zoumingjie124-ui/single-channel-acquisition/docs/STAGE8B_REPORT.md

# Stage 8B：诊断使能态 1 小时长跑记录（2026-11-04）

> 依据：`docs/STAGE8_PLAN.md` §4（HEAD `4d9179e`）
> 原始日志：`docs/SOAK_60MIN_20261104.txt`（本轮）、`docs/SOAK_60MIN_20261104_Y.txt`（Y 轮，见 §5.6），历史对照：`docs/SOAK_60MIN_20261103.txt`（2026-11-03 原件；**原文件名为 `SOAK_60MIN.txt`，2026-11-04 为腾出 `soak.py` 的固定输出名而改名**）
> 执行条件记录：`docs/STAGE8B_ENV.txt`

## 结论先行

**判据 H7 / H8 / H12 未通过，本轮按方案 §4.5 判定为 FAIL。**
设备侧计数器全为 0，丢失**只能从主机侧观测到**（设备无对应计数；归因见 §5，**未定论**）。
**不得记为"1 小时稳定通过"。**

## 1. 执行条件

| 项 | 值 |
|---|---|
| 端口 / 波特率 | COM5 / 115200 8N1（CH340） |
| 固件 | 正式版 `Code=22468`，`DIAG` 行含 `rep=`（7C-2 构建） |
| 诊断状态 | `SET_DIAG 1` → ACK OK → 3.03 s 后确认（`mask=0x01 value=10 mV`） |
| 输入 | PA1 电位器，静置 `raw ≈ 2 mV`，全程未触碰 |
| 电源 | 睡眠/休眠/USB 选择性暂停均已置 0（`STAGE8B_ENV.txt` §二） |
| 命令 | `python host/tools/soak.py 60 COM5`（参数为分钟） |
| 时长 | 11:24:12 → 12:24:12，实测 3600.0 s |
| 基线 | `uptime0=1071815 ms`、`conf0=1`、`state=2`、`mask=rep=1`、`span=8 mV` |

## 2. 原始结果（`SOAK_60MIN_20261104.txt` 合计段原文）

```
===== 合计（3600.0 秒）=====
收到字节      : 6278917  (1744.1 B/s)
SAMPLE 帧     : 360002  (100.00 Hz)
STAT 帧       : 3600  (1.00 Hz，设计 1.00 Hz)
EVENT 帧      : 0
drops         : 0
frame_err     : 0
adc_err       : 0
uart_err      : 0
rx_err        : 0
状态切换      : 0
设备运行时间  : 4679000 ms
seq8 缺口     : 45   (样本级)
整帧丢失      : 45   (帧级)
解析错误      : 30
BOOT 帧       : 0
链路中断次数  : 0
```

终点 `stat`（12:24:21.478，soak 退出后立即读取）：

```
STAT   t=4687953ms n=460642 drop=0 adc=0 uart=0 rxf=0 frm=0 chg=0 cmd=2/0 txd=0B
ERRSRC ore=0 fe=0 ne=0 pe=0 pto=0 rxrst=0/0
DIAG   en=1 state=2 conf=1 span=8 blk=30 unev=0 mask=1 rep=1
```

## 3. 判据判定（H1–H12）

| # | 判据 | 实测 | 门槛 | 判定 |
|---|---|---|---|---|
| H1 | SAMPLE 频率 | 100.0006 Hz | 100.00 ± 0.10 | PASS |
| H2 | STAT 频率 | 1.0000 Hz | 1.00 ± 0.05 | PASS |
| H3 | drops | 0 | = 0 | PASS |
| H4 | frame_err | 0 | = 0 | PASS |
| H5 | adc_err | 0 | = 0 | PASS |
| H6 | uart_err | 0 | = 0 | PASS |
| **H7** | **seq8 缺口** | **45** | **= 0** | **FAIL** |
| **H8** | **整帧丢失** | **45** | **= 0** | **FAIL** |
| H9 | BOOT 帧 | 0 | = 0 | PASS |
| H10 | 链路中断次数 | 0 | = 0 | PASS |
| H11 | 时基偏差（正式口径） | **0.0077 %** | < 0.1 % | PASS |
| **H12** | **解析错误** | **30** | **= 0** | **FAIL** |

**H11 计算（`STAGE8_PLAN` §4 / `SOAK_PLAN` 正式口径：uptime 对比墙钟）**

```
Δuptime = 4687953 − 1071815 = 3616138 ms
Δwall   = 12:24:21.478 − 11:24:05.619 = 3615859 ms
偏差    = |3616138 − 3615859| / 3615859 = 0.0077 %
```

交叉核对（用 soak 起点换算）：soak 在 11:24:12 启动，此时 uptime ≈ 1078210 ms；
最后一帧 STAT 记 `4679000 ms`，对应 3600 s 窗口 → 偏差 ≈ 790 ms = 0.022 %。
两种算法都远低于 0.1 %；读数分辨率为秒级，故 H11 的实际不确定度约 ±0.03 %，
**不影响结论**。**本轮 H11 采用 uptime 口径，不是帧率反推**（见静态审查 G1）。

## 4. 判据判定（B-1–B-5，终点诊断状态）

| # | 判据 | 基线 | 终点 | 判定 |
|---|---|---|---|---|
| B-1 | 终点 `en` | 1 | 1 | PASS |
| B-2 | `conf` 增量 | conf0=1 | 1 → 增量 **0** | PASS |
| B-3 | `mask` / `rep` | 1 / 1 | 1 / 1 | PASS |
| B-4 | `state` | 2 (ACTIVE) | 2 | PASS |
| B-5 | `span` | 8 mV | 8 mV（静置量级） | PASS |

> **B-3 的边界**：`mask=rep=1` 只证明"终点时设备状态与已提交状态一致"，
> **不能**推出"1 小时内每个诊断事件都被上位机收到"。本轮无 EVENT 帧、`conf` 未动，
> 说明期间**没有产生新的确认/恢复边沿**，这一点与 `span=8 mV` 一致。

## 5. 归因分析（H7/H8/H12）

### 5.1 设备侧证据：全部为零

| 计数器 | 值 | 含义 |
|---|---|---|
| `drops` | 0 | 采样环没溢出，一个采样点都没丢 |
| `adc_err` / `uart_err` / `rx_err` / `frame_err` | 0 / 0 / 0 / 0 | 设备端未记录任何错误 |
| `txd=` | **0 B** | **发送环从未满**，`app_tx_write` 一次都没丢字节 |
| `BOOT` | 0 | 中途没有复位 |
| 链路中断 | 0 | 串口没有断开重连 |

`txd=0` 只能证明**入队没丢**：`app_tx_write()` 没有因为环满而丢弃过任何一帧。
它**不能**证明"线上传输正确"——字节是否正确发出、是否完整到达主机，这一层固件没有任何计数可查。

### 5.2 观测事实：缺口与解析错误成对出现

- `seq8 缺口 = 45` 与 `整帧丢失 = 45` **必然相等**：两者是同一批丢失帧的两种算法
  （样本级 / 帧级），不是两条独立证据。它们的相等只能说明**丢失的全部是 SAMPLE 帧，
  没有 STAT 帧丢失**，不能反推"丢的是整帧而非帧内错位"。
- `解析错误 = 30`：解析器遇到过**无法完成的帧**并重新同步。日志只能说明
  "**字节流被破坏**"，**无法区分**是丢了字节、还是字节被改坏，
  **也无法定位**发生在设备引脚、USB 链路还是主机驱动。
- 时间分布：59 个打点中 **28 个**带缺口，且**全部落在 240–2460 s** 这一段内
  （窗口内 38 个打点里 28 个有缺口；窗口外 21 个打点全为 0）。窗口内每次增量只有
  **1 / 2 / 3 帧**，没有出现更大的成块丢失。28 个"缺口有增量"的打点与 28 个
  "解析错有增量"的打点在时刻上重合——**这与"该处发生了字节级破坏"一致**，
  但**破坏发生在哪一段、以何种方式发生仍未确定**（设备引脚 / USB 链路 / 主机驱动都不能排除）。详见 §5.3。

### 5.3 缺口的时间分布（复盘后新增，修正了初版归因）

统计每个 60 s 打点窗口内的增量（原始表见 `SOAK_60MIN_20261104.txt`）：

打点是**累计值**：`[ 240s]` 那一行报的是 `(180, 240]` 这一分钟内的增量，
`[2460s]` 那一行报的是 `(2400, 2460]`。因此"有增量的打点"只能把事件定位到**一分钟区间**，
不能定位到某一秒。

| 区间 | 打点 | 现象 |
|---|---|---|
| 0 – 180 s（11:24:12–11:27:12） | 60 / 120 / 180，共 3 个 | **完全干净**（0 缺口 / 0 解析错） |
| **起点在 11:27:12–11:28:12 之间，终点在 12:04:12–12:05:12 之间**<br>（对应打点 240 … 2460，覆盖 180–2460 s） | 共 38 个 | 其中 **28 个有缺口**；每次 1–3 帧；累计 45 帧 / 30 次解析错 |
| 2460 s 之后（12:05:12–12:24:12） | **2520 … 3540，共 18 个**；3540–3600 s **无打点**，只有合计段 | **重新完全干净**（0 缺口 / 0 解析错） |

也就是说：不是"全程均匀丢一点"，而是**一段有界窗口**——首个有增量的打点是 240 s
（事件落在 180–240 s 之间），末个是 2460 s（事件落在 2400–2460 s 之间），
故窗口长度在 **36–38 分钟**之间；打点粒度 60 s，**无法再精确**。两端都是干净的。

末段"无打点"这一点有独立佐证：**3540 s 那条打点的累计值（45 / 45 / 30）与合计段完全相同**，
说明 `(3540, 3600]` 这最后一分钟没有新增缺口或解析错误——不是"没记"，是"确实没发生"。

### 5.4 归因（初版结论已作废）

**初版写的"测试期间本机并发执行大量文件读取导致"不成立。**

依据（会话记录，非系统级）：本次静态审查的**第一次文件读取发生在 12:10:08**；
在此之前，本会话最近一次工具调用是 **11:24:26**（即开跑后 14 秒内的日志核验与记录写入）。
也就是说 **11:24:26 → 12:10:08 之间有 45 分 42 秒本会话零调用**，
而丢失窗口（11:27:12–12:05:12）完整落在这段静默期内。

**这条证据的边界**：它只能证明**本会话**在那段时间没有发起读写，
**不能**代表整台机器空闲——系统更新、杀毒扫描、其它程序、以及人工操作都不在记录范围内。
因此准确表述是：**"本会话在丢失窗口内没有活动"，而不是"主机在丢失窗口内空闲"**。

排查过的系统侧证据（均不支持"主机 CPU 被抢占"）：

| 检查 | 结果 |
|---|---|
| System 日志（11:20–12:30）的 USB / 串口 / PnP / 磁盘错误与警告 | **无任何记录** |
| Defender 扫描 | 上一次快速扫描是 11-03 19:25，**不在窗口内** |
| 任务计划日志 | 未启用，读不到 |

剩下的候选：

| 候选 | 支持 | 反对 |
|---|---|---|
| A. 主机 USB 接收缓冲偶发溢出（进程被短暂挂起 / 端口被 hub 节电） | 缺口与解析错误成对出现；设备侧 `txd=0`、`drops=0` | 未找到对应的系统事件；且"开始/结束"都太干脆 |
| B. 设备侧待发缓冲被覆盖 / 越界（非"供数不及"） | 若 `s_stage` 或环内内容被错误改写，主机侧会收到破坏的字节流 | **`uart_err=0` 只覆盖 RX，排除不了发送侧**；但固件没有 TX 侧完整性计数。<br>**注意：串口"发送慢"只会拉长字节间隔，不会改坏字节**，所以"供数不及导致移位错误"这个机制不成立，已从候选中删除。<br>另外，缓冲被覆盖通常与负载/时序相关，与"有界窗口"**不太像，但不能排除**——若冲突是否发生取决于时钟相位对齐，理论上也可能出现有界窗口（**推演，未验证**） |
| C. 物理层（USB 线 / hub / 接触） | 窗口有界，符合"某个外部扰动持续一段时间后消失"；本机 CH340 的端口路径为 `LOCATION=1-2.1.3`，**说明接在 hub 之后**（经一级以上的 hub 级联），hub 供电/线材/接触都可能引入这类有界扰动 | 无直接证据；System 日志没有对应的 USB 告警 |

**结论：只能确定丢在"设备发送环之后、上位机解析器之前"，具体归属未定论。**
本轮**不记为通过**，也不把任何候选写成既成事实。

### 5.5 11-03 通过 vs 11-04 未通过：差异清单

两次都是 3600 s，且**同一块开发板（据记录）**；但 **USB-TTL 是否同一根线、是否插在同一个物理口，
未记录**——11-03 那次连端口路径都没采集。下表只写**能从现有记录确认**的事实，
查不到的一律写"未记录"，**不做推断**。

| 项目 | 11-03（通过） | 11-04（未通过） |
|---|---|---|
| 固件构建 | `Code=21208`（`TEST_REPORT` §17）；**尚无 `app_diag` / `app_fault`**（`app_diag.c` 于 11-03 18:33 的 `6112267` 才引入） | `Code=22468`，含 Stage 7B/7C/7C-2 |
| 提交 / 工作区 | 起点 `c4029e7`（11-03 09:42）；运行中 12:41 提交 `2abe5d6`，只动 `docs/` 与 `host/tools/`，**固件未变** | 起点 `4d9179e`；全程无提交，工作区仅两份文档后续被修改 |
| DIAG 是否使能 | **不可能使能**（功能不存在）；全程无诊断 | `SET_DIAG 1` → `en=1`、`conf0=1`、`state=2`、`mask=rep=1` |
| 电源设置 | 睡眠 / 休眠 = 从不、USB 选择性暂停 = 禁用（按 §9.1 设置，`TEST_REPORT` §17.3） | 同左（按 §9.1 设置，原值与现值记在 `STAGE8B_ENV.txt`，收尾已按 §9.2 还原） |
| USB 路径（LOCATION）与端口 | 端口 **COM6**；`LOCATION` **未记录**（当时没有采集此信息） | 端口 **COM5**；`LOCATION=1-2.1.3`（**经 hub 级联**） |
| 主机并发活动 | **有**：运行到第 35 分钟（12:41）产生提交 `2abe5d6`，新增 3 个文件共 512 行（`CALIB_ABSOLUTE.md` / `soak_finish.py` / `SOAK_60MIN.txt`，末者为当时的文件名）。其中 `SOAK_60MIN.txt` 是**当时正在写的日志**，提交里只有到 **2100 s** 的 36 行快照；完整版由 13:07 的 `537ce93` 提交。未做系统级记录 | **未逐条记录**：期间有静态审查的连续文件读取（时刻未记录）；无编译、无烧录、无第二个串口程序 |
| 起止时间（墙钟） | 2026-11-03 12:06:12 – 13:06:12（日志头写 `12:06:13`，与报告差 1 s） | 2026-11-04 11:24:12 – 12:24:12 |

两点必须说清：

1. **11-03 也不是"主机完全空闲"**。它有写盘和一次 git 提交，却零缺口；
   所以"有主机活动就必然丢帧"这个简化说法不成立——两次的**活动形态与量级不同**，
   但没有量化记录，无法比较。
2. **两次的固件构建不同**（Code 差 1260 B：22468 − 21208，多了诊断与故障上报模块），因此
   不能把差异直接归给"链路/主机"，也**不能**排除固件侧新增代码的影响
   （虽然 `txd=0` 说明发送环没满，但发送侧完整性仍无计数）。

> **本节的结论已被 §5.6 修正方向**：补做 Y 轮（诊断关）后，同样出现丢帧。
> 因此"诊断是否开启"不再是可用的解释变量；但**新旧固件整体差异仍未分开**，
> 详见 §5.6 的限定条件。

### 5.6 Y 轮（诊断关）对照结果 —— 2026-11-04 16:14:12–17:14:12

原始日志 `docs/SOAK_60MIN_20261104_Y.txt`；执行条件与基线原文见 `docs/STAGE8B_ENV.txt` §九。

| 项 | 值 |
|---|---|
| 固件 | `Code=22468`（与 §1 同一次构建，未重烧） |
| 端口 / LOCATION | **COM4 / `LOCATION=1-2.2`** —— 与 11-04 那轮的 `1-2.1.3` **不是同一个口**；但**仍未换直连口**（本机可用路径都经过同一颗 `05E3:0610` hub，见 `STAGE8B_ENV.txt` §八） |
| 诊断 | `en=0`（全程关闭），终点 `state=0 / conf=0 / mask=0 / rep=0` |
| 电源 | 睡眠 / 休眠 / USB 选择性暂停全部 0（按 §9.1 设置，查询核验） |
| `uptime0` → `uptime_end` | 343686 ms → 3954833 ms |

| 判据 | 实测 | 判定 |
|---|---|---|
| H1 SAMPLE 频率 | 360033 帧 / 3600.0 s = **100.0092 Hz** | PASS |
| H2 STAT 频率 | 3600 = 1.0000 Hz | PASS |
| H3–H6 drops / frame_err / adc_err / uart_err | 0 / 0 / 0 / 0 | PASS |
| **H7 seq8 缺口** | **17** | **FAIL** |
| **H8 整帧丢失** | **18** | **FAIL** |
| H9 BOOT / H10 链路中断 | 0 / 0 | PASS |
| H11 时基 | Δuptime 3611147 ms vs Δwall 3610633 ms = **0.0142%** | PASS |
| **H12 解析错误** | **11** | **FAIL** |
| 诊断终点 | `en=0 / mask=0 / conf=0 / rep=0` | PASS |

丢失只出现在 **10 个打点**上，且全部落在两段一分钟区间之间：
起点在 **(480, 540] 秒**这一分钟内（480 s 那条累计仍为 0，540 s 才 +2），
终点在 **(1620, 1680] 秒**这一分钟内；此后到 3540 s 完全干净。
每次丢 **1–3 个样本**；解析错误的增量**多数为 1，`600 s` 那一条为 2**（10 个打点里 9 个为 1、1 个为 2）。
形态与 11-04 那轮一致（有界窗口 + 整帧粒度）。

**这轮能得出的结论：**

> 诊断开启**不是**丢帧的必要条件——`en=0` 时同样丢帧。

**不能得出的结论（限定条件）：**

1. `en=0` 只关闭了检测与上报，**诊断代码仍在固件里**（`app_diag` / `app_fault` 都还在 Flash 与主循环路径上），所以这不是"诊断代码无关"的证明；
2. 本轮固件是 `Code=22468`，11-03 那次通过的是 `Code=21208`，**两者是整体不同的构建**；
   "当前固件比旧固件多出的所有代码"与"链路/主机"这两个因素**没有被分开**；
3. 两轮的 LOCATION **不同**（11-04 那轮 `1-2.1.3`，Y 轮 `1-2.2`），但**都经过 hub**；
   第一轮的 hub 层数**没有单独核对**，所以"两轮链路完全相同"这句话不成立；
4. 因此**不能**把它写成"固件诊断/故障上报已被排除"。

**可安全表述的范围**：`SET_DIAG 1` 与 `SET_DIAG 0` 两种配置下都观察到同形态的有界丢帧，
所以"是否使能诊断"不能作为解释变量；丢帧与诊断功能之间**没有观察到必然联系**，
但也没有被证明无关。

### 5.7 后续复测（Y2 / X2）—— 独立测试，不覆盖 §1–§5 的失败记录

§1–§5 记录的是 **2026-11-04 11:24 那一轮（诊断开，FAIL）**，该记录**原样保留**：
丢帧原因至今**未定论**（主机缓冲 / 链路 / 物理层三者并列，见 §5.4）。

在其后补做了两轮**独立测试**，用于回答"换一条已知良好的连接后，同固件是否还能丢帧"：

| 轮次 | 时间 | 诊断 | 端口 / LOCATION | 结果 | 原始日志 |
|---|---|---|---|---|---|
| Y（§5.6） | 16:14–17:14 | 关 `en=0` | COM4 / `1-2.2` | **FAIL**：缺口 17 / 整帧 18 / 解析 11 | `SOAK_60MIN_20261104_Y.txt` |
| **Y2** | 18:14–19:14 | 关 `en=0` | COM5 / `1-2.1.3` | **PASS**：H1–H12 全部 PASS，所有错误与丢失类计数均为 0 | `SOAK_60MIN_20261104_Y2.txt` |
| **X2** | 19:23–20:23 | 开 `en=1` | COM5 / `1-2.1.3` | **PASS**：H1–H12 全部 PASS，所有错误与丢失类计数均为 0；`conf` 1→1 | `SOAK_60MIN_20261104_X2.txt` |

必须同时说明三点：

1. **它们不能推翻 §1–§5**：11:24 那轮确实丢了 45 帧，失败事实与"原因未定论"都保留。
2. **Y2/X2 的通过只覆盖 1 小时尺度**，不等于 8 小时，也不等于"链路问题已解决"；
   二者与 Y 的差别包含端口、线材与串口模块的更换史，**没有被单独隔离**，
   因此不能据此断言"是换线治好了"。
3. Y2/X2 的判据来源不同：H1–H10、H12 来自 SOAK 合计段与打点；
   **H11 来自两次独立 STAT 的 uptime 与墙钟**（Y2：0.0142%；X2：0.0142%，区间 3692 s）。
4. **端口不是区分因素**：11:24 失败轮与 Y2、X2、8 小时通过轮**同在 `COM5` / `LOCATION=1-2.1.3`**
   （`STAGE8B_ENV.txt` §一 / §十四 / §十五、`docs/SOAK_480MIN_RECORD.md` §0）。
   同一条端口路径既出现过 FAIL 也出现过 PASS，因此 **LOCATION 不能解释两组的差异**。
   （Y 轮失败发生在 `1-2.2`，是另一条路径，不能用来反证"换口就好"。）
   失败轮与通过轮之间真正的差别——**串口模块更换史、线材、接线纠正**——**逐项未记录**，
   本条仍按"**未隔离**"处理：既不能断言"换线治好了"，也不能断言"某个模块有问题"。

---

## 6. 未覆盖与不能声称的事项

1. 本轮**未通过**，不能用于证明"诊断使能态 1 小时稳定"。
2. 未做 8 小时（方案要求 1 小时通过后才做）——**此条只约束本节记录的 11:24 轮**；
   诊断关的 8 小时长跑见 **§8**（2026-11-04 23:28 – 11-05 07:28 完成）；诊断开的 8 小时长跑见 **§9**（2026-11-05 23:10 – 11-06 07:10 完成）。**8 h 的两种配置均已做过，本条不再成立。**
3. 不涉及真实传感器（R19）、TX 环满载（R15/8A）、真实 HAL 重挂失败（R1）、多故障快照（R17）。
4. 归因未定论；要分离 A/B 需要额外手段（第二观察者、设备侧 TX 帧计数、示波器看 TX 线），**本轮均未做**。
5. `STUCK_DELTA_MV=50 mV` 仍是待确定值。

## 7. 复现所需

```bat
:: 1) 关闭睡眠（SOAK_PLAN §9.1），确认 powercfg 读数为 0
:: 2) 使能诊断，等确认，记录 conf0 / uptime0
python host/tools/soak.py 60 <端口>
:: 3) 结束后立即 stat，记录 uptime_end / DIAG
```

**建议复跑时不要在主机上并发执行其它重任务**，以排除候选 A。

---

## 8. Stage 8B-2：诊断关闭（en=0）480 min 长跑（2026-11-04 23:28 – 11-05 07:28）

**结论：Stage 8B-2 诊断关闭（en=0）480 min 板级稳定性验证通过，H1–H12 全部 PASS。**

### 8.1 条件

| 项 | 值 |
|---|---|
| 固件 | `Code=22468`（2026-11-03 23:14 烧录 Verify OK，此后未重烧） |
| 诊断 | **en=0**，起点与终点一致 |
| 链路 | COM5 / CH340 / VID:PID=1A86:7523 / **LOCATION=1-2.1.3** |
| 时长 | 480 min（实测 28800.0 s） |
| 起点基线 | `reset` 清零后 `frm=0 fe=0 uart=0 cmd=0/0`，`uptime0=166805 ms @ 23:26:07.236`，`conf0=0` |

### 8.2 结果

```
收到字节 50229097 (1744.1 B/s)   SAMPLE 2880109 (100.00 Hz)   STAT 28801 (1.00 Hz)
EVENT 0   drops 0  frame_err 0  adc_err 0  uart_err 0  rx_err 0  状态切换 0
seq8 缺口 0   整帧丢失 0   解析错误 0   BOOT 0   链路中断 0   设备运行时间 29101000 ms
```

| 编号 | 实测 | 判定 |
|---|---|---|
| H1 | 100.0038 Hz（2880109 / 标称 28800.0 s） | PASS |
| H2 | 1.0000 Hz | PASS |
| H3–H10、H12 | 全 0 | PASS |
| H11 | 0.0039 %（< 0.1 %） | PASS |

- **打点 479 条**（60 s – 28740 s）。479 而非 480 是 `soak.py` 的循环逻辑所致（`elapsed >= total`
  时先退出、不写第 480 点），**符合脚本实际行为，不是数据缺失**。
- **无 BOOT、无链路中断、无可分辨序号缺口、无统计错误**。
- **H1 的口径与"真实物理时长"**：H1 仍按 `SAMPLE / 标称 28800.0 s = 100.0038 Hz` 判定（PASS）。
  但 `soak.py` 的 `dur` 取自墙钟（§8.3.2），被 **+2.95 s** 的时钟前跳拉长；
  按**真实物理时长 28,797.05 s**（= 28800.0 − 2.95）折算为 `2880109 / 28797.05 = ` **100.0140 Hz**，
  与 §8.3 的 **140 ppm** 斜率一致（`100 × 1.00014 = 100.0140`）。
  即 **100.0038 Hz 是被 +2.95 s 前跳压低的表观值**；跨轮次比较 H1 时同样要注意，
  1 小时轮（≈100.014）更接近该构建的真实采样速率。
- **H11 口径**：`Δuptime = 28963363 ms`、`Δwall = 28962243 ms`、差 `+1120 ms`、偏差 `0.0039 %`。
  终点 `uptime` 取自 1 Hz STAT，存在约 **±1 s 量化误差**（≈±0.0035%）。
  **对 `0.0039 %` 的分解（原"原因未查（主机校时、温度）"已撤回）**：对累计 SAMPLE 做分段偏移拟合，
  **7260 s 台阶前后斜率均约 140 ppm**，台阶约 **−295 个样本（≈2.95 s）**；
  `140.5 ppm（拟合值）× 28962 s ≈ 4.07 s`，减去台阶 ≈ **1.12 s**，与实测 `+1120 ms` 吻合。
  取整说明：按 **140 ppm** 取整算得 `4.05 s`（差 0.02 s），差别**仅来自 ppm 取整**，
  与"×28962 s"还是"×8.045 h"无关（两者相差 0.24 s，折算 <0.001 s）；本节统一取 **4.07 s**（与 1.12 s 直接对应）。
  即 **H11 的 0.0039 % 是"140 ppm 真实速率差"与"一次 −2.95 s 台阶"的叠加**；
  **1 小时 Y / Y2 / X2 三轮的 0.0142 % 才是 140 ppm 的直接体现**。
  因此 **H11 不得跨轮次比较**：本轮的 0.0039 % 比 1 小时轮"更好看"，但那是台阶抵消的结果，不是时基更准。
- **序号检测边界**：在当前 8 位序号检测能力范围内，未检出可分辨的序号缺口（`frame_gap` 与 `seq8_gap` 均受同一限制）。
  单次连续丢失恰为 **256 的整数倍**帧时不可见；"未检出"≠"绝对零丢失"。打点 ΔSAMPLE 的实测分布见 **§8.3**。
- **对账已闭合（按 reset 后基线折算）**：
  基线 `n_base = 388`（2026-11-04 23:26:07.236，reset 后首次 STAT）、
  终点 `n_end = 2896724`（2026-11-05 07:28:49.479），`n_end − n_base = 2896336`；
  soak 期间 `SAMPLE = 2880109`，两端空档 133.764 s + 28.479 s = 162.243 s ≈ **16224** 个样本，
  `2880109 + 16224 = 2896333`；**残差 +3 个样本（≈30 ms）**，落在起跑时刻的**秒级分辨率**
  （日志头只到秒，±1 s ≈ ±100 个样本）之内，判定为对账成立。
  说明：早前一版用"约 162 s × 100 Hz"粗算得残差 391（≈3.9 s），是因为**漏减了 reset 后的基线 `n_base`**；计入基线后残差降为 3 个样本。
  另：日志「设备运行时间 **29101000 ms**」− 墙钟 **28800000 ms** = **301000 ms（301 s）**，
  这是**开机到起跑的先行运行时间**（boot ≈ 23:23:20 → 起跑 23:28:21），**不是漂移**，也不参与上面的样本对账。

### 8.3 打点 ΔSAMPLE 分布与一次计数台阶

479 条打点 → **478 个区间**：

| 区间 ΔSAMPLE | 次数 | 说明 |
|---|---|---|
| 6000 | 89 | 标称 |
| 6001 | 373 | 打点与帧流边界错位 |
| 6002 | 15 | 同上 |
| **5705** | **1** | 仅 7200 s → 7260 s 这一段 |

- 最小值 **5705**、最大值 **6002**、均值 **6000.23**；**477/478 落在 6000–6002**。
- 唯一偏低区间 `[7260s]`：**ΔSAMPLE = 5705**（比 6000 少 **295**、比 6001 少 **296**）、**ΔSTAT = 57**（少 3）；
  该分钟的 `drops / frame_err / seq8 缺口 / 整帧丢失 / 解析错` **全部为 0**。
- **不能写成链路丢帧**：若真丢 296 帧，8 位序号缺口应为 `296 mod 256 = ` **40**，实测为 **0**；
  整帧丢失同样为 0。因此这是一次**计数台阶**，不是通信丢帧。
- 分段偏移拟合：前段 **100.014031 样本/s（140.3 ppm）**、后段 **100.014084 样本/s（140.8 ppm）**，
  两段斜率一致；把两条直线外推到 7260 s 处，相差 **−295.5 个样本 ≈ −2.95 s**。
- **结论：观察到一次计数台阶（≈ −2.95 s），判定为「主机侧时钟前跳（NTP 校时）」**，依据四项：
  ① **事件日志**：`2026-11-05 01:28:27` 系统时间被 `svchost.exe (PID 30672)` 前跳 **+2950 ms**（§8.3.1）；
  ② **时间对齐**：该事件对应 elapsed ≈ **7206 s**，正落在 `7200 → 7260 s` 区间内；
  ③ **H11 推演**：若为"设备停顿而 uptime 照走"，残差应约 4.07 s，实测仅 1.12 s（推演，未验证）；
  ④ **计时基准**：`soak.py` 全部用**墙钟** `time.time()`（L65 起点、L76 打点判定、L164 合计时长，见 §8.3.2）——
  墙钟前跳 2.95 s 会让该分钟打点**提前约 2.95 s 触发**（故 ΔSTAT=57、ΔSAMPLE=5705），
  同时把合计段的 `dur` 拉长 2.95 s。
  **这不等于"已证实"**：因日志未保存逐帧 STAT 的 `t_ms` 原文，无法直接从帧流核对该分钟的设备侧时长，
  故维持四项证据的合取推断。
  另：**「台阶前后 STAT 运行时间是否连续」无法检查**（原始帧未保存，见本节末），该项保持 **OPEN**。
- 区间内 `5705` 相对 `57 s × 100 Hz = 5700` 的 **+5**，属**打点边界量化**（一个 60 s 区间只含整帧边界，
  ±1 个帧位即可造成数个样本的偏差），**不用来解释漂移**。
- 总账：8 小时按 140 ppm 漂移应得 **+403** 个样本，减去台阶 **−295**，得 **+108**；
  实测累计 `2874109 − 2874000 = +109`，差 1 个样本，落在打点边界量化范围内。
- 可检验判据：若发生 **256 帧的整倍丢失**，某一分钟的 ΔSAMPLE 会比该分钟应有值低约 256 的整倍
  （标准 60 s 区间会呈现 ≈**5744**）。本轮唯一偏低区间是台阶而非丢帧（依据见上），
  **未见无法解释的 256 整数倍缺口**。
- **盲区仍然存在**：若恰好在某个完整 60 s 区间内丢失 256 帧，Δt 与 ΔSTAT 都不变、8 位序号也不留痕，
  **无法识别**。因此 §8.2 的"未检出"表述保持不放宽。

#### 8.3.1 事件日志核查（2026-11-05 01:20–01:40，Windows System 日志）

| 时间 | 来源 / ID | 内容（原文摘要） |
|---|---|---|
| 01:28:09 | Time-Service **37** | "时间提供程序 NtpClient 正在从 time.windows.com,0x9 接收有效时间" |
| 01:28:27 | Time-Service **35** | "时间服务正在使用时间源 time.windows.com" |
| 01:28:27 | Kernel-General **1** ×3 | 其中一条：系统时间由 `2026-11-04T17:28:24.386Z` 更改为 `17:28:27.337Z`，**增量 +2950 ms**，原因"An application or system component changed the time"，进程 `svchost.exe (PID 30672)`；另两条增量 **0 ms** |
| 01:28:27 | Kernel-General **24** ×3 | 已刷新时区信息，当前时区偏差 **−480** |

- **电源/休眠**：该时段**没有** `Kernel-Power 42/107`（睡眠/唤醒）事件；整夜 Kernel-Power 仅有若干条 566，
  时间点均不在 01:28 → **本轮未发生睡眠/唤醒**。
- **时间对齐**：soak 起跑 `23:28:21` ＋ 7206 s ≈ **01:28:27**，正好落在 `7200 → 7260 s` 那个打点区间内；
  事件记录的 **+2950 ms** 与拟合台阶 **≈2.95 s** 数值一致。
- **侧别判定**：结合本节事件日志、时间对齐、H11 推演与 §8.3.2 的墙钟计时基准，判为
  **主机侧时钟前跳（NTP 校时）**（见 §8.3 结论条目）。措辞上**不写"已证实"**：
  因日志未保存逐帧 STAT 的 `t_ms` 原文，无法直接从帧流核对该分钟的设备侧时长，
  故维持四项证据的合取推断。
- **推演（未验证）**：若为"设备停顿约 2.95 s、而设备 uptime 照走"，则台阶不进入 uptime，
  H11 应约为 `140.5 ppm × 8.045 h ≈ 4.07 s`（口径与取整说明见 §8.2）；实测仅 **1.12 s**，故该情形**基本被排除**。
  反之，主机时钟前跳 2.95 s 会把 `Δwall` 拉长 2.95 s，使残差从 4.07 s 降到约 1.12 s，与实测一致。
- **无法检查的部分**：原始二进制帧未保存，日志只有 60 s 打点与合计段，无法还原 STAT 的 `t=` 序列，
  因此"**台阶前后 STAT 运行时间是否连续**"**无法判定**（**OPEN**）——这一点不因侧别判定而改变。

#### 8.3.2 `soak.py` 的计时基准（代码核对）

`host/tools/soak.py` 共 195 行，SHA-256 `26771dd161ea34224a9133f3ca717bdbf2ff0ba8596fcb4c6e19aaa4af58c9ab`。
**全文计时只用墙钟 `time.time()`，没有 `time.monotonic()`，也没有 `time.perf_counter()`**：

| 行号 | 代码 | 作用 |
|---|---|---|
| **L65** | `t0 = time.time()` | 计时起点 |
| **L76** | `elapsed = time.time() - t0` | 判定 60 s 打点、判定是否到 480 min |
| L101 / L102 / L109 | `deadline = time.time() + 30.0` 等 | 重连等待与重连时刻记录 |
| **L164** | `dur = time.time() - t0` | 合计段 `duration`，也是 H1/H2 的分母 |

**机理**：墙钟被前跳 2.95 s 时，`elapsed` 立刻多出 2.95 s → 下一次 `elapsed >= next_mark`
**提前 2.95 s 成立**，于是该分钟在设备时间上只走了约 57 s（ΔSTAT=57、ΔSAMPLE=5705）；
终点 `dur` 同样多算 2.95 s，这正是 H11 残差被抵消 2.95 s 的来源。

### 8.4 证据等级与边界

- **板级实测、统计级证据**；不是字节级全量验证（原始二进制帧流未落盘，无法逐帧复算）。
- 覆盖：1 条链路、1 台主机、1 个构建、**诊断关闭**、8 小时尺度。
- **Stage 8B-3（诊断开启 en=1 的 8 h）已完成并通过，见 §9**；**R2 绝对精度仍未测**；
  **不得写成"项目全部 8 小时稳定性验证通过"**。
- **已知限制（计时基准）**：`soak.py` 用**墙钟**计时（§8.3.2），长跑中一旦遇到 NTP 校时，
  就会在打点里留下**计数台阶**。本轮实际观察到一次（**+2950 ms**，§8.3.1），已按"台阶"处理，
  **未改脚本**。建议：长跑前**关闭 Windows 自动校时**，或跑完后用
  `Get-WinEvent` 对照 `Time-Service` / `Kernel-General` 事件日志再解读打点。
- 归档：`docs/SOAK_480MIN_20261104_N.txt`，77,875 B，
  SHA-256 `6e64b28120f59d46957eb286d737d70d0114cea6c0012898a3c9687ddb3de989`；
  记录表 `docs/SOAK_480MIN_RECORD.md`；起点与 reset 前后计数见 `docs/STAGE8B2_START.txt`。

## 9. Stage 8B-3：诊断开启（en=1）480 min 长跑（2026-11-05 23:10:56 – 11-06 07:10:56）

> 目的：补上 R3 / R20 里"诊断开启态 8 小时"的缺口。**结果：H1–H12 全 PASS。**
> 详表：`docs/SOAK_480MIN_RECORD_8B3.md`；原始日志 `docs/SOAK_480MIN_20261105_X.txt`。

### 9.1 条件

| 项 | 值 |
|---|---|
| 固件 | `Code=22468`（与 8B-2 / Y2 / X2 同一构建，未重烧） |
| 诊断 | **`en=1`**；23:08:38 `diag on` 恢复，23:10:36 `reset` 未改变 `en` |
| 链路 | COM5 / `1-2.1.3`（与 8B-2 同一条物理路径；两轮之间还有不同夜晚、一次 USB 重插、本轮起跑前的 `reset`，**主要差异是诊断开关，但不是严格的单变量对照**） |
| 主机 | `Type=NoSync`、`w32time` Stopped/Disabled、睡眠/休眠 0/0、AC 供电 |
| 输入 | 电位器静置未动（`mask=1 rep=1`，卡死态，`span` 8–11 mV） |
| T0 | 2026-11-05 23:10:46.618，`t=200795 ms`，`n=1000`，错误计数全 0，`conf=0` |
| 起跑 / 结束 | 23:10:56 / 07:10:56，`soak.py` exit 0，479 条打点 |

**起跑前板子重启过（T0 之前，不计入本轮）**：USB 物理插拔上电（设备节点 `LastArrivalDate=23:07:34`，
两次 uptime 反推 boot 均 23:07:25.8），导致 `en` 复位为 0、上电瞬间 `uart=2/fe=2/cmd err=16`；
已 `diag on` 恢复；按 `STAGE8B3_START.txt` **§9.1（重启来源与排除项）**判定该重启与本轮无关后，`reset` 重跑。

> 注：本节引用的是 `STAGE8B3_START.txt` §9.1，**不是**本文件 §8.3（§8.3 讲的是 NTP 台阶，与此无关）。

### 9.2 结果

```
===== 合计（28800.0 秒）=====
收到字节 50234327 (1744.2 B/s) | SAMPLE 2880407 (100.01 Hz) | STAT 28804 (1.00 Hz)
drops 0 | frame_err 0 | adc_err 0 | uart_err 0 | rx_err 0 | 状态切换 0
seq8 缺口 0 | 整帧丢失 0 | 解析错误 0 | BOOT 0 | 链路中断 0
设备运行时间 29014000 ms
```

| 编号 | 实测 | 判定 |
|---|---|---|
| H1 | 2,880,407 / 28,800.0 = **100.0141 Hz** | PASS |
| H2 | 28,804 / 28,800 = **1.00014 Hz** | PASS |
| H3–H6 | drops / frame_err / adc_err / uart_err **差值全 0**（基线也全 0） | PASS |
| H7 / H8 | seq8 缺口 0 / 整帧丢失 0（8 位可分辨范围内） | PASS（限"未检出"） |
| H9 / H10 | BOOT 0 / 链路中断 0 | PASS |
| H11 | **0.0141 %**（Δuptime 28,833,632 ms，Δwall 28,829,555 ms，差 +4077 ms） | PASS |
| H12 | 解析错误 0 | PASS |

统一措辞：**在当前 8 位序号检测能力范围内，未检出可分辨的序号缺口（`frame_gap` 与 `seq8_gap` 均受同一限制）**；
单次恰为 256 整数倍的缺口不可见，"未检出"≠"绝对零丢失"。

### 9.3 H11 与 8B-2 的差异（本轮最重要的解释）

- 8B-2（`en=0`）报 **0.0039 %**，本轮（`en=1`）报 **0.0141 %**，相差约 100 ppm。
- 原因不是设备变差：8B-2 窗口内有一次主机 **NTP +2950 ms** 前跳，把 `Δwall` 拉长 2.95 s，
  `4.07 s − 2.95 s ≈ 1.12 s`；本轮 `NoSync` 且事件日志无阶跃，测到的 **141 ppm 才是真实量级**，
  与 8B-2 分段拟合的 140 ppm 完全吻合。
- 结论：**H11 只能逐轮对照"是否 < 0.1 %"，不得跨轮次比较绝对值**；8B-2 的 0.0039 % 是表观值。

### 9.4 打点与事件核查

- 478 个区间：ΔSAMPLE = 6000×88 / 6001×374 / 6002×16（**max 偏差 2，无台阶**）；
  ΔSTAT = 60×474 / 61×4。
- **更正（2026-11-06）**：上一句原把「累计 +407」错标成 ΔSTAT。正确拆法——
  **ΔSAMPLE 合计 2,868,406**，比 478×6000 多 **+406**（=374×1+16×2）；
  **ΔSTAT 合计 28,684**，比 478×60 多 **+4**（≈4 s，来自 4 个 61 的区间）。
  末值 2,874,407 相对标称 2,874,000 的 **+407** = 406 + 首个 60 s 区间多出的 1 帧，与 141 ppm 一致。
- `Time-Service`(35/37)、`Kernel-General`(1)：**窗口内零命中**；`Kernel-Power` 42/107 零命中
  （仅 566 会话切换 ×3）→ 无时钟阶跃、无睡眠唤醒，**"无台阶"不是被时钟掩盖的结果**。

### 9.5 `conf` 的口径（容易误读，必须写清）

`reset`（23:10:36）把 `conf` 清零，而当时模块**已经处于 ACTIVE**；此后 8 小时输入一直卡死，
没有发生 CLEAR→CONFIRM，所以 `conf` 全程为 **0**（增量 0）。

**要特别记一笔：起跑时（§9.1 / 当天晚间的记录）按"`conf` 会 0→1"预期写过，那句预期是错的。**

**源码依据（已逐行核对，不是推断）**：

| 事实 | 出处 |
|---|---|
| `conf` = `confirm_cnt`，语义"进入 ACTIVE 的次数" | `App/Inc/app_diag.h:53`（字段注释） |
| `confirm_cnt` **只**在 `CLEAR / CONFIRMING` 分支、且 `stuck_blocks` 达到阈值时 `++` | `App/Src/app_diag.c:114–122`，自增语句在 **L120** |
| 已处于 `ACTIVE` 时再来偏死块，**只做"取消恢复"、不重新确认**（故不累加） | `App/Src/app_diag.c:129–134`，注释原文"已确认过的状态：偏死块只是'取消恢复'，不需要再确认" |

所以本轮 `reset` 把 `conf` 清零时模块已是 ACTIVE，之后 8 h 输入一直卡死、从未回到 CLEAR，
**`conf` 必然全程 0**——这与"没有误报"是同一件事，不是漏计。X2 是 `conf 1→1`（增量 0）。
**两者结论相同（无异常增量），但绝对值不可混用**——引用 R20 时必须注明本轮 `conf=0` 的成因。

**`blk` 的含义（已查源码，非未解读）**：`blk` 取的是 `app_diag_block_samples()`，
即**当前尚未结算的 1 s 统计块里已计入的样本数**（100 Hz ⇒ 取值 0–100），块结算后清零。

| 事实 | 出处 |
|---|---|
| DIAG 文本行 `blk=%u` 实参为 `app_diag_block_samples(&s_ctx.diag)` | `App/Src/app_task.c:338`（格式串）、**L343**（实参） |
| `blk_samples` = "本块已计入的样本数（用于判断块是否可评估）" | `App/Inc/app_diag.h:44` |
| 块结算后 `blk_samples = 0`，等下一个样本开新块 | `App/Src/app_diag.c:88` |

因此 T0 `blk=73`、终点 `blk=88`、二次读取 `blk=49` **非单调是设计使然**（每 1 s 归零重计），
**与设备健康状况无关，不能当判据**；它只说明"取样时刻落在一个块的什么位置"。

### 9.6 边界

- 板级实测、**统计级**证据；不是字节级全量验证（原始帧流未落盘）。
- 只覆盖 `en=1` + 单一静置输入 + 单一链路/主机/构建；`en=0` 见 §8，两者互不替代。
- **R2 绝对精度**：8B-3 期间未涉及；该项已于 2026-11-07 实测、记 **部分关闭**（见 `CALIB_ABSOLUTE.md` §6）；R19（真实传感器失效）仍为 NOT TESTED。
- **环境还原项：自动校时已恢复，并已完成一次成功对时**。
  - **历史**（2026-11-06 08:58 回读）：`Parameters\Type = NoSync`、`w32time = Stopped / **Disabled**`。
  - **现状**（2026-11-07 21:26 回读，用户在"设置 → 时间和语言 → 日期和时间 → 自动设置时间"打开开关之后）：
    - `Parameters\Type = **NTP**`（已由 `NoSync` 变为 `NTP`）；`w32time = **Running / Manual**`；
    - **已成功对时一次**：`上次成功同步时间 2026/11/07 21:26:37`，`Leap 指示符 0(无警告)`、
      `层次 5 (次引用 - 与(S)NTP 同步)`、`源 time.windows.com,0x9`、
      `引用 ID 0x34E772B7（源 IP 52.231.114.183）`，`w32tm /query /peers` 由"挂起"转为
      **状态: 运行中 / 模式 3 (客户端)**。
    - 过程要点：开关打开后 `peers` 一度显示 **"状态: 挂起、剩余时间 ≈ 16177 s（约 4.5 h）"**
      ——即"配置已就位但还没轮到对时"；以**管理员**执行 `w32tm /resync`（非管理员报"拒绝访问 0x80070005"）
      后才当场完成。
    - 诚实边界：本次回读的 `根分散 7.77 s` 偏大（刚同步、根分散尚未随轮询收敛），
      **只用于证明"同步已发生且源为 time.windows.com"，不作时刻精度指标**；要谈精度需再回读一次。
  - 两点操作教训（保留，便于复现）：1) 非管理员改不动——写 `Type=NTP`、启动服务、`/resync` 均报"拒绝访问"；
    2) **仅打开"自动设置时间"（只改 Type）不一定够**：先前 `w32time` 的服务启动类型是 `Disabled`，
    必须同时把启动类型改为**按需启动**并拉起服务。管理员命令：
    `sc.exe config w32time start= demand` 然后 `net start w32time`。
    **注意 `sc` 与 `sc.exe` 的区别**：在 **cmd** 里 `sc` 就是服务控制程序；但在 **PowerShell** 里
    `sc` 是 `Set-Content` 的别名，直接敲 `sc config …` 会报错或误写文件——所以在 PowerShell 里
    **必须写 `sc.exe`**（或改用 `Set-Service w32time -StartupType Manual`）。
  - 该项**不影响本轮判定**（8B-3 的 H11 已单独按墙钟口径分析，见 §9.3）。
- 归档：`docs/SOAK_480MIN_20261105_X.txt`，77,875 B，
  SHA-256 `cea4c8f50f23f1847c54b91ffe12b484d1be75f3aeedcc4298422c714bf0a76f`（改名前后一致）。
