zoumingjie124-ui/single-channel-acquisition/docs/STAGE8A_REPORT.md

# Stage 8A 报告：TX 环真实满载与恢复边沿重试（R15 / R16）

> **结论：已执行；方法达不到目的——命令放大只压住大帧，压不住 9 B 的小帧。**
> **固件在该负载下行为符合预期**；但 **R15 的目标场景（提交失败后的重试）仍未验证**。
> `A-1`（"灌满期间收不到 FAULT"）是**测试前提**，实测被否定 ⇒ 属**方法问题，不是固件缺陷**：
> `STAGE8_PLAN` §3.6 的失败判定清单**一条也没有触发**（见 §4.1）。
> R15 / R16 记 **"已尝试、板级未验证"**，**不得关闭**；`retry_fail` 未观测（**A-8 OPEN**），SEQ 缺口未统计（**A-9 未测**）。
> 证据等级：**板级实测、单次运行（n=1）**，`Code=22468`（未重烧、未改固件、未改 `APP_TX_RING_SIZE`）。
> 原始日志：`docs/STAGE8A_TX_FULL_RAW.txt`；另有三份无判定/作废日志
> `..._ABORTED_0931.txt`（握手超时）、`..._ABORTED_0934.txt`（主动终止）、`..._ABORTED_0936.txt`（边沿在窗口外）。

---

## 1. 目的

`STAGE8_PLAN.md` §3 的 8A：在不改固件、不改环大小的前提下，用「命令放大」把 1024 B 的 TX 环灌满，
在**灌满窗口内**制造一次 `ACTIVE → CLEAR` 的恢复边沿，验证
① 环满时不乱烧 `SEQ`、② 恢复后**只提交 1 帧**、③ `rep` 拉平、④ `retry_fail` 不增长、⑤ 采集不受影响。

**命令放大的依据**：文本 `stat` 的回复远大于命令本身。本次实测单条回复 **≈291 B**
（文本 STAT 约 254 B + 二进制 STAT 帧 37 B），命令仅 6 B。10 ms/条 ⇒ 输入约 **29 KB/s**，
链路上限 11.5 KB/s ⇒ 净填约 17.5 KB/s ⇒ 1023 B 的环约 **60–75 ms** 填满。

> **单条回复含二进制 STAT 帧**这一点是本次补测确认的（不发命令 2 s → STAT=2；发 5 条 → 7；发 10 条 → 12），
> 属既有固件行为，不是本轮改动。

---

## 2. 四次启动（前三次无判定/作废，如实保留）

| # | 时间 | 结果 | 处置 |
|---|---|---|---|
| L1 | 09:31 | 握手超时（90 s 内未收到 `go.flag`），脚本自行退出 | **未产生判定**；`..._ABORTED_0931.txt`（1,173 B，`62ae37f9b1d070ae`） |
| L2 | 09:34 | 我主动终止（准备把倒计时从 3 s 延长、改写提示音），**尚未进入测量** | **未产生判定**；`..._ABORTED_0934.txt`（1,101 B，`09fd1bbd94993b2b`） |
| L3 | 09:36 | 完整跑完，但**恢复边沿落在停灌之后**（见下），`FAULT` 在停灌后 **+2,278 ms** 才提交 | **作废**（"灌窗口内没造出恢复边沿"）；`..._ABORTED_0936.txt`（2,810 B，`e3b27bccdc27f17c`） |
| L4 | 09:38 | 条件达到（环满 + 边沿在窗口内），判据判读见 §4 | **本轮有效**；`STAGE8A_TX_FULL_RAW.txt`（4,001 B，`9935f9225f1ae6bc`） |

**L3 为什么作废**：脚本当时用**两个完全相同的提示音**（1200 Hz/600 ms）分别表示"开始灌"和"停灌"，
操作者几乎必然在第二声（停灌）才拧。反推：`t_stop(设备) ≈ 2,361,755 ms`、恢复帧 `t_ms=2,364,033`，
即提交发生在停灌后 +2,278 ms；按"2 个干净块"反推，边沿最早也在停灌后 +278 ms → **落在窗口外**。
窗口内漏出的 6 条 `DIAG` 全是 `mask=1`，与之一致。

L4 已改为**四种互不相同的提示音**（低音逐秒倒计时 / 三声急速上行=开始拧 / 一声低音长鸣=停灌 / 两声低音=拧回卡死位），
并把倒计时延长到 20 s 以便就位。

---

## 3. L4（有效轮）的条件与锚点

| 项 | 值 |
|---|---|
| 固件 | `Code=22468`，未重烧、未改任何源文件 |
| 链路 | COM5 @ 115200，`LOCATION=1-2.1.3` |
| 基线（`reset` 后，09:38:18.268） | `STAT t=2,479,714 n=150 drop=0 adc=0 uart=0 rxf=0 frm=0 chg=0 cmd=0/0 txd=0B` |
| 使能诊断（09:38:19.782） | `OK diag on` → `DIAG en=1 state=2 conf=0 span=12 blk=40 unev=0 mask=1 rep=1` |
| 放行 | `go.flag` @ 09:38:58.763，倒计时 20 s（期间排空积压 `SAMPLE=5486 STAT=55`，不计入窗口） |
| 锚点 1 | `STAT t=2,537,948 ms` @ 09:39:18.007 |
| 灌包窗口 | 09:39:18.06 → **09:39:23.314**，发送 **427** 条 `stat`，窗口 **4.50 s** |

**环确实满了（客观证据）**：`txd`（发送环丢弃字节）从基线 **0B** 涨到 **53,501B**（09:39:24.430），
结束时 **54,490B**。这是"提交失败被丢弃"的计数，不是推演。

---

## 4. 逐条判据

| # | 判据（`STAGE8_PLAN` §3.5/§3.6） | 实测 | 判定 |
|---|---|---|---|
| **A-1** | 灌满期间 FAULT 帧数 = **0**（这是**测试前提**，不是固件判据） | **1** | **前提被否定**（方法达不到目的，**不记固件 FAIL**） |
| **A-2** | 恢复后只提交 **1 帧** `event=2 active=0` | 场景内提交 **1 帧**恢复（`event=2` 由 `rep=0` 反推；**该帧的 `event/active` 未落盘**，见 §5 第 2 条） | **通过（部分字段为推断）** |
| **A-3** | 提交延迟（停灌后）**≤200 ms** | 提交发生在**灌包窗口内**（早于停灌 09:39:23.314） | **不适用**（该判据针对"停灌之后才提交"的情形） |
| **A-4** | `rep` 追上 `mask`（停灌后 ≤1 s） | 09:39:24.430（停灌后 1.12 s 首次采到）`state=0 mask=0 rep=0` | **通过** |
| **A-5** | 采集未受影响 `drops/adc/uart=0` | 终点 09:40:36.534：`drop=0 adc=0 uart=0 rxf=0 frm=0`，`ERRSRC` 全 0 | **通过** |
| **A-6** | 重新卡死：1 帧 `event=1`，`mask=rep=1` | 09:39:28.451 `event=1 active=1 value=12`；另 09:39:35.520 又一次 `event=1` | **通过** |
| **A-7** | `s_busy`：**仅记录、不参与判定** | 该 bit 不可从协议读出（无披露） | **未记录**，不参与判定 |
| **A-8** | `retry_fail` 增量 = 0 | 无调试器、未读内核变量 | **OPEN / NOT OBSERVED** |
| **A-9** | 灌窗口**之外**新增 SEQ 跳号 = 0 | 脚本未统计帧头 SEQ 缺口 | **未测（OPEN）** |

### 4.1 A-1 为什么达不到目的 —— 这是方法问题，不是固件问题

计划的假设是"环满 ⇒ FAULT 提交必然失败 ⇒ 窗口内收不到 FAULT"。实测不成立：

- 环满时，每发出一帧（17 B）就释放 17 B 空间，链路 11.5 KB/s ⇒ **每秒约 680 次释放窗口**；
- 恢复帧只有 **9 B**，任何一次释放都装得下，所以**第一次或前几次尝试就提交成功**；
- 真正被丢的是 **291 B 的 `stat` 回复**（装不进 17 B 的空档）——`txd` 增长 53.5 KB 正是这批。

**按 `STAGE8_PLAN` §3.6 的失败判定清单逐条核对，无一条触发**：

| 原文失败条件 | 本轮实测 |
|---|---|
| 恢复后 **0 帧** | 1 帧 ✔ 未触发 |
| 同一状态 **≥2 帧** | 场景窗口内只有 1 帧恢复 ✔ 未触发（后续 `event=1/2` 在窗口外，由操作者拧回卡死位产生） |
| 灌满期间收到 FAULT **但 `rep` 未前进** | `rep` **已前进**（09:39:24.430 `rep=0`）✔ 未触发 |
| 停灌 **2 s 后 `rep` 未拉平** | 停灌后 1.12 s 已 `mask=0 rep=0` ✔ 未触发 |
| `drops>0` 或 `uart_err>0` | 全 0 ✔ 未触发 |
| `retry_fail >0` | **无读数**（A-8 OPEN），既不能确认也不能否定 |

结论：**"命令放大"能压垮大帧，压不住小帧** —— 这一轮并没有把提交路径逼到失败，
`retry` / `retry_fail` 很可能**根本没被触发**。
所以 **A-1 记为"前提被否定"，既不写 PASS，也不写固件 FAIL**；不改固件、不调判据。
要在板级重做这个"前提"，只有改固件（见 §8），本轮不允许。

### 4.2 边沿确实落在灌满窗口内（这是本轮唯一"干净"的正向结论）

不依赖设备时间映射（本轮映射被 TX 队列滞后破坏，见 §5），用两条互相独立的证据：

1. **窗口内收到 1 条 FAULT**（`[步2] 窗口内 FAULT 帧数 = 1`）：FAULT 帧只有 `event=1/2` 两种；
   本场景前态是 `mask=1 rep=1`，操作是把输入拧离卡死区 ⇒ 只可能是 `event=2`（恢复）；
2. **09:39:24.430 采样 `mask=0 rep=0`**：`rep=0` 说明恢复**已经上报成功**，且此前没有第二条 FAULT。

⇒ 恢复提交发生在 **09:39:18.06–09:39:23.314** 之内；按 `ACTIVE→CLEAR` 需 ≥1 s 干净块反推，
**边沿 ≤ 09:39:22.3，且 > 09:39:18.06** ⇒ **边沿确实在 4.5 s 窗口内**。

---

## 5. 本轮的两个测量缺陷（如实记录，未事后修补）

1. **设备时间映射失效**：脚本用"锚点 1 + 停灌后首个采样"建映射，得 `rate=815.2 ms/ms`（物理不可能）。
   原因是灌包后设备 TX 队列积压，`stat` 回复的 `t=` 是**生成时刻**而非**到达时刻**，
   队列滞后让 Δt 完全失真。**本轮不采用任何由该映射推出的"距停灌 ±N ms"数值**（日志里那行 `-90 ms` 判读作废）。
2. **窗口内 FAULT 的 `event/active` 字段没有落盘**：脚本只记了帧数与类型，没记载荷。
   因此 A-2 的 `event=2 / active=0` 是**由 `rep=0` 反推**，不是直接读到——报告里已标"部分字段为推断"。

这两条都是**脚本的记录能力不足**，不是设备异常。

---

## 6. 覆盖不到的内容（边界）

1. **R18（并发：检查与写入之间无生产者）未被验证**，仍为 **CODE REVIEW PASS**。本轮连"提交失败"都没造出来，更谈不上窗口竞争。
2. **`s_busy` 无超时兜底（§3.1 结论 3）仍 NOT TESTED**：要关闭需要"发送停摆检测 + 超时恢复"的设计变更，本轮不做。
3. **"环满导致永久停摆"没有被复现**：本轮反而证明小帧能穿过满环。
4. **`retry_fail` 没有读数**（A-8 OPEN），所以"重试 0 次""重试有上限"都**没有任何证据**。
5. **A-9 未测**：脚本未做帧头 SEQ 缺口统计，因此"窗口外无新增跳号"无从判断。
6. 只覆盖 **115200 / 单口 COM5 / 单主机 / `Code=22468` / 单次运行**；不外推到其它波特率或多次重复。
7. **灌包本身污染 SEQ/帧率统计**，本轮日志不得用于任何"丢帧率"结论。
8. L4 轮 `[步6]` 期间操作者把电位器拧回卡死位，产生了额外的 `event=1/2`（09:39:28.451、34.510、35.520）。
   **它们不属于场景窗口**，不计入 A-1/A-2。
9. **"主机停读把环堵死"这条路走不通**：本链路纯 TTL、无硬件流控，设备 USART 始终按 115200 发送，
   主机读不读只影响 PC 侧缓冲，不会让设备 TX DMA 停住 ⇒ 环照常释放，堵不死（同 §3.2 已判不可行的 RTS 流控）。
   要逼出"9 B 帧提交失败"只能改固件（缩小环、或加注入点/暴露 `retry_fail`），**违反本项目约束，故 8A-2 不做**。

---

## 7. 产物

| 文件 | 大小 | SHA-256（前 16 位） | 说明 |
|---|---|---|---|
| `docs/stage8a/flood_stat.py` | 15,520 B | `54e5e2c80ea3a220` | 灌包脚本（只发 `stat`/`reset`/`diag on` 三条既有文本命令） |
| `docs/STAGE8A_TX_FULL_RAW.txt` | 4,001 B | `9935f9225f1ae6bc` | **L4（有效轮）**原始日志 |
| `docs/STAGE8A_TX_FULL_RAW_ABORTED_0931.txt` | 1,173 B | `62ae37f9b1d070ae` | L1：握手超时，无判定 |
| `docs/STAGE8A_TX_FULL_RAW_ABORTED_0934.txt` | 1,101 B | `09fd1bbd94993b2b` | L2：主动终止（未进入测量），无判定 |
| `docs/STAGE8A_TX_FULL_RAW_ABORTED_0936.txt` | 2,810 B | `e3b27bccdc27f17c` | L3：边沿在窗口外，作废 |

复现：

```
python docs/stage8a/flood_stat.py --port COM5 --flood-sec 4.5 --period-ms 10 \
       --wait-flag docs/stage8a/go.flag --timeout 300 --countdown 20
```

四种提示音：低音逐秒倒计时 → **三声急速上行＝立刻拧开并保持 3 s** → **一声低音长鸣＝停灌** → 两声低音＝拧回卡死位。

---

## 8. 8A-2 不做 —— 这条路在现有约束下走不通（未执行）

曾设想的替代方案是"让主机停止读取 1–1.5 s，使环彻底堵死"。**该方案已判定不可行**：

- 本链路是**纯 TTL、无硬件流控**（RTS/CTS 未接，固件也未启用流控）；
- 设备侧 USART 始终按 115200 发送，**主机读不读只影响 PC 侧缓冲，不会让设备 TX DMA 停住**；
- 因此环照常以 11.5 KB/s 释放空间，**依然堵不死**——与 `STAGE8_PLAN` §3.2 已判不可行的"RTS 流控"同一条理由。

算一下时间尺度：115200 bps ⇒ **11,520 B/s**，**腾出 9 B 空间约需 0.78 ms**（9 ÷ 11,520）；
一帧 SAMPLE 是 17 B，排空约 **1.5 ms**。也就是说，
**在现有固件 + 无流控链路下，9 B 帧的"提交失败"机制上很难达到（一次实测 + 推演，非穷举证明）**，
`retry` 路径在板级天然难以触发——这是**结论**，不是缺陷。

要真正触发，只剩两条路，**都违反本项目约束**：
① 把 `APP_TX_RING_SIZE` 改小到装不下一帧；② 加固件注入点 / 把 `retry_fail` 暴露到 STAT 行。
两者都要改固件并重烧。

**因此 8A-2 不做。** R15 / R16 停在 **"已尝试、板级未验证"**：
单测证据（`fw_tests` 的 `test_fault.c`，模拟 `emit` 返回 0）仍有效，但只覆盖"提交失败之后"的行为，
**"板级如何进入提交失败"这一段始终没有证据**。
