zoumingjie124-ui/single-channel-acquisition/docs/STAGE7B_HW_REPORT.md

# Stage 7B-HW：卡死检测上板验证报告

> 日期：2026-11-03　范围：**只验证现有 Stage 7B 功能，不修改固件、不改协议、不开始 7C。**
> 结论先行：**默认关闭态的板级长跑 PASS；卡死触发/恢复（#3/#4/#5）被阻塞，未验证。**

---

## 1. 三类结论必须分开（不要混读）

| 结论 | 含义 | 本轮状态 |
|---|---|---|
| GCC 288 项单测通过 | 模块逻辑在 **PC 测试环境**正确 | ✅ 已达成（非板级） |
| ARMCC5 编译 0E0W，Code=21492 / ZI=4956 | **目标工具链**可编译 | ✅ 已达成（非板级） |
| 100Hz 上板、不扰动采样链路 | **真实运行条件** | ⚠️ 仅验证**默认关闭态**（见 §3）；使能态未验证 |
| 电位器固定→约 3s 触发 / 转动→恢复 / 重复触发 | 卡死算法在真实信号上成立 | ❌ **阻塞，未验证**（见 §4） |

---

## 2. 环境与固件基线（已核实）

- 仓库 HEAD = `6112267`（Stage 7B），工作区干净；**未改任何代码/协议**。
- 构建产物 `MDK-ARM/DataAcq/DataAcq.axf`：Code=21492 / ZI=4956，与 7B 文档数字逐字节吻合（ARMCC5 0E0W）。
- 板卡：COM6 = CH340（115200 8N1）在线；STM32 STLink 已连接（SWD 可用）。
- 开板基线（文本 `stat`）：`t=3177194ms n=317719 drop=0 adc=0 uart=0 rxf=0 frm=0 chg=0`，ERRSRC 全 0 → 100.0 Hz、零错误。
- 保留说明：BOOT 帧版本号 V5.0 未随 7B 改变，**无法仅凭串口证明"板上镜像==7B 构建"**；
  需读 flash/符号才能确证。因 7B 默认关闭态与 7B 前串口行为逐字节相同，此保留不影响 §3 结论。

---

## 3. 已完成的板级验证：默认关闭态 10 分钟长跑（测试 #6）

方法：`host/tools/hw_soak_capture.ps1` 只读串口采集 600s 原始字节 → `hw_soak_parse.ps1` 逐帧 CRC 校验离线解析。**不注入任何命令、不改固件。**

结果（详见 `STAGE7B_HW_SOAK_RECORD.md`）：

| 指标 | 实测 | 门槛 | 判定 |
|---|---|---|---|
| SAMPLE 频率 | 100.013 Hz | 100.00±0.10 | PASS |
| STAT 频率 | 1.000 Hz | 1.00±0.05 | PASS |
| drops / frame_err / adc_err / uart_err / rx_err | 全 0 | =0 | PASS |
| seq8 缺口 / 整帧丢失 / CRC 坏帧 | 0 / 0 / 0 | =0 | PASS |
| BOOT 帧 / 链路中断 | 0 / 0 | =0 | PASS |
| changes | 0 | 0（输入不动） | 符合 |

**结论：PASS（12/12）。** 7B 新增代码（+284 B Code / +40 B ZI）在默认关闭态未扰动 100Hz 采集链路。
对应设计文档 §7 未验证项 #2 的"默认关闭"一半；**使能态一半仍未验证**。

---

## 4. 被阻塞的验证：卡死触发 / 恢复 / 重复触发（测试 #3/#4/#5）

### 4.1 阻塞一：正式固件运行时无处使能诊断（非脚本遗漏，是固件设计）

全仓证据：
- `app_diag_set_enable()` **仅在 `fw_tests/test_diag.c`（PC 单测）被调用**；固件运行时从不调用。
- `enable` 只被 `app_diag_init()`（置默认 0）与 `set_enable` 写；`app_task.c:475` 只调 `app_diag_init`。
- `APP_DIAG_STUCK_ENABLE_DEFAULT = 0`；`APP_DEBUG_INJECT = 0`（正式版不编入注入命令）。
- 协议 V5 命令集（`0x10`–`0x14` + 文本 `help/stat/thr/led/reset`）**无诊断使能命令**；STAT 帧无 diag 字段 → **卡死状态经串口不可观测**（属 7C）。

因此：在当前正式固件上，**不开调试器、不改代码，就无法开启卡死检测，也无法经串口看到它的状态。**
按指示"不得为测试修改协议/代码、无法使能先报告"，本轮**未改代码、未改协议**。

### 4.2 阻塞二：需要人工物理操作电位器

#3（保持不动看触发）、#4（转动看恢复）、#5（再固定看重复触发）都要求**用手保持/缓慢转动/停住电位器**
并与触发/恢复时刻对齐记录。执行方为软件代理，**无物理执行器**，此三步必须有人在台面操作。

### 4.3 结论

#3/#4/#5 = **未验证（阻塞）**。不存在任何"已触发/已恢复"的板级证据；**不要**把上位机无故障显示当作检测失败（协议本无上报）。

---

## 5. 人工台面补测步骤（供完成 #3/#4/#5，不改代码）

唯一不改代码的使能/观测路径 = **调试器直写 + 监视 `s_ctx.diag`**（STLink 已连接）：

1. Keil 连板（不 halt 主循环，用 Live Watch / Memory 窗口）。
2. 使能：写 `s_ctx.diag.enable = 1`（并确认 `blk_started` 由下一样本自然开块）。
3. 监视字段：`state`、`confirm_cnt`、`stuck_blocks`、`clean_blocks`、`last_span`、`last_change_ms`。
4. 台面动作与记录（记**实际时刻**，不只 PASS/FAIL）：
   - 电位器保持不动 → 记录 state 进入 ACTIVE 的时刻（预期约 3 s，块边界附近会有 ±1 s 抖动）；
   - 缓慢转动 → 记录回到 CLEAR 的时刻（预期约 2 s 干净块）；
   - 再次固定 → 记录第二次 ACTIVE（`confirm_cnt` +1）。
5. 串口侧并行跑 `host/tools/hw_soak.cmd COM6 <分钟>` 记录 raw_mv/filt_mv 与计数器，与调试器时刻对齐。
6. 阈值提醒：`STUCK_DELTA_MV=50 mV` 是**实验值**，接真实传感器前必须按噪声/正常变化范围重新标定。

---

## 6. 本轮产出文件

| 文件 | 作用 |
|---|---|
| `docs/STAGE7B_HW_SOAK_RAW.txt` | 原始日志（每分钟行，SOAK_60MIN.txt 同款格式） |
| `docs/STAGE7B_HW_SOAK_RECORD.md` | 10 分钟长跑记录表（表A/表B/判定） |
| `docs/STAGE7B_HW_REPORT.md` | 本报告 |
| `host/tools/hw_soak_capture.ps1` | 只读串口采集（时间戳输出，避免覆盖历史证据） |
| `host/tools/hw_soak_parse.ps1` | 离线逐帧 CRC 解析 + 生成每分钟文本 |
| `host/tools/hw_soak.cmd` | 一键启动器（采集+解析） |

完整原始字节 `_raw.bin` 保留在本次采集目录（未入库，避免仓库膨胀）；如需入库证据可再议。

---

## 7. 未验证清单（如实）

| # | 项 | 状态 |
|---|---|---|
| 1 | 卡死触发/恢复/重复触发（#3/#4/#5） | 阻塞（§4），待人工台面 + 调试器 |
| 2 | 使能态 10 分钟长跑 | 阻塞（同上） |
| 3 | 板上镜像 == 7B 构建 的 flash 级确证 | 需调试器读 flash；本轮以构建产物+行为等价旁证 |
| 4 | `STUCK_DELTA_MV=50mV` 对真实传感器适用性 | 待标定 |
| 5 | `app_diag.c` 在 ARMCC5 下的 cycle 级耗时 | 未测（仅逻辑+编译验证） |

**下一步待批准：完成 §5 台面补测；7C 未开始。**
