zoumingjie124-ui/single-channel-acquisition/docs/CALIB_ABSOLUTE.md

# 绝对电压精度标定（Stage 6 · 第 2 项）

> 目的：补上 Stage 2 的缺口 —— 之前所有 ADC 结论都是**比例测量**，
> VREF+ 与 VDDA 同源，满量程读数天然等于参考值，所以"读数准不准"从来没被独立验证过。
>
> **状态：已执行（2026-11-07 20:18–20:27）**，见 §6；原始记录 `docs/CALIB_RAW.txt`。
> 结果一句话：**零点按公式 (b) 折算条件下 PASS（1.58 mV，含折算 4.58 mV；0.000 V 属规格范围外折算，见 §6.3）；绝对精度未达 1 %FS（点估计 1.66 %FS）**，误差**与"固件假设 3.300 V 而 3.3 轨实测 3.245 V"一致**，但在按 (b) 折算的 ±41.9 mV（无原厂来源，不构成上界）内**无法区分板偏与表偏**（故不宣称"ADC 无增益误差"）。

---

## 1. 为什么这一步不能省

| 已有结论 | 实际证明了什么 | 没证明什么 |
|---|---|---|
| 零点 +1.75 mV | ADC 内部偏移 + 地线压降，量级正常 | 板上"0 V"是否真是 0 V |
| 满量程 3299.87 mV | 满码与 `raw*3300/4095` 换算自洽 | 板上 3.3V 轨是否真是 3.300 V |
| 全量程 16/16 段单调 | 电位器扫过全量程时读数单调 | 任意一点的**绝对误差** |

一句话：**在同一根 3.3V 轨上自比，误差会被系统性抵消**。要证明绝对精度，必须引入一个外部参考——万用表。

---

## 2. 要测的三个点

| 点 | 输入 | 万用表测什么 | 串口同时记什么 | 能算出什么 |
|---|---|---|---|---|
| P0 | PA1 接 GND | PA1 对 GND 的实际电压（应在 ±1 mV 内） | `raw_mv` 均值 | 零点偏移 |
| P1 | PA1 接板载 3.3V 轨 | **VDDA 的实际电压** | `raw_mv` 均值 | 增益误差（这是关键点） |
| P2 | PA1 接分压中点（可选） | 该点实际电压 | `raw_mv` 均值 | 中点线性误差 |

> P1 是核心：它是唯一能把"比例读数和真实电压"分开的测点。
> 如果万用表读到 3.28 V 而设备报 3299 mV，说明误差来自**参考电压假设**（固件写死 3300），
> 而不是 ADC 本身——这两种情况修法完全不同。

---

## 3. 安全红线（先看这个，再看接法）

| 红线 | 原因 |
|---|---|
| PA1 只能 0~3.3 V | 超过 3.3 V 会经保护二极管灌电流，可能永久损坏 ADC |
| 禁止负压 | 同上，反向灌流 |
| 3.3 V 不得与 GND 短接 | 直接短路稳压器输出 |
| USB 供电与 ST-Link 3.3V **只接一路** | 两路 3.3V 互顶，轻则读数异常，重则损坏 |
| 改接线必须**断电**，不许热插拔 | 带电插拔容易瞬间短路 |

> 万用表测电压是**并联**，不会改变电路；但仍然建议先断电接线、再上电测量。
> 测 VDDA 时表笔搭在板子的 3.3V 与 GND 上即可，不要碰 PA1。

---

## 4. 执行步骤

```
1. 断电，PA1 接 GND（保持 USB-TTL 的 GND 共地）
2. 上电，等 3 s
3. 万用表直流档测 PA1–GND 实际电压 V0，记下
4. 同时跑：python host/tools/calib.py zero COM6      → 得 raw_mv 均值 M0
5. 断电，PA1 改接板载 3.3V 轨
6. 上电，等 3 s
7. 万用表测 3.3V 轨对 GND 的实际电压 V1（这就是 VDDA），记下
8. 同时跑：python host/tools/calib.py full COM6      → 得 raw_mv 均值 M1
9. （可选）断电，PA1 接两只等值电阻分压中点，重复 3-4 得 V2 / M2
```

> 第 4、8 步必须在**同一次上电**状态下做：断电再上电，VDDA 可能变（USB 供电波动）。
> 如果只有一块万用表，先读表、立刻跑脚本，两次间隔控制在 10 s 内。

---

## 5. 误差怎么算（照这个公式填）

设万用表读数 V1（VDDA 实际值），设备读数 M1（满量程均值）：

| 指标 | 公式 | 说明 |
|---|---|---|
| 实际每 LSB 电压 | `V1 / 4095` | 真实量化步长 |
| 设备隐含的每 LSB | `3300 / 4095 = 0.8059 mV` | 固件写死的假设 |
| **增益误差** | `(M1 - V1) / V1 × 100%` | 正 = 设备读数偏高 |
| 折算到读数 | `M1 - V1`（mV） | 直接可比的绝对偏差 |
| 零点偏移 | `M0 - V0`（mV） | 减去地线压降后的真实偏移 |
| 跨度误差 | `(M1 - M0) - (V1 - V0)` | 去掉零点后的增益误差 |

**判定门槛（先定好，避免事后找理由）**：

| 指标 | 门槛 | 依据 |
|---|---|---|
| 零点偏移 | ≤ 5 mV | 当前实测 1.75 mV |
| 满量程绝对误差 | ≤ 1% FS（33 mV） | 12 位 ADC + 1% 电阻分压的合理量级 |
| 跨度误差 | ≤ 0.5% FS | 比"绝对"宽松一档，扣掉零点后应更好 |

> 若满量程误差 > 1%，先怀疑 **VDDA 真的不是 3.300 V**（USB 供电常见 3.25–3.35 V），
> 而不是 ADC 坏了。这正好是这一步要回答的问题。

---

## 6. 记录表（已填）

### 6.1 环境

| 项 | 值 |
|---|---|
| 日期时间 | 2026-11-07 20:18 – 20:27 |
| 固件 | `Code=22468`（未重烧；与 8B-2 / 8B-3 同一构建） |
| 串口 | COM5（`LOCATION=1-2.1.3`，CH340） |
| 万用表 | **福仪（MASTFUYI）FY106A**，4 位显示 |
| 读数时档位 | DC **4 V 档**（分辨率 **0.001 V**，1 字 = 1 mV）；表为自动/手动双模式 |
| 准确度公式 | **公开资料互相冲突，取已查到的最大值（无原厂来源，不构成上界）**：铭牌未印公式；2026-11-07 检索到 4 个转载页 / 3 种写法 —— ±(1.2 %+3)、±(1 %+3)、±(1 %+2)，另有一份仅 FY106A 的说明书**未印精度**。清单与 URL 见 §6.3 / §6.4-5。**取 ±(1.2 % + 3)** |
| 供电方式 | ☑ USB　□ ST-Link 3.3V（**只接一路**） |
| 板上其他负载 | ☑ 无（电位器已从 PA1 断开） |

### 6.2 测点

| 点 | 输入 | 万用表 V | 设备 M | 偏差 | 备注 |
|---|---|---|---|---|---|
| P0 | PA1–GND（A1 用杜邦线短接 GND） | **0.000 V** | **1.58 mV**（min 0 / max 8） | +1.58 mV | 300 样本 / 3.00 s / 99.98 Hz |
| P1 | PA1–3.3V 轨（A1 短接 3.3） | **3.245 V** | **3299.75 mV**（min 3296 / max 3300） | **+54.75 mV** | 300 样本 / 3.00 s / 99.95 Hz；≈4094.7 LSB |
| P2 | 分压中点 | 未做 | 未做 | — | 可选，本轮未执行 |

### 6.3 结论

> **百分比一律以 FS = 3300 mV（固件满量程）为分母**；以表读数为分母的比值另标注为"相对读数"，不叫 %FS。

| 指标 | 实测 | 门槛 | 判定 |
|---|---|---|---|
| 零点偏移 `M0−V0` | **+1.58 mV**（含按 (b) 折算 **4.58 mV**，不构成上界） | ≤5 mV | **按公式 (b) 折算条件下 PASS（余量 0.42 mV，变薄）** |
| 满量程绝对误差 `M1−V1` | **+54.75 mV＝1.66 %FS**（相对读数 +1.69 %） | ≤1 %FS（33 mV） | **FAIL（点估计）** |
| 跨度误差 | +53.17 mV＝**1.61 %FS** | ≤0.5 %FS（16.5 mV） | **FAIL（点估计）** |
| VDDA 是否等于 3.300 V | **否**：3.245 V（低 55 mV，−1.67 %） | — | — |

**归因（只能说"一致"，不能说"验证"）**：

- PA1 接 3.3 轨时，**输入就是 VDDA 本身**，ADC 基本满码（本轮均值 4094.7 LSB、最小样本 4090、最大 4095，见 §6.4）；
  固件按 `4095 × 3300 / 4095 = 3300 mV` 折算，于是 `54.75 mV = 3300 − 3245` 是**算术恒等式**；
- 它只说明"设备读数比外部表读数高 54.75 mV"，且这个差**与"固件假设 3.300 V、轨压更低"一致**；
- **在表的误差折算（按 (b) 估计 ±41.9 mV，不构成上界）内，无法区分"板偏"（VDDA 真的低 55 mV）与"表偏"（表读数偏低）**——两者都能解释这 54.75 mV。
- ⇒ **本轮不给出"ADC 自身增益误差 < 0.3 LSB"这类结论**（早期草稿写过，已撤回）；
  要分离板偏与表偏，必须做一次**比例测量**（见 §6.4 第 4 项）。

**不确定度声明（引用前必读；精度公式 4 个转载来源、3 种写法，互相冲突）**

表：**福仪 FY106A**，读数时 DC **4 V 档**，分辨率 1 mV（1 字 = 1 mV）。**铭牌未印公式，无原厂件可核**：

| 来源 | 公式 | 3.245 V 处不确定度 | 占 %FS |
|---|---|---|---|
| (a) 用户转述 | ±(0.8 % 读数 + 2 字) | 25.96 + 2 = ±28.0 mV | ±0.85 %FS |
| (b1) `manuals.plus/ae/1005006869152807`（FY106A/B 合页，非原厂） | ±(1.2 % + 3) | 38.94 + 3 = **±41.9 mV** | **±1.27 %FS** |
| (b2) `manuals.plus/ae/1005006996221800`（同型合页） | ±(1 % + 3) | 32.45 + 3 = ±35.5 mV | ±1.07 %FS |
| (b3) `manuals.plus/ae/3256806170402411`（同型合页） | ±(1 % + 2) | 32.45 + 2 = ±34.5 mV | ±1.04 %FS |
| (c) `manuals.plus/asin/B0CRB9XHF3`（**仅 FY106A** 的说明书） | **未印精度**（只写 4000 counts / auto-ranging ≤600 V） | — | — |

> **取已查到的最大值 (b1) ±41.9 mV（无原厂来源，不构成上界）**；下表区间一律按 (b1)。
> 三份合页都把 DC 写成 `1 V~600 V` 一档，**没有 4 V 档的分档精度**；"4 V 档 / 1 mV 分辨率"来自表上实际量程。
> (c) 那份的尺寸重量（108×56×25 mm / 162 g）与 (b1)~(b3)（117×56×25 mm / 92 g）**不一致**
> ⇒ **推断同型号存在不同版本（依据：尺寸、重量与规格不一致）**，这正是"转载资料不能替代原件"的具体证据。
> **下文凡写"(b)"，均指这个取值 (b1) ±(1.2 % + 3)。**
>
> ⚠ **零点处属规格范围外折算**：三份资料都把 DC 电压标注为 `1 V~600 V`，而 P0 测点是 **0.000 V**。
> 0 V 处的 `+3 字`（3 mV）是把 1 V 档公式外推到量程之外得到的，**不是该档给出的保证值**；
> 只能说"按此折算"，**适用性未经验证**（不断言公式在 0 V 无效，也不据此给溯源上界）。
> 故零点判定口径写作"**按公式 (b) 折算条件下 PASS**"，4.58 mV 与 0.42 mV 余量均依赖该折算。

- 满量程误差按 (b) 折算的条件估计范围 = **54.75 ± 41.9 = +12.8 ~ +96.7 mV ＝ +0.39 % ~ +2.93 %FS**；
- 跨度误差按 (b) 折算的条件估计范围 = **53.17 ± 41.9 = +11.3 ~ +95.1 mV ＝ +0.34 % ~ +2.88 %FS**；
- 点估计 1.66 %FS 超 1 % 门槛（33 mV **仍落在区间内**），**区间跨过门槛** ⇒ 只能写"**点估计超标、机制一致但未分离**"，
  **不能写"确定超过 1 %FS"，也不能写"已验证 ≤1 %FS"**；
- **±41.9 mV 是按已查到公式 (b) 折算的估计值（无原厂来源，不构成上界）**：4 个转载页给出 3 种互相冲突的公式、且没有一份是原厂件，
  **表身铭牌只标型号与量程、未印精度公式**（2026-11-07 核对）；若日后拿到原厂说明书，按它重算一次即可，**口径不变、只换数字**。

**结论写法（照本文档原定口径，不升级）**：

- 零点：**按公式 (b) 折算条件下 PASS**（1.58 mV；含折算 **4.58 mV**，仍 ≤5 mV，但**余量只剩 0.42 mV**；4.58 与 0.42 都依赖规格范围外折算，非溯源精度保证）。
- 绝对精度：**未达 1 %FS**；误差**与参考电压假设一致**，但**未能与"表偏差"分离**。
- 若要更高绝对精度：改用内部 **VREFINT** 在线校准或外部基准——**属新增功能，本阶段不做**。

**顺带记录一个此前未写进文档的影响**：由于读数按 3300 mV 折算，而轨压实测约 3.245 V，
**绝对读数系统性偏高约 1.7 %** ⇒ 告警阈值在真实电压上系统性偏低：
标称 `WARN 2400 mV` 实际在 **2360.0 mV** 触发，`CRIT 3000 mV` 实际在 **2950.0 mV** 触发。
**以上是点估计，且以"3.245 V 就是真值"为前提**（1.7 % ≈ `54.75/3245`）；按 (b) 折算的 **±1.27 %FS**（不构成上界）内，
偏高量约 **+0.4 %~+2.9 %**，对应触发点 `WARN` 约 **2330~2390 mV**、`CRIT` 约 **2915~2990 mV**（取整 5 mV）。
**不得把 2360.0 / 2950.0 当作溯源过的固定值引用。**
**比例类结论（线性、单调性、噪声、重复性）不受影响**（读数与阈值同口径）；
但任何"绝对电压"表述都要带这个偏差。

### 6.4 本轮未做

1. **VDDA 与 3.3V 轨是否同网络未验证**（未做断电通断测量：`3.3` 针 ↔ LQFP48 第 9 脚）。
   按 `TEST_INVENTORY` R2 口径，本轮属 **B 类（3.3V 轨作代理）** ⇒ **R2 只能"部分关闭"**。
   尝试过在芯片边缘逐脚通断扫描但未取得可靠接触（LQFP48 脚宽约 0.2 mm），**主动放弃、未勉强**。
   **为什么 B 口径对本结论够用（已有数据约束，不只是估计）**：满量程批次不是"全部 4095"——
   `raw_mv` min/mean/max = 3296 / 3299.75 / 3300 mV ⇒ 折算 **4090 / 4094.7 / 4095 LSB**（峰峰 5 LSB）。
   存在低到 4090 的样本，说明输入**没有被完全压在满码上**，即 **PA1 节点与 VDDA 的差 ≤5 LSB（≈4 mV）**
   （其中还含 ADC 自身噪声）。**注意：这个界来自"样本最小值"，是上界、不是测出来的差值。**相对 **54.75 mV（1.66 %FS）** 的误差与 **±41.9 mV** 的折算值，可忽略。
   ⚠ 但**这只约束了"该测点的电压差 ≤4 mV"，不构成"同网络"的证明**，因此不据此宣称 R2 已关闭。
   ⚠ 逐样本原始码**未存档**（`calib.py` 只打印 min/mean/max），故**标准差与"取 4095 的比例"无法给出**。
2. P2 中点未做，中间量程线性未测。
3. 单次上电会话（n=1），未做重复性。
4. **未做比例测量（可选，本轮不做；不因此重采、不改 `calib.py`）**：没有在同一量程下同时测"PA1 实际电压"与"VDDA"，
   因此无法验证固件读数在中间量程上的比例正确性。
   **补做方法**：PA1 接一个分压中点（约 1.6 V）——**用两只 1 kΩ~2 kΩ 等值电阻**，
   **不要用 10 kΩ 以上**（源阻抗过大会让 ADC 采样保持的建立误差显现，反而污染结论）；
   上电后**用同一只表、同一量程**分别读 `V_PA1` 与 `V_轨`，同时取固件 `mv`。
   **现行预设验收线：±12 mV**（须在测之前定，本次未测也先写死）；下列估算按公式 (b) 折算：
   - 表的**数字项不会在比值里抵消**（3 字 = 3 mV）：`P = 3300 × V_PA1 / V_轨` 的数字误差最坏
     ≈ `3300 × (3/1622 + 3/3245) ≈ 9.2 mV`；增益项在比值里大部分抵消，不计；
   - ADC 侧按几个 LSB 计约 **3 mV**；
   - **合成容差估算约为 12.2 mV。现行预设验收线为 ±12 mV。**
   **注：现行 ±12 mV 判据与上述合成容差约 12.2 mV 相差约 0.2 mV；若两者对应同一误差量及测试条件，则现行判据在数值上更严格。**
     （若按 (a) 的 2 字，合成容差估算约为 9.1 mV。）
   ⇒ **该法在这只表上的分辨力约 0.75 %（12 mV 相对约 1.6 V 测点），只能发现明显的增益问题，证明不了 0.1 % 级的一致。**
   **判读**：`|固件 mv − P| ≤ 12 mV` ⇒ 该点比例读数与表在容差内一致；
   明显大于 12 mV ⇒ 依次查增益、偏置、源阻抗（分压电阻过大时建立不足），**但不要把它当成 0.1 % 级的判据**。
   ⚠ **这个测法不能分辨"板子的 VDDA 真是 3.245 V"还是"表读数偏低"**——两者都只影响绝对量，
   在比值里被抵消掉了。要缩小这个范围，只能**用第二只表交叉对读**，或用**已知精度的基准源**。
   **时序声明**：现行 ±12 mV 验收线在该测项开始之前已确定；该测项至今未执行。
5. **表精度公式无原厂依据（铭牌已核对 + 公开检索）**：型号（**福仪 FY106A**）与读数时量程（**DC 4 V 档，分辨率 1 mV**）已回填；
   用户 2026-11-07 核对表身铭牌，**只有型号与量程、没有印精度公式**，原说明书未找到。
   同日公开检索（manuals.plus 系列，**全部非原厂**）得到 **4 个页面 / 3 种互相冲突的写法**：
   ±(1.2 % + 3)（`/ae/1005006869152807`）、±(1 % + 3)（`/ae/1005006996221800`）、
   ±(1 % + 2)（`/ae/3256806170402411`），以及一份**只讲 FY106A、未印精度**的说明书（`/asin/B0CRB9XHF3`：
   只写 4000 counts / auto-ranging ≤600 V，且尺寸重量与前三份不一致）⇒ **推断**同型号有不同版本（依据：尺寸、重量与规格不一致）。
   三份合页都把 DC 电压写成"1 V~600 V"一档、**没有 4 V 档的分档精度**（"4 V 档"来自表上实际量程）。
   **无原厂件可核 ⇒ 一律取已查到的最大值 (1.2 % + 3)（不构成上界）**，故 ±41.9 mV 是公式 (b) 的折算估计值（不构成上界）、不是溯源过的不确定度；
   其余写法在同点为 ±28.0 / ±35.5 / ±34.5 mV，均小于它。若日后翻到原厂说明书，按它重算（只换数字，三句口径不变）。

## 7. 做完之后要同步的三处

1. `docs/TEST_INVENTORY.md` §5 的 **R2** 改成"已关闭"或"部分关闭"，写清依据；
2. `README.md` §7 的"绝对电压精度"行；
3. `docs/TEST_REPORT.md` 追加一节（§17 或之后），把原始读数贴进去。

**没有真实读数之前，这三处一行都不许改。**
