zoumingjie124-ui/single-channel-acquisition/docs/SOAK_480MIN_RECORD_8B3.md

# Stage 8B-3 记录：诊断开启（`en=1`）8 小时 / 480 min

> **结论：PASS（H1–H12 全通过）**，板级实测、统计级证据。这是本项目第一次"诊断开启态 8 小时"长跑。
> 不能由此关闭 R2（绝对精度未测），也不能说"项目所有 8 小时场景都验证完了"（本轮只覆盖 `en=1` + 单一输入状态）。
> 原始日志：`docs/SOAK_480MIN_20261105_X.txt`（77,875 B，SHA-256 `cea4c8f5…0a76f`）

---

## 1. 条件与环境

| 项 | 值 |
|---|---|
| 固件 | `Code=22468` RO 1076 RW 148 ZI 4972（2026-11-03 23:14 烧录后未重烧） |
| 诊断 | `en=1`（**诊断开启**，2026-11-05 23:08:38 `diag on` 恢复；23:10:36 `reset` 未改变 `en`） |
| 链路 | COM5 / `LOCATION=1-2.1.3`（与 8B-2、Y2、X2 同一路径） |
| 主机 | 自动校时 `Type=NoSync`、`w32time` Stopped/Disabled；睡眠/休眠/混合睡眠 0/0；AC 供电 |
| 输入 | 电位器静置未动（`mask=1 rep=1`，卡死态持续；`span` 8–11 mV） |
| 起跑 | 2026-11-05 **23:10:56**（`python host/tools/soak.py 480 COM5`） |
| 结束 | 2026-11-06 **07:10:56**，`soak.py` exit 0，`===== 合计（28800.0 秒）=====` 段存在 |

**起跑前板子重启过一次（T0 之前，不计入本轮）**：CH340 设备节点 `LastArrivalDate=2026-11-05 23:07:34`，
两次 uptime 反推 boot 均为 23:07:25.8，判定为 USB 物理插拔上电（详见 `STAGE8B3_START.txt` §9.1）。
影响：诊断被复位为 `en=0`、上电瞬间 `uart=2/fe=2/cmd err=16`；已重新 `diag on` 并 `reset` 处理。

## 2. 基线（T0）与判据口径

```
T0  2026-11-05 23:10:46.618
STAT   t=200795ms n=1000 drop=0 adc=0 uart=0 rxf=0 frm=0 chg=0 cmd=0/0 txd=0B
ERRSRC ore=0 fe=0 ne=0 pe=0 pto=0 rxrst=0/0
DIAG   en=1 state=2 conf=0 span=10 blk=73 unev=0 mask=1 rep=1
```

**判据 = 终点 − T0（差值）**：`soak.py` 合计段的 `drops/frame_err/adc_err/uart_err/rx_err/changes/uptime_ms`
直接取**最后一帧 STAT 的绝对值**（`soak.py` L142、L170–177，无基线相减），所以设备侧计数一律用差值判。
本轮 T0 全 0，因此**差值 ≡ 绝对值**，两种写法数值相同。

## 3. 合计段原文

```
===== 合计（28800.0 秒）=====
收到字节      : 50234327  (1744.2 B/s)
SAMPLE 帧     : 2880407  (100.01 Hz)
STAT 帧       : 28804  (1.00 Hz，设计 1.00 Hz)
EVENT 帧      : 0
drops         : 0
frame_err     : 0
adc_err       : 0
uart_err      : 0
rx_err        : 0
状态切换      : 0
设备运行时间  : 29014000 ms
seq8 缺口     : 0   (样本级)
整帧丢失      : 0   (帧级)
解析错误      : 0
BOOT 帧       : 0
链路中断次数  : 0
```

## 4. 打点（479 条）与 ΔSAMPLE 分布

- 479 条（60 s … 28740 s），与脚本循环逻辑一致（`elapsed>=total` 时先退出，不写第 480 点）。
- 478 个区间：**ΔSAMPLE = 6000 ×88 / 6001 ×374 / 6002 ×16**，**max 偏差 2**；
  ΔSTAT = 60 ×474 / 61 ×4。
- **没有台阶**：与 8B-2 那次 `[7260s]` 的 5705 不同，本轮不存在任何单分钟大幅偏离；
  因此**不需要**用 NTP 台阶解释（也已由事件日志独立排除，见 §7）。
- **ΔSAMPLE 合计 2,868,406**，比 478×6000 = 2,868,000 多 **+406**（= 374×1 + 16×2）；
  **ΔSTAT 合计 28,684**，比 478×60 = 28,680 多 **+4**（≈4 s，来自 4 个 61 的区间）。
- 末值 2,874,407 相对标称 2,874,000 的 **+407** = 406 + 首个 60 s 区间多出的 1 帧；与 141 ppm × 28800 s ≈ +406 一致。

## 5. H1–H12

| 编号 | 指标 | 实测 | 门槛 | 判定 |
|---|---|---|---|---|
| H1 | SAMPLE 频率 | 2,880,407 / 28,800.0 = **100.0141 Hz** | 100.00 ± 0.10 | **PASS** |
| H2 | STAT 频率 | 28,804 / 28,800 = **1.00014 Hz** | 1.00 ± 0.05 | **PASS** |
| H3 | drops（差值） | 0 − 0 = 0 | = 0 | **PASS** |
| H4 | frame_err（差值） | 0 − 0 = 0 | = 0 | **PASS** |
| H5 | adc_err（差值） | 0 − 0 = 0 | = 0 | **PASS** |
| H6 | uart_err（差值） | 0 − 0 = 0 | = 0 | **PASS** |
| H7 | seq8 缺口 | 0（8 位可分辨范围内） | = 0 | **PASS**（限"未检出"） |
| H8 | 整帧丢失 | 0（同上） | = 0 | **PASS**（限"未检出"） |
| H9 | BOOT 帧 | 0 | = 0 | **PASS** |
| H10 | 链路中断 | 0 | = 0 | **PASS** |
| H11 | 时基偏差（uptime 口径） | **0.0141 %** | < 0.1 % | **PASS** |
| H12 | 解析错误 | 0 | = 0 | **PASS** |

统一表述：
> 在当前 8 位序号检测能力范围内，未检出可分辨的序号缺口（`frame_gap` 与 `seq8_gap` 均受同一限制）。
> 单次连续丢失恰为 **256 的整数倍**帧时不可见；"未检出"≠"绝对零丢失"。

## 6. H11 的算法与跨轮对照

```
T0  uptime0 = 200795 ms   @ 2026-11-05 23:10:46.618
T1  uptime  = 29034427 ms @ 2026-11-06 07:11:16.173
Δuptime = 28833632 ms    Δwall = 28829555 ms    差 = +4077 ms
偏差 = 4077 / 28829555 = 0.01414 %   → 141 ppm（设备时基偏快）
```

- 终点 `uptime` 取自 1 Hz STAT，存在约 **±1 s 量化**（≈±0.0035 %），故**不宣称毫秒级精确**。
- **与 8B-2 的对比（重要）**：8B-2（`en=0`）报的是 **0.0039 %**，本轮是 **0.0141 %**。
  8B-2 那次窗口内有一次主机 NTP **+2950 ms** 前跳，把 `Δwall` 拉长、抵消了约 2.95 s；
  本轮 `NoSync`、事件日志无时钟阶跃，**测到的是未经抵消的真实值 ≈141 ppm**，与 8B-2 分段拟合出的 140 ppm 吻合。
  → 结论：两轮不是"设备变差了"，**8B-2 的 0.0039 % 是表观值**，141 ppm 才是该构建的真实量级。
- 因此 **H11 不得跨轮次比较**，只能逐轮对照"是否 < 0.1 %"。

## 7. 时钟 / 电源事件核查（先排除 NTP，再解释间隔）

| 查询 | 结果 |
|---|---|
| `Time-Service`（ID 35/37）与 `Kernel-General`（ID 1），2026-11-05 23:00 – 11-06 07:20 | **零命中**（无校时、无时间变更） |
| `Kernel-Power` 42 / 107（睡眠/唤醒） | **零命中** |
| `Kernel-Power` 566（会话状态切换） | 3 条：23:25:22、23:35:56（原因 InputAccelerometer）、00:05:26 —— 非睡眠、非唤醒 |

结论：本轮窗口内**没有墙钟阶跃、没有睡眠/唤醒**，所以 §4 的"无台阶"不是被时钟掩盖的结果，
打点间隔也无需再用时序原因解释。

## 8. 终点读数与 `conf` 的口径

```
07:11:16.173  STAT t=29034427ms n=2884363 drop=0 adc=0 uart=0 rxf=0 frm=0 chg=0 cmd=0/0 txd=0B
              ERRSRC ore=0 fe=0 ne=0 pe=0 pto=0 rxrst=0/0
              DIAG en=1 state=2 conf=0 span=10 blk=88 unev=0 mask=1 rep=1
07:11:20.640  STAT t=29040095ms n=2884930 … DIAG en=1 state=2 conf=0 span=11 blk=49 …
```

- 设备侧错误计数**全程为 0**（差值 0、绝对 0 两者一致）。
- `n` 对账：`n_end − n_T0 = 2,884,363 − 1,000 = 2,883,363`；
  日志 SAMPLE 2,880,407 + 窗口差 29.555 s × 100 Hz (=2,956) = **2,883,363** → **闭合，残差 <1 样本**。
- **`conf = 0` 是预期内的**：`reset`（23:10:36）把 `conf` 清零，而当时模块**已经处于 ACTIVE**，
  之后 8 小时输入一直卡死、没有发生 CLEAR→CONFIRM 的新确认，所以 `conf` 保持 0（**增量 0**）。
  与 X2 的 `conf 1→1`（增量 0）**结论相同、起点不同**，引用时不得混用绝对值。
- `mask=1 / rep=1 / state=2 / unev=0`：故障仍上报且无未决事件，符合"诊断开启态长期运行不应产生新事件"。
- **`blk` 的含义（已查源码）**：`blk` = `app_diag_block_samples()`，即**当前未结算的 1 s 统计块内已计入的样本数**
  （100 Hz ⇒ 0–100），块结算后清零（`App/Src/app_task.c:343`、`App/Inc/app_diag.h:44`、`App/Src/app_diag.c:88`）。
  T0=73 → 终点=88 → 二次读取=49 的**非单调是设计使然**，与健康状况无关，**不作判据**。
- **一处更正**：起跑时按"`conf` 会 0→1"预期记录，该预期**错误**——`confirm_cnt` 只在
  `CLEAR/CONFIRMING → ACTIVE` 时自增（`App/Src/app_diag.c:120`），ACTIVE 期间不重复确认
  （同文件 L129–134）。`reset` 清零时模块已 ACTIVE，故全程 0。详见 `STAGE8B_REPORT` §9.5。

## 9. 未完成 / 受阻

1. **自动校时仍未恢复（环境还原项，2026-11-06 08:58 回读）**：`Parameters\Type = NoSync`、
   `w32time = Stopped / Disabled`。非管理员既写不了 `Type=NTP`、也启动不了服务（均"拒绝访问"）；
   **且仅打开"自动设置时间"不够**——服务启动类型仍是 `Disabled`，必须由管理员改成**按需启动**：
   `sc.exe config w32time start= demand` 再 `net start w32time`。
   **`sc` 与 `sc.exe` 不能混**：cmd 里 `sc` 就是服务控制程序，但 PowerShell 里 `sc` 是 `Set-Content` 的别名，
   必须写 `sc.exe`（或改用 `Set-Service w32time -StartupType Manual`）。
   **不影响本轮判定，但关闭 Stage 8B 前必须处理完。**
   【2026-11-07 后注】该项**已恢复**：`Parameters\Type = NTP`、`w32time = Running / Manual`，
   并于 **2026/11/07 21:26:37** 成功对时一次（`Leap 0(无警告)`、`层次 5`、源 `time.windows.com,0x9`）。
   过程与完整回读证据见 `docs/STAGE8B_REPORT.md` §9.6。以上正文为记录当时状态，未改动。
2. R2（绝对精度）仍未测；8 小时只覆盖 `en=1` + 单一静置输入；温漂/慢性资源增长只到"8 小时未体现"。
   【2026-11-07 后注】R2 已于同日 20:18–20:27 单独实测（与 8B-3 无关，本记录不涉及该项），
   记 **部分关闭**：零点 PASS、满量程 1.66 %FS 点估计超门槛而区间跨门槛，
   见 `CALIB_ABSOLUTE.md` §6、`TEST_REPORT.md` §21。以上正文为记录当时状态，未改动。

## 10. 归档

```
docs/SOAK_480MIN_20261105_X.txt
  77,875 B   SHA-256 cea4c8f50f23f1847c54b91ffe12b484d1be75f3aeedcc4298422c714bf0a76f
  改名前后哈希一致（改名前同值），mtime 2026-11-06 07:10
  soak.py 固定写 docs/SOAK_480MIN.txt，结束时改名为本文件；下次起跑会重新生成同名文件
```

## 11. 能证明 / 不能证明

**能**：该构建在诊断开启态连续 8 小时无复位（BOOT 0）、无链路中断、无采样环溢出、
无帧错误/ADC 错误/UART 错误、无可分辨序号缺口；采样率与时基均在设计容差内。

**不能**：不能证明绝对电压精度（R2 与本轮无关；该测项已于 2026-11-07 单独实测、记 **部分关闭**——
零点 PASS、满量程 1.66 %FS 点估计超门槛而区间跨门槛，见 `CALIB_ABSOLUTE.md` §6、`TEST_REPORT.md` §21）；
不能证明真实传感器失效场景（R19 只有电位器）；
不能把"未检出缺口"说成"绝对零丢失"（8 位序号盲区）；不能外推到 `en=0` 之外的其它配置
（`en=0` 已有 8B-2 的独立结论）。
