zoumingjie124-ui/single-channel-acquisition/docs/SOAK_480MIN_RECORD.md

# Stage 8B-2 连续运行记录：诊断关闭 8 小时（480 min）

> **本文件为人工整理**，数字全部取自原始日志 `docs/SOAK_480MIN_20261104_N.txt` 的「合计」段、
> 479 条每分钟打点、以及 soak 结束后立即读取的终点 STAT/DIAG。
> 起点与 reset 前后计数另见 `docs/STAGE8B2_START.txt`（含 pre/post_reset 对照）。

---

## 0. 环境与基线

```
port=COM5  duration=480 min  开始 2026-11-04 23:28:21
结束 2026-11-05 07:28:21（实测 28800.0 秒）
```

| 项 | 值 |
|---|---|
| 串口 | COM5 \| USB-SERIAL CH340 \| VID:PID=1A86:7523 \| LOCATION=**1-2.1.3** |
| 固件 | **Code=22468** RO-data=1076 RW-data=148 ZI-data=4972（2026-11-03 23:14 烧录 Verify OK，此后未重烧） |
| 诊断 | **en=0（关闭）**，起点与终点一致 |
| 起点基线 | `reset` 清零后：`frm=0 fe=0 uart=0 cmd=0/0 drop=0`，`uptime0=166805 ms @ 23:26:07.236`，`conf0=0` |
| 主机 | 睡眠 0/0、休眠 0/0、USB 选择性暂停关；更新活动时间临时改为 22:00–15:00（避免自动重启） |

## 1. 合计总账（原始日志原文）

```
===== 合计（28800.0 秒）=====
收到字节      : 50229097  (1744.1 B/s)
SAMPLE 帧     : 2880109  (100.00 Hz)
STAT 帧       : 28801  (1.00 Hz，设计 1.00 Hz)
EVENT 帧      : 0
drops         : 0
frame_err     : 0
adc_err       : 0
uart_err      : 0
rx_err        : 0
状态切换      : 0
设备运行时间  : 29101000 ms
seq8 缺口     : 0   (样本级)
整帧丢失      : 0   (帧级)
解析错误      : 0
BOOT 帧       : 0   (0 表示中途没有复位)
链路中断次数  : 0
```

## 2. 打点

**479 条**，覆盖 60 s – 28740 s，每分钟一条。
479 而不是 480，是 `soak.py` 的循环逻辑决定的：`while` 开头先判 `elapsed >= total` 再决定是否打点，
到 28800 s 时直接退出，因此不写第 480 个点。**不是丢了一分钟的数据。**

### 2.1 ΔSAMPLE 分布（478 个区间）

| 区间 ΔSAMPLE | 次数 | 说明 |
|---|---|---|
| 6000 | 89 | 标称 |
| 6001 | 373 | 打点与帧流边界错位 |
| 6002 | 15 | 同上 |
| **5705** | **1** | 仅 7200 s → 7260 s |

最小值 **5705**、最大值 **6002**、均值 **6000.23**；**477/478 落在 6000–6002**。

唯一偏低区间 `[7260s]`：**ΔSAMPLE = 5705**（比 6000 少 **295**、比 6001 少 **296**）、**ΔSTAT = 57**（少 3）；
该分钟的 `drops / frame_err / seq8 缺口 / 整帧丢失 / 解析错` **全部为 0**。

**不能写成链路丢帧**：若真丢 296 帧，8 位序号缺口应为 `296 mod 256 = ` **40**，实测 **0**；整帧丢失也是 0。
这是一次**计数台阶**，不是通信丢帧。

分段偏移拟合：前段 **100.014031 样本/s（140.3 ppm）**、后段 **100.014084 样本/s（140.8 ppm）**，
两段斜率一致；两条直线外推到 7260 s 处相差 **−295.5 个样本 ≈ −2.95 s**。

**结论：观察到一次计数台阶（≈ −2.95 s），判定为「主机侧时钟前跳（NTP 校时）」。**
依据：① Windows 事件日志 `2026-11-05 01:28:27` 系统时间被 `svchost.exe` 前跳 **+2950 ms**；
② 该事件落在 `7200→7260 s` 区间内（elapsed ≈ 7206 s）；③ H11 推演——若为设备停顿而 uptime 照走，
残差应约 4.07 s，实测 1.12 s；④ `soak.py` 计时用墙钟 `time.time()`（L65/L76/L164），
墙钟前跳会使打点提前触发、`dur` 同步拉长。
**不写"已证实"**：因日志未保存逐帧 STAT 的 `t_ms` 原文，无法直接从帧流核对该分钟的设备侧时长，
故维持四项证据的合取推断。
`台阶前后 STAT 运行时间是否连续` **无法检查**（原始帧未保存）——该项保持 **OPEN**。
详见 `STAGE8B_REPORT` §8.3.1 / §8.3.2。

区间内 `5705` 相对 `57 s × 100 Hz = 5700` 的 **+5**，属**打点边界量化**，**不用来解释漂移**。

总账：8 小时按 140 ppm 漂移应得 **+403** 个样本，减去台阶 **−295**，得 **+108**；
实测累计 `2874109 − 2874000 = +109`，差 1 个样本，落在打点边界量化范围内。

## 3. 判定（门槛见 `docs/SOAK_PLAN.md` §2）

| 编号 | 指标 | 实测 | 门槛 | 判定 |
|---|---|---|---|---|
| H1 | SAMPLE 频率 | **100.0038 Hz**（2880109 / 标称 28800.0 s） | 100.00 ± 0.10 | **PASS** |
| H2 | STAT 频率 | **1.0000 Hz**（28801 / 28800 s） | 1.00 ± 0.05 | **PASS** |
| H3 | drops | 0 | = 0 | **PASS** |
| H4 | frame_err | 0 | = 0 | **PASS** |
| H5 | adc_err | 0 | = 0 | **PASS** |
| H6 | uart_err | 0 | = 0 | **PASS** |
| H7 | seq8 缺口 | 0（8 位可分辨范围内） | = 0 | **PASS** |
| H8 | 整帧丢失 | 0（同上） | = 0 | **PASS** |
| H9 | BOOT 帧 | 0 | = 0 | **PASS** |
| H10 | 链路中断 | 0 | = 0 | **PASS** |
| H11 | 时基偏差（uptime 口径） | **0.0039 %** | < 0.1 % | **PASS** |
| H12 | 解析错误 | 0 | = 0 | **PASS** |

**H1–H12 全部 PASS。**

> **H1 的表观值与真实物理时长**：H1 仍按 `2880109 / 标称 28800.0 s = 100.0038 Hz` 判定（PASS）。
> `soak.py` 的 `dur` 取自墙钟，被 **+2.95 s** 时钟前跳拉长；按**真实物理时长 28,797.05 s**
> （= 28800.0 − 2.95）折算为 **100.0140 Hz**，与 §2.1 拟合的 **140 ppm** 斜率一致
> （`100 × 1.00014 = 100.0140`）。即 **100.0038 Hz 是被前跳压低的表观值**，
> 跨轮次比较 H1 时需注意；1 小时轮（≈100.014）更接近真实速率。

### 3.1 H11 正式计算

```
T0  uptime0 =   166805 ms  @ 2026-11-04 23:26:07.236   （reset 后基线）
T1  uptime  = 29130168 ms  @ 2026-11-05 07:28:49.479   （终点 STAT）
Δuptime = 28963363 ms
Δwall   = 28962243 ms
差值    = +1120 ms
偏差    = |Δuptime − Δwall| / Δwall = 0.0039 %   门槛 < 0.1 % → PASS
```

> **精度声明**：终点 `uptime` 取自 1 Hz 的 STAT 帧，存在约 **±1 s** 的量化误差，
> 对应 ±0.0035%，与本处 1120 ms 的残差同量级。因此本项只声称"时基偏差 < 0.01% 量级"，
> **不宣称得到精确到毫秒的 HSE 偏差**。
>
> **对 0.0039 % 的分解（原"原因未查"已撤回）**：对累计 SAMPLE 做分段偏移拟合，**7260 s 台阶前后斜率均约 140 ppm**，
> 台阶约 **−295 个样本（≈2.95 s）**；`140.5 ppm（拟合值）× 28962 s ≈ 4.07 s`，减去台阶 ≈ **1.12 s**，与实测 `+1120 ms` 吻合。
> 取整说明：按 **140 ppm** 取整为 `4.05 s`（差 0.02 s），差别仅来自 ppm 取整；本节统一取 **4.07 s**。
> 即 **H11 的 0.0039 % = "140 ppm 真实速率差" ＋ "一次 −2.95 s 台阶"**；
> **1 小时的 Y / Y2 / X2 三轮 0.0142 % 才是 140 ppm 的直接体现**（11:24 那轮 0.0077 %）。
> 因此 **H11 不得跨轮次比较**：本轮的 0.0039 % 比 1 小时轮"好看"，是台阶抵消的结果，不是时基更准。
> **台阶侧别：主机侧时钟前跳（NTP 校时）**——依据事件日志 +2950 ms、时间对齐、H11 推演与墙钟计时基准
> （`STAGE8B_REPORT` §8.3.1 / §8.3.2）；**未写"已证实"**，`STAT 运行时间连续性` 仍为 **OPEN**。

## 4. 序号检测能力的边界（必读）

本轮 `frame_gap = 0`、`seq8_gap = 0`，按统一口径表述：

> 在当前 8 位序号检测能力范围内，未检出可分辨的序号缺口（`frame_gap` 与 `seq8_gap` 均受同一限制）。

边界说明：
- 两个指标都基于 **8 位**序号，差值按 `(x − exp) & 0xFF` 计算；
- 因此**单次连续丢失恰为 256 的整数倍**帧时，增量会被算成 0，无法识别；
- 该盲区是**每次间歇**层面的，不是累计层面（分两次各丢 128 帧仍会计出 256）；
- 由此，"未检出"**不等于**"绝对零丢失"，只能说"在可分辨精度内为零"。
- **打点层面的旁证（§2.1）**：若发生 256 帧的整倍丢失，某一分钟的 ΔSAMPLE 会比该分钟应有值低约 256 的整倍
  （标准 60 s 区间 ≈**5744**）。本轮唯一偏低区间是**台阶**而非丢帧（依据：`seq8 缺口` 与 `整帧丢失` 均为 0；
  若真丢 296 帧，序号缺口应为 `296 mod 256 = 40`），**未见无法解释的 256 整数倍缺口**；
  但若丢失恰好落在某个完整 60 s 区间内，Δt 与 ΔSTAT 都不变、序号也不留痕，**仍然不可识别**——所以本节措辞不放宽。

另需注意：`seq8 缺口` 与 `整帧丢失` 对同一个丢失的 SAMPLE 帧会**各计一次**，二者不可相加。
本轮两者同为 0，不涉及该问题；若将来出现非零，必须按 `frame_gap` 与 `seq8_gap` 分开解释。

## 5. 终点读数（soak 退出后 28 s 内读取）

```
读取时刻 2026-11-05 07:28:49.479
STAT   t=29130168ms n=2896724 drop=0 adc=0 uart=0 rxf=0 frm=0 chg=0 cmd=0/0 txd=0B
ERRSRC ore=0 fe=0 ne=0 pe=0 pto=0 rxrst=0/0
DIAG   en=0 state=0 conf=0 span=0 blk=0 unev=0 mask=0 rep=0
```

- `DIAG en=0` 与起点一致：本轮全程**诊断关闭**，未开启。
- `cmd=0/0`：本次 `stat` 读取未改变命令计数。

### 5.1 设备样本计数与日志帧数的对账（**已对账**）

| 项 | 值 |
|---|---|
| 基线 `n_base`（reset 后首次 STAT，23:26:07.236） | **388** |
| 终点 `n_end`（07:28:49.479） | 2,896,724 |
| `n_end − n_base` | **2,896,336** |
| 日志 `SAMPLE`（soak 期间） | 2,880,109 |
| 两端空档：reset→起跑 133.764 s ＋ 结束→读取 28.479 s | 162.243 s ≈ **16,224** 个样本 |
| `2880109 + 16224` | 2,896,333 |
| **残差** | **+3 个样本（≈30 ms）** |

**判定：对账成立。** 3 个样本的残差落在起跑时刻的**秒级分辨率**之内——日志头只记到秒
（`开始 2026-11-04 23:28:21`），±1 s 即 ±100 个样本。

另：日志「设备运行时间 **29101000 ms**」− 墙钟 **28800000 ms** = **301000 ms（301 s）**，
即**开机到起跑的先行运行时间**（boot ≈ 23:23:20 → 起跑 23:28:21），**不是漂移**，不参与样本对账。

> 更正说明：早前一版用"约 162 s × 100 Hz"粗算，得残差 391 个样本（≈3.9 s），
> 原因是**漏减了 reset 后的基线 `n_base = 388`**。计入基线后残差降为 3 个样本，
> 原"暂不作为独立验收依据"的保留意见随之撤销。

## 6. 证据等级

- **板级实测**，**统计级证据**（soak 的统计 + 每分钟打点 + 终点 STAT/DIAG 文本行）。
- **不是字节级全量验证**：原始二进制帧流未落盘，无法事后重放或逐帧复算。
- 覆盖范围：1 条链路、1 台主机、1 个构建（Code=22468）、诊断关闭状态、8 小时尺度。
- **已知限制（计时基准）**：`soak.py` 用**墙钟** `time.time()` 计时（L65/L76/L164），
  长跑中遇到 NTP 校时会在打点里留下**计数台阶**。本轮实际出现一次（**+2950 ms**，见 §2.1）。
  **本脚本未修改**；建议长跑前**关闭 Windows 自动校时**，或跑完后对照 `Time-Service` / `Kernel-General`
  事件日志再解读打点。

## 7. 归档

| 项 | 值 |
|---|---|
| 文件 | `docs/SOAK_480MIN_20261104_N.txt` |
| 大小 | **77,875 B** |
| SHA-256 | `6e64b28120f59d46957eb286d737d70d0114cea6c0012898a3c9687ddb3de989` |
| 改名 | 由 `docs/SOAK_480MIN.txt` 改名而来，内容未编辑、未重新生成；改名前后大小与 SHA-256 完全一致 |

## 8. 本轮能证明 / 不能证明

**能证明**：
- 该构建在**诊断关闭**状态、8 小时、单一链路条件下，未出现丢点、丢帧、解析错误、复位或链路中断；
- 采样率与 STAT 频率在 8 小时尺度上保持设计值；
- 时基偏差 < 0.01% 量级（口径见 §3.1）。

**不能证明**：
- **本记录只覆盖 `en=0`（诊断关）**；诊断开启态（`en=1`）的 8 h 已于 2026-11-06 完成并通过，见 `docs/SOAK_480MIN_RECORD_8B3.md` 与 `STAGE8B_REPORT.md` §9（原句写"仍未完成"，2026-11-07 更正）；
- **R2 绝对电压精度**：本记录不涉及；该测项已于 2026-11-07 实测并记 **部分关闭**（零点 PASS、满量程 1.66 %FS 点估计超门槛、区间跨门槛），见 `CALIB_ABSOLUTE.md` §6、`TEST_REPORT.md` §21；
- 不能写成"项目全部 8 小时稳定性验证通过"——本次只覆盖 **en=0** 一种配置；
- 不覆盖温漂特性、不含真实传感器（R19）、不含 TX 环真实满载（R15）。
