zoumingjie124-ui/single-channel-acquisition/docs/STAGE8_PLAN.md

# Stage 8 计划：系统可靠性与硬件验证收尾（审查 + 方案设计）

> 建立时间：2026-11-03 23:4x
> **修订：2026-11-04（范围收敛，依据用户决策；决策清单见 §10.1）**
> **本文件只做审查与方案设计。本轮未执行任何测试，未修改任何 C 源码 / 头文件 / Python / 协议 / 配置 / GUI。**
> 上一轮基线：`docs/STAGE7C2_FINAL.md`（四层证据分级）、`docs/TEST_INVENTORY.md`（R1–R21）。

---

## 1. Stage 8 总体目标与最终范围（2026-11-04 收敛版）

把"软件层已验证"和"板级已验证"之间最后一段**最有价值、成本最低**的空档补上。
Stage 8 的产出只有**测试记录 + 判定结论 + 风险状态更新**，不应有新功能代码。

### 1.1 最终范围

| 序 | 项 | 补哪条风险 | 性质 | 预计耗时 |
|---|---|---|---|---|
| 1 | **R2**：万用表测 VDDA、3.3V 轨、1.65V 中点 | R2 | **必做** | 约 10 min |
| 2 | **8D**：GUI 真板联动 | R21 | **必做** | 约 30 min |
| 3 | **8B**：诊断**使能态**长跑，先 1 h，再 8 h；结束后查 `stat` | R3 + R20 | **必做**（1 h 通过才跑 8 h） | 1 h + 8 h |
| 4 | **8A**：TX 环满载恢复 | R15 / R16 | **可选**：仅在 1–3 全部完成且有余力时执行 | 约 20 min |

### 1.2 明确不做

- 不采购真实传感器、信号源、100 kΩ 偏置电阻；**R19 保持 NOT TESTED**，写入 §7.5 已知限制。
- **R1、R17 保持现有未验证状态**，不额外设计测试，不得标记 PASS。
- 不新增测试阶段；不扩大项目功能；不加故障类型；不改检测算法 / 阈值 / 协议帧 / 采样链路。
- 不修改固件、不修改 `soak.py`、不修改 GUI、不修改 `APP_TX_RING_SIZE`、不新增脚本文件。
- 原 Stage 8C（真实传感器故障验证）整体取消，见 §5。

### 1.3 证据分级口径（全文统一使用）

| 缩写 | 含义 | 能不能写"验证通过" |
|---|---|---|
| **设计审查** | 读代码推演行为，未运行 | 只能写"设计上成立" |
| **代码审查** | 逐行核对实现，未运行 | 只能写"实现与设计一致" |
| **单元测试** | GCC/Python 在 PC 上跑真实源码 | 只能写"PC 层通过" |
| **PC 测试** | 上位机/脚本在 PC 上跑（含离屏界面） | 只能写"PC 层通过" |
| **板级测试** | 真实 STM32F103C8T6 + 真实电气输入 | 才能写"板级通过" |

> 上一轮的教训写在 `STAGE7C2_FINAL.md` §3：`UNIT PASS` 与 `CODE REVIEW PASS` 都不是板级证据。

---

## 2. 当前测试基线（引自仓库现状，非估算）

### 2.1 代码与资源

| 项 | 值 | 出处 |
|---|---|---|
| Release 固件 | `Code=22468 RO=1076 RW=148 ZI=4972`，0 Error 0 Warning | `UV4 -r` 实测（2026-11-03 23:22） |
| 固件 C 单测 | **1041 断言 / 0 失败**（GCC 编译仓库真实源码） | `fw_tests` |
| 上位机单测 | **72 项 OK** | `host/tests` |
| 界面离屏冒烟 | PASS（含 10 项联动断言） | `host/tests/gui_smoke.py` |
| 采样链路 | 100 Hz；1 小时长跑 360047 帧 = **100.010 Hz**，drops/丢帧/错误/复位/重连全 0 | `TEST_REPORT` §17 |

### 2.2 已取得的板级证据（只有这些可以叫"板级"）

| 项目 | 证据 |
|---|---|
| 基础链路 10 min | 60117 帧 / 100.01 Hz / drops 0 |
| 零点 / 满量程 | +1.75 mV / 3299.87 mV，跨度误差 −0.057% |
| Stage 1 ADC 故障恢复 | 20 次注入 17 次恢复（**注入的是标志，非电气故障**） |
| Stage 2 线性 / 延迟 | 16/16 段单调；群延迟 40 ms |
| Stage 3 UART/DMA 异常 | 9 用例；半帧连锁缺陷已修；FE 风暴真实电气 |
| 加固 A/B | 接收停摆 152 ms 救回，3 分钟 9 次全成 |
| 1 小时长跑 | 12 项门槛全 PASS |
| 7B 默认关闭态 | 10 分钟长跑 PASS（**不含诊断使能态**） |
| 7C 故障确认/恢复 | 3.02 s 确认；人手拧动 `span=187 mV` 恢复 |
| 7C 非法命令 / 关闭语义 | `enable=2`、`LEN=2` 被拒；`diag off` 期间 0 帧 FAULT |
| 7C-2 快照 / 断线重连 | ACK 先于快照；断线期"恢复→再确认"由快照给出真相；57 帧 `active=0` |
| 7C SEQ 一致性 | 915 帧 / 914 间隔异常 0，跨 255→0 回绕仍连续 |

### 2.3 未验证项（R1–R21 现状，逐条不遗漏）

| 风险 | 内容 | 现状 | Stage 8 处理 |
|---|---|---|---|
| R1 | 真实 HAL 重挂失败（`start_rx` 返回 BUSY） | 只有代码审查 | **保持未验证**，不设计测试，不得标 PASS（§7.1） |
| R2 | 绝对电压精度 | **已执行（2026-11-07）→ 部分关闭**（见 `CALIB_ABSOLUTE.md` §6） | **必做**（§7.2） |
| R3 | 8 小时稳定性 | 仅 1 小时 | **必做 8B**（1 h → 8 h） |
| R15 | TX 环真实满载后的重试 | UNIT PASS / NOT TESTED | **可选 8A** |
| R16 | 100 ms 重试节流（板级） | UNIT PASS | **可选 8A**（与 R15 同场） |
| R17 | 多故障快照 | UNIT PASS（固件只有一种故障） | **保持未验证**，不得标 PASS（§7.3） |
| R18 | 队列检查与写入并发 | CODE REVIEW PASS（Stage 8 **不改变**其等级） | **保持 `CODE REVIEW PASS`**；8A **不构成** R18 的验证证据（§7.4） |
| R19 | 真实传感器诊断 | NOT TESTED | **不做**，写入已知限制（§7.5） |
| R20 | 诊断开启 1h/8h | NOT TESTED | **必做 8B** |
| R21 | GUI 点按钮连真板 | NOT TESTED | **必做 8D** |

> 其余 R4–R14 不变。原 8C 取消后，R4（阈值附近滞回手感）不再有顺带覆盖，保持未验证。

---

## 3. Stage 8A：TX 环真实满载恢复（可选）

> **执行条件**：R2、8D、8B（1 h + 8 h）全部完成且有余力。
> **顺序**：放在 8B 之后。8A 会让 SAMPLE/STAT 等帧被丢并留下 SEQ 跳号，放最后不会污染长跑结论。
> **执行前**先发 `reset` 清零计数（对应 §3.3 步骤 0）。

### 3.1 代码审查结论（先给结论，再给依据）

**投递链路**（`App/Src/app_tx.c` + `app_fault.c` + `app_task.c`）：

| 环节 | 实现 | 关键数字 |
|---|---|---|
| 环形缓冲 | `s_ring[1024]`，`head`/`tail` 只在主循环改 | 容量 1024 B，留 1 空位区分满/空 → 可用 1023 B |
| 入队 | `app_tx_write()`：空间不足则**整包丢弃**并累加 `s_drop_bytes`，返回 0 | 绝不写半帧 |
| 出队 | `app_tx_poll()`：一次搬 `n ≤ 128 B` 到 `s_stage`，`s_busy=1`，启动 DMA | `APP_TX_STAGE_SIZE = 128` |
| 完成 | `app_tx_on_cplt()` / `app_tx_on_error()` 清 `s_busy` | 只有这两个入口能清 |
| FAULT 提交 | `app_fault_service()` 三道闸门：已对齐不发 → 队列无空间不发 → 100 ms 节流 | 空间判据 `free_b ≥ PROTO_MAX_FRAME(47)` |
| 帧长 | FAULT = 5+9+2 = **16 B**；SAMPLE 17 B；STAT 44 B；ACK 9 B | `PROTO_HEADER_LEN=5` |

**结论 1：普通帧会烧 SEQ，FAULT 不会。**
`emit_frame()`（SAMPLE/STAT/EVENT/ACK/BOOT/快照）是"先取号、再入队、结果 `(void)` 丢掉"，
所以**环满时普通帧会被丢弃并留下一个 SEQ 空洞**——这正是上位机"整帧丢失"检测的工作方式，属设计内行为。
而 `fault_emit()` 走的是 `app_fault_service()` 的闸门②，**在取号之前**判断空间，所以正常情况下不会烧 FAULT 的号。

**结论 2：闸门②与真正写入之间没有并发生产者。**
`app_cmd_poll()`（步骤 1）在主循环**先于**该块执行，`process_sample()` 的 SAMPLE 也在步骤 2；
块内只有 `service()` 与快照两次 `app_tx_write`，二者用"留 47 B 余量"（16+16 < 47）保证第二次也写得进。
**ISR 不产生任何入队**（`s_busy` 只被中断写 0），所以"检查成功但写入失败"在现有结构下不会发生。
→ 与 R18 的 `CODE REVIEW PASS` 一致。

**结论 3（代码审查备注）：`s_busy` 依赖 TxCplt / ErrorCallback 清除，缺少超时兜底。**

- `app_tx_poll()` 在 `s_busy=1` 时直接 return；`s_busy` 只由 `app_tx_on_cplt()` / `app_tx_on_error()` 清除。
- **若这两个回调丢失**，TX poll 会持续提前返回，环不再排空，所有输出（SAMPLE / STAT / 文本 / FAULT）静默停摆，且没有计数器能反映。
- 标注：**CODE REVIEW FINDING / NOT TESTED**。
- 这是读代码推演出的**设计缺口**，**不是已观测到的故障**：本项目现有测试中没有出现过回调丢失，也没有证据表明会出现。**不得描述为已发生。**
- 处理：不新增风险编号、不修改固件、不新增测试；已登记于 `TEST_INVENTORY.md` §5.2。
- 8A 若执行，仍保留"结束后 `s_busy` 回到 0（若可读）"一项（见 A-7），作为旁证，而非专项验证。

### 3.2 如何安全制造真实满载（不需要改配置）

**先说不可行的三条**（写下来避免执行时走弯路）：

| 想法 | 为什么不行 |
|---|---|
| 拔掉 USB-TTL | 拔掉后 CH340 断电，但 STM32 的 USART **不检测对端是否存在**，TX 照常移位、DMA 照常完成 → 环照样排空。而且拔掉后也无法观测 |
| 让 CH340 停止接收（RTS/流控） | 当前配置**未启用硬件流控**，RTS 不起作用 |
| 降低波特率 | 属改配置，且会同时破坏上位机链路 |

**可行方案：用"命令放大"把环灌满。**
一条文本 `stat\r\n` 只有 6 B 上行，但设备回复 ≈ **254 B**（STAT 帧 44 B + `STAT` 行 ~90 B + `ERRSRC` 行 ~50 B + `DIAG` 行 ~70 B）。

| 量 | 数值 | 说明 |
|---|---|---|
| 正常下行占用 | ≈1744 B/s | SAMPLE 17 B × 100 Hz + STAT 44 B × 1 Hz（与 1 小时长跑实测 1744 B/s 吻合） |
| 链路上限 | 11520 B/s | 115200 8N1 |
| 灌命令后（每 10 ms 一条） | 100 × 254 ≈ **25.4 KB/s** | 远超 11.5 KB/s |
| 净填充速度 | ≈ 25.4 − 11.5 ≈ **13.9 KB/s** | — |
| **灌满 1023 B 所需** | **≈ 74 ms** | 设计推演值，实测以 `txd=` 增长为准 |

> 这是**设计推演，不是实测**。执行时以 `stat` 的 `txd=` 字节数开始持续增长作为"已满"的客观标志。

**副作用（必须预告，不是失败）**：灌满期间 SAMPLE 帧会被丢弃 → 上位机看到 **SEQ 跳号 / 整帧丢失增长**，
这是设计内行为；`drops`（设备端 ADC 环溢出）必须仍为 0，两者不是一回事。

**不改 `APP_TX_RING_SIZE`**（本轮决策）。`HW_VERIFY_NEXT.md` H1 中"改环大小为 64 / 256"的建议被本方案取代；该文件本轮未修改，执行时以本文件为准。

### 3.3 执行步骤（零固件改动）

前置：板子在线（端口先查，见 `README.md` §5.1）、PA1 接电位器、烧的是正式版 `Code=22468`。

> **串口会话约束（硬性）：全程只允许“一个进程、一个串口会话”，由它同时负责发灌命令与收帧解析。**
> 串口是独占资源：`diag_watch.py`、GUI、`soak.py` **都不能与本步骤同时打开同一个口**，
> 第二个进程要么打不开，要么把前一个挤掉——两种都会让"谁在收帧"变得不可解释。
> 因此本阶段的灌命令**不能用"一边 `python -c` 灌、一边 `diag_watch.py` 抓"的两进程方式**。

| 步 | 动作 | 观察点 |
|---|---|---|
| 0 | 发 `reset` 清零计数，`stat` 记录基线 | `drops/adc/uart/frm/txd` 全 0 |
| 1 | `SET_DIAG 1`，保持电位器不动 | 约 3 s 后 1 帧 FAULT `event=1 active=1`；`stat` 的 `DIAG` 行 `mask=1 rep=1` |
| 2 | 用**同一个脚本会话**一边灌 `stat\r\n`（每 10 ms 一条，持续 4 s）一边解析收到的帧 | `txd=` 开始增长 = 环已满；此阶段应**收不到任何 FAULT 帧** |
| 3 | **在灌命令的同时**缓慢来回拧电位器 3 s（制造"恢复"边沿） | 设备内部 `active` 应变为 0，但因环满 `reported` 停在 1 |
| 4 | 停止灌命令，静置 1 s | 恢复后应收到**恰好 1 帧** FAULT `event=2 active=0` |
| 5 | `stat` 核对 | `mask=0 rep=0`（拉平）；`txd=` 停止增长 |
| 6 | 保持静止 3 s | 收到 1 帧 `event=1 active=1`（重新卡死），`mask=1 rep=1` |
| 7 | 可选（调试器）：暂停内核读 `s_ctx.fault` | `commit_cnt` 增量 = 观测到的 FAULT 帧数；`retry_fail` 见判定表 |

**工具**：

- **一个 `python -c` 会话同时完成"灌"与"收"**：循环里先发一条 `stat\r\n`、再读走已到达的字节并解析，
  自己统计收到的 FAULT 帧与 SEQ 缺口。**不要**再并行调用 `diag_watch.py`（会抢同一个串口）。
- `host/tools/diag_watch.py` 仍可用于**不需要灌命令**的场合（例如 8D 前的手工观察），但**不参与本步骤**。
- 灌命令使用**一次性 `python -c`**，不入库、**不新增脚本文件**。
- **完整命令及全部参数（端口、命令内容、间隔、条数 / 持续时间）必须原样写在 `docs/STAGE8A_TX_FULL_RAW.txt` 的开头**，保证可复现。

### 3.4 记录要求

- 原始抓帧日志 `docs/STAGE8A_TX_FULL_RAW.txt`（输出重定向落盘，**不许手抄**；**文件开头写入完整 `python -c` 灌命令及参数**）；
- **会话记录：全程只有一个进程打开串口**（写明进程名/命令，并记下开跑前后 `list_ports` 结果，证明没有第二方占用）；
- 灌命令的时间窗、命令条数、`txd=` 起止值；
- 每次 `stat` 的原文（含 `DIAG ... mask= rep=`）；
- 若用调试器，记录暂停时刻的 `active/reported/commit_cnt/retry_fail/s_busy`。

### 3.5 通过标准（全部满足才算 PASS）

| # | 判据 | 期望 | 依据 |
|---|---|---|---|
| A-1 | 灌满期间收到的 FAULT 帧数 | **0** | 环满则发不出 |
| A-2 | 恢复后提交的 FAULT 帧数 | **恰好 1**，`event=2 active=0` | 状态差驱动，只提交最新 `active` |
| A-3 | 提交延迟 | 停灌后 **≤ 200 ms** | 100 ms 节流 + 主循环周期 |
| A-4 | `rep` 追上 `mask` | 停灌后 **≤ 1 s** | 同上 |
| A-5 | 采集未受影响 | `drops=0`、`adc_err=0`、`uart_err=0` | 拥塞不得反噬采集 |
| A-6 | 重新卡死 | 静置 3 s 后 1 帧 `event=1`，`mask=rep=1` | 可重复触发 |
| A-7 | 结束后 `s_busy`（若可读） | **仅记录，不参与判定** | 见下方说明，单次读数不足以证明"没发生过停摆" |
| A-8 | （可选）`retry_fail` | 增量 **0** | 闸门②在取号前生效的直接证据 |
| A-9 | 灌满窗口**之外**的 SEQ 跳号 | 停灌 ≥ 1 s 后 **0 新增** | 窗口内跳号属设计行为，窗口外不应有（见 §3.6.1） |

> **A-7 的结论强度（刻意压低，不接受反驳式引用）**
>
> `s_busy` 得靠调试器暂停内核或实时变量观察才能读到，**读取动作本身会改变时序**；
> 而且"结束时读到 0"只能说明**此刻**没卡住——它**不能排除**中途丢过一次完成中断、
> 随后又被下一次回调把标志清回 0（`s_busy` 只有一个 bit，看不出历史）。
>
> 因此：A-7 **只作为旁证记录，不计入 PASS / FAIL**，**也不能用来关闭 §3.1 结论 3**。
> 该结论保持 **CODE REVIEW FINDING / NOT TESTED**（`TEST_INVENTORY` §5.2），
> 要关闭它需要的是"发送停摆检测 + 超时恢复"这类**设计变更**，不是一次读数。

### 3.6 失败判定

| 现象 | 判定 | 说明 |
|---|---|---|
| 恢复后 0 帧 FAULT，且 `rep` 一直 0 而 `mask` 为 1 | **FAIL：事件永久丢失** | 状态差模型失效 |
| 恢复后同一状态收到 ≥2 帧 | **FAIL：重复上报** | 拉平逻辑失效 |
| 灌满期间收到 FAULT 帧但 `rep` 未前进 | **FAIL：状态不一致** | — |
| 停灌 2 s 后 `rep` 仍未拉平 | **FAIL：重试未生效** | — |
| `retry_fail` 增量 > 0 | **FAIL（设计缺陷）**：闸门被绕过，SEQ 已白烧 | 说明检查与写入之间出现了生产者 |
| `drops > 0` 或 `uart_err > 0` | **FAIL：拥塞反噬采集** | — |
| 灌满窗口内出现 SEQ 跳号 | **不判失败**，按 §3.6.1 区分归因 | 帧头 SEQ 缺口数与 seq8 缺口数**分别记录** |

### 3.6.1 SEQ 跳号的区分处理（按现有设计；属设计推演，执行时以实测核对）

环满时 `emit_frame()`（SAMPLE / STAT / EVENT / ACK / BOOT）先取号、再入队、结果丢弃 → 整帧被丢，**帧头 SEQ 留下空洞**；FAULT 在取号前判断空间，**不烧号**（§3.1 结论 1）。
因此灌满窗口内出现跳号是设计内行为，**不得简单判为失败**。按下表区分：

| 现象 | 归因（推演） | 判定 |
|---|---|---|
| 窗口内 SAMPLE 的 seq8 出现缺口（同时帧头 SEQ 有缺口） | SAMPLE 帧在环满时被整帧丢弃 | 预期，记录，不判失败 |
| 窗口内帧头 SEQ 有缺口，**seq8 连续** | 被丢的是非 SAMPLE 帧（如 STAT / ACK） | 预期，记录，不判失败 |
| 窗口内收到 FAULT 帧 | 环满时不应发出 | **FAIL（A-1）** |
| 停灌 ≥ 1 s（环已排空）后仍持续新增 SEQ 跳号 | 不属于环满 | **需调查**；先排除上位机 / 串口端问题 |
| 设备 `drops` > 0 | ADC 环溢出，与 TX 环无关 | **FAIL（A-5）** |

### 3.7 风险与安全

| 风险 | 处理 |
|---|---|
| 灌命令导致接收环（256 B）溢出 | 每 10 ms 仅 6 B 上行（600 B/s），远离溢出；若 `rxf` 增长则降低灌速 |
| 长时间环满导致 TX 停摆不可恢复（§3.1 结论 3） | 单次灌满 **≤ 5 s**，结束后必须确认输出恢复（收到 SAMPLE/`stat` 有回应） |
| 电位器来回拧动误触发 WARN/CRIT | 拧动幅度控制在 NORMAL 区（< 2400 mV） |
| **电气安全** | 全程只用跳线与电位器，**不触碰 3.3V 与 GND 短接**；PA1 保持 0~3.3 V |

---

## 4. Stage 8B：诊断使能态长期运行（1 h → 8 h）（必做）

### 4.1 目标

证明"**诊断使能态**"下长时间运行不扰动采集链路、不出现计数异常。
（7B 的 10 分钟长跑是**默认关闭态**，不能代表使能态。）同时补 R3（8 小时）与 R20（诊断 1 h / 8 h）。

### 4.2 前置条件（缺一不可）

1. **关闭睡眠 / 休眠 / USB 选择性暂停**——命令见 `SOAK_PLAN.md` §9.1，**测完必须还原**（`SOAK_PLAN.md` §9.2）。
   原因：睡眠会让进程挂起、数据丢在 USB 层，而设备 `drops` 仍为 0 → 假干净（`TEST_REPORT` §17.3）。
2. `soak.py` 与 GUI / `diag_watch.py` / 串口助手**不能同时占同一个串口**。
3. 输入保持**不会自行跳变**的状态（电位器固定、无人碰线）。
4. 端口先查（CH340 会换号，见 `README.md` §5.1）。
5. 板上烧的是**正式版**（`APP_DEBUG_INJECT=0`）。
6. **工具不改**：`soak.py` 原样使用；不加每 5 分钟 DIAG 打点；不改固件。
7. 8 h 前先做 5 min 试跑，确认输出落盘到本地磁盘（不是 U 盘）。

### 4.3 步骤

**1 h（先做）**

| 步 | 动作 |
|---|---|
| 1 | 关睡眠，`powercfg` 确认（`STANDBYIDLE` 为 0），记录命令输出 |
| 2 | 电位器固定在 NORMAL 区，不再触碰 |
| 3 | 发 `reset` 清零计数；`stat` 保存**起点原文** |
| 4 | `SET_DIAG 1`；等约 3–4 s 至确认；`stat` 保存**基线原文**（记录 `en / state / conf / span / mask / rep`，记为 conf0） |
| 5 | **关闭**该串口工具（释放端口），立即启动 `soak.py 60 <端口>` |
| 6 | 结束后（`soak.py` 退出、端口释放）立即打开串口发 `stat`，保存**终点原文**（`conf / mask / rep / state / span / en`），并记录"soak 结束 → stat"的间隔时间 |

**8 h（1 h 全部判据通过后才做）**：同流程，`soak.py 480 <端口>`；终点同样只做一次 `stat`。

### 4.4 必测指标

| 类别 | 指标 | 来源 |
|---|---|---|
| 采集 | SAMPLE 帧率（100.00±0.10 Hz）、本段帧数 | `soak.py` 全程统计 |
| 采集 | `drops`、seq8 缺口、整帧丢失、解析错误 | `soak.py` |
| 设备 | `adc_err`、`uart_err`、`rx_err`、`frame_err`、`BOOT` 帧 | `soak.py` |
| 链路 | 重连次数、`uptime` 与时长的偏差（< 0.1%） | `soak.py` |
| **诊断（仅终点）** | `DIAG` 行：`en / state / conf / span / mask / rep` | 结束后一次 `stat` |
| 环境 | 室温（±3 ℃ 记录即可） | 人工 |

> 不统计 FAULT 帧总数：`soak.py` 不统计且本轮不改；也**没有**每 5 分钟的诊断打点。

### 4.5 通过标准

沿用 `SOAK_PLAN.md` 的 **H1–H12**（100.00±0.10 Hz、`drops=0`、`BOOT=0`、时基偏差 < 0.1% 等），另加（**均只针对终点 `stat`**）：

| # | 判据 | 期望 |
|---|---|---|
| B-1 | 终点 `en` | **1**（使能态保持；与 `BOOT=0` 互证未发生复位） |
| B-2 | 终点 `conf` 相对基线 conf0 的增量 | **0**（输入未动，不应有新确认） |
| B-3 | 终点 `mask` 与 `rep` | 相等（均为 1） |
| B-4 | 终点 `state` | 与基线一致（ACTIVE） |
| B-5 | 终点 `span` | 静置噪声量级（实测 8–12 mV），无异常大值（仅一个读数） |

### 4.6 失败判定

| 现象 | 判定 |
|---|---|
| 终点 `en ≠ 1`，或出现 `BOOT` 帧 | **FAIL**：使能态未保持 / 发生复位，该窗口作废，查原因后重跑 |
| 终点 `conf` 相对 conf0 增加 | **不判 PASS**：无过程记录，无法区分"输入被扰动"与"误报"；如实记为"未确定"，并标注操作情况 |
| 终点 `rep ≠ mask` | **FAIL**：提交链路停滞 |
| 任一门槛（H1–H12）失败 | **FAIL**，按 `SOAK_PLAN` 中止预案处理 |

### 4.7 风险

| 风险 | 处理 |
|---|---|
| 8 h 期间误触电位器 / 碰线 → 假边沿 | 电位器固定 + 桌面不碰；有扰动就在记录里标注时刻，不删数据 |
| 睡眠未真正关闭 | 开跑前后各查一次 `powercfg`；`uptime` 偏差 > 0.1% 即视为窗口被污染，重跑 |
| 8 h 过夜断电 / U 盘休眠 | 输出写本地磁盘；先做 5 min 试跑确认落盘 |
| 固定输入下终点 `conf` 增长 | 优先怀疑电位器接触噪声（R12），不当成"诊断已验证"，也不当成"诊断有缺陷" |
| 打开 / 关闭串口导致设备复位（DTR 触发） | 以 `BOOT` 帧与终点 `en` 判断，见 B-1 / §4.6 |

### 4.8 证据边界（必须原样写进结论）

- 终点 `conf / mask / rep` 只能证明**终点状态和累计计数**，**不能**证明 8 小时内每个时刻的诊断状态，**不能**声称做了每 5 分钟打点。
- 输入固定不动：诊断一直处于 ACTIVE，这证明的是"**稳态下状态保持、计数不增长**"，**不是**"无误报"，也不是误报率。
- 采集指标（帧率、丢点、错误计数）来自 `soak.py` 的**全程统计**；诊断指标**只有终点**。
- R19（真实传感器故障）仍未验证；`STUCK` 的适用边界见 §7.5。

## 5. 原 Stage 8C（真实传感器故障验证）：已取消

**决策（2026-11-04）**：不采购真实传感器、可编程信号源、100 kΩ 偏置电阻；原 8C 全部步骤（C-1 短接 GND、C-2 短接 3.3V、C-3 悬空观察、C-4 真实传感器）**均不在本阶段范围内，不执行**。

- **R19 保持 NOT TESTED**，作为已知限制写入 §7.5。
- 原 8C-1 / 8C-2 / 8C-3 属"可用现有硬件做"的观察实验，但**未被纳入最终范围**，此处不保留步骤，避免被误当作待办。
- 原 Stage 8C 的 §5.5（旧编号）中 `STUCK` 诊断的适用边界已迁移到 §7.5，保留此处说明。

## 6. Stage 8D：上位机真机联动（必做）

### 6.1 目标

把 `R21`（GUI 点按钮连真板）从 NOT TESTED 变成有记录。
现有 GUI 联动是**离屏软件模拟**（`gui_smoke.py`），真板路径从未点过按钮。

### 6.2 前置

- 串口**独占**：先关掉 `soak.py` / `diag_watch.py`；GUI 是唯一占用者。
- 端口先查（CH340 会换号）。
- 固件 `Code=22468`（带 `SET_DIAG`/`GET_DIAG`）。
- **8D 在 8B 长跑之前做**：GUI 与 `soak.py` 不能同时占串口。

### 6.3 步骤（每步都要截图 + 记日志行）

| # | 动作 | 期望 |
|---|---|---|
| D-1 | 打开 GUI，选端口，点"连接" | 顶部显示"已连接"；曲线开始走；**自动发出一次 `GET_DIAG`**（日志可见） |
| D-2 | 观察首次快照 | 若设备无故障：显示"无"；若有故障：显示 STUCK，且**不得**出现在"告警事件表"里 |
| D-3 | 勾选"使能诊断" | 收到 ACK OK；日志显示"故障诊断：使能（等 ACK 确认）" |
| D-4 | 保持电位器不动 5 s | 收到确认事件，当前故障显示"STUCK 卡死"（红），事件表出现一条"确认" |
| D-5 | 点"查询故障状态" | 先 ACK，再快照；界面状态不变（快照不产生新事件），日志区分"状态同步"与"事件" |
| D-6 | **取消勾选"使能诊断"**（此时故障仍是 ACTIVE） | ACK OK；面板显示"未使能"；设备内部 `active` **不清零** |
| D-7 | 紧接着点"查询故障状态" | 先 ACK 后快照，`active=0x01` —— 证明"关闭诊断 ≠ 故障恢复"；**本步不应出现恢复事件** |
| D-8 | 重新勾选"使能诊断" | ACK OK；状态仍为 ACTIVE；**不重复上报确认**（新增 FAULT 帧数 = 0） |
| D-9 | 缓慢拧电位器 5 s | 收到恢复事件，显示转"无"（绿） |
| D-10 | 断开串口（点断开或拔线） | 顶部提示断开；曲线停止；**不得崩溃** |
| D-11 | 断线期间拧电位器制造变化 | — |
| D-12 | 重新连接 | **自动发 `GET_DIAG`**；界面状态 = 设备当前 `active`（以快照为准） |
| ~~D-13~~ | ~~异常项：灌入未知帧类型/坏 CRC~~ | **移出真机范围**，见 §6.7 |

> **顺序为何必须是 D-6 → D-7 → D-8（在 D-9 恢复之前）**：
> "关闭诊断不清故障状态"只有在**故障仍处于 ACTIVE 时**关闭才可验证。
> 若放在恢复之后关闭，设备 `active` 已经是 0，查询只能得到 `mask=0x00`，
> 既不能证明"保留"，也测不出任何东西——**这是原顺序的错误，已修正**。

### 6.4 通过标准

判据编号与步骤编号**分开**（P = 判据，D = 步骤），避免"关闭诊断"一条被误读成某一步。

| # | 判据 | 对应步 | 期望 |
|---|---|---|---|
| P-1 | 连接后自动查询 | D-1 / D-12 | 日志中有 `GET_DIAG` 请求与 ACK |
| P-2 | 快照不冒充事件 | D-2 / D-7 / D-12 | 快照到达时事件表**不新增**行 |
| P-3 | ACK 与快照顺序 | D-1 / D-7 / D-12 | ACK 先到（上位机按 req_type 匹配，不应错配） |
| P-4 | 关闭诊断不清故障 | D-6 / D-7 | 界面"未使能"，查询仍返回 `active=0x01`；期间**无恢复事件** |
| P-5 | 重新使能不重复上报 | D-8 | 新增 FAULT 帧数 **= 0** |
| P-6 | 恢复后显示清除 | D-9 / D-12 | 显示转"无"；重连快照 `active=0` 时保持"无" |
| P-7 | 断线重连 | D-10 ~ D-12 | 无崩溃、无未捕获异常；重连后状态与设备一致 |
| P-8 | 采样不受影响 | 全程 | 100.0x Hz；`drops=0` |

### 6.5 失败判定

| 现象 | 判定 |
|---|---|
| 快照被当成"确认事件"写进事件表 | **FAIL**：语义错误，会误导操作员 |
| 重连后不自动查询 / 状态与设备不一致 | **FAIL** |
| 未知帧导致接收线程退出 | **FAIL**（严重）；仅适用于 PC 层验证，见 §6.7 |
| 点按钮导致 ACK 错配（把 SET_DIAG 的 ACK 算到 GET_DIAG 头上） | **FAIL** |

### 6.6 风险

| 风险 | 处理 |
|---|---|
| GUI 与脚本抢串口 | 开 GUI 前确认无其他进程占用（`handle` 冲突会报错） |
| 点"断开"后又点"连接"太快，驱动异常 | 间隔 ≥ 1 s；异常时拔插 USB 再试 |
| 截图与结论不符 | 截图只是辅助，判据以日志行为准 |

### 6.7 原 D-11 的处理

原 D-11（向 GUI 灌入未知帧类型 / 坏 CRC）需要注入脚本，且真板路径下 GUI 不会自然收到这类帧。本轮不新增脚本，故该项**移出 8D 真机范围**，**不计入 R21 的关闭条件**；只保留 PC 层已有证据（上位机单测 / 离屏冒烟），属 PC 层证据，**不得写成板级**。

---

## 7. 其他遗留项目

### 7.1 R1：真实 HAL 重挂失败（`usart_start_rx()` 返回 BUSY）

**保持现有未验证状态（仅 CODE REVIEW）。** 本轮不额外设计测试，**不得标记 PASS**。
此前评估过的几条制造路径均不可行，或属于"调试器注入"（证据性质不是真实失败），不再展开。对外表述按 `TEST_INVENTORY.md` §5.1 的"R1 当前正确说法"。

### 7.2 R2：绝对电压精度（必做）

需要万用表（**状态待确认**：型号 / 精度等级 / 电池）。步骤见 `docs/CALIB_ABSOLUTE.md`（P0 GND / P1 3.3V 轨 / P2 分压中点）。

**必须同时记录 VDDA 实际值**：固件把 3300 mV 写死，若 VDDA 实为 3.28 V，"满量程 3299.87 mV"恰恰说明误差被参考假设吸收，而不是 ADC 准确。

记录表（每点读数三次，写原始值，不手改）：

| 点 | 万用表读数 | 固件读数（同一时段均值） | 备注 |
|---|---|---|---|
| VDDA（或板上 3.3V 轨） | | — | 写明实际测量点 |
| P0：PA1 → GND | | | |
| P1：PA1 → 3.3V 轨 | | | 比例测量，应≈3300，不能证明绝对准确 |
| P2：1.65V 中点（分压） | | | 万用表同时测 P2 电压 |

判读（**计算，非测量**）：设万用表测得 VDDA = V_A，P2 真实电压 = V_2。

- 固件读数 ≈ V_2 / V_A × 3300：该值与固件实际读数之差 = 换算与 ADC 本身的误差；
- 固件读数与 V_2 之差 = "把 VDDA 当作 3.300 V"的假设带来的**绝对误差**。
- 两者**分开写**，不得混成一个"精度"数字。
- 容差在**测量之前**写定：建议 = 1 LSB（≈ 0.81 mV @ 3.3 V）+ 万用表读数不确定度；万用表精度待确认，容差数值待定。

关闭条件沿用 `TEST_INVENTORY.md` R2：VDDA、3.3V 轨、1.65V 点三项都实测并记录。对不上就如实记误差大小，**不得声称绝对准确**。

#### 7.2.1 VDDA 直接测量 vs 3.3V 轨代理测量（两者不能互替）

固件把参考电压写死为 3300 mV，所以"绝对精度"这个结论**完全依赖 VDDA 的真值**。测法不同，能下的结论也不同：

| 测法 | 测点 | 能证明 | 不能证明 | 能否作为 R2 的关闭依据 |
|---|---|---|---|---|
| **A. 直接测 VDDA** | MCU 的 VDDA 引脚，或与之**同网络**的测试点（板上引出的 VDDA 焊盘 / 跳线帽） | 参考电压真值 → 可把"换算误差"与"参考假设误差"分开算 | — | **可以**（测得准则成立） |
| **B. 3.3V 轨代理** | 排针 3.3V / LDO 输出 | 只说明**电源轨**的电压 | 不能证明 VDDA 与之等值：二者之间若有磁珠 / RC / 走线压降，**轨值 ≠ VDDA** | **不可以单独关闭**，只能给出误差**上界** |

- 只有**经确认 VDDA 与 3.3V 轨同网络**（0 Ω / 跳线直连且中间无滤波元件）时，B 才能**近似**当 A 用。
  依据必须写进结论（看原理图，或用万用表通断档实测导通），**不能默认"同源"**。
- 记法固定两种，不许混写：
  - A：`VDDA 实测 = ____ V（测点：____）`
  - B：`以 3.3V 轨代 VDDA = ____ V（未直接测 VDDA；同网络依据：____）`
- 误差换算（相对）：`相对误差 ≈ (V_实测参考 − 3.300) / 3.300`。
  用 B 时，这个数字里**混入了"轨 − VDDA 差值"这个未知量**，所以只能写"上界"，**不能写"精度"**。

安全：改线先断电；表笔不要同时碰相邻引脚；LQFP48 引脚间距只有 0.5 mm 级，
**不要用表笔直接探 MCU 引脚**——优先找板上引出的测试点；找不到就按 B 记录并注明"未直接测 VDDA"。
**R2 需要改 PA1 接线，不要与 8B 长跑同时进行。**

### 7.3 R17：多故障快照

**结论：在"只有一种故障"的固件上永远关不掉。**

- 生产路径只有 `STUCK` 一个位，快照的 `fault_id=0 + active=多bit` 分支走不到；
- 唯一办法是引入第二种故障类型——**属新增功能，本阶段明确不做**；
- 因此 R17 保持 `UNIT PASS`，并注明"**待第二种故障实现后再上板**"；**不得标记板级 PASS**。
- 不要为了让这条"过关"而用白盒置位冒充板级证据。

### 7.4 R18：队列检查与写入并发

**决策（2026-11-04）：保持 `CODE REVIEW PASS`，不升级为板级验证。**

- 理由：R18 问的是"**闸门②判过空间之后、`app_tx_write()` 真正写入之前**，有没有别的生产者插进来"——
  这是一个**代码结构问题**，板级观测看不到这个窗口。8A 把环灌满也不能直接证明它。
- 8A **若执行**，最好结果也只是"未观察到反例"（`retry_fail` 增量 0 属间接旁证），
  **不得**据此把 R18 标成板级 PASS，也不得改写 `TEST_INVENTORY` 里 R18 的 `CODE REVIEW PASS` 字样。
- 结论成立的前提是"入队只在主循环"这条约束；若将来把入队搬进 ISR，
  必须改为"以 `app_tx_write()` 返回值为准拉平 `reported`"，并重新评估 R18。

### 7.5 已知限制：R19 真实传感器故障诊断 NOT TESTED

- 手上只有电位器；"卡死"在电气上等价于"输入恒定"，**不能声称验证了传感器失效**。
- 不采购真实传感器 / 信号源 / 偏置电阻（决策，2026-11-04）。
- 真实传感器失效可能不被 `STUCK` 检出（例如漂移到轨、周期性抖动）。
- 报告里必须写"输入恒定"，**不得写"传感器故障"**。

`STUCK` 诊断的适用边界（原 Stage 8C §5.5，旧编号，现迁移至此）：

| 边界 | 说明 |
|---|---|
| 只对"**块内极差**"敏感 | 连续 3 个 1 s 块 `max−min < 50 mV` 才确认。**输入恒定 = 触发**，不管是"传感器坏了"还是"工艺真的稳" |
| **不区分故障种类** | 短 GND、短 3.3V、传感器卡死、正常稳态，只要电平不动都可能被判卡死 |
| 对"**慢漂移**"不敏感 | 每秒漂 > 50 mV 的缓慢失效不会被判卡死（属变化率类故障，本阶段未实现） |
| 对"**周期性抖动**"不敏感 | 传感器输出在 ±100 mV 周期抖动，块内极差大 → 不触发 |
| `STUCK_DELTA_MV=50 mV` **仍是待确定值** | 依据只有电位器静置实测峰峰 8–12 mV；真实传感器必须重新标定 |
| 断线**测不了** | 无上下拉，悬空读数不确定 |

---

## 8. 安全注意事项（全局）

| 类别 | 红线 |
|---|---|
| 电气 | PA1 仅 0~3.3 V；禁止负压/5 V；**3.3V 与 GND 禁止短接**；USB 与 ST-Link 3.3V 只接一路；改线必断电 |
| 数据 | 每项测试的原始日志必须落盘到 `docs/`，不许只留结论 |
| 结论 | `UNIT PASS` / `CODE REVIEW PASS` / 软件模拟 **不得**写成板级验证 |
| 长时间 | 8 h 前必须关睡眠；测后还原（`SOAK_PLAN` §9.2） |
| 端口 | CH340 无序列号，端口会变（烧录后尤其），每步先查 |
| 范围 | 不为"方便测试"给固件加后门；任何配置/代码改动先报批 |

---

## 9. 执行顺序与依赖

1. **R2** 万用表（不占串口，但需改 PA1 接线）
2. **8D** GUI 真板联动
3. **8B** 1 h 诊断使能态长跑 → 判据全部通过
4. **8B** 8 h 诊断使能态长跑（过夜）
5. **（可选）8A** TX 满载恢复 —— 仅在 1–4 全部完成且有余力时

**依赖说明**

1. 8D 在 8B 之前：GUI 与 `soak.py` 不能同时占同一串口；8D 零电气风险，也能先发现 UI 语义问题。
2. 8B 的 1 h 先于 8 h：1 h 是 8 h 的冒烟测试，避免白等一夜。
3. 8A 在 8B 之后：8A 会丢 SAMPLE / STAT 帧、产生 SEQ 跳号、让计数器增长；放在长跑之后不会污染"零丢帧"结论。8A 前先 `reset`。
4. R2 不与 8B 同时做：R2 要改 PA1 接线 / 断电，会中断正在跑的采集。

---

## 10. 决策、设备可完成性与待确认项

### 10.1 已确定的决策（2026-11-04）

| 项 | 决策 |
|---|---|
| 范围 | 必做：R2、8D、8B（R3 + R20）；可选：8A；其余不做（§1） |
| 8A 灌命令 | 一次性 `python -c`，不新增脚本文件；完整命令及参数记录在原始日志开头 |
| 8B 工具 | 不修改 `soak.py`；开始前 `SET_DIAG 1`，结束后 `stat`，保存终点 `conf / mask / rep`；不加每 5 分钟打点 |
| 固件 | 不修改固件；不修改 `APP_TX_RING_SIZE` |
| 硬件采购 | 不采购传感器 / 信号源 / 100 kΩ 电阻；R19 保持 NOT TESTED |
| R1 / R17 | 保持现有未验证状态，不额外设计测试，不得标 PASS |
| R18 | 保持 `CODE REVIEW PASS`，**不升级为板级验证**；8A 即使执行也不能改变其等级 |
| 8A 串口 | 只允许**一个进程 / 一个串口会话**同时负责灌命令与收帧，不得两进程并行占用 |
| `s_busy` 无超时 | 不新增风险编号 / 阶段；在 `TEST_INVENTORY.md` §5.2 登记为 CODE REVIEW FINDING / NOT TESTED（本文件 §3.1 结论 3） |

### 10.2 现有设备可完成性

| 项目 | 现有设备能否完成 | 缺什么 |
|---|---|---|
| R2 | 取决于万用表 | 万用表可用状态**待确认** |
| 8D GUI 真板 | ✅ 能 | 无 |
| 8B 1 h / 8 h | ✅ 能 | 一台整夜不休眠、不断电的机器（**待确认**） |
| 8A（可选） | ✅ 能 | 无（一次性 `python -c` 单会话同时收发；`diag_watch.py` 不参与本步骤） |
| R19 | 不做 | — |
| R1 / R17 | 不做 | — |

### 10.3 待确认清单（不虚构）

| 项 | 状态 |
|---|---|
| 万用表是否可用、精度等级 | **待确认** |
| 8 h 期间机器能否保持不休眠不断电 | **待确认**（先做 5 min 试跑验证落盘） |
| 板卡当前端口 | 上次实测为 **COM5**（会变，每步重查） |

---

## 11. 本轮自证

- 本次修订只改动两份文档：`docs/STAGE8_PLAN.md`（范围收敛修订）、`docs/TEST_INVENTORY.md`（新增 §5.2 代码审查备注；R15 行加指向）。
- 同日修订（2026-11-04，第二轮）：① 8D 的 D-6/D-7/D-8 顺序修正为"在恢复之前关闭诊断"，原顺序在恢复后关闭只能得到 `mask=0`，证明不了任何事；判据改用 P-1..P-8 与步骤号解耦。② 新增 §7.2.1 区分"直接测 VDDA"与"3.3V 轨代理"，后者不可单独关闭 R2。③ A-7 降为旁证、不计入 PASS/FAIL。④ 8A 明确单进程单串口会话，禁止 `python -c` 与 `diag_watch.py` 并行。⑤ R18 明确保持代码审查、不升级板级。
- 同日追加一处统一（2026-11-04）：`TEST_INVENTORY.md` 的 R15「现状 / 关闭条件」与 §5 指针原先仍写"没有可靠手段、需改环大小"，与本方案 §3.2 的「命令放大」矛盾，现已改为指向本方案，并注明 `HW_VERIFY_NEXT.md` 属上一版、勿按其执行。
- 同日修订（2026-11-04，第三轮）：同步修正 R18 复核表述、R2 的 VDDA/3.3V 轨测量判定条件，以及 R20 的 8B 长时间运行证据要求；仅更新文档，不涉及代码、配置、测试执行或测试结果。（对应 `STAGE8_PLAN.md` §1.1 / §2.3，`TEST_INVENTORY.md` R2 / R20 共 4 行）
- 未执行任何测试；未改 `App/` `Core/` `MDK-ARM/` `host/` 下任何源码与配置；未改 `PROTOCOL.md`、`README.md`、`TEST_REPORT.md`、`HW_VERIFY_NEXT.md`；未新增脚本；未删除任何既有记录与原始日志。
- 本文档内**没有**任何"已执行"的表述——所有数字要么标注出处（既有实测），要么标注"设计推演 / 待实测"。
