zoumingjie124-ui/single-channel-acquisition/docs/AUDIT_20261103.md

# 文档一致性与分层边界复核（2026-11-03）

> 起因：Stage 1–4 做完之后，文档还停在 v5.1.1 的叙述上（尺寸、"未验证"清单、目录结构都过期）。
> 本文件是这一轮**核对**的记录 + 逐条修正结果 + App/HAL 边界的判定。
>
> **本轮边界**：只改文档，固件一行没动。`git diff -- App Core` 为空可自证。
> 所有"实测"字样后面跟的数字，来源都是 Stage 1–4 已归档的日志，本轮**没有插板复测**。

---

## 0. 本轮实际执行了什么

| 动作 | 命令 | 结果 |
|---|---|---|
| 固件全量重编译 | `UV4.exe -r DataAcq.uvprojx -j0 -o build_check2.log` | `Code=21208 RO=996 RW=148 ZI=4916`，0 Error 0 Warning |
| 固件 C 单测（GCC 真实源码） | `gcc -std=c99 -Wall -Wextra -Werror -O2 ...` + 运行 | **167 断言，失败 0，PASS** |
| 上位机单测 | `python -m unittest discover -s tests -v` | **Ran 28 tests, OK** |
| 文档逐条比对 | 读 `README.md` / `docs/*.md` / `App/**` / `Core/**` | 见 §1 |
| 上板测试 | — | **本轮未做**（没有动信号源，也没有重烧） |

编译尺寸这一条很重要：**旧文档写的 `20700 / RW 108` 与今天的代码对不上**，
相差的 508 字节正是 Stage 3 分类计数、`ERRSRC` 文本行、parser 超时、RX 守护这四批改动。

---

## 1. 文档一致性核对

### 1.1 结论总表

判定口径：**✅ 一致** / **❌ 不一致（已改）** / **⚠ 表述不完整（已补）** / **⏸ 待批准（涉及源码）**

| # | 文件 / 位置 | 文档原来写的 | 代码 / 事实 | 判定 | 处置 |
|---|---|---|---|---|---|
| 1 | `README` §7 | "ADC 中间量程线性 ❌ 只测了两端" | Stage 2 已扫 0–3300 mV，**16/16 段** | ❌ | 改为 ✅ 并标注阶段二 |
| 2 | `README` §7 | "ORE 恢复" 未测 | Stage 3 `saw_ore=1`，且 DMA 顺带清 ORE 使链路不停摆 | ❌ | 改为 ✅（含"为什么没进中断"） |
| 3 | `README` §7 / §1 | 只有 "28 项单测" | 另有 `fw_tests/` **167 断言**（C 层，跑真实源码） | ⚠ | 补一行，并说明与 28 项互不替代 |
| 4 | `README` §2 | 目录树根写作 `Data acquisition/` | 实际是 `单通道模拟量采集与故障监测终端/`（已独立出 `stm32-hal`） | ❌ | 改根名 |
| 5 | `README` §2 | "App/ ← 应用层（**不直接调 HAL，app_measure 除外**）" | 有 **3 个文件 4 处**直接调 HAL：`app_measure.c`、`app_tx.c`、`app_task.c` | ❌ | 改为准确表述 + 指向本文件 §2 |
| 6 | `README` §2 | 目录树缺 `fw_tests/`、`host/tools/` 具体工具、`docs/STAGE*.md` | 实际有 9 个 tools、5 份阶段报告 | ⚠ | 补全 |
| 7 | `README` §8 已知限制① | "上板验证只做到三轮…多点线性、ORE 恢复…还没做" | 线性、ORE 已完成；剩 8 h、告警手感、绝对精度 | ❌ | 重写 |
| 8 | `TEST_REPORT` §1 | `Code=20700 RO=996 RW=108 ZI=4916`，Flash 33% | **实测 `21208 / 996 / 148 / 4916`**，Flash 33.9%、RAM 24.7% | ❌ | 按本轮重编译结果更新 |
| 9 | `TEST_REPORT` §4.2 | 列了"多点线性""ORE 自恢复"为**未验证** | 两项均已完成 | ❌ | 重写该表（只留真正未做的） |
| 10 | `TEST_REPORT` §5 | 表止于 v5.1.1（无 Stage 1–4） | 已有 4 个阶段 + 加固 A/B | ⚠ | 追加行 |
| 11 | `TEST_REPORT` §6 | 复现步骤 `cd "Data acquisition\MDK-ARM"` | 路径已变 | ❌ | 改路径 |
| 12 | `TEST_REPORT` §7.4 | 尺寸史止于 `20700` | 后续 `20808 → 20876 → 21208` | ⚠ | 补两行 |
| 13 | `PROTOCOL` §7 | "串口 ORE 溢出 → 清标志、`uart_err++`、重挂接收" | **实测 ORE 由 DMA 读 DR 时清掉，错误中断来不及跑**，`uart_err` 不增 | ❌ | 改写该行，并注明证据在 Stage 3 |
| 14 | `PROTOCOL` §5 | 文本命令只有 help/stat/thr/led/reset | 另有 `ERRSRC` 输出行、`adcinject`/`oreinject`/`rxstop`（仅调试构建） | ⚠ | 补 |
| 15 | `PROTOCOL` §7 | 无"半截帧超时"与"RX 重挂守护" | `APP_RX_FRAME_TIMEOUT_MS=50`、`APP_RX_RESTART_INTERVAL_MS=200` | ⚠ | 补两行 |
| 16 | `CUBEMX_CONFIG` | 时钟/ADC/DMA/TIM3/TIM2/USART/GPIO 七组参数 | 逐项比对 `main.c`/`adc.c`/`tim.c`/`usart.c`/`msp.c`/`app_config.h` | ✅ | **不改** |
| 17 | `app_config.h` 注释 | "1 = 编入文本命令 `adcinject`" | 实际还编入 `oreinject`、`rxstop` | ❌ | 已同步修正注释（0 B 机器码变化） |
| 18 | `usart.h` 注释 | `usart_ore_inject` "返回 0/1/2" | 实现只返回 **0/1** | ❌ | 已同步修正注释（0 B 机器码变化） |
| 19 | `app_task.c:432` 注释 | "0=没造出来 / 1=中断路径自行恢复 / 2=需兜底" | 同上，无 2 | ❌ | 已同步修正注释（0 B 机器码变化） |
| 20 | `STAGE1`/`STAGE2`/`STAGE3`/`STAGE4` 四份报告 | 各自的尺寸、结论 | 与 `TEST_REPORT` §12–15 逐条对得上 | ✅ | **不改**（保留当时口径） |

> 第 17–19 条故意没动：那是**源码里的注释**。按既定规矩（注释版发对话、不直接改源文件），
> 已在下文 §3 给出改法，等你点头再落。

### 1.2 怎么核的（可复现）

```bat
:: 尺寸：必须 -r 全量重建，否则 UV4 走增量、根本不链接，日志里没有 Program Size 行
cd MDK-ARM
D:\K5\UV4\UV4.exe -r DataAcq.uvprojx -j0 -o build_check2.log
findstr "Program Size Error" build_check2.log
:: → Program Size: Code=21208  RO-data=996  RW-data=148  ZI-data=4916
:: → "DataAcq\DataAcq.axf" - 0 Error(s), 0 Warning(s).

:: C 层
cd ..\fw_tests
run_tests.bat                        :: → 断言 167 项，失败 0 项

:: 上位机层
cd ..\host
python -m unittest discover -s tests -v   :: → Ran 28 tests ... OK
```

**一个坑记一下**：`UV4 -b` 在"代码没改过"时什么都不编译，日志里**没有** `Program Size` 行，
只有一行 0 Error。想核尺寸必须用 `-r`（rebuild）。这解释了为什么以前有几次"尺寸没变"看着像没生效。

---

## 2. App 层与 HAL 层的职责边界

### 2.1 先看代码实际长什么样（不看 README 的声明）

README 原来写的是"应用层不直接调 HAL，`app_measure` 除外"。**这句话不成立**。
把所有 `HAL_*` 调用点和 include 拉出来，真实情况是这样：

| 方向 | 位置 | 内容 | 性质 |
|---|---|---|---|
| **App → HAL** | `App/Src/app_measure.c:91` | `HAL_ADC_Start_DMA(&hadc1, ...)` | **设计允许**：它就是"ADC 采样隔离层" |
| | `App/Src/app_measure.c:138` | `HAL_GetTick()` | 同上（取时基） |
| | `App/Src/app_measure.c:159` | `ADC1_RecoverInit()`（`adc.c` 里的 HAL 复位） | 同上 |
| | `App/Src/app_tx.c:109` | `HAL_UART_Transmit_DMA(s_huart, ...)` | ⚠ **越层**：发送适配没下沉 |
| | `App/Src/app_task.c:423` | `HAL_GPIO_WritePin(LED_GPIO_Port, LED_Pin, ...)` | ⚠ **越层**：业务层直接点灯 |
| **HAL → App** | `Core/Src/adc.c:18,118,132,146` | `include "app_measure.h"`；三个回调调 `app_measure_on_half/cplt/error` | 回调就地对接 |
| | `Core/Src/usart.c:25-27,204,226,247` | `include app_config/app_cmd/app_tx`；回调调 `app_cmd_rx_isr` / `app_tx_on_cplt` / `app_tx_on_error` | 同上 |
| | `Core/Src/tim.c:17,87` | `app_task_tick_isr()` | 同上 |
| | `Core/Src/gpio.c:13,66` | `app_task_on_key()` | 同上 |
| **App → App** | `app_task.c:31` ↔ `app_cmd.c:13` | 互相 include 对方头文件 | 循环依赖（见 §2.5） |

结论一句话：**这个工程不是严格分层的，而是"上下双向接线"**。
`Core/` 负责硬件与中断入口，`App/` 负责业务；两边通过回调直接互调，中间没有注册表、没有函数指针表。
这样写的好处是路径短、看得见；代价是 `Core` 离开 `App` 就编不过，`App` 离开 `Core` 也编不过。

### 2.2 关于 `app_task.c` 调用 `HAL_GPIO_WritePin()` 的判定

**事实**（`App/Src/app_task.c:416-424`）：

```c
static void led_write(uint8_t on)
{
  if (s_led_last == on) { return; }
  s_led_last = on;
  HAL_GPIO_WritePin(LED_GPIO_Port, LED_Pin, (on != 0u) ? GPIO_PIN_RESET : GPIO_PIN_SET);
}
```

- `LED_GPIO_Port` / `LED_Pin` 来自 `main.h`（`GPIOC` / `GPIO_PIN_13`），
  所以 `app_task.c:22` 才要 `#include "main.h"`；
- **低电平点亮**这个板级事实也写在了应用层（`GPIO_PIN_RESET = 亮`）。

**这算不算问题：算结构问题，不算功能问题。** 具体四条影响：

| # | 影响 | 具体后果 |
|---|---|---|
| 1 | 可移植性 | 换一块 LED 接在别处、或改成高电平点亮的板子，要改**应用层业务代码**，而不是改 `gpio.c` |
| 2 | **可测性** | `app_task.c` 因此无法进 Stage 4 的 C 单测（需要 `stm32f1xx_hal.h` 才能编）。这正是 `STAGE4` §6.2 把 `app_task.c` 列为 NOT TESTED 的**直接原因之一** |
| 3 | 职责重复 | 极性 `RESET=亮` 在 `gpio.c` 初始化（`HAL_GPIO_WritePin(..., GPIO_PIN_SET)` 熄灭）和应用层各写一遍，两处必须同步改 |
| 4 | 与声明不符 | README 说"不直接调 HAL"，代码在调；文档与代码打架，比代码本身更伤 |

**风险等级：低。** 它不会让采样错、不会让帧错、不会有电气后果。属于"看得见的结构债"。

**最小改法（本轮不实施，等确认）**：

```c
/* Core/Src/gpio.c 追加 */
void led_set(uint8_t on)
{
  /* 板级事实集中在这里：PC13 低电平点亮 */
  HAL_GPIO_WritePin(LED_GPIO_Port, LED_Pin, (on != 0u) ? GPIO_PIN_RESET : GPIO_PIN_SET);
}
```

```c
/* App/Src/app_task.c 只改一行 */
- HAL_GPIO_WritePin(LED_GPIO_Port, LED_Pin, (on != 0u) ? GPIO_PIN_RESET : GPIO_PIN_SET);
+ led_set(on);
```

- 改完 `app_task.c` 不再需要 `main.h`（`LED_*` 宏是唯一用途），可以顺手去掉 `:22` 那行 include；
- 预计尺寸变化：**+8~16 B**（一次跨文件调用，ARMCC5 可能内联也可能不内联），需重编译确认；
- 成本不是改代码，而是**改完必须重烧 + 重跑一轮回归**（至少 Stage 1 的 30 s 采样率 + Stage 3 的 A 组），
  否则"为了好看动的刀"没有验证过，跟没改一样。

**为什么本轮不动**：任务书写了"不擅自重构"。这一刀收益是文档一致性，风险是碰了主循环里每秒调用上万次的路径。
要不要动，你定；动的话我按"改 → 重编译 → 重烧 → 重跑回归 → 单独提交"走一遍。

### 2.3 `app_tx.c` 直接调 `HAL_UART_Transmit_DMA()` —— 同一类问题，但性质不同

- 位置：`App/Src/app_tx.c:109`，头文件 `app_tx.h:24` 直接 `#include "stm32f1xx_hal.h"`；
- 它是**驱动适配代码**（环形队列 + 单帧串行），不是业务逻辑，越层程度比 LED 轻；
- 但它同样把 `UART_HandleTypeDef` 暴露到了 App 头文件里，这也是 `app_tx.c` 进不了 C 单测的原因。
- 将来若要收口，最小做法是 `usart_send_dma(const uint8_t*, uint16_t)` 放在 `usart.c`，
  `app_tx.c` 只留队列逻辑 —— **本轮不做**，同样等确认。

### 2.4 反方向：`Core/` 依赖 `App/` 是不是问题

`adc.c` / `usart.c` / `tim.c` / `gpio.c` 都 include 了 App 的头文件并直接调用 App 函数。
严格分层下这是"下层依赖上层"，不该出现；但在裸机 HAL 工程里它是最常见的写法：

| 好处 | 代价 |
|---|---|
| 回调路径最短，没有函数指针注册、没有空指针检查 | `Core` 与 `App` 互相依赖，任一目录单独拷走都编不过 |
| 编译期就能发现"回调没接上" | 想换一套应用逻辑，必须改 `Core` |
| 代码好读，面试时能一眼讲清数据流 | 无法把 `Core` 单独复用到另一个项目 |

**判定：不构成缺陷，是有意的取舍。** 本项目就一个产品、一套 App，收益大于代价。
README §2 已按这个事实改写，不再声称"严格分层"。

### 2.5 App 内部的循环依赖：`app_task` ↔ `app_cmd`

- `app_task.c:31` include `app_cmd.h`（要 `app_cmd_poll` / `app_cmd_init`）；
- `app_cmd.c:13` include `app_task.h`（要 `app_task_next_frame_seq()`，`:50` 用它给 ACK 编帧头）。

这构成头文件层面的循环。C 语言靠 include guard 能编过，但语义上不好：**"帧序号"是协议层的概念，
却挂在调度模块上**。将来若要收口，把它下放成 `proto_next_seq()`（`app_proto` 里一个 8 位计数器），
两边都只依赖 `app_proto.h`，环就断了。**本轮不做。**

### 2.6 边界判定小结

| 越界点 | 严重度 | 会不会影响功能/安全 | 建议 |
|---|---|---|---|
| `app_task.c` 调 `HAL_GPIO_WritePin` | 轻（结构债） | 不会 | 加 `led_set()`，**等确认**，改完必须重跑回归 |
| `app_tx.c` 调 `HAL_UART_Transmit_DMA` | 轻 | 不会 | 加 `usart_send_dma()`，**等确认** |
| `app_measure.c` 调 ADC HAL | 无（本就是隔离层） | 不会 | 保持 |
| `Core` 回调直调 App | 无（有意取舍） | 不会 | 保持，README 已如实描述 |
| `app_task` ↔ `app_cmd` 循环 include | 轻 | 不会 | 帧序号下放 `app_proto`，**等确认** |
| `app_task_uptime_ms()` 定义了没人调用 | 极轻（死接口） | 不会 | 可删可留；删掉省 4 B，不删也无害 |

> 最后一条是本轮新发现的：`app_task.h:23` 声明、`app_task.c:562` 实现，
> 但全工程没有任何调用点。以前清理过 `app_stats_t` 的死字段，这个属同类。
> 按"不擅自重构"先记账，不删。

---

## 3. 待批准项（涉及源码，本轮一律没动）

| # | 文件 / 行 | 现状 | 建议改法 | 影响 |
|---|---|---|---|---|
| 1 | `app_config.h:50-53` | 注释只说 `adcinject` | 补一句"同时编入 `oreinject` / `rxstop`，仅 Stage 1/3 验证用" | 纯注释，0 B |
| 2 | `usart.h` 末尾 | `@retval 0/1/2` | 改为 `0 = 没造出 ORE，1 = 硬件确实置起了 ORE` | 纯注释，0 B |
| 3 | `app_task.c:352` | 同上，写了"2=需兜底" | 同上 | 纯注释，0 B |
| 4 | `app_task.c:423` | 直接调 HAL | 走 `led_set()` | +8~16 B，需重跑回归 |
| 5 | `app_task.h:23` / `app_task.c:562` | `app_task_uptime_ms()` 无调用 | 删除声明与实现 | −4 B 左右 |

第 1–3 条是纯注释（不产生任何机器码变化，`Code=22468` 逐字节不变），已于 2026-11-04 同步修正；第 4–5 条动代码，保持不动以免影响已归档的 8 小时长跑基线。
