zoumingjie124-ui/single-channel-acquisition/docs/SOAK_60MIN_RECORD.md

# 连续运行记录（自动生成）

> 由 `host/tools/soak_finish.py` 在长跑结束后自动生成，数字直接取自原始日志。

> **本文件不是手填的**：每个值都能在 `SOAK_60MIN_20261103.txt` 里找到对应行。

## 0. 环境

```
port=COM6  duration=60 min  开始 2026-11-03 12:06:13
```

实际时长：**3600.0 秒**（60.00 分钟）

打点行数：**59**（60 s – 3540 s，每分钟一行，说明采集侧没有长时间卡顿；
生成脚本原印 58，是因 `soak_finish.py` 的 `RE_SNAP` 要求帧数后紧跟 `(`，而 60 s 那一行写作
`SAMPLE 6001 (+6001 )`（括号前多一个空格）故未被计入；此处按原始日志订正为 59，其余数字不变）

## 1. 表 A —— 首末总账

| 字段 | 开跑 | 结束 | 判定 |
|---|---|---|---|
| 设备计数器（drops/frame_err/…） | 全部 0（开跑前已发 `reset`） | 见下表 | — |
| SAMPLE 帧 | 0 | 360047 | H1 |
| STAT 帧 | 0 | 3601 | H2 |
| drops | 0 | 0 | H3 |
| frame_err | 0 | 0 | H4 |
| adc_err | 0 | 0 | H5 |
| uart_err | 0 | 0 | H6 |
| seq8 缺口 | 0 | 0 | H7 |
| 整帧丢失 | 0 | 0 | H8 |
| BOOT 帧 | 0 | 0 | H9 |
| 链路中断 | 0 | 0 | H10 |
| changes（状态切换） | 0 | 0 | O1 |
| 解析错误 | 0 | 0 | H12 |
| 设备 uptime | — | 3974000 ms | — |
| 收到字节 | 0 | 6279243 B | — |

## 2. 表 B —— 每 5 分钟打点

| # | 时刻 | SAMPLE 累计 | 本段帧数 | STAT 累计 | drops | frame_err | adc_err | uart_err | seq8 缺口 | 整帧丢失 | 解析错 |
|---|---|---|---|---|---|---|---|---|---|---|---|
| 5 | 300s | 30004 | 6001 | 300 | 0 | 0 | 0 | 0 | 0 | 0 | 0 |
| 9 | 540s | 54007 | 6001 | 540 | 0 | 0 | 0 | 0 | 0 | 0 | 0 |
| 13 | 780s | 78010 | 6001 | 780 | 0 | 0 | 0 | 0 | 0 | 0 | 0 |
| 17 | 1020s | 102013 | 6000 | 1020 | 0 | 0 | 0 | 0 | 0 | 0 | 0 |
| 21 | 1260s | 126017 | 6001 | 1260 | 0 | 0 | 0 | 0 | 0 | 0 | 0 |
| 25 | 1500s | 150020 | 6001 | 1500 | 0 | 0 | 0 | 0 | 0 | 0 | 0 |
| 29 | 1740s | 174023 | 6001 | 1741 | 0 | 0 | 0 | 0 | 0 | 0 | 0 |
| 33 | 1980s | 198026 | 6001 | 1981 | 0 | 0 | 0 | 0 | 0 | 0 | 0 |
| 37 | 2220s | 222030 | 6001 | 2221 | 0 | 0 | 0 | 0 | 0 | 0 | 0 |
| 41 | 2460s | 246033 | 6001 | 2461 | 0 | 0 | 0 | 0 | 0 | 0 | 0 |
| 45 | 2700s | 270036 | 6001 | 2701 | 0 | 0 | 0 | 0 | 0 | 0 | 0 |
| 49 | 2940s | 294039 | 6001 | 2941 | 0 | 0 | 0 | 0 | 0 | 0 | 0 |
| 53 | 3180s | 318042 | 6001 | 3181 | 0 | 0 | 0 | 0 | 0 | 0 | 0 |
| 57 | 3420s | 342045 | 6000 | 3421 | 0 | 0 | 0 | 0 | 0 | 0 | 0 |

## 3. 判定（门槛见 docs/SOAK_PLAN.md §2）

| 编号 | 指标 | 实测 | 门槛 | 判定 |
|---|---|---|---|---|
| H1 | SAMPLE 频率 | 100.013 Hz（360047 / 标称 3600.0 s） | 100.00 ± 0.10 | **PASS** |
| H2 | STAT 频率 | 1.000 Hz | 1.00 ± 0.05 | **PASS** |
| H3 | drops | 0 | = 0 | **PASS** |
| H4 | frame_err | 0 | = 0 | **PASS** |
| H5 | adc_err | 0 | = 0 | **PASS** |
| H6 | uart_err | 0 | = 0 | **PASS** |
| H7 | seq8 缺口 | 0 | = 0 | **PASS** |
| H8 | 整帧丢失 | 0 | = 0 | **PASS** |
| H9 | BOOT 帧 | 0 | = 0 | **PASS** |
| H10 | 链路中断 | 0 | = 0 | **PASS** |
| H12 | 解析错误 | 0 | = 0 | **PASS** |
| H11 | 时基偏差（帧率反推） | 0.0100 %（记录值，证据受限，见下注） | < 0.1 % | **PASS**（门槛内；数值不可独立复核） |

> **口径注：日志里的 `100.01 Hz` 与 `Δt ≈ 3600.1 s` 不是一回事**
>
> - 上表 H1 统一按 **SAMPLE 帧数 / 标称 3600.0 s** 计算：`360047 / 3600.0 = 100.013 Hz`。这是本记录的判定口径，
>   不随工具打印值变化。
> - 日志合计行的 `100.01 Hz` 由 `soak.py` 用**宿主侧墙钟差值**计算（`dur = time.time() - t0`，见
>   `host/tools/soak.py`），而该 `dur` 只以**一位小数**打印（`===== 合计（3600.0 秒）=====`），
>   **毫秒级 Δt 没有写进日志**。
> - `Δt ≈ 3600.1 s` 是**由两位小数频率反推出来的解释值**（`360047 / 100.01 ≈ 3600.1`），
>   **不是日志中保存的精确实测 Δt**。由于 `100.01` 只有两位有效小数，反推的可行区间约
>   **3599.9–3600.3 s**（宽约 0.4 s），故 `3600.1 s` 只能说明"在这个精度下能自洽"，
>   **不能当作精确测量结果引用，也不能用它反推设备的实际采样周期**。
> - 结论层面：`100.013`（标称窗）与 `100.010`（工具打印）的 0.003 Hz 差异全部落在 Δt 的未知量里，
>   属于**同一个数的两种口径**，不是两次互相冲突的测量；门槛 ±0.10 Hz 下两者都是 PASS。

> **H11 = 0.0100 % 的来源与证据限制（2026-11-04 核对代码后补注，数值不改）**
>
> - **代码链路**：`soak.py` 用宿主侧 `dur = time.time() - t0` 算帧率，但只以 **`%.2f`** 写进日志
>   （`SAMPLE 帧 : 360047 (100.01 Hz)`）；`soak_finish.py` 第 88–90 行**直接解析这个两位小数值**
>   （代码注释原话："避免二次计算口径不一致"），第 153 行 `drift = |hz - 100.0| / 100.0 * 100.0`
>   得 0.01，再以 `%.4f` 打印成 `0.0100 %`。
> - 因此：H11 **不是**用毫秒级 elapsed 直接算的（毫秒级在 `%.2f` 那一步就被截断了）；
>   也**不是**由 `360047 / 3600.0` 算的（那样得 0.0131 %），更不是"用 uptime 差算的"——
>   `soak_finish.py` 第 148–149 行的注释明确写了"不是 uptime 差"。
> - **毫秒级 elapsed 没有任何留存**：日志只有 `合计（3600.0 秒）`（`%.1f`）与 `(100.01 Hz)`（`%.2f`），
>   `soak.py` 不写 CSV/JSON，控制台输出同样取整。
> - **可复算性分两层**：
>   **算术层可复算**——`|100.01 − 100.00| / 100 = 0.01 %`，与代码同一个式子，谁都能从日志抄出 0.0100 %；
>   **物理层不可复算**——`100.01` 只有两位小数，对应的真实偏差落在 **[0.005 %, 0.015 %)**，
>   0.0100 % 只是量化到 0.01 Hz 之后的结果，本身分辨率就是 ±0.005 %，不能当作 HSE 相对 PC 墙钟的偏差测量。
> - 结论：**保留历史记录值 0.0100 %，不改数、也不升级**。本项 PASS 不受影响（0.0100 % 与 0.0131 % 都远小于
>   0.1 % 门槛），但该数字**不得引用为"已测得的 HSE 偏差"**；按 uptime 口径的 H11 本轮无法计算
>   （起点 uptime 未记录，日志只有终点 3,974,000 ms）。

## 4. 结论

**PASS**（12 项门槛中 12 项通过）

---
原始日志：`docs/SOAK_60MIN_20261103.txt`（原名 `SOAK_60MIN.txt`，2026-11-04 为腾出 `soak.py` 固定输出名而改名归档，内容未变）

记录表模板：`docs/SOAK_PLAN.md`
