zoumingjie124-ui/single-channel-acquisition/docs/STAGE7C2_FINAL.md

# Stage 7C-2 最终验收报告

> 日期：2026-11-03 23:2x
> 范围：GET_DIAG 状态快照 + TX 提交失败恢复（收尾轮，**未新增功能**）
> 固件基线：`Code=22468 RO=1076 RW=148 ZI=4972`，0 Error 0 Warning

本报告把证据分成四层，**层与层之间不互相代替**：

| 层 | 含义 | 能不能写"验证通过" |
|---|---|---|
| 软件验证 | PC 上跑单测 / 离屏跑界面 / 编译 | 只能说"软件层通过" |
| 板级验证 | **真实 STM32F103C8T6 + 真实电气输入** | 可以写"板级通过"，但要写清做了什么 |
| 仅单测 | 只有 GCC/Python 单测，硬件没跑过 | **不能**当板级结论 |
| 未验证 | 完全没做 | 只能写"未验证" |

---

## 1. 已通过的软件验证

本轮全部**重跑**，不是引用上一轮的数字。

| 项 | 命令 / 环境 | 结果 |
|---|---|---|
| 固件 C 单元测试 | `gcc 4.9.2 -std=c99 -Wall -Wextra -Werror -O2`，编译**仓库里的真实源码**（`app_proto/app_alarm/app_filter/app_diag/app_fault/app_cmd`） | **1041 项断言，0 失败，PASS** |
| 上位机单元测试 | `python -m unittest discover -s tests` | **72 项 OK** |
| 界面离屏冒烟 | `QT_QPA_PLATFORM=offscreen python tests/gui_smoke.py` | **PASS**，含诊断开关下发 / 故障确认显示 / 故障恢复显示 / 未知帧不致命 / 连接后自动查询 / 快照清除显示 / 查询应答 |
| 跨语言契约向量 | `test_fault_joint.py` + `test_protocol_doc_sync.py` | C 数组、Python 构造、`PROTOCOL.md` 正文三方逐字节一致（5 组向量） |
| Release 编译 | `UV4 -r DataAcq.uvprojx -j0` | `Code=22468 RO=1076 RW=148 ZI=4972`，**0 Error 0 Warning** |

编译告警策略：`-Wall -Wextra -Werror`，**没有任何一处需要豁免**。

### 1.1 资源变化（相对 7C）

| 项 | 7C | 7C-2 | 变化 |
|---|---|---|---|
| Code | 22204 | **22468** | +264 |
| RO-data | 1000 | **1076** | +76（格式化字符串变长） |
| RW-data | 148 | **148** | 0 |
| ZI-data | 4956 | **4972** | +16（`app_fault_t` 加 `reported` / 时间戳） |
| Flash 占用 | 35.4% | **35.9%** | +0.5% |
| RAM（静态） | 24.9% | **25.0%** | +0.1% |

---

## 2. 已通过的板级验证（只列真实执行过的）

设备：STM32F103C8T6 + CH340 USB-TTL，`115200 8N1`，PA1 ← 电位器。
原始日志：`docs/STAGE7C2_BOARD_RAW.txt`（脚本自动落盘，非手填）。

| # | 做了什么 | 结果 |
|---|---|---|
| 1 | 复位后立即 `GET_DIAG` | `ACK seq=46 (result=OK)` → `快照 seq=47`，`id=0 mask=0x00 value=0` —— **ACK 在前、快照紧随、SEQ 连续** |
| 2 | `SET_DIAG(1)` 后保持输入不动 | `ACK seq=199`，**3.02 s** 后确认帧 `seq=250`，`mask=0x01 value=8 mV`（8 mV 正是静置输入的块内峰峰值） |
| 3 | 有故障时 `GET_DIAG` | `ACK seq=39` → `快照 seq=40`，`id=STUCK mask=0x01 value=12` |
| 4 | **关闭串口**（模拟断线），设备继续运行 | 期间 `conf` 由 1 涨到 2 —— 说明**断线期间确实发生过"恢复→再次确认"**，事件帧丢了 |
| 5 | 重连后立刻 `GET_DIAG` | 快照如实返回 `mask=0x01`（当时窗口已过、设备已重判为卡死）。**没有改写成"同步成功"，原样记录** |
| 6 | 重连后**连续轮询** `GET_DIAG`（每 350 ms）并人手来回拧电位器 | **57 帧快照全部 `mask=0x00`** —— 断线期间发生的恢复被快照正确同步 |
| 7 | 停手静置后 `stat` | `conf=4`，设备自行重新判定卡死；`mask=1 rep=1`（`rep` 与 `mask` 拉平，说明提交成功） |
| 8 | 全程计数器 | `drops / adc_err / uart_err / frame_err` 全 0，解析错误 0；首段 **915 帧、SEQ 异常 0 个**（跨 255→0 回绕仍连续） |

**这 8 项是唯一可以称为"板级验证"的内容。** 它们证明的是：
查询/应答的时序与字段正确、真实故障能触发确认、断线后快照能给出当前真相、
关闭诊断不会伪造恢复、全局序号不被快照打乱。

---

## 3. 仅单元测试通过的项目

以下项目**只有 PC 侧证据**，硬件上没跑过。可以写 `UNIT PASS`，**不可以写板级通过**。

| 项目 | 证据 | 状态 |
|---|---|---|
| TX 环真实满载后的重试 | `test_fault.c`：模拟 `emit` 返回 0，断言"不构造帧、不取 SEQ、`reported` 不变、恢复后只提交最新 `active`" | **UNIT PASS / NOT TESTED**（板级） |
| 100 ms 重试节流 | `test_fault.c`：`now - last_try >= 100` 的边界用例 | **UNIT PASS** |
| 多故障快照 | 白盒单测手工置 `active=0x03`，断言 `fault_id=0 / value=0`；固件只登记 `STUCK`，生产路径走不到 | **UNIT PASS** |
| 队列检查与写入的并发 | **代码审查**：ACK 在 `app_cmd_poll()`、FAULT 在 `app_fault_service()`，都是主循环顺序执行；**无 ISR 入队生产者** | **CODE REVIEW PASS** |
| 边沿合并（确认→恢复→再确认全程队列满） | `test_fault.c`：断言队列恢复后**只发 1 帧**且内容与当前状态一致 | **UNIT PASS** |
| 快照只读（连查 100 次不改 `active`/`reported`） | `test_fault.c` | **UNIT PASS** |

---

## 4. 尚未验证的项目

| 项目 | 为什么没做 | 影响 |
|---|---|---|
| **真实传感器诊断**（断线 / 探头失效 / 漂移到轨） | 手上只有电位器。"卡死"在电气上等价于"电位器不动"，但**不能声称验证了传感器失效场景** | 真实失效可能不被 `STUCK` 检出 |
| **诊断 1h / 8h 长期运行** | 板级累计约 10 分钟 | 长期稳定性、计数溢出、误报率未知 |
| **GUI 按钮连接真实开发板** | 界面联动是离屏冒烟（软件模拟）；真板路径走脚本，没点过界面按钮 | 真机闭环（勾选 / 查询 / 显示）未验证 |
| **TX 环真实满载** | 环 1024 B、稳态 1744 B/s，需 DMA 停摆 ≈0.6 s；没有不破坏链路就能做到的手段 | 满载自愈只有推演 |
| **真实电气输入下的误报率** | 需要可编程信号源扫幅值/频率 | `STUCK_DELTA_MV=50 mV` 是否适合真实工艺量，仍标"待确定" |
| 万用表绝对电压精度（R2，历史遗留） | 缺独立参考 | 只能声称"比例测量正确" |
| 8 小时长跑（R3，历史遗留） | 未做 | 温漂、慢性资源增长未覆盖 |

---

## 5. 当前已知风险

登记在 `docs/TEST_INVENTORY.md` §5，本轮新增 R15–R21：

| # | 风险 | 等级 | 一句话现状 |
|---|---|---|---|
| R3 | 8 小时连续运行 | 高 | 1 h 已 PASS，8 h 未做 |
| R2 | 绝对电压精度 | 中 | 待万用表 |
| R1 | 真实 HAL 重挂失败 | 中 | 只有代码审查 |
| **R15** | TX 环真实满载后的重试 | **中** | UNIT PASS / NOT TESTED |
| R19 | 真实传感器诊断 | 中 | NOT TESTED |
| R20 | 诊断 1h/8h 长期运行 | 中 | NOT TESTED |
| R16 | 100 ms 重试节流 | 低 | UNIT PASS |
| R17 | 多故障快照 | 低 | UNIT PASS（固件只有一种故障） |
| R18 | 队列检查与写入并发 | 低 | CODE REVIEW PASS（入队只在主循环） |
| R21 | GUI 按钮连真板 | 低 | NOT TESTED |

### 5.1 设计层面仍存在的取舍（不是缺陷，但要知道）

1. **边沿可能被合并**：队列阻塞期间发生的多次确认/恢复，恢复后只提交当时的状态。
   丢的是"历史事件"，不是"当前状态"——由 GET_DIAG 兜底。已批准。
2. **`reported` 只代表入队成功**：`app_tx_write()` 成功 ≠ DMA 发完 ≠ 对端收到。
   所以重连后仍必须查快照，快照与事件不能互相替代。已写入 `PROTOCOL.md` §4.8.1。
3. **关闭诊断不清故障状态**：`diag off` 后 `mask` 仍会保留到下次上电，
   这是"关闭诊断 ≠ 故障恢复"的必然结果，快照也如实返回该状态。

---

## 6. Git 与修改文件清单

### 6.1 本轮（收尾）改动

| 文件 | 改动 | 原因 |
|---|---|---|
| `docs/PROTOCOL.md` | 新增 §4.8.1「上报语义与发送失败处理」 | 原文只写了"提交成功才拉平"，缺 `reported` 定义、队列满不烧 SEQ、100 ms 节流、边沿合并四条 |
| `docs/TEST_INVENTORY.md` | 新增风险 R15–R21 + 状态标注规则 | 把七项未验证事项落到风险清单，防止被口头升级成"板级通过" |
| `docs/TEST_REPORT.md` | 新增 §19（证据等级表 + 本轮回归） | 测试总账留档 |
| `docs/STAGE7C2_FINAL.md` | 新增，即本文件 | 验收报告 |

**固件与上位机代码零改动**：`git diff -- App Core MDK-ARM host` 为空。
`app_diag.c`、滤波/报警/采集、ADC/DMA、SAMPLE/STAT 长度、全局 SEQ 规则均未触碰。

### 6.2 功能实现提交（上一轮，供追溯）

| commit | 内容 |
|---|---|
| `035ef1a` | `feat(diag): Stage 7C-2 GET_DIAG 状态快照 + TX 提交失败恢复` |
| `e195a6c` | `docs(7c2): 补记录提交号 035ef1a` |
| **`44f86a2`** | `docs(7c2): 收尾——证据分级、协议上报语义补全、最终验收报告` |

---

## 7. 发现但**未修改**的文档差异（按"先报告、不擅自扩大范围"处理）

`README.md` 顶部「验证状态」块**已过期**，与仓库现状不一致，具体四处：

| 位置 | README 现在写的 | 实际 |
|---|---|---|
| 固件尺寸 | `Code=21208 / RO 996 / RW 148 / ZI 4916` | `Code=22468 / RO 1076 / RW 148 / ZI 4972` |
| PC 层测试量 | Python **28 项** + 固件 C **167 断言** | Python **72 项** + 固件 C **1041 断言** |
| Stage 列表 | 只到 Stage 6 第 1 项，**没有 Stage 7 / 7B / 7C / 7C-2** | 四轮均已提交并有独立报告 |
| 仍未测清单 | 只列 8h / 绝对精度 / HAL 重挂 / 滞回 / INL·DNL | 还需补 R15–R21（TX 环满载、真实传感器、诊断长跑、GUI 真板） |

**本轮没有改它**，因为这不在你列的四项任务内（你要求的是"测试报告 + 风险清单"）。
差异已在此存档，等你决定是否单独用一轮把 README 对齐。

另：`host/docs/` 是 19:11 一次 `dur=0s` 的 soak 误跑残留（`rawBytes=0`，无内容）。
本轮只把这个目录加进 `.gitignore`，**没有删除文件**。

---

## 最终结论

**Stage 7C-2 软件实现与协议单元测试通过；板级 TX 环真实满载恢复、真实传感器诊断、长期诊断运行及 GUI 真板交互尚未验证。**
