zoumingjie124-ui/single-channel-acquisition/docs/STAGE7B_HW_SOAK_RECORD.md

# Stage 7B-HW：10 分钟连续运行记录（自动生成）

> 由 `host/tools/hw_soak_parse.ps1` 从原始字节 `hw7b_soak_raw.bin` 解析生成，数字均可在
> `STAGE7B_HW_SOAK_RAW.txt` 的每分钟行里对到。
> **本文件不是手填的。**

> 范围说明：本轮长跑在**诊断默认关闭**（`APP_DIAG_STUCK_ENABLE_DEFAULT=0`）下进行，
> 验证的是"Stage 7B 构建不扰动 100Hz 采集链路"。**不含**诊断使能态的长跑（见 STAGE7B_HW_REPORT §4）。

---

## 0. 环境

```
port=COM6  duration=10 min  开始 2026-11-03 18:50:37  固件=Stage 7B (6112267, Code=21492/ZI=4956)
采集=hw_soak_capture.ps1（只读串口）  解析=hw_soak_parse.ps1（CRC 逐帧校验）
```

实际时长：**600 秒**（设备时基 t0→tLast = 600 s）

打点行数：**10**（每分钟一行）

原始字节：**1046537 B**

## 1. 表 A —— 首末总账

| 字段 | 开跑 | 结束 | 判定 |
|---|---|---|---|
| 设备计数器（drops/frame_err/…） | 全部 0（开跑前已发 `reset`） | 见下表 | — |
| SAMPLE 帧 | 0 | 60008 | H1 |
| STAT 帧 | 0 | 600 | H2 |
| drops | 0 | 0 | H3 |
| frame_err | 0 | 0 | H4 |
| adc_err | 0 | 0 | H5 |
| uart_err | 0 | 0 | H6 |
| seq8 缺口 | 0 | 0 | H7 |
| 整帧丢失 | 0 | 0 | H8 |
| BOOT 帧 | 0 | 0 | H9 |
| 链路中断 | 0 | 0 | H10 |
| changes（状态切换） | 0 | 0 | O1 |
| 解析错误（CRC 坏帧） | 0 | 0 | H12 |
| 设备 uptime | — | 4026000 ms | — |
| 收到字节 | 0 | 1046537 B | — |

> 表 A 的 SAMPLE=60008 为**全部**收到的 0x81 帧；表 B 最后一行（600s 边界）为 60001，
> 差的 7 帧是最后一个 STAT 边界之后、收尾不足一秒内到达的帧，计入表 A、不单独成行。
> 设备自身 STAT.samples=59972 与帧计数相差 36，属 reset/窗口对齐差异；
> **drops=0 且 seq8/SEQ 缺口=0 证明窗口内无丢点、无丢帧**，故该差异不是数据丢失。

## 2. 表 B —— 每分钟打点

| # | 时刻 | SAMPLE 累计 | 本段帧数 | STAT 累计 | drops | frame_err | adc_err | uart_err | seq8 缺口 | 整帧丢失 | 解析错 |
|---|---|---|---|---|---|---|---|---|---|---|---|
| 1 | 60s | 6001 | 6001 | 60 | 0 | 0 | 0 | 0 | 0 | 0 | 0 |
| 2 | 120s | 12001 | 6000 | 120 | 0 | 0 | 0 | 0 | 0 | 0 | 0 |
| 3 | 180s | 18001 | 6000 | 180 | 0 | 0 | 0 | 0 | 0 | 0 | 0 |
| 4 | 240s | 24001 | 6000 | 240 | 0 | 0 | 0 | 0 | 0 | 0 | 0 |
| 5 | 300s | 30001 | 6000 | 300 | 0 | 0 | 0 | 0 | 0 | 0 | 0 |
| 6 | 360s | 36001 | 6000 | 360 | 0 | 0 | 0 | 0 | 0 | 0 | 0 |
| 7 | 420s | 42001 | 6000 | 420 | 0 | 0 | 0 | 0 | 0 | 0 | 0 |
| 8 | 480s | 48001 | 6000 | 480 | 0 | 0 | 0 | 0 | 0 | 0 | 0 |
| 9 | 540s | 54001 | 6000 | 540 | 0 | 0 | 0 | 0 | 0 | 0 | 0 |
| 10 | 600s | 60001 | 6000 | 600 | 0 | 0 | 0 | 0 | 0 | 0 | 0 |

## 3. 判定（门槛见 docs/SOAK_PLAN.md §2）

| 编号 | 指标 | 实测 | 门槛 | 判定 |
|---|---|---|---|---|
| H1 | SAMPLE 频率 | 100.013 Hz | 100.00 ± 0.10 | **PASS** |
| H2 | STAT 频率 | 1.000 Hz | 1.00 ± 0.05 | **PASS** |
| H3 | drops | 0 | = 0 | **PASS** |
| H4 | frame_err | 0 | = 0 | **PASS** |
| H5 | adc_err | 0 | = 0 | **PASS** |
| H6 | uart_err | 0 | = 0 | **PASS** |
| H7 | seq8 缺口 | 0 | = 0 | **PASS** |
| H8 | 整帧丢失 | 0 | = 0 | **PASS** |
| H9 | BOOT 帧 | 0 | = 0 | **PASS** |
| H10 | 链路中断 | 0 | = 0 | **PASS** |
| H12 | 解析错误 | 0 | = 0 | **PASS** |
| H11 | 时基偏差（帧率反推） | 0.013 % | < 0.1 % | **PASS** |
| O1 | changes 首末增量 | 0 | 0（输入不动） | 符合 |

## 4. 结论

**PASS**（12 项硬门槛 12 项通过；O1 符合）。

Stage 7B 构建在**诊断默认关闭**下，10 分钟真实硬件连续运行：100.013 Hz、零丢点、零错误、
序号连续、无中途复位。**7B 的新增代码（+284 B Code / +40 B ZI）未扰动采集链路。**

> 未覆盖：诊断**使能态**下的 10 分钟长跑、以及卡死触发/恢复——二者被"正式固件无运行时
> 使能路径 + 需人工转动电位器"阻塞，见 `STAGE7B_HW_REPORT.md`。

---
原始日志：`docs/STAGE7B_HW_SOAK_RAW.txt`（每分钟行）；完整原始字节保留于本次采集的 `_raw.bin`。
记录表模板：`docs/SOAK_PLAN.md`
