zoumingjie124-ui/single-channel-acquisition/docs/SOAK_PLAN.md

# 连续运行测试方案与记录表（1 小时 / 8 小时）

> **状态：空模板。本轮没有跑 1 h，也没有跑 8 h。**
> 表里出现的唯一一行带数字的内容，明确标了「示例」，是为了说明填写格式，**不是实测结果**。
> 跑完之后请把实际数据填进 §4，并在 §7 写结论。

---

## 1. 为什么要分两档

| 档 | 回答什么问题 | 主要风险 |
|---|---|---|
| **1 小时** | 短周期抖动、偶发丢帧、USB 链路稳定性、界面/CSV 是否拖慢采集 | 低，是 8 h 的"入场券" |
| **8 小时** | 计数溢出、长时间温漂、内存/缓冲慢性泄漏、凌晨无人时的自恢复能力 | 高，**这是"能不能交付"的分水岭** |

1 h 不过就不要跑 8 h —— 8 h 只是把同一个问题放大 8 倍，不会自己消失。

---

## 2. 判定门槛（先定标准，再跑）

### 2.1 硬指标（任一不满足即 FAIL）

| # | 指标 | 门槛 | 依据 |
|---|---|---|---|
| H1 | SAMPLE 频率 | **100.00 ± 0.10 Hz** | 设计 100 Hz；v5.1.1 实测 100.01 |
| H2 | STAT 频率 | **1.00 ± 0.05 Hz** | `APP_STAT_PERIOD_MS = 1000` |
| H3 | `drops`（采样环溢出） | **= 0** | 一个采样点都不能丢 |
| H4 | `frame_err` | **= 0** | 无 CRC / 格式错误 |
| H5 | `adc_err` | **= 0** | 无 ADC/DMA 错误 |
| H6 | `uart_err` | **= 0** | 无 ORE/FE/NE/PE |
| H7 | `seq8` 缺口（样本级） | **= 0** | 样本连续 |
| H8 | 整帧丢失（帧头 SEQ） | **= 0** | 帧连续 |
| H9 | BOOT 帧数量 | **= 0（除首帧）** | 中途复位会立刻暴露 |
| H10 | 链路中断次数 | **= 0** | USB 掉线/重枚举 |
| H11 | 设备 uptime 与实际时长的偏差 | **< 0.1%** | 证明 1 ms 时基没漂 |
| H12 | 解析错误（上位机侧） | **= 0** | 两端协议一致 |

### 2.2 观察指标（不判 FAIL，但必须记录并解释）

| # | 指标 | 期望 | 偏离时说明什么 |
|---|---|---|---|
| O1 | `changes` 首末增量 | **0**（输入不动） | 非 0 说明信号漂移或干扰触发了告警；需记录发生时刻 |
| O2 | 单段 SAMPLE 数波动 | ±1% 内 | 超出说明 PC 侧读取被阻塞（历史原因见 `TEST_REPORT` §8.1） |
| O3 | 板子/环境温度 | 手记 | 温漂是 8 h 最可能的隐性变量 |
| O4 | PC 侧进程内存 | 无持续增长 | 缓慢增长 = 上位机有泄漏 |
| O5 | 电压读数均值 | 与开跑时相差 < 5 mV | 偏大说明参考或输入在漂 |

---

## 3. 准备清单（条件不固定，数据不可比）

| 项 | 要求 | 记录值 |
|---|---|---|
| 固件 | `APP_DEBUG_INJECT = 0`（正式版） | Release `Code=` ______ |
| 烧录时间 | 上电即开始计时，中途不按复位 | ______ |
| 串口 | 固定一个口，115200 8N1 | COM____ |
| 输入源 | 固定电压（电位器调好后**不要碰**），建议落在 NORMAL 区中部（约 1000–1500 mV） | ______ mV |
| 供电 | USB 供电或 ST-Link 3.3V，**只接一路** | ______ |
| 上位机 | `python host\tools\soak.py <分钟> COM<x>`，独占串口 | 版本 commit ______ |
| PC | 关闭睡眠/休眠/屏幕保护；USB 选择性暂停关闭 | ______ |
| 环境 | 不要有人碰线；8 h 尽量放在无人时段 | 室温 ______ ℃ |

> ⚠ **`soak.py` 与 GUI 不能同时开同一个串口**。只有一块板时，8 h 那一轮二选一：
> 用 `soak.py`（拿全量指标，推荐）或 `main.py`（看界面长跑）。二者不可兼得。

---

## 4. 记录表

### 4.1 表 A —— 首末总账（每次必填）

| 字段 | 开跑（t=0） | 结束（t=末） | 差值 / 计算 | 判定 |
|---|---|---|---|---|
| 墙钟时间 | | | 实际时长 ______ s | — |
| 设备 `uptime_ms` | | | Δ = ______ ms | H11 |
| SAMPLE 累计 | | | Δ = ______ 帧 → **______ Hz** | H1 |
| STAT 累计 | | | Δ = ______ → **______ Hz** | H2 |
| `drops` | | | Δ = ______ | H3 |
| `frame_err` | | | Δ = ______ | H4 |
| `adc_err` | | | Δ = ______ | H5 |
| `uart_err` | | | Δ = ______ | H6 |
| `seq8` 缺口累计 | | | Δ = ______ | H7 |
| 整帧丢失累计 | | | Δ = ______ | H8 |
| BOOT 帧数 | | | ______ | H9 |
| 链路中断次数 | | | ______ | H10 |
| `changes` | | | Δ = ______ | O1 |
| 解析错误 | | | ______ | H12 |

> 注意：`drops` / `frame_err` / `changes` 都是**设备上电以来的累计值**（`reset` 命令会清零）。
> 所以必须"首末相减"，不能只看末值。开跑前建议先发一次 `reset`，让窗口从 0 开始。

### 4.2 表 B-1 —— 1 小时，每 5 分钟打点（12 行）

| # | 墙钟 | 设备 uptime (ms) | SAMPLE 累计 | 本段帧数 | 本段频率 (Hz) | STAT 累计 | drops | frame_err | adc_err | uart_err | seq8 缺口 | 整帧丢失 | changes | 备注 |
|---|---|---|---|---|---|---|---|---|---|---|---|---|---|---|
| 0 | | | | — | — | | | | | | | | | 开跑 |
| 1 | | | | | | | | | | | | | | |
| 2 | | | | | | | | | | | | | | |
| 3 | | | | | | | | | | | | | | |
| 4 | | | | | | | | | | | | | | |
| 5 | | | | | | | | | | | | | | |
| 6 | | | | | | | | | | | | | | |
| 7 | | | | | | | | | | | | | | |
| 8 | | | | | | | | | | | | | | |
| 9 | | | | | | | | | | | | | | |
| 10 | | | | | | | | | | | | | | |
| 11 | | | | | | | | | | | | | | |
| 12 | | | | | | | | | | | | | | 收尾 |

### 4.3 表 B-2 —— 8 小时，每 30 分钟打点（16 行）

| # | 墙钟 | 设备 uptime (ms) | SAMPLE 累计 | 本段帧数 | 本段频率 (Hz) | STAT 累计 | drops | frame_err | adc_err | uart_err | seq8 缺口 | 整帧丢失 | changes | 室温/板温 | 备注 |
|---|---|---|---|---|---|---|---|---|---|---|---|---|---|---|---|
| 0 | | | | — | — | | | | | | | | | | 开跑 |
| 1 | | | | | | | | | | | | | | | |
| 2 | | | | | | | | | | | | | | | |
| 3 | | | | | | | | | | | | | | | |
| 4 | | | | | | | | | | | | | | | |
| 5 | | | | | | | | | | | | | | | |
| 6 | | | | | | | | | | | | | | | |
| 7 | | | | | | | | | | | | | | | |
| 8 | | | | | | | | | | | | | | | 中途检查 |
| 9 | | | | | | | | | | | | | | | |
| 10 | | | | | | | | | | | | | | | |
| 11 | | | | | | | | | | | | | | | |
| 12 | | | | | | | | | | | | | | | |
| 13 | | | | | | | | | | | | | | | |
| 14 | | | | | | | | | | | | | | | |
| 15 | | | | | | | | | | | | | | | |
| 16 | | | | | | | | | | | | | | | 收尾 |

**填写示例（示例，非实测）**：

| # | 墙钟 | 设备 uptime (ms) | SAMPLE 累计 | 本段帧数 | 本段频率 (Hz) | STAT 累计 | drops | frame_err | adc_err | uart_err | seq8 缺口 | 整帧丢失 | changes | 室温/板温 | 备注 |
|---|---|---|---|---|---|---|---|---|---|---|---|---|---|---|---|
| 示例 | 09:05 | 300000 | 30000 | 30000 | 100.00 | 300 | 0 | 0 | 0 | 0 | 0 | 0 | 0 | 24 ℃ | 仅示意算法 |

---

## 5. 字段从哪来、怎么算

| 字段 | 来源 | 算法 |
|---|---|---|
| 墙钟 | 手记或日志每 60 s 打点的 `[ Ns]` | — |
| 设备 `uptime_ms` | STAT 帧偏移 0（`uptime_ms`） | 直接抄 |
| SAMPLE 累计 | `soak.py` 每行的 `SAMPLE n(+m)` 中 `n` | 末 − 首 |
| 本段频率 | — | **本段帧数 ÷ 本段实际秒数**（用设备 uptime 差，不用墙钟，避免 PC 侧卡顿污染） |
| STAT 累计 | 同上的 `STAT` 列 | 末 − 首，再 ÷ 时长 |
| drops / frame_err / adc_err / uart_err | STAT 帧偏移 8 / 24 / 12 / 16 | 末 − 首 |
| seq8 缺口 | `soak.py` 累计列 | 末 − 首 |
| 整帧丢失 | 同上（用帧头 SEQ，不是载荷） | 末 − 首 |
| BOOT 帧数 | `soak.py` 末尾"BOOT 帧" | 应为 0（首帧不计） |
| 链路中断 | `soak.py` 末尾"链路中断次数" | 应为 0 |
| `changes` | STAT 帧偏移 28 | 末 − 首 |
| 解析错误 | `soak.py` 末尾 | 应为 0 |

**为什么用设备 uptime 算频率而不是墙钟**：PC 侧一次 GC 或系统卡顿就能让墙钟多出几百毫秒，
7 小时的窗口里这些误差会累积。设备 uptime 来自 TIM2（HSE 8 MHz × PLL），是这轮测试里最可信的时基。

---

## 6. 异常处理预案

| 现象 | 处置 | 记录方式 |
|---|---|---|
| `soak.py` 报"链路中断"并自动重连 | **不要停**，让它自己重连（脚本会在 30 s 内重试） | 记 `链路中断次数`+1，并在表 B 备注写明时刻 |
| 重连成功但序号重新对齐 | 正常行为（脚本会重置期望值） | 备注写"重连后已对齐，缺口不累计" |
| BOOT 帧出现 | 设备复位了 → **本轮作废**，查原因（看门狗/掉电/USB 供电不足） | 在 §7 写"作废 + 原因" |
| `drops` 开始增长 | 主循环被拖慢 → **FAIL**，立即停，保留日志 | — |
| `frame_err` 开始增长 | 线路/波特率问题 → **FAIL**，检查接线与共地 | — |
| 板子发烫 / 电流异常 | **立即断电**，按电气安全优先 | 记录现象 |
| PC 睡眠导致串口断开 | 重跑；先把电源计划改成"从不睡眠" | — |

---

## 7. 跑完之后填这里

```
测试轮次：第 ___ 轮
日期时间：____-__-__ __:__ → ____-__-__ __:__
固件：Release Code=______（commit ________）
串口：COM____    输入：______ mV（NORMAL 区）
实际时长：______ s

H1  SAMPLE 频率        ______ Hz      □ PASS □ FAIL
H2  STAT 频率          ______ Hz      □ PASS □ FAIL
H3  drops              ______         □ PASS □ FAIL
H4  frame_err          ______         □ PASS □ FAIL
H5  adc_err            ______         □ PASS □ FAIL
H6  uart_err           ______         □ PASS □ FAIL
H7  seq8 缺口          ______         □ PASS □ FAIL
H8  整帧丢失           ______         □ PASS □ FAIL
H9  BOOT 帧            ______         □ PASS □ FAIL
H10 链路中断           ______         □ PASS □ FAIL
H11 uptime 偏差        ______ %        □ PASS □ FAIL
H12 解析错误           ______         □ PASS □ FAIL

O1  changes 增量       ______         （0 为佳）
O2  单段帧数波动       ______ %        
O3  温度范围           ______ ℃
O4  PC 内存增长        ______ MB
O5  读数漂移           ______ mV

结论：□ PASS  □ FAIL（原因：____________________）
原始日志：docs/SOAK_<分钟>MIN.txt
```

---

## 8. 归档命名

| 产物 | 命名 | 存放 |
|---|---|---|
| 采集日志 | `SOAK_60MIN.txt` / `SOAK_480MIN.txt` | `docs/` |
| 本记录表（填好） | `SOAK_60MIN_RECORD.md` / `SOAK_480MIN_RECORD.md` | `docs/` |
| 结论汇总 | 追加到 `docs/TEST_REPORT.md` 新章节（§16 之后） | `docs/` |

> 填完记得把 `docs/TEST_INVENTORY.md` §5 的 **R3（8 小时连续运行）** 状态改成"已关闭"或"部分关闭"，
> 并写明关闭依据。**不要只改 README 不改清单**——两份文件必须同步。

---

## 9. 电源设置：测试前修改、测完必须还原

1 小时 / 8 小时长跑前必须关掉睡眠，否则数据会假干净（原因见 `TEST_REPORT` §17.3）。
**这些是持久修改，测完一定要还原**，否则笔记本会一直不睡、电池耗光。

### 9.1 测试前（把电源改成“从不”）

```bat
powercfg -change -standby-timeout-ac 0
powercfg -change -standby-timeout-dc 0
powercfg -change -hibernate-timeout-ac 0
powercfg -change -hibernate-timeout-dc 0
powercfg -setacvalueindex SCHEME_CURRENT 2a737441-1930-4402-8d77-b2bebba308a3 48e6b7a6-50f5-4782-a5d4-53bb8f07e226 0
powercfg -setdcvalueindex SCHEME_CURRENT 2a737441-1930-4402-8d77-b2bebba308a3 48e6b7a6-50f5-4782-a5d4-53bb8f07e226 0
powercfg -setactive SCHEME_CURRENT
```

（第 5–6 行是“USB 选择性暂停”，GUID 是固定的，别改。）

### 9.2 测完还原（2026-11-03 那台机器的原始值）

```bat
powercfg -change -standby-timeout-ac 15
powercfg -change -standby-timeout-dc 10
powercfg -change -hibernate-timeout-ac 180
powercfg -change -hibernate-timeout-dc 180
powercfg -setacvalueindex SCHEME_CURRENT 2a737441-1930-4402-8d77-b2bebba308a3 48e6b7a6-50f5-4782-a5d4-53bb8f07e226 1
powercfg -setdcvalueindex SCHEME_CURRENT 2a737441-1930-4402-8d77-b2bebba308a3 48e6b7a6-50f5-4782-a5d4-53bb8f07e226 1
powercfg -setactive SCHEME_CURRENT
```

### 9.3 核对有没有还原成功

```bat
powercfg -q SCHEME_CURRENT SUB_SLEEP STANDBYIDLE
powercfg -q SCHEME_CURRENT SUB_SLEEP HIBERNATEIDLE
```

`当前交流电源设置索引` 应看到 `0x00000384`（=900 s，睡眠 15 分钟）与 `0x00002a30`（=10800 s，休眠 3 小时）。
USB 那项应看到 `0x00000001`（=启用）。

> 提醒：在 Git Bash 里给 `powercfg` 和 `shutdown` 传参数要加 `MSYS_NO_PATHCONV=1`，
> 否则 `/s`、`/getactivescheme` 这类参数会被 MSYS 当成 Windows 路径改写，命令会直接打印帮助而不执行。
