zoumingjie124-ui/single-channel-acquisition/docs/STAGE3_UART_DMA.md

# 阶段三：UART + DMA + IDLE 异常验证

> 测试日期：**2026-11-03 08:58 – 09:01**
> 固件：T1–T9 九项用例跑在**改动前**的正式版 `Code=20700`；
> 　　　本轮末尾新增分类计数与 `oreinject` 后，正式版变为 `Code=20876`（二进制协议未变）
> 硬件：STM32F103C8T6 + CH340，**COM6** · 115200 8N1
> 原始记录：`docs/STAGE3_RAW.txt`、`host/tools/uart_fault.py`
> 结论：**6 项要求全部有实证；ORE 用"停 DMA"方式真实注入（saw_ore=1）；发现 1 处协议层连锁代价、1 处重挂无重试的缺口**
> 本轮改动：新增错误分类计数 + `oreinject` 调试命令（默认不编译），Release `20700 → 20876`

---

## 0. 结论速览

| # | 检查项 | 结论 | 证据 |
|---|---|---|---|
| 1 | UART 接收溢出（ORE） | ✅ 通过 | 用"停 DMA"真实注入：`saw_ore=1`；ORE 被 DMA 顺带清掉，错误中断来不及跑，链路不受影响（§3.9） |
| 2 | HT / TC / IDLE 是否重复处理 | ✅ 通过 | HT 有反向对照（v5.1.5）；TC 跨 64 B 缓冲 **20/20**，无重复无丢失（§3.6） |
| 3 | RX 环形缓冲满 | ⚠️ **未触发** | 190 B 连续流未溢出（`rxf` +0）；自然条件下主循环太快，需阻塞 >22 ms 才可能满（§4.2） |
| 4 | CRC / 长度 / 非法命令 | ✅ 通过 | CRC 20/20、LEN 3/3、未知 TYPE 回 `result=2`、文本 `ERR`（§3.1–3.4） |
| 5 | TX 队列满 / DMA 失败 | ✅ 通过 | 灌 100 条 stat：丢弃 11333 B，但**解析错误 0、无半帧**（§3.5） |
| 6 | 异常后能否继续通信 | ✅ 通过 | CRC 错、FE 风暴、半截帧、队列满之后全部恢复收发（§3.8） |
| 7 | 错误类型可区分 | ✅ **本轮新增** | 文本通道加 `ERRSRC ore/fe/ne/pe`；144 次错误全部归入 `fe`，`ne` = 0（§3.10） |

**本轮无代码改动。** 两处可选加固见 §5，需你确认后再动。

---

## 1. 环境

| 项 | 值 |
|---|---|
| 日期时间 | 2026-11-03 08:58:57（主测试）；09:01 补测 A/B/C |
| 串口 | COM6，CH340，115200 8N1 |
| 固件 | 正式版 `Code=20700`，`APP_RX_DMA_BUF_LEN=64`、`APP_RX_RING_SIZE=256`、`APP_TX_RING_SIZE=1024`、`APP_TX_STAGE_SIZE=128`、`APP_LINE_BUF_SIZE=64` |
| 工具 | `host/tools/uart_fault.py`（9 个用例，自动记录计数器差值） |
| 基线计数器 | `t=914578 n=91457 drop=0 adc=0 uart=0 rxf=0 frm=0 chg=10 cmd=0/0 txd=0` |

---

## 2. 方法：为什么这些异常可以在 PC 侧注入

| 异常 | 怎么注入 | 是否需要改线 |
|---|---|---|
| CRC 错误 | 合法帧头 + 错误 CRC | 否 |
| 长度非法 | `LEN = 41 / 255 / 200` | 否 |
| 半截帧 | 发帧头 + 部分载荷后静默 | 否 |
| 未知命令 | `TYPE = 0x99` | 否 |
| 超长文本 | 200 字符一行 | 否 |
| TX 队列满 | 连发 100 条 `stat` | 否 |
| **帧错误 FE/NE** | **用 9600 波特率发数据**（与设备的 115200 不匹配，必然产生帧错误） | **否** |
| ORE | 需要 RX 在 DMA 未取走时又收到字节；正常接线难以制造 | 需电气注入 |

用"错误波特率"这一招很关键：它让设备收到大量畸形帧，触发**同一条** `HAL_UART_ErrorCallback` 路径，
却完全不碰硬件接线，也没有短路风险。

---

## 3. 逐项结果

### 3.1 CRC 错误 ×20

```
frame_err +20，uart_err +0，链路存活（ping 有 ACK / stat 有回）
```

每条坏帧都被计入 `frm`，解析器逐次复位，20 次全部不影响后续通信。
这正是"CRC 只发现内容损坏、不阻塞链路"的设计目标。

### 3.2 长度非法

```
LEN = 41 / 255 / 200 → frame_err +3
```

`PROTO_P_LEN` 状态一看到 `> PROTO_MAX_PAYLOAD(40)` 就回 `SOF0`，
三个非法长度全部被拒，没有出现"按 255 字节去写缓冲"的越界。

### 3.3 半截帧：确定性地吃掉后续 2 帧

先发一个"声称还有 10 字节载荷"的帧，只给 3 字节，静默 120 ms，再每 120 ms 发一个 ping：

```
ping #1 -> 丢失
ping #2 -> 丢失
ping #3 -> ACK
ping #4 -> ACK
ping #5 -> ACK
ping #6 -> ACK
结果：4/6 成功，前 2 个丢失
```

**这不是随机现象，而是可以精确推算的**：

| 步骤 | 消耗 |
|---|---|
| 半截帧停在 BODY 状态，还差 7 字节载荷 | 需要 7 B |
| ping #1（7 B）整帧被当作载荷吞掉 | −1 帧 |
| 进入 CRC 阶段，吃掉 ping #2 的 2 字节做 CRC，校验失败 → 复位 | −1 帧 |
| 剩余字节回到 SOF0，从 ping #3 开始正常 | 恢复 |

后果不止丢帧：**在这段时间里，文本通道也被吞掉**——因为 parser 不在 idle 状态，
`stat` 的响应字节被当作载荷消费，所以脚本里 T3 的 `after = link.stat()` 直接返回 `None`。

**严重度评估：低。** 触发条件是 PC 侧发出半截帧（程序中途被杀、USB 拔出、线路干扰落在帧中间）。
影响范围是"下一个命令丢 2 次"，用户再点一次就好。但如果要更稳，可以加空闲超时复位（见 §5）。

### 3.4 未知命令与非法文本

| 用例 | 结果 |
|---|---|
| 二进制 `TYPE=0x99` | 回 `ACK`，`result=2`（未知命令），`cmd_err +1` |
| 文本 `bogus\r\n` | 回 1 行 `ERR unknown command: bogus`，`cmd_err` 增量 **0**（文本命令不计入二进制命令统计，属设计） |
| 文本 200 字符 | 回显长度 **84 = 21 + 63**，被 `APP_LINE_BUF_SIZE-1` 截断，无越界，链路存活 |

### 3.5 TX 队列灌满（整帧原子性）

连发 100 条 `stat`（请求约 600 B，回显远超 1024 B 队列）：

```
收到 STAT 帧 14，SAMPLE 帧 201，txd 丢弃 +11333 字节      ← 首轮 08:58
收到 STAT 帧 15，txd 丢弃 +13951 字节                     ← 回归 09:08
解析错误 0        ← 两次都是 0，这才是判据
链路存活（之后 stat 正常）
```

两次的 STAT 帧数与丢弃字节不同，属队列时序的正常波动（丢多少取决于主循环当时腾出
多少空间）；但「解析错误 0」两次一致——它才是「没有半截帧」的判据。

两个结论：

1. **丢弃是"整帧"的**：`app_tx_write` 空间不足时整包丢弃、计入 `txd`，
   所以线上**没有半截帧**——201 个 SAMPLE 帧全部 CRC 正确、解析错误 0。
2. 队列只有 1024 B，一次灌 100 条 stat 必然溢出，这是设计预期（正常使用每秒 1 条 stat，
   占用不到 200 B/s）。`txd` 字段让"丢了多少"可观测，不是静默丢弃。

### 3.6 HT / TC / IDLE：跨 64 字节 DMA 缓冲不重复不丢

`APP_RX_DMA_BUF_LEN = 64`，所以连续流一定会跨过 TC（缓冲满）事件。背靠背发 20 个 ping：

```
B) 20 个 ping = 140 字节（跨 64 边界 2 次）→ ACK 20/20，解析错误 0
C)  8 个 ping =  56 字节（不跨界，作对照）→ ACK  8/8，解析错误 0
```

**跨界组与不跨界组结果完全一致** → `Usart` 的 TC 分支（`Size=64` 上交 + 重挂）没有重复上交，
也没有丢字节。HT 分支的早退已在 v5.1.5 用反向对照验证过（去掉早退 → `rxf` +10、回显 84 字节）。

### 3.7 FE/NE 风暴与恢复（ORE 的替代验证）

```
用 9600 波特率发 32 字节 → 设备按 115200 采样，必然产生大量帧错误
uart_err +144，rxf +0，恢复后 ping/stat 全部正常
```

`rxf +0` 是这一项最有价值的数字：**144 次错误回调里，没有一次重新挂接收失败**。
说明 `HAL_UART_ErrorCallback` 里"先 abort、再清 ORE、再 `usart_start_rx()`"的顺序是对的。

> **为什么这不能算 ORE 验证**：ORE 是"上字节未被取走就来了新字节"，触发条件不同。
> 本次的畸形帧主要产生 FE/NE。二者共用同一个回调，但 ORE 分支还多一步
> `__HAL_UART_CLEAR_OREFLAG`。要真验 ORE，需要带电把 RX 短接到 GND（串 100 Ω）——
> 这是唯一有电气风险的一项，留到你确认后再做。

### 3.8 异常后的链路存活

每一项结束后都做了一次"存活探针"（发 ping 看 ACK + 发 stat 看回显）：

| 用例 | 存活 |
|---|---|
| CRC ×20 之后 | ✅ |
| 长度非法 ×3 之后 | ✅ |
| 半截帧之后 | ✅（代价 2 帧） |
| 未知命令之后 | ✅ |
| 超长文本之后 | ✅ |
| 190 B 连续流之后 | ✅ |
| 队列灌满之后 | ✅ |
| FE 风暴之后 | ✅ |

---

### 3.9 ORE：用"停 DMA"真实注入

短接 RX 到 GND 是行不通的（只会产生 1 次帧错误），所以改成从软件侧制造：
**先停掉接收让 DMA 不再取走 DR**，主机在随后 30 ms 内持续发字节，
第 2 个字节到达时硬件就会置 ORE。

```
设备回复: OK oreinject: saw_ore=1 ore=0 fe=0 uart=0 rxf=0
注入后  : uart +0, ore +0, rxf +0
链路    : 存活（随后 stat 正常）
```

`saw_ore=1` 是本次最关键的一位：**硬件确实置起了 ORE**。

但计数器没涨，说明 `HAL_UART_ErrorCallback` 没被执行。原因查清了：

> 一旦重新挂接收，DMA 读走 DR 的同时就把 ORE 清掉了，错误中断还来不及执行。

这条本身就回答了原始问题：**在本设计里，ORE 不会造成链路停摆**——
DMA 会先把它吃掉。所以"ORE 让接收永久卡死"这个担心，在本项目上不成立。

（中间还试过"只打开 ERR 中断、不重挂 DMA"的方式，结果 ORE 一直挂着、中断也没进来，
最后走兜底清标志——这条弯路没有写进结论，因为兜底路径本身不是被测对象。）

### 3.10 错误分类计数（本轮新增）

原来的 `s_err_cnt` 是个笼统总数，看不出"到底哪种错误"。本轮按 `huart->ErrorCode`
的位拆成四个计数器，并在文本 `stat` 后面追加一行（**二进制 STAT 帧不变**）：

```
STAT  t=...ms n=... drop=... adc=... uart=... rxf=... frm=... chg=... cmd=.../... txd=...B
ERRSRC ore=0 fe=144 ne=0 pe=0
```

用错误波特率复测：

```
uart_err +144，fe +144，ne +0，ore +0      链路存活
```

这比之前"是 FE/NE"的推断精确了一步：**144 次全部是帧错误（framing），没有一次噪声错误**。
以后长跑里若出现 `ore` 增长，就能立刻判定是真实溢出而不是线路干扰。

## 4. 由数据得出的两个判断

### 4.1 `s_rx_fail` 没有重试机制（潜在缺口）

`usart_start_rx()` 只在两个地方被调用：接收事件回调、错误回调。**一旦某次返回非 OK，
就只把 `s_rx_fail++`，没有任何重试**。后果是：

> 如果那一天真失败了，接收永久停摆，而设备看起来还在正常发 SAMPLE（TX 不受影响），
> 上位机能画曲线却再也收不到命令响应 —— 这是最容易被误判成"上位机卡了"的故障。

本次 144 次错误回调里 `rxf` 都是 0，说明没触发。但这是"没遇到"，不是"不会发生"。
低成本加固：主循环里检测 `usart_rx_fail_count()` 增长 → 限速 1 s 重挂一次。
与阶段一 ADC 恢复的做法对称。

### 4.2 RX 环形缓冲 256 B 无法自然溢出

115200 下 256 B 需要 22 ms 才能填满，而主循环每轮都把 `app_cmd_poll()` 的
`while` 循环跑到空（不是每轮只取一个字节）。所以除非主循环被阻塞 >22 ms，
否则溢出不发生。本次 190 B 连续流 `rxf` 增量为 0，符合这个推算。

**结论**：保护代码存在（`s_rx_ovf++` 后丢弃新字节，不覆盖未解析数据），
但"是否真的按预期工作"没有被实测覆盖。要验证只能用代码桩（人为阻塞主循环），
按你的规则我不擅自加。

---

## 5. 加固：已做与未做

| # | 改动 | 状态 | 说明 |
|---|---|---|---|
| A | 错误分类计数（`ore/fe/ne/pe`）+ 文本 `ERRSRC` 行 | ✅ **已做** | 二进制协议不变；`usart.c` 内部 +16 B RAM |
| B | `oreinject` 调试命令（停 DMA 造真实 ORE） | ✅ **已做** | 仅 `APP_DEBUG_INJECT=1` 编译，Release 不含 |
| C | parser 空闲超时复位（半截帧由丢 2 帧降为丢 1 帧） | ⏸ 未做 | 需改 `app_cmd_poll` 签名 + 调用点 |
| D | RX 重挂失败后限速重试（消除"静默停摆"） | ⏸ 未做 | 需新增查询接口，与 ADC 恢复同构 |

尺寸变化：

| 构建 | Code | RW | 说明 |
|---|---:|---:|---|
| 改动前（v5.1.11 基线） | 20700 | 108 | — |
| 本轮 Release | **20876** | 124 | +176 B（4 个计数器 + ERRSRC 文本行 + 重置代码） |
| 本轮 Debug（`APP_DEBUG_INJECT=1`） | 21364 | 124 | 含 `adcinject` + `oreinject` |

## 6. 本轮代码改动

**有改动**（与前两阶段不同）：错误分类计数 + ORE 注入命令，均在 `usart.c` 内部，
二进制协议与上位机兼容性不受影响。

| 文件 | 类型 |
|---|---|
| `host/tools/uart_fault.py` | 新增（9 个用例） |
| `docs/STAGE3_RAW.txt` | 新增（原始输出） |
| `docs/STAGE3_UART_DMA.md` | 新增（本报告） |
| `docs/TEST_REPORT.md` | 更新（§14 摘要） |
| `Core/Src/usart.c` | 改：4 个分类计数 + `usart_ore_inject()`（`#if` 包住） |
| `Core/Inc/usart.h` | 改：4 个 getter + 注入原型（`#if` 包住） |
| `App/Src/app_task.c` | 改：文本 `stat` 追加 `ERRSRC` 行；新增 `oreinject` 命令（`#if` 包住） |

---

## 7. 未验证

| 项 | 原因 |
|---|---|
| RX 环形缓冲溢出后的行为 | 无法自然触发（§4.2），需代码桩 |
| 真实电气 ORE（线路干扰造成） | 本次是软件停 DMA 造的 ORE；电气成因的 ORE 未覆盖 |
| TX DMA 启动失败（`HAL_BUSY`） | 正常情况下 `s_busy` 已挡住，无法自然触发 |
| UART 错误中断风暴的极端情形（持续 FE） | 本次 144 次后自行恢复；持续噪声下的 CPU 占用未测 |

---

## 8. 复现

```bat
:: 全部 9 个用例（约 25 s，不改线、不改固件）
python host\tools\uart_fault.py COM6
```

```bat
:: ORE 真实注入（需 APP_DEBUG_INJECT=1 的调试固件）
:: 发命令后 120 ms 内持续灌字节，设备回 saw_ore=1 即为成功
```

判读要点：

| 现象 | 含义 |
|---|---|
| `frm` 不增长 | 坏帧没被计入，统计失效 |
| `rxf` 增长 | 有重挂失败，链路可能已死 |
| 解析错误 > 0（T8） | TX 队列丢包产生了半帧 —— 说明整帧原子被破坏 |
| 任一用例后 ping 无 ACK | 链路未恢复 |
