zoumingjie124-ui/single-channel-acquisition/docs/STAGE1_ADC_RECOVERY.md

# 阶段一：ADC 故障恢复验证

> 报告版本：第 2 版（补齐可追溯原始证据）
> 测试日期：**2026-11-02 23:46:02 – 23:47:04**（本次正式采集；另有一次 23:42 的预跑，见 §3.5）
> 原始日志：**`docs/STAGE1_RAW.txt`**（`host/tools/stage1_evidence.py` 生成，可复跑）
> 结论：**恢复链路可跑通；单次恢复耗时 2.1–4.9 ms（平均 3.8 ms）；20 次注入丢样 0**

---

## 0. 结论速览

| # | 检查点 | 结论 | 证据位置 |
|---|---|---|---|
| 1 | DMA 错误是否被记录 | ✅ | 注入 20 次，`adc_err` 精确 +20（§4.3） |
| 2 | ISR 是否只置标志 | ✅ | 恢复耗时 2.1–4.9 ms，无 10 ms 级阻塞（§3.1） |
| 3 | 主循环是否执行 DeInit/Init/校准 | ✅ | 每次恢复都有 `[rec] adc restarted`，17 次全部成功、0 次失败（§3.4） |
| 4 | 重启后是否恢复采样 | ✅ | 30.001 s / 3001 帧 / **100.031 Hz**（§5） |
| 5 | 是否产生重复或无效样本 | ⚠️ 部分 | 样本增量 2018 vs 理论 2018.1，**没有多出任何一帧**；但静态输入下「旧值顶替新值」无法证明（§6） |
| 6 | 失败后是否有重试机制 | ✅ | 1 s 内连注 5 次 → 恢复 2 次，间隔 **997 ms**（§3.2） |
| 7 | 计数是否正确 | ✅ | `adc_err` +20 / 恢复 17 次 / 合并 3 次，三者自洽（§4.3） |
| 8 | 是否影响 TIM3 的 100 Hz | ✅ | 恢复后 100.031 Hz，`seq8` 缺口 0（§5） |

---

## 1. 测试环境与固件版本

| 项 | 值 | 来源 |
|---|---|---|
| 测试日期时间 | 2026-11-02 23:46:02 – 23:47:04 | 日志 `[0]` |
| 主机 | Windows-11-10.0.26200-SP0 | 日志 `[0]` |
| Python | 3.13.14 | 日志 `[0]` |
| pyserial | 3.5 | 日志 `[0]` |
| 串口 | **COM5**，CH340（USB-TTL），115200 8N1，timeout=0.05 | 日志 `[0]` |
| 目标板 | STM32F103C8T6（Blue Pill） | — |
| 固件版本宏 | `APP_FW_VERSION = 0x0500` | 日志 `[0]` |
| 被测固件 | `APP_DEBUG_INJECT = 1`，**Code=20808 / RO 996 / RW 108 / ZI 4916** | 烧录记录 |
| 正式固件 | `APP_DEBUG_INJECT = 0`，**Code=20700**（0 Error 0 Warning） | 编译记录 |
| 输入信号 | PA1 ← 电位器抽头，实测 **1528–1546 mV**（均值 1531.7） | 日志 `[5]` |
| 采集脚本 | `host/tools/stage1_evidence.py`（本次新增，只采集不判定） | — |
| 串口重连次数 | **0**（全程无断链） | 日志末尾 |

> 报告里出现的每个数字都能在 `docs/STAGE1_RAW.txt` 里找到对应行；
> 该文件由脚本一次性写出，不是手工整理。

---

## 2. 故障注入方式与边界

### 2.1 注入机制

`adcinject` 是一条**只存在于调试固件**的文本命令（`#if (APP_DEBUG_INJECT != 0u)` 包住），
作用等价于 DMA 错误中断里那一行：

```c
s_recover_req = 1u;      /* app_measure_on_error() 的核心动作 */
```

之后 `DeInit → Init → 配通道 → 校准 → Start_DMA` 全部由主循环
`app_measure_poll_recovery()` 按原有逻辑执行，**被测代码路径没有被改写**。

### 2.2 这是"路径注入"，不是电气故障

| 能证明 | 不能证明 |
|---|---|
| 恢复流程能跑通、能重复 | 真实 DMA 传输错误（TE/溢出）下的恢复行为 |
| 恢复耗时与丢样代价 | ADC 硬件损坏、时钟异常等场景 |
| 限速与标志合并逻辑 | 故障原因是"持续存在"还是"一次性" |

正常接线下无法人为制造 DMA 传输错误（短接 PA1 只会让读数变化，不产生 DMA 错误），
本项目也没有做电气注入。这条边界不因本次数据而改变。

### 2.3 三组注入的设计意图

| 组 | 次数 | 间隔 | 目的 |
|---|---:|---|---|
| A | 5 | 1.5 s | 测单次恢复耗时（间隔 >1 s，避开限速） |
| B | 5 | 200 ms（总 807 ms） | 测限速：窗口内的请求应被合并 |
| C | 10 | 2.0 s | 测丢样：用累计计数器比对运行时间 |

合计 **20 次注入**，全部记录在 §3。

---

## 3. 注入时刻与恢复耗时（逐条）

### 3.1 组 A：单次注入 ×5

时刻定义：

- `t_send`：脚本写入 `adcinject\r\n` 的时刻
- `t_ack`：收到文本 `OK inject` 的时刻（命令已执行）
- `t_rec`：收到 `[rec] adc restarted` 的时刻（恢复完成）
- **恢复耗时 = t_rec − t_ack**（含主循环剩余步骤 + DeInit/Init/校准/Start_DMA）

| # | 注入时刻（相对组起点） | 回执延迟 | 恢复耗时 |
|---:|---:|---:|---:|
| 1 | 0.251 s | 4.7 ms | **2.5 ms** |
| 2 | 2.013 s | 4.5 ms | **4.9 ms** |
| 3 | 3.776 s | 5.1 ms | **2.1 ms** |
| 4 | 5.540 s | 4.3 ms | **4.7 ms** |
| 5 | 7.304 s | 4.7 ms | **4.7 ms** |

```
min 2.1 ms / max 4.9 ms / 平均 3.8 ms（n=5）
```

> 回执延迟（4.3–5.1 ms）是"写入命令 → 主循环处理 → 文本经发送队列出队"的调度延迟，
> **不属于恢复成本**，所以单独列出、不计入平均值。
> 最重要的一条：**4.9 ms 的最大值仍小于一个采样周期（10 ms）**，因此恢复不会吃掉采样点。

### 3.2 组 B：1 秒内连注 5 次（限速验证）

```
注入时刻(ms) : [0, 201, 403, 605, 807]
恢复完成(ms) : [9, 1006]
恢复失败     : 无
恢复次数     : 2 / 注入 5 次
相邻恢复间隔 : 997 ms        ← APP_ADC_RECOVER_INTERVAL_MS = 1000
```

时间戳说明：

- 第 1 次注入后 **9 ms** 就完成恢复 —— 对应"首次错误立即恢复"（`s_try_started == 0` 的特例）
- 之后 4 次注入（201 / 403 / 605 / 807 ms）只把 `s_recover_req` 置 1；
  主循环在 1006 ms 才执行第二次恢复，间隔 **997 ms**，正好卡在 1 s 限速上
- 窗口内 4 个请求被合并成 1 次恢复 —— 这就是"标志 + 限速"应有的行为，**不是丢失**

### 3.3 组 C：10 次注入（2 s 间隔，逐条时刻）

```
逐条注入时刻(ms)：[0, 2002, 4003, 6005, 8005, 10006, 12008, 14010, 16010, 18013]
恢复完成次数    ：10 / 10（无失败）
```

相邻间隔 2002–2003 ms（脚本按 2.0 s 循环 + 接收开销），全部 >1 s 限速，所以每次都真实恢复。

### 3.4 恢复成败统计

| 组 | 注入 | 恢复成功 | 恢复失败 | 合并掉 |
|---|---:|---:|---:|---:|
| A | 5 | 5 | 0 | 0 |
| B | 5 | 2 | 0 | 3 |
| C | 10 | 10 | 0 | 0 |
| **合计** | **20** | **17** | **0** | **3** |

`[rec] adc restart failed` 全程未出现（日志 `[3]` 里 `恢复失败(ms)：无`）。

### 3.5 关于另一次预跑

23:42 还有一次预跑（当时脚本还没有逐条时间戳），结果：恢复耗时 **2.2–4.6 ms、平均 3.2 ms**，
30 s 采样 99.996 Hz。该次日志已被本次覆盖，**不作正式证据**，仅说明两次独立运行落在同一量级
（2.1–4.9 / 2.2–4.6）。

---

## 4. 丢样核算

### 4.1 为什么不能用 `t_ms` 或 `seq8`

| 指标 | 为什么不能用 |
|---|---|
| `SAMPLE.t_ms` | 它是**主循环处理该样本的时刻**，不是 ADC 转换时刻。恢复期间没有样本被处理，也就没有"间隔变大"的记录——实测全程严格 10 ms，看不出空档 |
| `seq8` | 它统计"已处理样本"的序号。恢复期间没采到的样本**压根不产生序号**，所以缺口恒为 0，无法反映丢样 |

这两个指标都会给出"完美"的假象，是本次最需要说清的测量陷阱。

### 4.2 采用的方法：累计计数 ÷ 运行时间

```
理论样本数 = Δt_ms / 10        （TIM3 配置为 100 Hz，每 10 ms 产生 1 个样本）
实际样本数 = Δn                （STAT 帧里的 n，只在样本被处理时 +1）
丢样       = Δn − round(Δt)
```

`Δn` 与 `Δt` **同取自 STAT 帧**（同一时刻的快照），因此不受主机墙钟、串口延迟影响。

### 4.3 组 C 实测

```
之前 : t=103387 ms  n=10338  drop=0  adc_err=30
之后 : t=123568 ms  n=12356  drop=0  adc_err=40
设备时间增量 : 20181 ms
样本增量     : 2018
理论样本数   : 2018.1
差值         : +0          ← 丢样 0
drops 增量   : 0
adc_err 增量 : +10（= 注入次数）
```

**10 次恢复，丢样 0 个。**

### 4.4 全程计数器一致性核对

| 项 | 数值 | 说明 |
|---|---|---|
| 基线 `adc_err` | 20 | 本次运行前累计（预跑留下） |
| 结束后 `adc_err` | 40 | 全程 +20 = 20 次注入 |
| 实际恢复次数 | 17 | 5 + 2 + 10 |
| 差值 | **3** | 正是组 B 中被限速合并掉的 3 次请求 |
| `drop` | 0 → 0 | 采样环形缓冲从未溢出 |
| `uart_err` / `rxf` / `frm` | 全 0 | 串口侧无错误 |

三个数（20 注入 / 17 恢复 / 3 合并）互相印证，说明标志与限速逻辑按设计工作。

---

## 5. 恢复后 30 秒采样频率统计

### 5.1 方法

```
t0 = time.time()
持续接收 30 s，逐帧解析 SAMPLE（T_SAMPLE=0x81），每帧计 1 个样本
采样率 = 帧数 / (time.time() - t0)
```

同时检查连续性：逐帧比较 `(prev.seq8 + 1) & 0xFF == cur.seq8`，
不等即记一次缺口（用于发现整帧丢失，与固件帧头 SEQ 无关）。

### 5.2 结果

```
墙钟时长     : 30.001 s
SAMPLE 帧数  : 3001
实测采样率   : 100.031 Hz      （设计 100.000）
seq8 缺口    : 0
BOOT 帧      : 0               （中途未复位）
raw_mv       : min 1528 / mean 1531.7 / max 1546
```

### 5.3 口径说明

- **100.031 Hz 不是"超额采样"**：30.001 s 墙钟里含脚本启动/退出开销，
  且 USB 批量到达会让首末帧落点有 1 帧级抖动（1/3001 = 0.033%）。
- 采样率的权威口径是长窗口总账（`TEST_REPORT` §8：601.17 s / 60117 帧 = 100.01 Hz）；
  本次 30 s 只用于确认"恢复之后仍在正常节拍上"。
- `seq8` 缺口 0 与 `drop` 0 一致，说明恢复前后没有整帧丢失。

---

## 6. 「重复/无效样本」为什么只能算部分验证

已排除的情况：

- **没有多推帧**：20 次注入期间样本增量 2018，理论 2018.1，**一帧都没有多**
- **恢复后序号连续**：`seq8` 缺口 0

未排除的情况：

- **旧值顶替新值**：输入是 1531 mV 静态直流（噪声 1528–1546，峰峰 18 mV）。
  若 DMA 重启后把上一次残留的转换值又推一次，它在数值上与相邻正常样本**无法区分**。

要定案需要**动态信号**（缓慢摇电位器或输入斜坡）：那时旧值会明显落后于相邻样本，
一眼能看出来。这条留到阶段二/五补。

---

## 7. 代码改动

### 7.1 本轮（补齐证据）

**无代码改动。**

- 固件：`App/`、`Core/` 下所有文件与提交 `2896d3b` 逐字节一致
  （`git status` 仅两个新文件，无 `M` 项）
- 编译：`APP_DEBUG_INJECT = 0` → **Code=20700 / RO 996 / RW 108 / ZI 4916**，0 Error 0 Warning
- 测试期间唯一的临时动作是把开关改成 `1` 编译注入版（Code=20808）并烧录，
  采完立即改回 `0`、重新编译并烧录；**当前板上是正式版固件**（实测 2 s / 200 帧 = 100.0 Hz）

### 7.2 本轮新增/变更的文件

| 文件 | 类型 | 说明 |
|---|---|---|
| `docs/STAGE1_RAW.txt` | 新增 | 本次采集的原始日志（环境、逐条时刻、计数器） |
| `host/tools/stage1_evidence.py` | 新增 | 证据采集脚本，只落盘不判定；含断链重连 |
| `docs/STAGE1_ADC_RECOVERY.md` | 重写 | 本报告（第 2 版） |
| `docs/TEST_REPORT.md` | 更新 | §12 数字与本次对齐，并指向原始日志 |

### 7.3 上一轮已提交的固件改动（不在本轮）

| 文件 | 改动 | 进 Release |
|---|---|---|
| `App/Inc/app_config.h` | `APP_DEBUG_INJECT`，默认 `0u` | 否 |
| `App/Src/app_task.c` | 文本命令 `adcinject`，整段 `#if` 包住 | 否 |

尺寸证明它确实没编进去：开关 `0` → 20700（与改动前一致）；`1` → 20808（+108 B）。

---

## 8. 尚未验证（诚实清单）

| 项 | 为什么没做 | 后续 |
|---|---|---|
| 真实 DMA 电气故障下的恢复 | 正常接线无法制造 TE/溢出；不做电气注入 | 依赖长时间运行出现 `adc_err > 0` 的真实样本（阶段五） |
| `DeInit/Init` 失败路径（`recover_fail`） | 正常硬件不会失败 | 需编译桩实验（把 `ADC1_RecoverInit` 替成 `return 0`），单独构建验证 |
| 旧值顶替新值 | 静态直流下与噪声不可分辨 | 需动态信号（摇电位器/斜坡） |
| 持续失败时的降级策略 | 属设计取舍，未定 | 需先决定：是否告警/停机 |
| 8 小时稳定性 | 未做 | 阶段五 |
| 采样时间戳精度 | `t_ms` 是处理时刻，不是采集时刻 | 若后续要测抖动，需在 ISR 里打 DWT 时间戳 |

---

## 9. 复现步骤

```bat
:: 1) 打开注入开关
::    App/Inc/app_config.h:  #define APP_DEBUG_INJECT   1u
CD MDK-ARM
UV4.exe -r DataAcq.uvprojx -j0 -o build.log     :: 应得 Code=20808
UV4.exe -f DataAcq.uvprojx -j0 -o flash.log     :: Verify OK

:: 2) 一次性采完三组注入 + 30 s 采样 + 计数器，写入 docs/STAGE1_RAW.txt
CD ..
python host\tools\stage1_evidence.py COM5        :: 约 70 s

:: 3) 关闭开关、重编、重烧，恢复正式固件
::    #define APP_DEBUG_INJECT   0u  → Code=20700
UV4.exe -r DataAcq.uvprojx -j0 -o build.log
UV4.exe -f DataAcq.uvprojx -j0 -o flash.log
```

判读要点：

| 现象 | 含义 |
|---|---|
| `ERR unknown command: adcinject` | 板上不是注入版固件（开关没开或没重烧） |
| `恢复耗时` 明显 >10 ms | 恢复会吃掉采样点，需查 DeInit/校准耗时 |
| `相邻恢复间隔` < 950 ms | 1 s 限速失效 |
| `差值` ≠ 0 | 存在丢样，需按 §4.2 逐项核对 |
| `串口重连次数` > 0 | 采集中断过，该次数据的连续性存疑 |

> 本次在 23:44 的一次尝试中，接收端曾出现 `PermissionError 13`（CH340 句柄短时失效），
> 后续已给脚本加入断链重连与"异常也落盘"；
> 正式采集（23:46）**重连次数 0**，数据完整。
