zoumingjie124-ui/single-channel-acquisition/docs/STAGE8D_EVIDENCE.md

# Stage 8D / R21 证据：GUI 按钮连真板（D-1 ~ D-12）

> **结论：通过（GUI 控件自动化 + 人手拧电位器 + 真机）**。D-1~D-12 全部执行并留证；判据 **P-1~P-5、P-7 满足**，
> **P-6 仅 D-9 部分满足**（重连快照 `active=0` 分支未造出），**P-8 在 6 s 窗口内满足**。
> **按钮不是人手点的**（脚本合成鼠标事件），但**电位器动作全部由用户本人手动完成**；
> 也不是"8D 全部无保留通过"——边界见 §5。
>
> 时间：2026-11-05 16:26:24 – 16:30:01　｜　设备：`Code=22468`，`DIAG en=1`　｜　链路：COM5 / `LOCATION=1-2.1.3`

---

## 1. 方法与证据等级（先读这段）

| 项 | 事实 |
|---|---|
| 界面 | 本项目真实 GUI（`host/main.py` 的 `MainWindow`，非演示源 `demo=False`） |
| **按钮类操作**（D-1/3/6/7/8/10/12） | `QtTest.mouseClick(widget, Qt.LeftButton)` —— 合成**鼠标按下/释放事件**，走完整控件事件链（press/release → `toggled`/`clicked` → 同一槽函数）。**不是人手点击** |
| **电位器类操作**（D-9 / D-11，含 D-4 的"停手"） | **用户本人手动拧 / 松手**，执行代理不接触硬件。物理量变化是真实输入，不是模拟数据 |
| 人机配合 | 脚本跑到需要物理动作的步骤时**停下来轮询**（`run_8d.py:85-96`，每 500 ms 查一次标志文件，**无超时**），控制台打印 `>>> 等待人工动作：…`；用户拧完回话后，执行代理创建 `go1.flag` / `go2.flag` 放行 |
| 串口 | 真实 COM5，真实固件 `Code=22468`，中途真实断开与重连 |
| 截图 | 脚本用 `PIL.ImageGrab` 抓 `win.frameGeometry()` 区域。**实测有缺陷**：DPI 缩放导致抓取坐标与窗口实际位置不一致，抓到的画面里窗口会偏移、四周带出前台其它窗口；**只有 D-1/D-3/D-6/D-7/D-8 五步抓到可用的纯 GUI 画面**（已裁掉四周并归档），D-9/D-4/D-10/D-12 四步的抓图无效（见 §6.3），这四步的界面证据改用 GUI 文本通道日志 |
| **不包含** | **人手点击按钮**、**人手拔插 USB**（D-10 用界面"断开"按钮）；**手势/触屏命中** |

因此证据等级写作 **"GUI 控件自动化 + 人手拧电位器 + 真机"**：能证明"控件事件 → 上位机逻辑 → 串口 → 固件"整条链路，
且电位器侧的物理输入是真实手感操作；**不能**证明"鼠标能点中按钮""布局遮挡""触屏/高分屏命中"这类人工交互问题。

> 2026-11-05 16:11–16:13 另有一次**人工点击**：用户手动点「使能诊断」「查询故障状态」，
> 设备侧留下 `en=1 / conf=1 / cmd 0→3`，界面截图见对话记录。本次自动化不替代该次，两者互补。

## 2. 环境

```
主机：Windows 11，睡眠/休眠 0/0，USB 选择性暂停关，自动校时 NoSync
串口：COM5 | CH340 | VID:PID=1A86:7523 | LOCATION=1-2.1.3
固件：Code=22468 RO=1076 RW=148 ZI=4972（2026-11-03 23:14 烧录，未重烧）
设备起点：t=1925036ms 附近，drops/adc/uart/frm 全 0
输入：电位器，静置约 942 mV（NORMAL 区中部）
```

## 3. 逐步记录（截图 + 对应日志行；截图为 0 或 1 张/步，仅 5 步可用，见 §6.3）

### 3.0 人机分工与时间轴（先看这张，才知道哪一步是谁做的）

| 时段（墙钟） | 谁在做 | 内容 |
|---|---|---|
| 16:26:24 – 16:26:37 | **脚本** | D-1、D-3、D-6、D-7、D-8 五个点击，间隔约 3 s，全程无人工介入 |
| 16:26:37 – **16:27:59** | **用户（人手拧电位器）** | 脚本停在 `>>> 等待人工动作：把电位器拧动使得故障恢复（界面转"无"），再停手`，每 500 ms 轮询 `go1.flag`；用户拧动后回话，执行代理置 `go1.flag` 放行（放行时刻由 D-9 抓图 16:28:03 反推：−1.2 s −3 s ≈ 16:27:59，**等人工约 82 s**） |
| 16:28:03 | **脚本**（放行后 +1.2 s 起算 +3 s） | 抓 D-9 截图；此时设备侧已出现 `故障恢复 … 当前故障：无` |
| 16:28:09 | **用户停手**（已成事实）+ **脚本静置 6 s 抓图** | D-4：停手后静置，等"确认"事件；**事件表 4 行（以日志 `[table_rows]` 为准，截图不含事件表）** |
| 16:28:13 | **脚本** | D-10 点「断开」 |
| 16:28:13 – 16:30:01 | **用户（人手拧电位器，断线中）** | 脚本停在 `>>> 等待人工动作：断线期间把电位器拧到另一个位置（制造变化）`，轮询 `go2.flag`；**断线窗口共约 108 s**，其中实际拧动时长**未记录** |
| 16:30:01 | **脚本** | D-12 点「连接」重连，自动 `GET_DIAG`、快照回填 |

> **动作归属的确认**：本轮 D-9、D-11 的电位器动作**全部由用户本人完成**（用户确认"都是我拧的"，执行代理从未触碰硬件）。
> **"未记录"的边界**：拧动的起止时刻、持续时长、停止位置**均未计时**；按用户要求"以记忆为准，记不清的写'未记录'"，
> 因此这里统记为**未记录**，不事后补猜。
> 能从日志拿到的只有上界：D-9 那一次的设备侧事件跨度 `t=1991401 → 2014631 ms` 约 **23.2 s**（含中途反复恢复/确认），
> 这不是"拧了 23.2 s"，只说明这段时间内发生过 4 次状态变化。D-11 的停止位置更无从得知，
> 唯一的间接证据是重连快照仍显示 `STUCK`（`t=2115838 ms`），即"松手后设备仍判为卡死"。

### 3.1 逐步表

| # | 操作 | **谁做** | 实际结果 | 截图 | 关键日志行 |
|---|---|---|---|---|---|
| **D-1** | 连接 COM5 | 脚本点击 | `已连接 COM5`；曲线开始；**自动查询** | `01_D1_connected.png` | `查询故障状态（连接后自动）` → `应答 GET_DIAG -> OK` → `状态同步：当前故障 STUCK（t=1925036ms）` |
| **D-3** | 勾选「使能诊断」 | 脚本点击 | 复选框 `True`，ACK OK | `02_D3_enabled.png`（**仅曲线区**，复选框/事件表未入镜） | `故障诊断：使能（等 ACK 确认）` → `应答 SET_DIAG -> OK` |
| **D-6** | 故障仍 ACTIVE 时**取消勾选** | 脚本点击 | 面板转 `未使能`；故障不清零 | `03_D6_disabled.png`（**仅曲线区**，复选框/事件表未入镜） | `故障诊断：关闭（等 ACK 确认）` → `应答 SET_DIAG -> OK` |
| **D-7** | 关闭态点「查询故障状态」 | 脚本点击 | 快照返回 `STUCK`；**事件表仍 0 行** | `04_D7_query_while_disabled.png`（**仅曲线区**，复选框/事件表未入镜） | `查询故障状态` → `应答 GET_DIAG -> OK` → `状态同步：当前故障 STUCK（t=1934883ms）` |
| **D-8** | 重新勾选「使能诊断」 | 脚本点击 | 状态仍 ACTIVE；**无新确认上报** | `05_D8_reenabled.png`（**仅曲线区**，复选框/事件表未入镜） | `应答 SET_DIAG -> OK`；此后 1 min 内无"故障确认"行，直到 D-9 拧动 |
| **D-9** | 拧动电位器使故障恢复 | **人手（用户本人）**；脚本轮询 `go1.flag` 等待 | 恢复事件；面板转 `无` | `—`（抓图无效，见 §6.3；状态靠日志行） | `故障恢复：STUCK 卡死（t=1991401ms，span=3048mV，当前故障：无）` |
| **D-4** | 停手静置 | **人手停手（用户本人）** + 脚本静置 **6 s** 后抓图 | 新确认事件；事件表 **0 → 4 行** | `—`（抓图无效，见 §6.3；事件表行数靠日志） | `故障确认：STUCK 卡死（t=1995441ms，span=5mV）`、`（t=2014631ms，span=12mV）` |
| **D-10** | 点「断开」 | 脚本点击 | `已断开 COM5`；曲线停；**未崩溃** | `—`（抓图无效，见 §6.3；断开状态靠日志行） | `断开：已断开 COM5（界面数据保留，重连后可继续）` |
| **D-11** | 断线期间拧电位器 | **人手（用户本人）**；脚本轮询 `go2.flag` 等待 | 无界面报错（断线中） | —（断线无画面） | 无（断开期间不上报）；**拧动时长与停止位置未记录**，断线窗口约 108 s |
| **D-12** | 点「连接」重连 | 脚本点击 | **自动 GET_DIAG**；面板按快照更新 | `—`（抓图无效，见 §6.3；自动查询靠日志行） | `已连接 COM5` → `查询故障状态（连接后自动）` → `应答 GET_DIAG -> OK` → `状态同步：当前故障 STUCK（t=2115838ms）` |

**备注（D-9 / D-4 的顺序）**：设备起点已是 ACTIVE（`conf` 早已为 1），无法产生"新的一次确认"。
因此把 D-4 排在 D-9 之后：先由用户拧出 CLEAR 态，再静置 → 才产生**新的**确认事件。
日志显示一次完整的 CLEAR→CONFIRM 循环，并因操作幅度较大（拧到 3038 mV）伴随
`WARN → CRIT → WARN → NORMAL` 的告警切换——**属正常告警行为，不是缺陷**。

## 4. 判据 P-1 ~ P-8

| 判据 | 判定 | 依据（可核对处） |
|---|---|---|
| **P-1** 连接后自动查询 | **满足** | D-1、D-12 两次日志首行均为 `查询故障状态（连接后自动）`，随后 ACK + 快照 |
| **P-2** 快照不冒充事件 | **满足** | D-7 查询后事件表 0 行；D-12 快照后仍 4 行（无新增） |
| **P-3** ACK 先于快照 | **满足** | 每次顺序均为 `查询…` → `应答 GET_DIAG -> OK` → `状态同步…` |
| **P-4** 关闭诊断不清故障 | **满足** | D-6 关闭后，D-7 查询仍返回 `STUCK`（`active=1` 驻留） |
| **P-5** 重新使能不重复上报 | **满足** | D-8 的 `SET_DIAG OK` 之后无立即"确认"；直到 D-9 拧动才产生 |
| **P-6** 恢复后显示清除 | **部分满足（仅 D-9）** | D-9 有 `故障恢复 … 当前故障：无` 的日志行（`t=1991401 ms`、`span=3048 mV`），**但两处未证**：① 该步抓图无效（§6.3），转"无"的瞬态**没有截图**；② **重连快照 `active=0` 的分支未造出**（D-12 快照仍是 `STUCK`） |
| **P-7** 断线重连 | **满足** | 断开 → 重连 → 自动查询 → 快照；全程无异常弹窗、无崩溃、进程 exit 0 |
| **P-8** 采样不受影响 | **部分满足** | 6 s 窗口 `10933−10333 = 600` 帧 → **100.0 Hz**（分辨率 ±0.2 Hz）；全程 `drops=0`、`errs=0/0/0`、累计 13512 帧 |

## 5. 边界与 OPEN（不得省略）

1. **按钮不是人手点的，电位器是人手拧的**：D-1/3/6/7/8/10/12 的点击由 `QtTest.mouseClick` 合成（见 §1），
   对外只能写"GUI 控件自动化"；D-9、D-11 的电位器动作、以及 D-4 的"停手"**确实由用户本人手动完成**。
   合起来的对外表述是 **"GUI 控件自动化 + 人手拧电位器 + 真机"**，缺一不可——
   写"全自动"会否认人工输入，写"全人工点击"会否认脚本驱动控件。
2. **D-12 判别力偏弱（OPEN）**：重连前本地状态本就是 `STUCK`，快照回来也是 `STUCK`
   （`t=2115838 ms`），因此只证明了"自动查询 + 面板按快照更新"，
   **没有造出"本地旧状态 ≠ 设备快照"的对比**。
   **原因与 D-11 直接相关**：D-11 的拧动**时长与停止位置都未记录**，只在 108 s 的断线窗口里"拧到另一个位置"；
   由于停手后输入仍落在卡死判定区，设备在断线期间又自行确认了一次（`t=2115838 ms`），
   于是快照与旧状态恰好一致 → 判别力被抹平。
   补强方法：断线期间**持续**拧动 ≥3 s 让故障进入 CLEAR，**在 2–3 s 内立刻重连**（趁设备尚未重新确认），
   此时快照应为 `无` 而本地仍是 `STUCK`，才有判别力；且这次必须记录拧动的起止时刻与停止电压。
3. **P-8 是短窗口**：6 s / 600 帧，只能说明"这段时间 100.0 Hz"，不等于全程速率。
4. **D-13 已移出真机范围**（坏 CRC / 未知帧类型），不计入 R21 关闭条件（`STAGE8_PLAN.md` §6.7）。
5. 本轮**未**验证：高分屏/触屏命中、按钮禁用态、串口被抢占时的界面行为。
6. **截图只有 5 张可用**（D-1/D-3/D-6/D-7/D-8），**不是 9 张**：`shot()` 用逻辑坐标当物理像素，
   125% DPI 下抓偏，D-9/D-4/D-10/D-12 四张抓到的是前台其它窗口（含本机路径），已从仓库移除（原件在仓库外）。
   这四步的界面状态**只能靠日志行**，不能写"有截图证明界面转绿/已断开"。

## 6. 证据清单

```
docs/stage8d/
  STAGE8D_LOG.txt                 9,095 B  SHA-256 b4ff25de…dcf8f（脱敏后，见 §6.1）
  run_8d.py                       5,678 B  归档脚本（脱敏版，见 §6.2）
  01_D1_connected.png            26,351 B  ┐
  02_D3_enabled.png              26,374 B  │ 5 张可用 GUI 截图，
  03_D6_disabled.png             26,351 B  │ 已裁掉窗口外区域（见 §6.3）
  04_D7_query_while_disabled.png 26,362 B  │
  05_D8_reenabled.png            26,230 B  ┘
```

`STAGE8D_LOG.txt` 是步骤级记录（每步的 `[conn]/[fault]/[diag_chk]/[table_rows]/[samples]` 与日志尾），
文末附**全程 GUI 文本通道日志**，可直接检索 `故障确认 / 故障恢复 / 应答 GET_DIAG`。

**只有 5 张 GUI 截图，不是 9 张**——D-9 / D-4 / D-10 / D-12 四步的抓图无效（原因见 §6.3），
这四步的界面状态以 `STAGE8D_LOG.txt` 的日志行 + 设备侧读数为证。原 9 张未处理截图保留在仓库外。

### 6.1 脱敏说明（`STAGE8D_LOG.txt`）

| 项 | 值 |
|---|---|
| 脱敏前（= `_8d/report.txt` 原件的副本） | **9,425 B**，SHA-256 `e78629924439ce8048918f6d9b6d18f72fcf851bc86f58e8e7eaafb609c34c79` |
| 替换规则 | 把本机绝对路径前缀（`<盘符>:\Users\<用户名>\<工具目录>\<会话目录>`，ASCII **44 B**）**整段**替换为 `<工作目录>`（UTF-8 **14 B**）；此处**不再抄录真实路径**，避免脱敏说明本身泄露用户名 |
| 替换处数 | **11 处**（行 5/20/37/56/77/97/101/121/142/162/167），全部是 `[pix]` 截图路径与 `go1.flag`/`go2.flag` 提示行 |
| 脱敏后 | **9,095 B**（9,425 − 11×30），SHA-256 `b4ff25dee0dafbb4566a43deb6eb11650ea46415b7f928969bbfd869859dcf8f` |
| 未改动 | 换行（CRLF 217 处不变）、行序、全部时间戳与计数（`t=…ms`、`samples`、`drops`、`errs`、`gap`） |

可复算性：按上表规则把 `<工作目录>` 还原成原前缀（11 处），即可逐字节复原 9,425 B / `e7862992…c34c79`
的那份文件——仓库外的 `_8d/report.txt` 就是原件，可用于交叉验证。**除该前缀外没有任何字符被改动。**

### 6.2 归档脚本 `run_8d.py`（脱敏版）

| 项 | 值 |
|---|---|
| 原件（仓库外） | 153 行 / 4,976 B，SHA-256 `500c68256cfa256fe0bbc49101523695fd9b7c4b80ddeca1e13bbed6082118f6` |
| 归档版 | 164 行 / 5,678 B，SHA-256 `5db8d05c7364c8c7a450fbbb6782ec8272e2b0cc7ed6994735a258a14fc6414a` |
| 改动 1（路径） | `HOST = r"C:\Users\<用户>\Desktop\<项目>\host"` → `PROJ`（环境变量 `STAGE8D_PROJ`，默认本文件上两级）+ `os.path.join(PROJ, "host")` |
| 改动 2（路径） | `OUT = r"C:\Users\<用户>\...\_8d"` → 环境变量 `STAGE8D_OUT`，默认本文件同级 `_run` |
| 改动 3（仅注释） | 文件头补「归档版说明」与运行方式；docstring 里 `真串口 COM5` → `真串口`，证据等级描述同步为"控件自动化 + 人手拧电位器 + 真机" |
| **未改动** | **全部逻辑**：`click()` 用 `QTest.mouseClick`、`wait_flag()` 500 ms 轮询、时间轴 `4000/4500/7000/7500/10000/10500/13000/13500/16500/17500` ms、`after_pot_recover` 的 `3000/9000/10500`、`do_disconnect` 的 `2500/3500`、`after_pot_disconnected` 的 `5000/7000`、截图 tag 名与日志文本 |

核对方式：`difflib.unified_diff(原件, 归档版)` 只有 3 处 hunk（docstring 两段 + 路径两行），
上表已逐项列出；除路径解析外**没有第二处行为差异**。

### 6.3 截图的有效性与裁剪（重要）

**脚本缺陷**：`ImageGrab.grab(bbox=win.frameGeometry())` 把 Qt 逻辑坐标直接当成物理像素用，
在 125% DPI 缩放下抓取区域与窗口实际位置错位，抓到的画面里窗口会整体偏移、四周带出**前台其它窗口**
（含当时的对话窗口，其文字里有本机绝对路径）。

逐张实测结论：

| tag | 实际内容 | 处置 |
|---|---|---|
| `01` `02` `03` `04` `05` | **纯 GUI 窗口**，但左侧约 132 px、上方约 52 px 是别的窗口 | **裁剪到窗口内**（`(132,52,1180,790)`）后归档；裁剪后无任何外部界面、无路径、无用户名 |
| `06_D9_recover` | **完全是对话窗口**，画面里没有 GUI | **不归档**（无证据价值，且含本机路径） |
| `07_D4_confirm_after_idle` | GUI 只露出右半（窗口偏到 x≈318），左半是对话窗口 + 路径 | **不归档** |
| `08_D10_disconnected` | GUI 在下半部、上方是对话窗口；左侧还有文件列表 | **不归档** |
| `09_D12_reconnected` | 同类混合画面 | **不归档** |

**覆盖范围（必须知道）**：这 5 张**只覆盖窗口左半**——`串口 / 刷新 / 波特率 / 断开 / 已连接 COM5` 一行 + **实时曲线**（raw/filt 图例、2400/3000 阈值虚线）；**不含右侧的诊断面板、统计面板与事件表**（不是裁剪裁掉的，是 `ImageGrab` 当初就只抓到那一片）。因此涉及"「使能诊断」已勾选""`序号缺口`/`整帧丢失` 显示什么""事件表有几行"这类右半面板的结论，**一律以 GUI 文本通道日志（`[diag_chk]`/`[table_rows]`/`[samples]` 行）与设备侧 `en/conf/mask/rep` 为准，不得用这 5 张截图佐证**。

因此：
- 仓库内 **5 张截图**（D-1/D-3/D-6/D-7/D-8）是"裁剪后的纯 GUI 画面"，可对外；
- **D-9/D-4/D-10/D-12 没有可用界面截图**，只用日志行与设备读数作证——这不改变 P-6/P-7 的判定依据，
  但**任何地方都不得再写"每步一张截图"或"9 张截图"**；
- 9 张原件 + 未脱敏 `report.txt` **全部留在仓库外**，需要时按 §7 重跑补拍（并先修 `shot()`
  的 DPI 换算：用 `devicePixelRatio` 缩放 bbox，或在截图前 `win.activateWindow()` + 校验画面）。

## 7. 复现

脚本：**`docs/stage8d/run_8d.py`（归档脱敏版，见 §6.2）**；原件在仓库外。
运行时先设 `STAGE8D_PROJ=<项目目录>`、`STAGE8D_OUT=<输出目录>`（默认写到脚本同级 `_run/`，不会污染仓库）。
流程为固定时间轴 + 两个人工握手点（文件 `go1.flag` / `go2.flag`），因为 D-9 / D-11 必须由人手拧电位器：

```
wait_flag()  run_8d.py 内 wait_flag()   每 500 ms 轮询标志文件，无超时（可无限等）
收到 go1     +1.2 s 起算 → +3 s 抓 06_D9_recover → +9 s 抓 07_D4（静置 6 s）→ +10.5 s 点断开
收到 go2     +1.2 s → 09_D12 重连
```

重跑前需确认：COM5 在位、`en` 状态、输入保持静置。
**下一轮必须改的两处（写在这里免忘）**：
1. **修 `shot()` 的 DPI 换算**——用 `devicePixelRatio()` 缩放 bbox（或改用 `win.grab()` 直接抓控件），
   并在截图后校验"画面里确实是本 GUI"；否则仍会出现本轮 4 张抓错窗口的情况（§6.3）。
2. D-9 / D-11 由用户拧动时，请用户报一次起止时刻与停止电压，不再出现"时长与位置未记录"；
   D-12 的补强场景按 §5 第 2 条设计（CLEAR 后 2–3 s 内立刻重连）。
