zoumingjie124-ui/single-channel-acquisition/docs/STAGE7C_FAULT_PROTOCOL.md

# Stage 7C：故障诊断协议与上位机集成 —— 交付报告

> 日期：2026-11-03（固件侧 19:3x 完成，上位机与板级 19:4x–19:5x）
> 范围：在 7B 的 `app_diag` 之上加**协议上报**（`0x86 FAULT`）、**配置命令**（`0x15 SET_DIAG`）、
> 上位机支持，并把 7B 被卡住的"触发/恢复"补上板级验证。
>
> **没有重写 `app_diag.c`**；`app_filter` / `app_alarm` / `app_measure` / ADC / DMA / 定时器
> 一行未改；SAMPLE(10B) 与 STAT(37B) 长度字段未动；诊断默认仍是**关闭**。

---

## 1. 修改文件清单与原因

### 1.1 固件

| 文件 | 新增/修改 | 改了什么 | 为什么 |
|---|---|---|---|
| `App/Inc/app_fault.h` | 新增 | 登记表接口 + `app_fault_t`（1 字节掩码） | 把"诊断结论"翻译成"该不该发帧/发什么字节"，与判据解耦；HAL-free 才能上 PC 测 |
| `App/Src/app_fault.c` | 新增 | 跃变判定（确认/恢复各发一次）+ 9 字节载荷构造 + 位掩码 | 重复抑制与多故障并存是必须被测到的行为，不能埋在 `app_task.c` 里 |
| `App/Inc/app_proto.h` | 修改 | `PROTO_T_FAULT 0x86`、`PROTO_T_SET_DIAG 0x15`、`PROTO_LEN_FAULT 9`、`PROTO_LEN_SET_DIAG 1`、`PROTO_FAULT_EV_*`/`PROTO_FAULT_ID_*`/`PROTO_FAULT_MASK_*` | 协议常量集中地；沿用"两端只认这一个头文件"的既有约定 |
| `App/Inc/app_cmd.h` | 修改 | `app_cmd_ops_t` 加 `set_diag` 回调 | 复用现有 ops 表，不另建命令体系 |
| `App/Src/app_cmd.c` | 修改 | `on_frame()` 加 `case PROTO_T_SET_DIAG`：先挡 LEN 再挡取值，最后才进回调 | 非法命令必须在**碰回调之前**被拒；ACK 仍由既有 `send_ack` 统一发 |
| `App/Src/app_task.c` | 修改 | `ctx_set_diag()`、`fault_emit()`、`process_sample()` 里一行 `app_fault_update()`、`init` 一行、文本 `diag on\|off`、`stat` 增 `DIAG` 行 | 把模块接进真实数据流；`DIAG` 行让"没有上位机也能确认状态"（7B 报告里缺的就是这个） |
| `MDK-ARM/DataAcq.uvprojx` | 修改 | App 组加 `app_fault.c` | 不加则链接期 L6218E |

### 1.2 上位机

| 文件 | 改了什么 | 为什么 |
|---|---|---|
| `host/protocol.py` | `T_FAULT=0x86`/`T_SET_DIAG=0x15`、`Fault` 数据类、`parse_fault()`、`build_set_diag()`、`decode_many` 分支、`FAULT_*` 常量 | 解析与构造集中在一处，界面与工具共用 |
| `host/main.py` | 故障诊断面板（使能勾选框 + 当前故障 + 最近事件）、`_on_fault()`、`_toggle_diag()`、`T_FAULT` 加入"已知类型"集合 | 不加最后那条会被当成"未知帧类型"每帧刷日志 |
| `host/tests/test_fault_joint.py` | 新增 11 项：三组契约向量跨语言对拍 | 两侧各自测自己证明不了"两端一致" |
| `host/tests/test_fault_host.py` | 新增 11 项：未知帧/坏 CRC/错长度/连续多帧/逐字节喂/旧协议兼容 | 接收线程被打挂会表现为"界面假死"，必须专门锁住 |
| `host/tests/test_firmware_sync.py` | 加 2 项：新常量一致性 + `app_fault.c` 载荷偏移检查 | 常量漂移是这类多端项目最常见的坑 |
| `host/tests/gui_smoke.py` | 加 4 项：勾选下发 / 确认显示 / 恢复显示 / 未知帧不致命 | 用软件模拟喂帧，验证界面联动（**不是板级**） |
| `host/tools/diag_watch.py` | 新增：盯 FAULT 帧的小工具 | 板级测试要"人拧电位器 + 机器记录"，GUI 会独占串口 |

### 1.3 测试基建

| 文件 | 为什么 |
|---|---|
| `fw_tests/test_fault.c` | 载荷布局、契约向量、确认/恢复、500 次重复调用零上报、多故障并存 |
| `fw_tests/test_cmd.c` | 在 PC 上跑**真实** `app_cmd.c` 分发器，覆盖 SET_DIAG 合法/非法/长度/回调拒绝/未知命令/坏 CRC |
| `fw_tests/stub_board.c` / `.h` / `stm32f1xx_hal.h` | 让 `app_cmd.c` 能在 PC 上链接（HAL 符号打桩）。**仅测试用，不进固件** |

---

## 2. 新增协议帧

### 2.1 FAULT (0x86) — 9 字节

| 偏移 | 字段 | 类型 | 说明 |
|---|---|---|---|
| 0 | `t_ms` | u32 | 事件时刻 |
| 4 | `event` | u8 | **1 = 确认，2 = 恢复** |
| 5 | `fault_id` | u8 | 故障种类；0 保留 |
| 6 | `active` | u8 | 上报**之后**仍处于已确认态的位掩码 |
| 7 | `value` | u16 | 观测量；`STUCK` = 最近结算块的 span（mV） |

- 只在**跃变**时发：确认一次、恢复一次，ACTIVE 期间不重复（500 次连续调用零上报，有用例）；
- `active` 用掩码而非单值：多故障并存时恢复只清自己那一位，其余位原样带出；
- 帧头 SEQ 仍走设备全局帧序号，**不破坏**现有序号连续性统计。

契约向量（`fw_tests/test_fault.c` 与 `host/tests/test_fault_joint.py` 共用同一串字节）：

```
确认：AA 55 86 09 00 B8 0B 00 00 01 01 01 0C 00 F9 45
恢复：AA 55 86 09 01 70 17 00 00 02 01 00 78 00 54 D2
```

### 2.2 SET_DIAG (0x15) — 1 字节

| 偏移 | 字段 | 取值 |
|---|---|---|
| 0 | `enable` | 0 = 关闭，1 = 使能 |

**应答规则**：`LEN ≠ 1` 或 `enable > 1` → ACK `result=1`（参数错误），**不进回调**；
合法 → 调 `ctx_set_diag()`，成功后 ACK `result=0`。
**ACK 在配置生效之后发出**，所以"收到 OK"就代表已经切好。
关闭诊断不清故障掩码——一个真实存在的故障不该因为关了诊断就消失。

---

## 3. 测试结果（按证据强度分四类，不许混读）

### 3.1 类 A：PC 单元测试（不接板）

| 套件 | 数量 | 结果 |
|---|---|---|
| 固件 C（GCC 4.9.2，`-Wall -Wextra -Werror -O2`，编译**仓库里的真实源码**） | **892 项断言** | **0 失败** |
| 上位机 Python | **52 项** | **OK** |
| 界面冒烟（offscreen，含 4 项 7C 新增） | 1 次运行 | **PASS** |

`fw_tests` 从 288 项涨到 892 项，新增的 `test_fault.c` / `test_cmd.c` 覆盖：
载荷布局、3 组契约向量、确认事件、500 次重复调用零上报、恢复事件、无确认不报恢复、
恢复后再确认、多故障并存（恢复 STUCK 后掩码仍保留 0x02）、未知 fault_id、`emit=NULL`、
SET_DIAG 0/1 合法、2/255 非法、len=0/2 非法、回调拒绝、未知命令、坏 CRC 不发 ACK、
SET_LED/GET_STAT 回归。

> **这一类证明不了任何硬件行为**，它只证明代码逻辑与两端约定自洽。

### 3.2 类 B：软件模拟（跑在 PC 上，构造数据）

- `gui_smoke.py` 往界面里喂合成的 FAULT 确认/恢复帧，断言标签从"无"变"STUCK 卡死"再变回"无"；
- 喂未知类型 `0x99` 后紧跟一帧 SAMPLE，断言采样数 +1 且解析错误仍为 0。

**这是模拟，不是板级**：它证明界面能正确反应，证明不了设备真的会发。

### 3.3 类 C：真实板卡（烧录 + 运行，输入是真实电位器）

固件 `Code=22204`，COM6，115200，上电后输入 942 mV 静置。

| # | 动作 | 结果 | 判定 |
|---|---|---|---|
| 1 | 诊断未使能，观察 3 s | **FAULT 0 帧** | ✅ 默认关闭不误报 |
| 2 | `SET_DIAG(1)` | ACK `result=OK` | ✅ |
| 3 | 保持输入不动 | **约 3.0 s 后 1 帧 FAULT 确认**，`value=9 mV`、`mask=0x01` | ✅ 与 3 块×1 s 设计一致 |
| 4 | `stat` | `DIAG en=1 state=2 conf=1 span=9 unev=0 mask=1` | ✅ 内部状态与帧一致 |
| 5 | `SET_DIAG(2)` | ACK `result=1`（参数错误），`en` 仍为 1 | ✅ 非法值进不到回调 |
| 6 | `SET_DIAG` 且 `LEN=2` | ACK `result=1` | ✅ |
| 7 | `SET_DIAG(0)` | ACK OK，**期间 0 帧 FAULT**，`state=2 mask=1` 保留 | ✅ 关闭不产生"假恢复" |
| 8 | 再 `SET_DIAG(1)` | 3.5 s 内 **0 帧** | ✅ 故障没消失，不重复确认 |
| 9 | **人缓慢拧电位器来回**（真实电气变化） | `span=187 mV` → **FAULT 恢复，mask=0x00** | ✅ 恢复路径打通 |
| 10 | 手离开、输入重新静置 | `span=8 mV` → **FAULT 再次确认**，`conf=2` | ✅ 重复触发 |

全程 `drops=0 / adc_err=0 / uart_err=0 / frame_err=0 / 解析错误=0`；
拧动期间 `chg`（告警切换）从 0 涨到 4，说明**告警链路在诊断开启时仍然正常工作**。
原始记录：`docs/STAGE7C_BOARD_RAW.txt`。

> **类 C 与类 D 的界线**：这里的"卡死"是"电位器没动"，不是"传感器坏了"。
> 电气上二者都是"输入不变"，所以检测逻辑是真的被触发了；
> 但**没有真实故障传感器**，所以不能声称"验证了传感器失效场景"。

### 3.4 类 D：真实电气输入

- 第 9 步的恢复是**人手拧电位器**造成的真实电压变化（不是喂数据）；
- 第 3 步的确认是**真实静置输入**（含电位器自身噪声 ~9 mV 峰峰）。

除这两点外，本阶段没有引入任何新的电气条件（没有短路、没有断路、没有注入噪声）。

---

## 4. 联合测试（C 组）逐条对照

| 要求 | 证据 | 类别 |
|---|---|---|
| 1. 上位机发送 SET_DIAG | 板级用 `protocol.build_set_diag()` 发送（界面同一函数） | C |
| 2. 固件正确接收并应答 | ACK `req=SET_DIAG result=OK` | C |
| 3. 诊断按配置启用/关闭 | `DIAG en=1/0` 文本回读 | C |
| 4. 确认后上报 FAULT | 约 3.0 s 后 1 帧，`event=1` | C |
| 5. 恢复后再次上报 FAULT | `event=2`，`mask=0x00` | C + D |
| 6. 上位机识别整个变化 | 脚本打印 + GUI 冒烟（B 类） | B/C |

---

## 5. 编译结果与资源变化

```
Program Size: Code=22204  RO-data=1000  RW-data=148  ZI-data=4956
"DataAcq\DataAcq.axf" - 0 Error(s), 0 Warning(s).
```

| 项 | 7B 之后 | 7C 之后 | 变化 |
|---|---|---|---|
| Code | 21492 | **22204** | **+712** |
| RO-data | 996 | 1000 | +4 |
| RW-data | 148 | 148 | 0 |
| ZI-data | 4956 | 4956 | 0 |
| Flash | 34.2% | **35.4%** | +1.2% |
| RAM | 24.9% | 24.9% | 0 |

`app_fault_t` 只有 1 字节，塞进了原结构体的对齐空隙，所以 **ZI 一点没涨**。
+712 主要来自 `app_fault.c`（状态机 + 载荷构造）、`app_task.c` 的新命令与 `DIAG` 文本行。

---

## 6. Git

| 项 | 值 |
|---|---|
| 7C 提交 | **`b198ef8`** — `feat(diag): Stage 7C 故障诊断协议上报 + 上位机集成 + 板级验证` |
| 父提交 | `6112267`（Stage 7B：信号卡死诊断模块） |
| 分支 | `main`（与远端同步，未强制推送） |

---

## 7. 尚未完成 / 未验证

| # | 项 | 为什么 |
|---|---|---|
| 1 | **真实传感器失效**（断线、探头坏、变送器卡死） | 手上只有电位器，没有可失效的传感器。当前证据只能说明"输入不变会被检出" |
| 2 | `STUCK_DELTA_MV = 50 mV` 对真实工艺量的适用性 | **待确定**。真实过程"正常稳定"时的变化幅度未知，可能远小于 50 mV（误报）或远大于（漏报） |
| 3 | 诊断**长时间开启**的运行（1 h / 8 h） | 本轮板级累计约 4 分钟。开诊断后长跑未做 |
| 4 | 强干扰下的误触发率 | 没有注入噪声，只有室内环境 |
| 5 | GUI 连真板显示故障 | 界面联动是**软件模拟**验证的；真板路径走的是脚本（同一套 `protocol.py`，但没点过界面按钮） |
| 6 | 上位机断线重连后掩码语义 | 重连后设备仍在 ACTIVE，界面不会自动收到旧状态（没有"查询当前故障"命令）。这是设计缺口，需在 7D 决定要不要加查询 |
| 7 | 掩码跨上电保持 | 只在 RAM 里，上电清零；**故意不做 Flash**（禁止项） |
| 8 | `app_diag.c` 的 ARMCC5 cycle 级耗时 | 只做了编译与功能验证，没有示波器/GPIO 翻转测量 |
| 9 | 断电后板子状态 | 测试结束发了 `diag off`，但 RAM 里 `state=2 mask=1` 会保留到下次上电（设计如此） |

### 一个必须说明的小缺口

现在**没有"查询当前故障"的命令**。上位机后连、或断线重连，看不到设备的既有故障状态——
只能等下一次跃变。当前靠 `stat` 文本行的 `DIAG ... mask=` 可以人工看到，但二进制侧没有对应查询。
是否补一个（例如 GET_STAT 帧尾部追加，或新命令 `0x16 GET_DIAG`）需要你定，
**本轮没做，也不擅自做**。
