zoumingjie124-ui/single-channel-acquisition/docs/STAGE7B_STUCK_DIAG.md

# Stage 7B：信号卡死诊断 —— 实施与审查结果

> 日期：2026-11-03 18:35
> 范围：**只实现 `app_diag` 模块骨架 + 信号卡死检测**。不实现其他故障、不改 UART 协议、不改上位机。
> 状态：代码与测试已落地，**未上板**（原因见 §7）。

---

## 1. 修改文件清单

### 新增

| 文件 | 行数 | 内容 |
|---|---|---|
| `App/Inc/app_diag.h` | 约 90 | 接口 + `app_diag_t` 结构体 + 状态枚举 |
| `App/Src/app_diag.c` | 约 250 | 分块极值统计算法 + 状态机 |
| `fw_tests/test_diag.c` | 约 320 | 121 条断言 |

### 修改（全部是新增行，无一行原有逻辑被改写）

| 文件 | 改了什么 | 为什么 |
|---|---|---|
| `App/Inc/app_config.h` | 新增 6 个诊断参数 + 6 条编译期约束 | 沿用"所有可调参数集中在此"的约定 |
| `App/Src/app_task.c` | ① `#include "app_diag.h"` ② `app_ctx_t` 加一个 `app_diag_t diag` 成员 ③ `app_task_init()` 里 `app_diag_init()` ④ `process_sample()` 里 `app_diag_update()` ⑤ `ctx_reset_stats()` 里 `app_diag_reset_counters()` | 让模块真正被调用；否则就是死代码 |
| `fw_tests/main.c` | 加 `test_diag()` 调用与注释 | 测试入口 |
| `fw_tests/run_tests.bat` | 编译列表加 `test_diag.c` / `app_diag.c` | 构建脚本 |
| `MDK-ARM/DataAcq.uvprojx` | App 组加一个文件条目 | 不加编不过（链接期 L6218E） |

### 明确未改

`app_filter.c`、`app_alarm.c`、`app_measure.c`、`app_proto.c`、`app_tx.c`、`app_cmd.c`、
`Core/*`、`Drivers/*`、`host/*`、`docs/PROTOCOL.md`（协议一个字没动）。

---

## 2. 算法与状态转换

### 2.1 每样本做什么（O(1)）

```
app_diag_update(d, mv_raw, now_ms)
  ├─ d == NULL        → 返回
  ├─ enable == 0      → 返回（关闭时只有这两次判断）
  ├─ blk_started == 0 → block_restart()：用本样本开一个新块，返回
  ├─ blk_samples++；更新 blk_min / blk_max（两次比较）
  └─ now_ms - blk_start_ms >= 1000 → block_close()
```

`block_close()`：算 `span = max - min` → 记录观测值 → **清零 `blk_samples`、置 `blk_started = 0`**
→ 按 span 推进状态机。新块由**下一个样本**开启。

### 2.2 状态机

```
            偏死块                偏死块 ×3
  CLEAR ───────────────► CONFIRMING ───────────────► ACTIVE   (confirm_cnt++)
    ▲                          │                        │   │
    │                          │ 干净块                  │   │ 干净块
    │                          ▼                        ▼   ▼
    │                       CLEAR                  RECOVERING ─干净块×2─► CLEAR
    │                                                     │   ▲
    └─────────────────────────────────────────────────────┘   └─ 偏死块：回 ACTIVE
```

| 转移 | 条件 | 计数器动作 |
|---|---|---|
| CLEAR/CONFIRMING → CONFIRMING | 偏死块，且未满 3 个 | `stuck_blocks++` |
| CONFIRMING → ACTIVE | 第 3 个连续偏死块 | `stuck_blocks = 0`、`confirm_cnt++` |
| CONFIRMING → CLEAR | 任意干净块 | `stuck_blocks = 0`（确认链作废） |
| ACTIVE → RECOVERING | 第 1 个干净块 | `clean_blocks = 1` |
| RECOVERING → CLEAR | 第 2 个连续干净块 | `clean_blocks = 0` |
| RECOVERING → ACTIVE | 任意偏死块 | `clean_blocks = 0`（恢复作废） |
| ACTIVE → ACTIVE | 偏死块 | `clean_blocks = 0`，**不重新确认** |

### 2.3 触发 / 确认 / 恢复（实际实现值）

| 项 | 值 | 依据 |
|---|---|---|
| 偏死块判据 | 块内 `max − min < 50 mV` | 实测静置峰峰 11 mV、接触噪声峰峰 18 mV 的 2.8 倍；≈ 满量程 1/66 |
| 块长 | 1000 ms | 与 STAT 周期对齐，便于人工比对日志 |
| 确认 | 连续 **3** 个偏死块 = 3 s | 需求指定的 N 秒 |
| 恢复 | 连续 **2** 个干净块 = 2 s | 实测接触噪声最大单步 +38 mV，1 个块可能被毛尖清掉 |
| 最小块样本数 | 50（= 单块 100 的一半） | 低于此说明块内数据不足，span 无统计意义 |
| 默认使能 | **0（关闭）** | 稳定输入会被误判，打开前需真实传感器标定 |

### 2.4 五个边界是怎么处理的

| 边界 | 处理 |
|---|---|
| 初始化 | `app_diag_init()` 全字段归零，`enable` 置默认值 0；可重复调用，幂等 |
| 计时边界 | `(uint32_t)(now_ms - blk_start_ms) >= BLOCK_MS`，无符号相减，tick 回绕（49.7 天）不出错；`>=` 语义有专门用例（999 ms 不结账 / 1000 ms 结账） |
| 无有效样本 | 块内样本 < 50  → **不参与判定**，只 `uneval_blocks++`，不打断也不推进确认链。"没数据"不等于"没变化"（后者是采样停摆，属 7C） |
| 计数溢出 | `stuck_blocks` / `clean_blocks` 理论上限被 3/2 钳住，且自增前判 `< 0xFF`；`confirm_cnt` 为 uint32，回绕仅影响统计显示、不影响判定 |
| 故障重复触发 | 恢复时把两个计数器都清 0，所以能再次从零确认；`confirm_cnt` 持续累加，ACTIVE 期间不会重复 +1（有用例） |

---

## 3. 单元测试数量及结果

```
gcc (tdm64-1) 4.9.2  -std=c99 -Wall -Wextra -Werror -O2
断言 288 项，失败 0 项  → RESULT: PASS
```

其中 **`test_diag.c` 121 条**（原有 167 条不变，全部仍然通过）。

18 个用例组，逐条对应你的测试要求：

| 你的要求 | 用例组 | 结果 |
|---|---|---|
| 正常变化信号不误报 | `正常变化信号不误报`（span 300 / 50 / 49 三种） | PASS |
| 稳定输入连续 3 秒触发 | `稳定输入连续 3 个块才确认`（1 块→2 块→3 块逐级验） | PASS |
| 只稳定 1 或 2 个块不触发 | `只稳定 1 或 2 个块不触发` | PASS |
| 块结束后极值正确重置 | `块结束后极值必须重置`（不重置会得到 span 300 → 状态停在 CLEAR，断言能判别） | PASS |
| 故障后连续 2 个干净块恢复 | `故障后连续 2 个干净块恢复`（含"1 个块只到 RECOVERING"） | PASS |
| 恢复后再次卡死能重新触发 | `恢复后能再次触发（重复触发）`（连续 3 轮，confirm_cnt = 1/2/3） | PASS |
| 默认关闭时不产生故障 | `默认关闭时不产生故障`（10 秒恒定 + 初始化幂等） | PASS |
| 多次初始化和边界时间 | `初始化与多次初始化`、`块结算的时间边界`、`跨块跳变的归属` | PASS |
| 抗误报/恢复作废 | `恢复过程中来一个偏死块则恢复作废` | PASS |
| 无有效样本 | `无有效样本（样本不足的块不判定）` | PASS |
| 关闭/打开不影响状态 | `关闭后再打开不会误判`、`关闭不影响已存在的故障状态` | PASS |
| 计数上限 | `长时间运行与计数上限`（20 干净块 + 200 偏死块） | PASS |
| 极值正确性 | `极值统计的正确性（乱序高低）` | PASS |
| NULL 安全 | `NULL 安全`（10 个接口） | PASS |

**过程中修掉的 3 个真实缺陷**（都是模块自身的问题，不是测试写错）：

| # | 现象 | 根因 | 修法 |
|---|---|---|---|
| 1 | 每个块都被判"样本不足"，状态永远不动 | `block_close()` 里**先**把 `blk_samples` 清 0，**再**拿它判断是否够 50 个样本 | 先把样本数取到局部变量再清零 |
| 2 | 跨段切换后第一个块的 span 不可推演，测试反复失败 | 结块样本同时充当下一个块的"种子"，min/max 继承上一段电平 | 改为"结块样本只属于旧块，新块由下一个样本开启"，并把该行为写成用例固定下来 |
| 3 | （同 2 的连带）`block_close()` 签名带着不再使用的 `mv_raw` | 设计变更后残留 | 改签名，同步前向声明 |

---

## 4. 代码尺寸变化

| 项 | 7B 之前 | 7B 之后 | 变化 |
|---|---|---|---|
| Code | 21208 | **21492** | **+284** |
| RO-data | 996 | 996 | 0 |
| RW-data | 148 | 148 | 0 |
| ZI-data | 4916 | 4956 | **+40** |
| Flash 占用 | 33.9% | 34.2% | +0.3% |
| RAM 占用 | 24.7% | 24.9% | +0.2% |
| 编译 | 0 Error 0 Warning | **0 Error 0 Warning** | — |

- **ZI +40** = `app_diag_t` 结构体（36 字节 + 对齐）；
- **Code +284** = 算法 + 状态机 + 5 个查询接口 + 前向声明；ARMCC5 未内联 `block_close`；
- 关闭状态下每样本只多两次比较（`d == NULL`、`enable == 0`），**不增加主循环有效负载**。

---

## 5. 是否有任何原有模块被修改

**有，但只有 `app_task.c` 一个，且只有 5 处新增行**（见 §1）。逐条说明影响：

| 位置 | 影响 |
|---|---|
| `#include "app_diag.h"` | 无 |
| `app_ctx_t` 加成员 | ZI +40，无逻辑影响 |
| `app_task_init()` 加一行 | 无 |
| `process_sample()` 加一行 `app_diag_update()` | **唯一碰到热路径的一行**。放在 `app_alarm_update()` 之后，只读 `mv_raw` 不写任何东西；`enable == 0` 时函数体内两次判断即返回 |
| `ctx_reset_stats()` 加一行 | 只清诊断计数，不清诊断状态 |

`app_filter.c` / `app_alarm.c` / `app_measure.c` / `Core/*` / `Drivers/*` / `host/*`：**一行未改**。

---

## 6. 对现有行为的影响（理论 + 已做的验证）

| 对象 | 影响 | 验证 |
|---|---|---|
| ADC DMA 采样时序 | 无（硬件触发 + 环缓冲，主循环只是消费者） | 未上板复测，见 §7 |
| `app_alarm` 状态 | 无（不共用任何状态，告警级别不参与故障判定） | C 单测中 alarm 167 条断言仍全过 |
| `app_filter` | 无（只读它的上游 `mv_raw`） | filter 断言仍全过 |
| UART 协议 / 上位机 | **无**（协议文件未改，未新增帧类型） | 上位机 28 项单测仍 OK |
| 主循环耗时 | 关闭时 ≈ 0；开启时 O(1)/样本 | 未上板测，见 §7 |

---

## 7. 未验证项目（必须说清）

| # | 项 | 为什么没验证 |
|---|---|---|
| 1 | **真实硬件上的卡死检测** | 本轮没有烧录、没有动电位器。288 项断言全部是 **PC 上 GCC 跑的单元测试**，不是上板结果 |
| 2 | **开启后主循环是否仍 100.0x Hz / drops 0** | 需要烧录 + 跑一轮 10 分钟长跑。默认是关闭的，所以**现有板上固件行为与 7B 之前逐字节等价**（除 ZI 多 40 字节） |
| 3 | `STUCK_DELTA_MV = 50 mV` 是否适合真实传感器 | **待确定**，需要真实传感器或你的规格书 |
| 4 | 卡死状态目前**不可观测** | 没有协议上报（7C 才加），现在只能靠调试器看 `s_ctx.diag` |
| 5 | `app_diag.c` 在 ARMCC5 下的实际耗时 | 只在 GCC 上验证过逻辑；ARMCC5 编译通过、0 告警，但没做 cycle 级测量 |

---

## 8. 下一步（等你批准）

按设计文档的四阶段，7B 到此为止。**没有自行开始 7C。**

7C 要做的事（都需要你点头）：输入异常 + 变化率 + 采样停摆三类故障、协议 `0x86`/`0x15`、
上位机三件套、以及一次 10 分钟长跑回归。其中"偏置电阻做断线检测"仍挂着等你决定。
