zoumingjie124-ui/single-channel-acquisition/docs/gui_demo.png

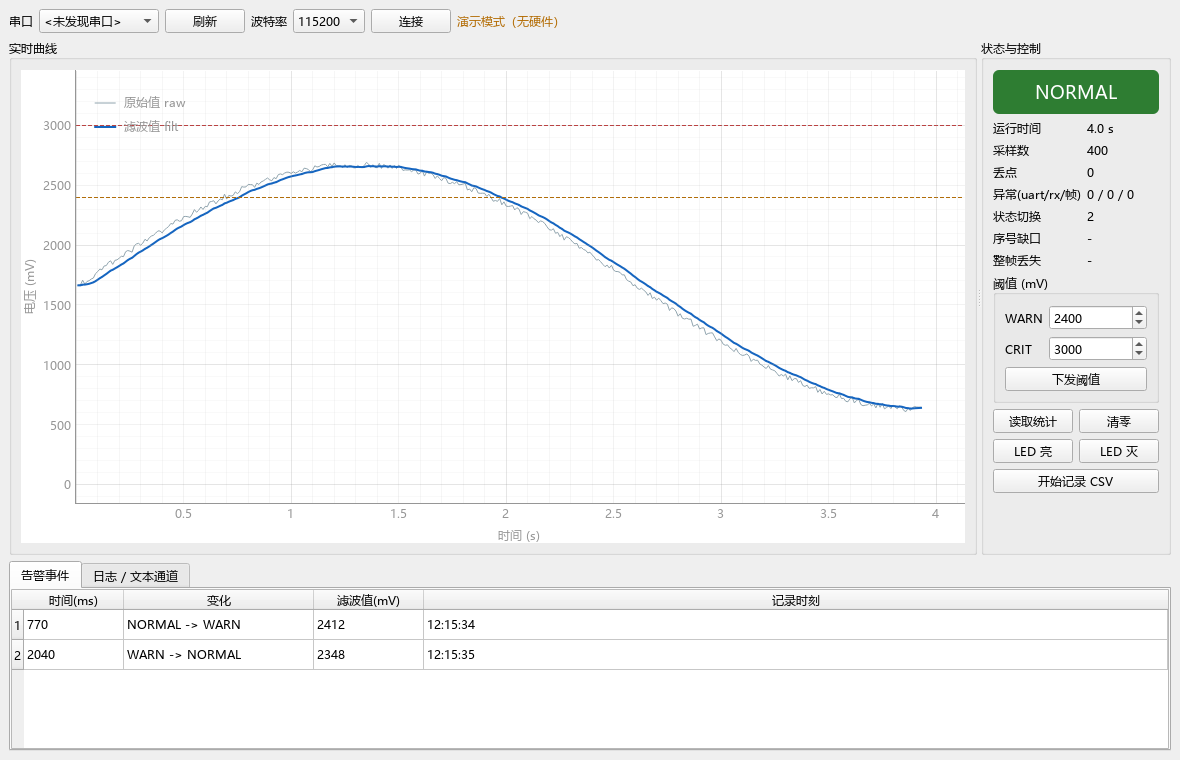
docs/gui_demo.png
