zoumingjie124-ui/single-channel-acquisition/docs/gui_real_serial.png

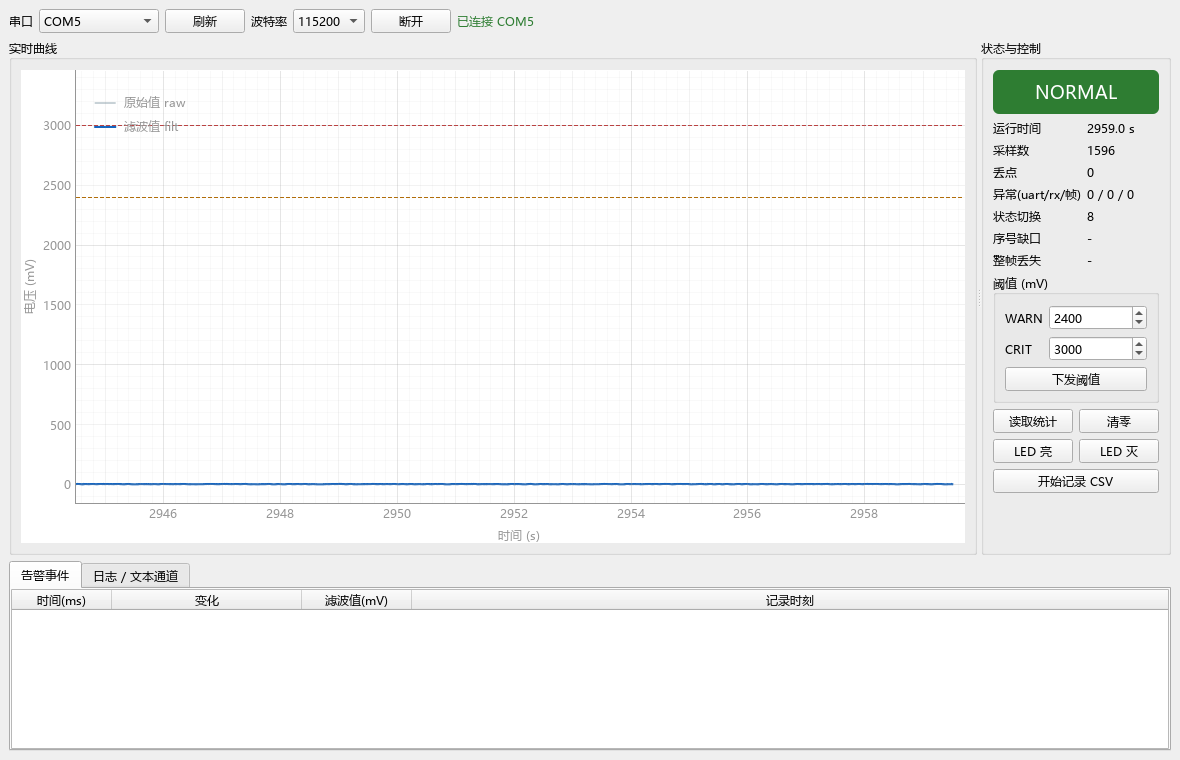
docs/gui_real_serial.png
