zoumingjie124-ui/single-channel-acquisition/docs/stage8d/01_D1_connected.png

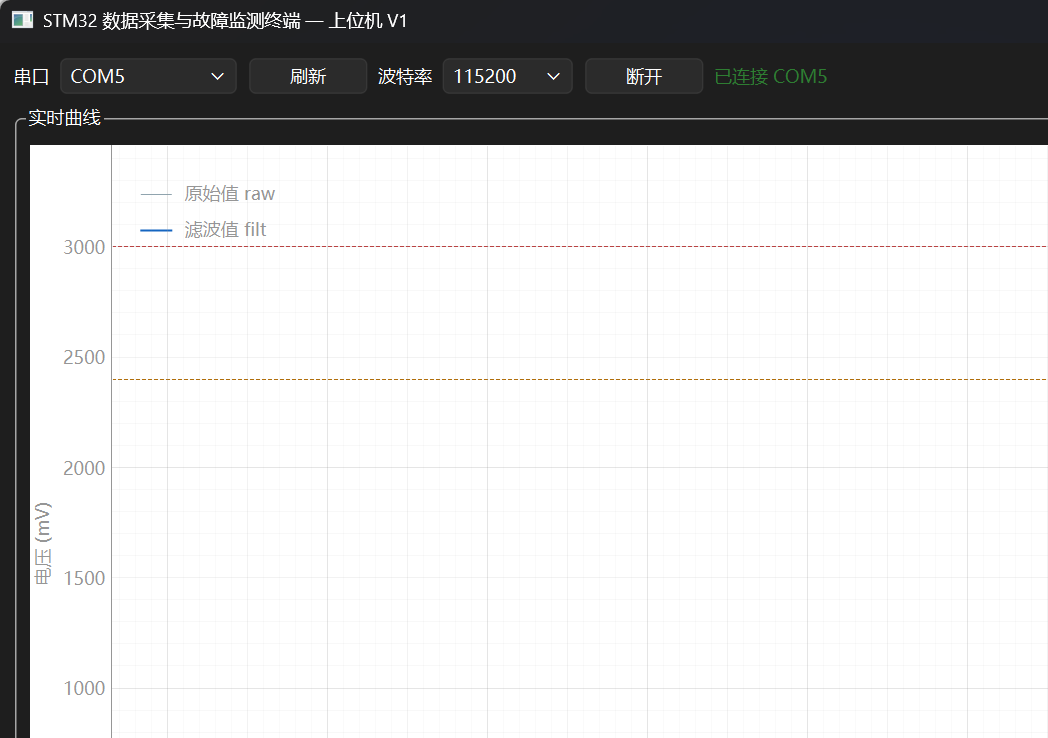
docs/stage8d/01_D1_connected.png
