zoumingjie124-ui/single-channel-acquisition/docs/stage8d/02_D3_enabled.png

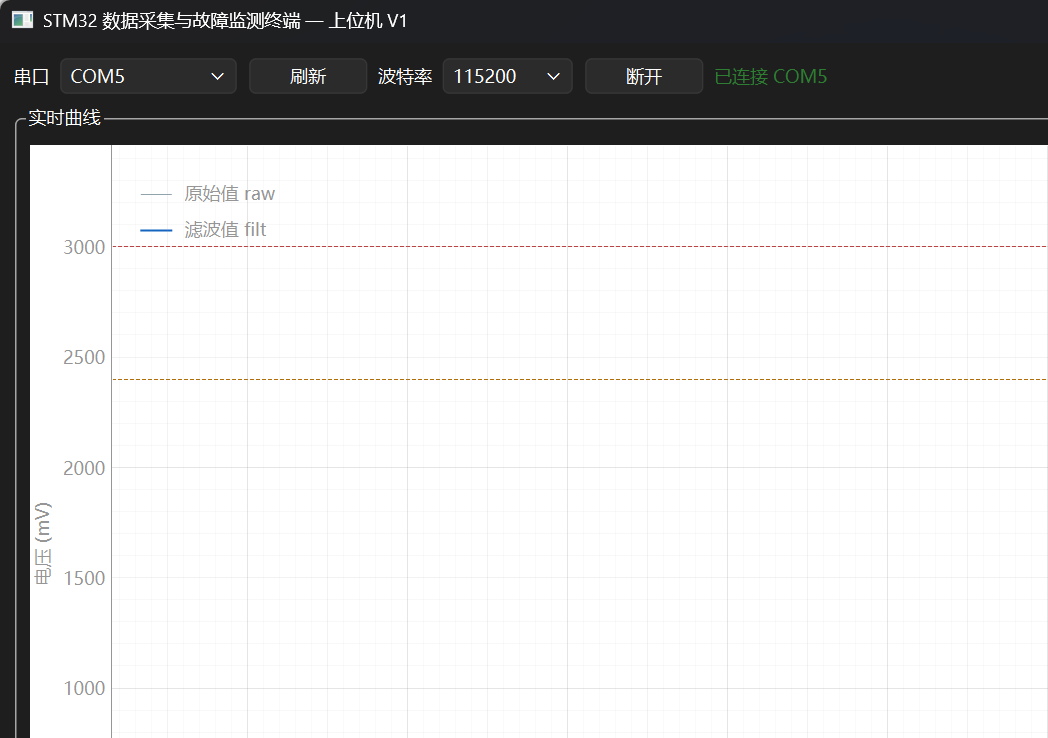
docs/stage8d/02_D3_enabled.png
