zoumingjie124-ui/single-channel-acquisition/docs/stage8d/05_D8_reenabled.png

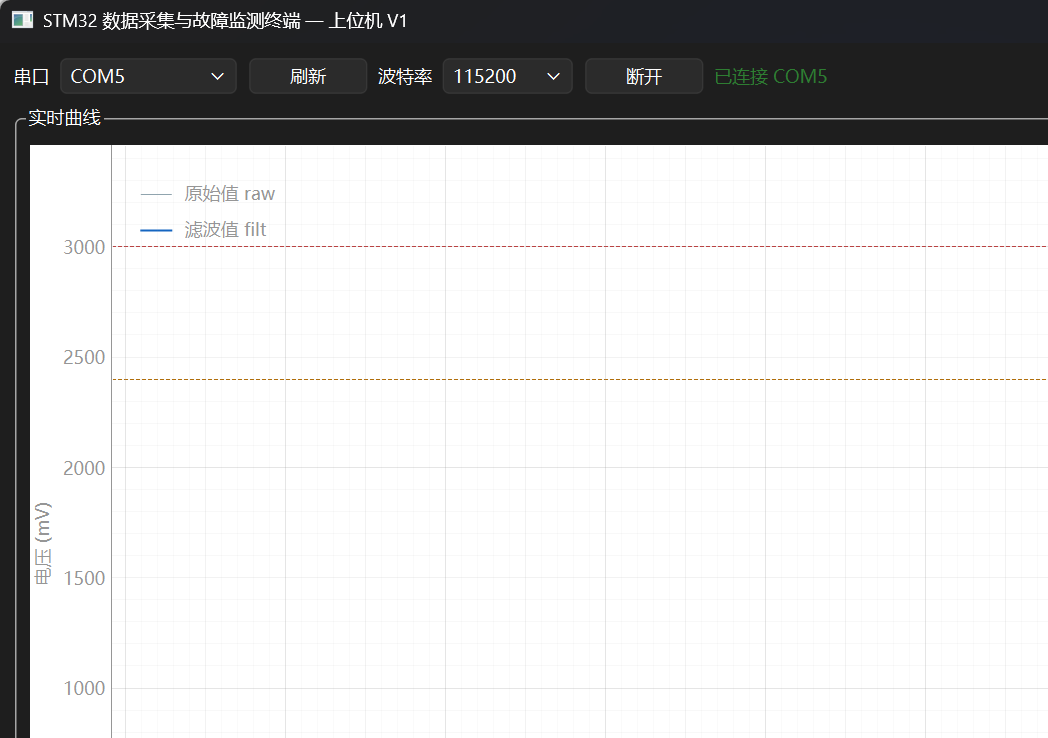
docs/stage8d/05_D8_reenabled.png
