zoumingjie124-ui/single-channel-acquisition/docs/TEST_INVENTORY.md

# 测试证据清单：Stage 1–8B（按证据类型分类）

> 目的：Stage 1–8B 的结论散在多份报告里（1–4 各阶段报告、7B／7C／7C-2、8B／8D 各自成套），常见误读是"全都是硬件实测"。
> 本文件把它们按**证据来源**重新归类，并把"哪些结论只能由哪一类证据支撑"写在最前面。
>
> 一句话原则：**PC 上跑通不等于板上跑通；注入故障造成的现象不等于真实故障造成的现象。**
> 混在一起写，就是夸大。

---

## 1. 三类证据的定义

| 类 | 名称 | 判定标准 | 能证明什么 | 不能证明什么 |
|---|---|---|---|---|
| **A** | PC 离机测试 | 不接板。编译器 / Python 在电脑上跑 | 纯逻辑正确性、协议两端字节一致性、界面数据通路 | 任何硬件行为（时序、电气、中断竞争） |
| **B** | 真板 + 真实信号 / 真实电气事件 | 板子在线，信号来自真实器件（电位器、电源轨），异常来自真实物理原因（错误波特率、自发噪声） | 整条链路在真实硬件上的行为 | 极端电气故障（除非真的制造出来） |
| **C** | 真板 + 人为注入 | 板子在线，但异常是被构造出来的 | 特定分支/恢复路径的可达性与反应时间 | 真实故障的**发生率**与**成因分布** |

C 类再细分三档，强度递减：

| 档 | 注入方式 | 例子 | 强度说明 |
|---|---|---|---|
| **C1** | 纯软件置标志，不碰硬件 | `adcinject` → `app_measure_on_error()` | 只证明"标志→恢复"这段代码通，**不证明真实 DMA 会这样出错** |
| **C2** | 软件手段制造**真实**硬件状态 | `AbortReceive` 后不回挂 → 真实 `RxState=READY`；停 DMA 攒字节 → 真实 ORE 置位 | 状态是硬件真的，但**成因不是现场会发生的** |
| **C3** | 脚本构造异常字节流 | 坏 CRC、LEN=255、半截帧、140 B 长命令 | 链路电气是真的，**异常内容是人为的** |

---

## 2. 总表

### 2.1 Stage 1 — ADC 故障恢复（2026-11-02 23:46，COM5，Debug `Code=20808`）

| 检查项 | 类 | 结论 | 证据 |
|---|---|---|---|
| 20 次注入 → `adc_err` 精确 +20 | C1 | ✅ | `STAGE1_RAW.txt` |
| 单次恢复耗时 2.1–4.9 ms（均 3.8，n=5） | C1 | ✅ 均 < 10 ms 采样周期 | 同上 |
| 17 次恢复全部成功、0 失败 | C1 | ✅ | `[rec] adc restarted` ×17 |
| 30.001 s / 3001 帧 / **100.031 Hz** | **B** | ✅ 恢复后节拍未受影响 | 帧间隔统计 |
| 10 次恢复窗口内样本 +2018（理论 2018.1），丢样 0 | C1 | ✅ | `Δn` 与 `Δt` 同取自 STAT |
| 限速：1 s 内注 5 次 → 恢复 2 次，间隔 **997 ms** | C1 | ✅ | 恢复时刻差 |
| 计数自洽：20 注入 / 17 恢复 / 3 合并 | C1 | ✅ | — |
| 真实 DMA 电气故障 | — | ❌ **NOT TESTED** | 见 R5 |
| `DeInit/Init` 失败路径 | — | ❌ **NOT TESTED** | 见 R9 |
| 恢复后首样本是否被旧值顶替 | — | ⚠ 未判定（静置直流下与噪声不可分） | 见 R6 |

> **这一阶段的核心方法风险**：`adcinject` 只调 `app_measure_on_error()`，**没有让 DMA 真的出错**。
> 所以它证明的是"错误标志 → 主循环 DeInit/Init/校准 → 重新 `Start_DMA`"这条**恢复路径**是通的，
> 而不是"真实 DMA 错误会被正确捕获"。两件事必须分开说。

### 2.2 Stage 2 — ADC 精度与线性（2026-11-03 08:48–08:52，COM6，Release `Code=20700`）

| 检查项 | 类 | 结论 | 证据 |
|---|---|---|---|
| 静置噪声 raw σ 2.40 mV / 峰峰 11 mV；filt σ 1.00 mV / 峰峰 4 mV | **B** | ✅ 抑制 **2.40×**（理论 √8 = 2.83） | `LIN_SWEEP.csv` |
| 滤波均值偏移 −0.43 mV | B | ✅ 无窗口错位 | 同上 |
| 群延迟 **40 ms**（4 点，互相关） | B | ✅ 理论 3.5 点 = 35 ms | 斜坡对照 |
| 中间量程单调：826–3300 mV **12/16 段**；0–3300 mV **16/16 段** | B | ✅ 无死区，步长中位 1 mV/点 | `LIN_SWEEP_FULL.csv`（3504 行） |
| 帧节拍：**3503 个相邻 `t_ms` 间隔全部 = 10 ms** | B | ✅ 0 例外 | 同上 |
| 换算公式不溢出（4095×3300 = 13.5 M < 2³²） | A（静态） | ✅ 整数运算不溢出；截断偏低 ≤ 0.8 mV | `app_measure.c` + `STAGE2` 换算节 |
| 有效分辨率 1 mV（1.24 LSB） | B | ✅ | mV 量化步长 |
| 异常台阶仅 2 处 > 20 mV（最大 +38） | B | ✅ 判定为电位器接触噪声 | 静置时不出现 |
| **绝对电压精度** | B | ⚠ **部分关闭**（2026-11-07 实测）：零点 1.58 mV **PASS**；满量程 **1.66 %FS** 点估计超 1 % 门槛、区间跨门槛 | 见 R2、`CALIB_ABSOLUTE.md` §6 |
| INL / DNL | — | ❌ 无法测（不上报原始码） | 见 R8 |

> **口径提醒**：Stage 2 全部是"比例测量"。PA1 接板载 3.3V 时，ADC 的参考（VREF+）和输入是同一个节点，
> 所以"满量程读数 3299.87 mV"证明的是**换算与满码正常**，不证明板上 3.3V 真的等于 3.300 V。

### 2.3 Stage 3 — UART + DMA + IDLE 异常（2026-11-03 08:58–09:01，COM6，Release `Code=20700`）

| 检查项 | 类 | 结论 | 证据 |
|---|---|---|---|
| CRC 错误 ×20 → `frame_err +20`，链路存活 | C3 | ✅ | `STAGE3_RAW.txt` |
| LEN 非法 41 / 255 / 200 → `frame_err +3`，无越界 | C3 | ✅ | 同上 |
| 半截帧 → **确定性吃掉后续 2 帧**（4/6 成功） | C3 | ⚠ 缺陷，已由加固 A 消除 | 见 2.4 |
| 未知 TYPE 0x99 → ACK `result=2`，`cmd_err +1` | C3 | ✅ | — |
| 超长文本 200 字符 → 回显 84 B（21+63），截断不越界 | C3 | ✅ | — |
| 跨 64 B DMA 缓冲（20 ping / 140 B）→ ACK **20/20** | C3 | ✅ 不跨界对照 8/8 | — |
| TX 队列灌满（100 条 stat）→ 丢 11333 B，**解析错误 0、无半帧** | C3 | ✅ 整帧原子性成立 | `txd=` 增量 |
| **FE / NE 风暴（错误波特率）** → `uart_err +144`、`rxf +0`、自动恢复 | **B** | ✅ 真实电气错误，不是构造的 | `ERRSRC fe=144 ne=0` |
| **ORE 注入** → `saw_ore=1`，链路不受影响 | **C2** | ✅ 但**未进中断**：DMA 读 DR 时顺带清了 ORE | `oreinject` 输出 |
| RX 环 256 B 溢出 | — | ❌ **NOT TESTED**（需主循环阻塞 > 22 ms） | 见 R7 |
| 真实 HAL 重挂失败 | — | ❌ **NOT TESTED** | **见 R1（必须保留）** |

> **ORE 那条要特别说清**：这是本项目最容易讲过头的结论。
> 我们确实让硬件置起了 ORE（`saw_ore=1` 是读 `USART1->SR` 得到的），
> 但重新挂接收后 DMA 取走 DR 的同时把 ORE 清了，**错误中断根本没机会执行**。
> 所以正确结论是"**本设计下 ORE 不会造成链路停摆**"，而不是"ORE 恢复路径已验证"。

### 2.4 Stage 3 加固 A/B（2026-11-03 09:12–09:23，COM6，Release `20876 → 21208`）

| 项 | 类 | 结果 | 结论 |
|---|---|---|---|
| A1 正常帧 | C3 | 10/10 | ✅ 超时不误判 |
| A2 半截帧 + 100 ms 再发 → 收到 ACK | C3 | `pto +1` | ✅ 半帧被清理 |
| A3 分段发送（间隔 15 ms） | C3 | `pto +0` | ✅ 正常分段不误伤 |
| A4 背靠背 20 帧 | C3 | 20/20 | ✅ |
| **A5 边界：45 ms 丢 / 62 ms 收** | C3 | 符合 `50 ms` 阈值 | ✅ 参数如设计 |
| A6 连续 5 次超时 | C3 | 5/5，`pto +5` | ✅ |
| **B1 单次恢复耗时** | C2 | **152 ms** | ✅ < 200 ms 限速窗口 |
| B2 连续 3 次 `rxstop` | C2 | 3/3 全恢复 | ✅ |
| B3 50 ms 内两次 → 322 ms（两个窗口） | C2 | 符合限速设计 | ✅ |
| B4 恢复后收帧 | C2 | 10/10 | ✅ 恢复是真恢复 |
| B5 `rxstop` 期间 TX 仍正常 | C2 | SAMPLE 30 帧 / 300 ms | ✅ 只死接收不死发送 |
| **B6 3 分钟 9 次注入** | C2 | 9 次全恢复，`fail 0` | ✅ 长期可重复 |
| 回归 T3（半截帧） | C3 | **3/3，`frm +0`**（加固前 1/3） | ✅ 缺陷已消除 |
| 上位机单测 | **A** | 28 项 OK | ✅ 未被固件改动破坏 |
| 采样频率 | **B** | 100.0 Hz | ✅ 加固未拖慢主循环 |

> B 组的"恢复"是**真实状态恢复**：`HAL_UART_AbortReceive()` 之后 `RxState` 真的是 `READY`、DMA 真的停了，
> 主循环守护靠读 `huart1.RxState` 把它救回来。这一点比 Stage 1 的 C1 强。
> 但它仍然**没有覆盖"`usart_start_rx()` 自己返回 HAL_BUSY"这条失败分支**——见 R1。

### 2.5 Stage 4 — 固件 C 模块单元测试（2026-11-03 09:27–09:30，PC）

| 项 | 类 | 结果 |
|---|---|---|
| `app_proto.c`（CRC / 组帧 / 解析状态机） | **A** | ✅ |
| `app_alarm.c`（去抖 / 相邻跳转 / 滞回边界 / 阈值回绕回归） | **A** | ✅ |
| `app_filter.c`（部分窗 / 满窗 / 滑窗 / 极值 / 阶跃） | **A** | ✅ |
| 编译 `-std=c99 -Wall -Wextra -Werror -O2` | A | ✅ 零告警 |
| **合计** | A | **167 断言，失败 0** |

> 这一层的价值是"**编的是仓库里的真实源码**"（`../App/Src/app_proto.c` 等），不是复制品、不是 Python 重写。
> 但它跑在 x86 上、用 GCC，**与 Keil ARMCC5 + Cortex-M3 的实际执行仍有差异**，且未覆盖 4 个依赖 HAL 的模块。

### 2.6 早期上板（v5.1.1，2026-11-02，构成 baseline）

| 项 | 类 | 结论 |
|---|---|---|
| 10 分钟连续采集 | **B** | 60117 帧 / 100.01 Hz / drops 0 / 序号缺口 0 / 整帧丢失 0 |
| 零点（PA1→GND） | B | +1.75 mV（≈2.2 LSB） |
| 满量程（PA1→3.3V） | B | 3299.87 mV（4094.8 LSB），复测差 0.03 mV |
| HT 重复交付（**含反向对照**） | B | 修复版 `rxf +0` / 回显 69 B；去掉早退 `rxf +10` / 84 B |
| 真机 GUI 16 s | B | 1597 点 / 丢点 0 / 整帧丢失 0 |

---

## 3. 按类型汇总（谁支撑了哪部分结论）

| 类 | 数量 | 主要贡献 | 短板 |
|---|---|---|---|
| **A（PC）** | 3 组：Python **72 项**、GUI 冒烟 1 次（10 项断言）、C 单测 **1041 断言** | 逻辑正确性、协议两端字节一致、文档三方同步、界面通路 | 完全不涉及硬件 |
| **B（真板真信号）** | 约 20 项：10 min 长跑、零点/满量程、HT 正反对照、扫掠 16 段、帧节拍 3503 点、FE 风暴、A5 边界、恢复耗时… | 链路的真实行为与真实电气异常 | 造不出"真实 DMA 电气故障""真实 HAL BUSY" |
| **C1（软件置标志）** | 20 次 `adcinject` | 恢复路径代码可达 | **不证明真实故障会被捕获** |
| **C2（造真实硬件状态）** | ORE 注入、`rxstop` ×12、B 组恢复 | 恢复机制与限速真实有效 | 成因不是现场成因 |
| **C3（构造字节流）** | 9 组异常帧 + A 组 6 项 + 长命令 | 解析器健壮性、帧边界 | 不含真实线路噪声 |

**一句话**：B 类撑起"能用"，A 类撑起"逻辑对"，C 类撑起"坏了能恢复"。
**没有一类能单独撑起"长期可靠"** —— 长期可靠由 §5 的 R3 支撑：1h 对照 Y2/X2，加上 **8B-2（`en=0`）与 8B-3（`en=1`）各通过一次 8 小时长跑**；但 11-04 的两轮 1h 丢帧仍未定位，**不能据此宣称"任意工况长期稳定"**。

---

## 4. 每阶段"能证明 / 不能证明"

| 阶段 | 能证明 | 不能证明 |
|---|---|---|
| 1 | 错误标志→主循环恢复→重新采样 这条路径通；恢复 < 5 ms；限速 1 s 有效；恢复不丢样 | 真实 DMA 会怎样出错；DeInit 失败时怎么办 |
| 2 | 换算与滤波实现正确；群延迟 40 ms；全量程单调无死区；时间戳无抖动 | 读数**绝对准确**（比例测量盲区）；INL/DNL |
| 3 | 解析器对坏帧/半帧/长帧的处理与整帧原子性；真实 FE 风暴可自愈 | RX 环溢出；真实 HAL 重挂失败 |
| 3 加固 | 半帧连锁已消除（3/3）；接收停摆可被 200 ms 内救回 | 启动本身失败时（`HAL_BUSY`）的表现 |
| 4 | 三个纯逻辑模块在真实源码上的行为 | 4 个 HAL 相关模块；ARMCC5 下的执行差异 |

---

## 5. 风险清单（未验证项）

> 等级：**高** = 可能让设备静默失效且无法察觉；**中** = 影响结论可信度或特定场景；**低** = 已知限制。
> **R1、R2 是本轮明确要求保留的两项，不得从清单中移除，直到有真实证据。**
> R15 / R16 的测法与通过标准见 `docs/STAGE8_PLAN.md` §3；R20（并入 R3）见 §4；R19 见 §7.5
> （本轮已确认不采购传感器/信号源/偏置电阻，R19 保持 NOT TESTED）。
> `docs/HW_VERIFY_NEXT.md` 是**上一版**清单：其 H1「改环大小」、H2「真实传感器 + 偏置电阻」两节已被
> `STAGE8_PLAN.md` 取代，**勿按它执行**（该文件本轮未修改）。

| # | 风险 | 等级 | 现状 / 为什么没测 | 影响 | 怎么才能关掉它 |
|---|---|---|---|---|---|
| **R1** | **Stage 3：真实 HAL 重挂失败未验证**（`usart_start_rx()` 真的返回 `HAL_BUSY`/`HAL_ERROR`） | **中** | B 组只验证了"接收停摆 → 守护救回"（`AbortReceive` 造状态）。`usart_rx_guard()` 的 `FAIL` 分支（计数 + `[rec] ... failed, retry in 200ms` 日志）**从未被真实执行** | 若真实失败，限速与日志分支可能有未发现的缺陷，误判成"已恢复" | 需让 HAL 返回非 OK：例如在 `RxState==BUSY_RX` 时强行 `ReceiveToIdle_DMA`（guard 已用二次检查挡住，等于要绕过自己的保护）。**目前只能靠代码审查 + 明确标注未测**，不造假 |
| **R2** | **Stage 2：绝对电压精度（已测，部分关闭）** | **中（部分关闭：零点 PASS；满量程 1.66 %FS 点估计超门槛；误差与参考电压假设一致但未与表偏分离；B 口径）** | **2026-11-07 20:18–20:27 已实测（板级、单次 n=1、`Code=22468`、COM5/1-2.1.3、USB 单路供电）**：P0 PA1 短接 GND → 表 **0.000 V** / 设备 **1.58 mV**；P1 PA1 短接 3.3V 轨 → 表 **3.245 V** / 设备 **3299.75 mV**。**零点偏移 +1.58 mV（≤5 mV，按公式 (b) 折算条件下 PASS；含折算 4.58 mV，余量 0.42 mV）**；**满量程误差 +54.75 mV ＝ 1.66 %FS**（相对读数 +1.69 %）、**跨度误差 +53.17 mV ＝ 1.61 %FS**，点估计均超门槛。**归因只到"一致"**：PA1 接轨时输入就是 VDDA，ADC 基本满码（均值 4094.7、最小 4090、最大 4095 LSB），`54.75 = 3300 − 3245` 是**算术恒等式**，不是对 ADC 增益的独立验证；在按 (b) 折算的 ±41.9 mV（无原厂来源，不构成上界）内**无法区分"板偏"与"表偏"**，故**不给出"ADC 增益误差 < 0.3 LSB"这类结论**。原始记录 `docs/CALIB_RAW.txt`、`CALIB_ABSOLUTE.md` §6、`TEST_REPORT.md` §21。**表精度说明（公开资料 4 页 / 3 种写法且互相冲突：±(1.2%+3)、±(1%+3)、±(1%+2)，另有一份单型号说明书未印精度；铭牌只标型号与量程、未印公式；取已查到的最大值 ±(1.2%+3)，不构成上界）**：表 **福仪 FY106A，读数时 DC 4 V 档、分辨率 1 mV（1 字 = 1 mV）**；(a) 用户转述 ±(0.8 % 读数 + 2 字) ⇒ ±28.0 mV（±0.85 %FS）；(b) 转载说明书页（**非原厂**，FY106A/B 并列一表、只给 1 V~600 V 一档、无 4 V 档分档精度）±(1.2 % + 3) ⇒ **±41.9 mV（±1.27 %FS）**；**取已查到的最大值 (b)（无原厂来源，不构成上界）**⇒ 按公式 (b) 折算的条件估计范围 **+12.8 ~ +96.7 mV ＝ +0.39 %~+2.93 %FS**（跨度误差按 (b) 折算的条件估计范围为 +11.3 ~ +95.1 mV ＝ +0.34 %~+2.88 %FS），门槛 33 mV 仍在区间内、**跨 1 % 门槛**：只能写"点估计超标、机制一致但未分离"，**不得写"确定超过 1 %FS"或"已验证 ≤1 %FS"**| **最大方法缺口：未做比例测量**（无同量程 `V_PA1` 与 `V_轨` 对照，无法用 `P = 3300×V_PA1/V_轨` 验证中间量程比例读数）；满量程批次并非全 4095（最小 4090），故 PA1 与 VDDA 之差 ≤5 LSB（≈4 mV），**只约束了该测点电压差、不构成"同网络"证明**；该界来自样本最小值，**是上界不是测出的差值**；满量程批次的**标准差与"取 4095 的比例"无法给出**（`calib.py` 只打印 min/mean/max、未落盘逐样本，**已知缺口，不重采、不改脚本**）；另 **VDDA 与 3.3 轨同网络未验证**（逐脚通断扫描未取得可靠接触，主动放弃）⇒ 只用 B 口径，**不得宣称 R2 已关闭**。**系统性影响（已入档）**：固件假设 VDDA=3.300 V，实测 3.245 V ⇒ 绝对读数偏高约 **1.7 %**，告警阈值在真实电压上同步偏低（`WARN 2400` → 约 **2330~2390 mV**、点估计约 2360；`CRIT 3000` → 约 **2915~2990 mV**、点估计约 2950；区间按偏高 +0.4 %~+2.9 % 换算、取整到 5 mV）。**这些数都是点估计、且以"3.245 V 即真值"为前提**；在按 (b) 折算的 **±1.27 %FS**（不构成上界）内，偏高量即 **+0.4 %~+2.9 %**（与 README §8 同口径）；**比例类结论（线性/单调/噪声/重复性/告警判定）不受影响**；改进方向为 VREFINT 在线校准，本项目不改固件、仅记录| 若要把 R2 推进到"可关闭"：① **比例测量（可选）**——PA1 接 1.6 V 分压中点（**两只 1 kΩ~2 kΩ 等值电阻**，不要 10 kΩ 以上），同一表同量程读 `V_PA1` 与 `V_轨`，算 `P = 3300 × V_PA1 / V_轨` 比较 `固件 mv − P`；**现行预设验收线：±12 mV**（测前先定；按公式 (b) 折算：表数字项不抵消 3300×(3/1622+3/3245)=9.2 mV + ADC 约 3 mV = 12.2 mV；按 (a) 的 2 字则约 9.1 mV；该验收线在该测项开始之前已确定，该测项至今未执行）；**现行 ±12 mV 判据比合成值 12.2 mV 小约 0.2 mV（若两者对应同一误差量及测试条件，则判据在数值上更严格）**；该法在此表上分辨力约 0.75 %（12 mV 相对约 1.6 V 测点），**只能发现明显增益问题，证明不了 0.1 % 级一致**；且**不能分辨"板子 VDDA 真是 3.245 V"与"表读低"**（需第二只表交叉对读或已知精度基准）；② 断电通断测 `3.3` ↔ VDDA 第 9 脚，把 B 口径升 A；③ 若需 ≤1 %FS 绝对精度，改用 **VREFINT 校准或外部基准**（新增功能，需另立阶段）。**本轮明确不补测**（不重采、不改 `calib.py`）；引用时必须同时给出"点估计 + 表的误差折算区间 + B 口径 + 未做比例测量 + 已知缺口"五件事 |
| R3 | 8 小时连续运行 | **中（⑥⑦ 两种配置各通过一次；但 ②③ 的 1h 丢帧仍未定位，不因 ⑥⑦ 通过而降级）** | **七条结果，引用时必须成组列出**（口径：H1 = 帧数 / 标称窗，见下方注）：① 2026-11-03 12:06 **通过**（`Code=21208`，**无诊断模块**；360047 帧 / 100.013 Hz / H1–H12 全部 PASS，所有错误与丢失类计数均为 0，`SOAK_60MIN_20261103.txt`、`TEST_REPORT` §17）；② 2026-11-04 11:24 **未通过**（`Code=22468`，诊断开；360002 帧 / 100.001 Hz，`seq8 缺口 45`/`整帧丢失 45`/`解析错误 30`，H7/H8/H12 FAIL，`SOAK_60MIN_20261104.txt`）；③ 2026-11-04 16:14 **未通过**（`Code=22468`，诊断关 `en=0`，COM4/1-2.2；360033 帧 / 100.009 Hz，缺口 17/整帧 18/解析 11，`SOAK_60MIN_20261104_Y.txt`）；④ 2026-11-04 18:14 **通过**（Y2，`Code=22468`，诊断关，COM5/1-2.1.3；360051 帧 / 100.014 Hz，全 0，`SOAK_60MIN_20261104_Y2.txt`、`STAGE8B_ENV.txt` §十四）；⑤ 2026-11-04 19:23 **通过**（X2，`Code=22468`，诊断开 `en=1`；360050 帧 / 100.014 Hz，全 0，`SOAK_60MIN_20261104_X2.txt`、`STAGE8B_ENV.txt` §十五/§十六）；⑥ 2026-11-04 23:28 – 11-05 07:28 **通过**（8B-2，`Code=22468`，诊断关 `en=0`，COM5/1-2.1.3；**480 min / 2880109 帧 / 约 100.014 Hz（含一次 NTP 台阶，表观 100.0038）/ H1–H12 全部 PASS**，drops·frame_err·adc·uart·rx·解析错·BOOT·链路中断全 0，打点 **479** 条，H11 **0.0039 %**，`SOAK_480MIN_20261104_N.txt`、`SOAK_480MIN_RECORD.md`、`STAGE8B_REPORT` §8）；该轮含一次**主机 NTP 校时（+2950 ms）**造成的计数台阶（`[7260s]` ΔSAMPLE 5705 / ΔSTAT 57），已定量归因，见 **`STAGE8B_REPORT` §8.3**；⑦ 2026-11-05 23:10:56 – 11-06 07:10:56 **通过**（8B-3：`Code=22468`、**诊断开 `en=1`**、**输入全程静置**、**诊断模块全程 ACTIVE（`state=2 / mask=1 / rep=1`）且 8 h 内没有新的 CLEAR→CONFIRM**、COM5/1-2.1.3；480 min / **2,880,407 帧** / **100.0141 Hz** / H1–H12 全部 PASS，drops·frame_err·adc·uart·rx·解析错·BOOT·链路中断全 0，打点 **479**，H11 **0.0141 %**；**证据等级：板级统计级、单次运行（n=1）**；`SOAK_480MIN_20261105_X.txt`、`SOAK_480MIN_RECORD_8B3.md`、`STAGE8B_REPORT` §9）。**注意：只有 ⑥⑦ 这两种配置各通过一次，不能读成"项目稳定性全部通过"**——②③ 的 1h 失败至今未定位，温漂与慢性资源增长也没有专门测试 | 只引用 ①④⑤⑥ 会高估稳定性；②③ 说明诊断开关**不是**丢帧的必要条件，但两轮失败**至今未定位**（③ 与 ④⑤ 的端口/线材/模块更换史未被单独隔离）；⑥ 只覆盖 **en=0**、⑦ 只覆盖 **en=1 且输入静置**，两者合起来才覆盖两态，**仍不能扩张为"任意工况 8 小时稳定"**；序号检测受 8 位限制——**在当前 8 位序号检测能力范围内，未检出可分辨的序号缺口（`frame_gap` 与 `seq8_gap` 均受同一限制）**，单次恰为 256 整数倍的缺口不可见 | 引用时必须**七条一起列**，并注明每条的诊断开关与证据等级（板级统计级、单次运行）；**不得用 ⑥⑦ 的通过去关闭 ②③**（那是两轮独立的 1h 失败，需单独隔离变量复现）；**H11 不得跨轮次比较**——⑥ 的 0.0039 % 是 NTP 抵消后的表观值，⑦ 的 0.0141 % 才是真实量级（≈141 ppm） |
| R4 | 告警滞回"手感"（阈值附近缓慢来回） | 中 | Stage 2 扫掠只是穿越阈值，没有在 2400/3000 附近缓慢往返 | 滞回 50 mV 是否合适、会不会抖动，无实测 | 电位器在阈值 ±30 mV 内缓慢来回 ≥2 min，看 `changes` 增量是否异常 |
| R5 | 真实 DMA 电气故障（不是置标志） | 中 | 无法在不破坏硬件的前提下制造 | Stage 1 的"恢复"可能只在软件层面成立 | 只能做长时间高负载/干扰环境下的偶发观测，无法主动注入 |
| R6 | ADC 恢复后首样本是否被旧值顶替 | 低 | 静置直流下 18 mV 峰峰噪声与"旧值"不可分 | 单点数据可能重复一次 | 用动态信号（方波/快速扫掠）在恢复瞬间比对相邻样本 |
| R7 | RX 环 256 B 溢出 | 低 | 需主循环阻塞 > 22 ms，正常流程不会发生 | `rxf` 计数路径未验证 | 只能代码桩，按规矩不做 |
| R8 | INL / DNL | 低 | 固件只上报 mV，不上报原始码 | 无法给线性度指标 | 需改协议增加原始码字段（**新增功能，不做**） |
| R9 | ADC `DeInit/Init` 失败路径 | 低 | 无法让 HAL 失败 | 失败时的重试与日志分支未执行 | 同 R1 |
| R10 | GUI 长时间联调（> 1 h） | 低 | 最长 16 s（真串口）、4 s（演示） | 内存增长、CSV 写入、曲线缓冲行为未知 | **单独占一条串口跑**（不能与 `soak.py` 同时开同一个口，会抢端口）；只有一块板时，8 h 那一轮二选一 |
| R11 | 4 个 HAL 相关模块无 C 单测 | 低 | 依赖 `stm32f1xx_hal.h`，需打桩 | `app_measure/app_tx/app_cmd/app_task` 的逻辑只能靠上板 | 打桩＝改架构，按规矩不擅自做；`app_task` 的越层调用见 `AUDIT_20261103.md` §2.2 |
| R12 | 电位器接触噪声对判级的影响未量化 | 低 | 只有定性观察（扫掠时出现 ±38 mV 台阶） | 极端接触不良时可能误触发 WARN | 换多圈精密电位器 / 加 0.1 µF 电容后对比 |
| R13 | PC-Lint / Cppcheck / MISRA 未运行 | 低 | 未安装/未配置 | 无法声称"通过静态检查" | 装工具后跑一次，只报事实 |
| R14 | 阈值掉电不保存 | 低（设计限制） | 有意不做 EEPROM | 重启回默认 2400/3000 | 记录为限制，不算缺陷 |
| **R15** | **Stage 7C-2：TX 环真实满载后的重试** | **中（8A 已执行；方法达不到目的——命令放大只压住大帧，压不住 9 B 小帧；固件在该负载下行为符合预期；R15 目标场景（提交失败后的重试）仍未验证）** | **8A 已执行（2026-11-06 09:39，板级实测、单次运行 n=1，`Code=22468`，未改固件/未改 `APP_TX_RING_SIZE`）**：用命令放大灌满环——427 条 `stat`/4.5 s，单条回复 ≈291 B（文本 254 B + 二进制 STAT 37 B），`txd`（发送环丢弃字节）从 0 涨到 **53,501 B**，证明环确实满载并大量丢弃；窗口内制造恢复边沿（**由"窗口内 1 条 FAULT" + "09:39:24.430 `mask=0 rep=0`" 反证边沿落在 4.5 s 窗口内**）。**A-1（灌满期间 FAULT=0）实测 = 1 —— 该条是测试前提，实测被否定 ⇒ 方法达不到目的，不记固件 FAIL（`STAGE8_PLAN` §3.6 的失败判定清单一条也未触发）**；A-2 提交 1 帧恢复、A-3 不适用（提交发生在灌包窗口内，判据针对"停灌后提交"）、A-4 `rep` 拉平、A-5 采集零影响、A-6 重新确认 —— 均通过；**A-8 `retry_fail` 无调试器读数 → OPEN**；**A-9 SEQ 缺口未统计 → 未测**。见 `docs/STAGE8A_REPORT.md`、`docs/STAGE8A_TX_FULL_RAW.txt`| **A-1 是测试前提，实测被否定**：环满时每发出一帧即释放 17 B，链路 11.5 KB/s ⇒ 每秒约 680 次释放窗口，9 B 的 FAULT 任何一次都装得下；被丢的是 291 B 的 `stat` 回复。所以"命令放大"只压垮大帧，**并没有把提交路径逼到失败**，`retry` 很可能根本没被触发。另外两个测量缺陷已记录：设备时间映射被 TX 队列滞后破坏（该映射数值全部作废）、窗口内 FAULT 的 `event/active` 未落盘（A-2 字段为反推）| **8A-2 不做**：主机停读不能让设备 TX DMA 停住（本链路纯 TTL、无硬件流控，与 §3.2 已判不可行的 RTS 流控同理），环不会因此变满；要逼出提交失败只能改固件（缩小环或加注入点），违反本项目约束。本项**停在"已尝试、板级未验证"**，单测证据保留，不得写成"环满重试已验证" |
| **R16** | **Stage 7C-2：100 ms 重试节流** | 低 | C 单测覆盖边界（`app_fault_service` 的 `now - last_try >= 100`），**板级仍无证据**。8A（2026-11-06）中 `retry` 很可能未被触发——FAULT 只有 9 B，环满时仍有空档可插入，因此"100 ms 节流在真实满载下如何表现"**没有被观测到**| 真实满载时重试频率、以及"重试期间是否重复消耗 SEQ"，仍只有推演 | 与 R15 绑在一起做：先解决"把环彻底堵死"与"读到 `retry_fail`"两件事，再谈节流 |
| **R17** | **Stage 7C-2：多故障快照** | 低 | 仅白盒单测（手工置 `active=0x03`，断言 `fault_id=0 / value=0`）。固件目前只登记 `STUCK` 一种，生产路径走不到该分支 | 多故障并存时的快照格式没有真机证据 | 等第二种故障实现后一并上板；现在如实记为"仅单测" |
| **R18** | **Stage 7C-2：队列检查与写入的并发** | 低 | **代码审查通过**：`ACK`（`app_cmd_poll`）与 `FAULT`（`app_fault_service`）都在主循环顺序执行，**无 ISR 入队生产者**；`s_busy` 与 DMA 完成回调的竞争是既有设计，本轮未改动。**Stage 8 决策：保持代码审查证据，不升级为板级验证**（8A 于 2026-11-06 执行，但连"提交失败"都没造出来，更不能证明该窗口） | 若将来把入队移进中断，"检查成功但写入失败"会重新出现 | 保持"入队只在主循环"这条约束；若破例，`reported` 的拉平必须改为以 `app_tx_write()` 返回值为准 |
| **R19** | **真实传感器诊断（断线 / 探头失效）** | 中 | **NOT TESTED**。手上只有电位器；"卡死"在电气上等价于"电位器不动"，但**不能声称验证了传感器失效** | 真实传感器失效可能不被 `STUCK` 检出（例如漂移到轨、周期性抖动） | 接真实传感器（或可编程信号源）后按 `STAGE7_FAULT_DIAG_DESIGN.md` §8 复测 |
| **R20** | **诊断 1h / 8h 长期运行** | **低（诊断开启 8 h 的缺口已关闭；11:24 FAIL 的归因未定论，保留）** | **1h**：**(a)** 2026-11-04 11:24 诊断开 1h **FAIL**（缺口 45 / 整帧 45 / 解析 30，**归因未定论**）；**(b)** 2026-11-04 19:23 X2 诊断开 1h **PASS**（全 0；`conf` 1→1、增量 0；`mask=rep=1`、`span` 12→12）。**8h（诊断开 en=1）**：**(c)** 2026-11-05 23:10:56 – 11-06 07:10:56 **PASS**——480 min / 2,880,407 帧 / 100.0141 Hz / H1–H12 全 PASS / 479 打点 / BOOT 0 / 链路中断 0；`mask=rep=1`、`span` 8–11 mV；`conf` **0→0**——**本轮最容易误读的一处**：起跑时（T0）按"`conf` 会 0→1"预期记的，**该预期是错的**；实际原因是 23:10:36 `reset` 把 `conf` 清零时，诊断模块**已经处于 ACTIVE**，之后 8 h 输入一直卡死、没有发生 CLEAR→CONFIRM（`confirm_cnt` 只在 `CLEAR/CONFIRMING → ACTIVE` 时自增，`App/Src/app_diag.c:120`），所以 `conf` 全程 0（增量 0）；**与 X2 的 1→1 只可比"增量"，绝对值不可混用**（见 `STAGE8B_REPORT` §9.5）；`blk` 73→88→49 的**非单调属设计使然**（当前未结算 1 s 块内已计样本数，块结算即归零，`app_task.c:343` / `app_diag.h:44`），不作判据；`SOAK_480MIN_20261105_X.txt`、`SOAK_480MIN_RECORD_8B3.md`。**旁证**：同构建 `en=0` 的 8 h（8B-2）同样全 PASS。**本项"诊断开启 8 h"缺口已关闭；(a) 的 11:24 FAIL 归因仍未定论，作为遗留问题保留。**另：**2026-11-05 16:16:49 起跑、16:21 主动中止**的 8B-3 首次尝试**无有效结果、不计入本项**，证据 `docs/SOAK_480MIN_20261105_ABORTED_1617.txt`（689 B，`6029388e…`）与 `docs/STAGE8B3_START.txt`；同日另有一次 23:08:57 起跑、23:10:22 中止的 2 分钟碎片（`ABORTED_2310`，215 B），同样不计入。 | (a) 的归因仍未定论（1h 首发 FAIL，至今未隔离变量）；`conf` 绝对值两轮不可比（本轮 0、X2 为 1），**只能比增量**；8 h 只覆盖单一静置输入，温漂/慢性资源增长未专门测 | 若要彻底关闭 (a)：按 `STAGE8_PLAN.md` §4 复现 11:24 FAIL 场景并隔离变量（端口/线材/模块更换史）；引用时 (a)(b)(c) 三条一起列，并注明诊断开关与 `conf` 口径 |
| **R21** | **GUI 按钮连接真实开发板** | 低 | **通过（GUI 控件自动化 + 人手拧电位器 + 真机，2026-11-05 16:26:24–16:30:01，COM5/1-2.1.3，`Code=22468`）**：D-1~D-12 全部执行；**P-1~P-5、P-7 满足**，**P-6 仅 D-9 部分满足**（重连快照 `active=0` 分支未造出），**P-8 在 6 s 窗口满足**（`10933−10333 = 600` 帧 → 100.0 Hz，分辨率 ±0.2 Hz；全程 `drops=0`、`errs=0/0/0`、累计 13512 帧）。证据：**5 张 GUI 截图（仅覆盖窗口左半，不含右侧诊断/统计/事件表）**（D-1/D-3/D-6/D-7/D-8，已裁掉窗口外区域）+ GUI 文本通道日志（D-9/D-4/D-10/D-12 的抓图因 DPI 错位抓到前台其它窗口，**未归档**，这四步以日志行 + 设备读数为证），见 `docs/STAGE8D_EVIDENCE.md` §6 与 `docs/stage8d/`。另有一次**人工点击**（16:11–16:13，设备侧 `en=1 / conf=1 / cmd 0→3`）作为互补证据。**操作归属（逐步）**：D-1 连接、D-3 使能、D-6 取消使能、D-7 查询、D-8 重新使能、D-10 断开、D-12 重连 = **脚本 `QTest.mouseClick` 合成点击**；**D-9 拧电位器、D-11 断线期间拧电位器由用户本人手动完成**，D-4 的"停手静置"同样是**人手松手**（脚本只负责静置 6 s 后抓图）。**配合方式**：脚本跑到 D-9、D-11 前打印 `>>> 等待人工动作：…` 并**每 500 ms 轮询** `go1.flag` / `go2.flag`（**无超时**），用户拧完回话后由执行代理置标志放行；D-11 断线窗口约 **108 s**（16:28:13–16:30:01），其中**实际拧动时长与停止位置未记录** | **按钮不是人手点的**——控件由 `QtTest.mouseClick` 合成鼠标事件驱动（走完整 press/release → 槽函数，真串口真固件），对外只能写"GUI 控件自动化"；**D-11 拧动时长与停止位置未记录**（仅能由重连快照 `STUCK t=2115838ms` 推断松手后仍落在卡死判定区）；**D-12 判别力偏弱（OPEN）**：正因 D-11 拧完就停手、输入仍在卡死区，设备在断线期间又自行确认了一次，重连前后都是 `STUCK`，**未造出"本地旧状态 ≠ 设备快照"的对比**；P-8 仅 6 s 窗口；D-13 已移出真机范围 | 如需补强：断线期间**持续**拧动 ≥3 s 让故障进入 CLEAR，**2–3 s 内立刻重连**（趁设备尚未重新确认），并记录拧动起止时刻与停止电压；另可补高分屏/触屏命中、按钮禁用态 |

> **H1 的口径（2026-11-04 统一）**：H1 = SAMPLE 帧数 / **标称 3600.0 s**。
> 日志合计行打印的 `100.01 Hz` 不是按标称窗算的：`soak.py` 用的是宿主侧墙钟差值
> （`dur = time.time() - t0`），而该值只以**一位小数**打印，**毫秒级 Δt 未记录**。
> 常被引用的 `Δt ≈ 3600.1 s` 是**由两位小数频率反推的解释值**（`360047 / 100.01`），
> **不是日志中保存的精确实测 Δt**；因 `100.01` 只有两位有效小数，反推可行区间约
> 3599.9–3600.3 s，故**不得把 `3600.1 s` 写成精确测量结果**，也不得用它反推实际采样周期。
> 第三位小数不能从日志复现：11-03 的 `360047 / 3600.0 = 100.013`，与工具打印的 `100.010`
> 差 0.003 Hz，全部来自 Δt 口径，不是两次测量冲突。判据门槛是 ±0.10 Hz，两种口径都不影响结论。
>
> **R15–R21 的状态标注规则**：`UNIT PASS` = 只在 GCC/Python 单测里通过；
> `CODE REVIEW PASS` = 只有代码审查，没有运行证据；`NOT TESTED` = 完全没有。
> **任何一条都不得写成"板级 PASS"。** 本轮新增第三档 `部分通过` = 只完成了部分步骤
> （R21 在 16:11–16:13 那次曾记为该档，D-6~D-12 跑完后才升为"通过"，升档依据见该行）；
> 必须在括号里写清"哪些有证据、哪些没做"，**不得用"8D PASS"概括**。

> **已知小问题（GUI 显示歧义，非统计未接入）**：R21 期间那张**16:13 的全窗口截图**里 `序号缺口` / `整帧丢失` 两栏显示 `-`（注意：归档的 5 张 8D 截图**不含右侧面板**，看不到这两栏）。
> 代码核对：`host/main.py:333`、`:340` 初始化为 `QLabel("-")`；只有在**检测到缺口**时才 `setText`
> （`:551` 帧级、`:594` 样本级），点「复位统计」时改写成 `"0"`（`:668`、`:669`）。
> 因此 `-` 的含义是"**尚未出现过缺口**"，不是"没有统计"。记为**已知小问题（显示歧义）**，
> 不改 GUI、不影响 R21 判定，但对外表述不得写"序号缺口统计正常显示"。

### 5.1 两项保留风险的"当前正确说法"

面试/交付时如果要提这两条，按下面说，别升级也别淡化：

- **R1**：「接收停摆的**恢复**验证过（真实 `RxState` 状态，152 ms 救回，3 分钟 9 次全成）。
  但**启动本身失败**（HAL 返回 BUSY）那条分支没被真实触发过，只有代码审查。」
- **R2**：「**零点** +1.58 mV（表 0.000 V）→ **PASS**（≤5 mV，按公式 (b) 折算；含折算 4.58 mV，余量 0.42 mV）；**满量程 +54.75 mV ＝ 1.66 %FS**（相对读数 +1.69 %）点估计超 1 % 门槛，表（**福仪 FY106A，DC 4 V 档/1 mV 分辨率**；精度公式 **4 页 3 种写法、互相冲突**（原件未核对）：(a) ±(0.8 % 读数 + 2 字)=±28.0 mV、(b) 转载页 ±(1.2 % + 3)=**±41.9 mV**，**取已查到的最大值、不构成上界**）使按 (b) 折算的条件估计范围 **+0.39 %~+2.93 %FS 跨门槛**；误差**与"固件假设 3.300 V、3.3 轨实测 3.245 V"一致**，但在表的误差折算内**无法区分"板偏"与"表偏"**，且**未做比例测量** ⇒ **R2 部分关闭**，不得宣称"绝对精度已验证"。」
  （旧说法"零点 +1.75 mV、满量程 3299.87 mV、跨度 −0.057% 是比例测量，绝对精度要等万用表才能说"已于 2026-11-07 由实测取代。）

### 5.2 已知限制与代码审查备注（不占风险编号）

> 标注含义：**CODE REVIEW FINDING** = 读代码发现的设计缺口，**未经运行验证**，不代表已发生；**NOT TESTED** = 没有运行证据。

| 项 | 标注 | 内容 |
|---|---|---|
| TX 发送忙标志 `s_busy` 无超时兜底（关联 R15） | **CODE REVIEW FINDING / NOT TESTED** | `s_busy`（`App/Src/app_tx.c`）只由 `app_tx_on_cplt()` / `app_tx_on_error()` 清除，即依赖 `HAL_UART_TxCpltCallback` / `ErrorCallback`；`app_tx_poll()` 在 `s_busy=1` 时直接 return。**若这两个回调丢失**，TX poll 会持续提前返回，环不再排空，所有输出（SAMPLE / STAT / 文本 / FAULT）静默停摆，且没有计数器能反映。 |

- 现状：本项目现有测试（含 1 小时及 8 小时长跑）**均未观察到**该现象，也没有证据表明会发生。**不得描述为已发生的故障。**
- 处理：本轮不修改固件、不新增测试、不新增风险编号。出处：`STAGE8_PLAN.md` §3.1 结论 3。

---

## 6. 复跑入口（按类型）

> **下面的 `COM5` / `COM6` 是历史记录里的值，不要照抄。** 这块 CH340 没有 USB 序列号
> （`hwid` 的 `SER=` 为空），Windows 按物理口 + 枚举顺序分配，**同一块板会换号，烧录后也会换**。
> 复跑前先确认：`python -c "import serial.tools.list_ports as lp; print([p.device for p in lp.comports()])"`
> 各工具的端口→时间对照见 `README.md` §5.1。

```bat
:: A 类 —— 不需要板子
cd host      && python -m unittest discover -s tests -v
cd fw_tests  && run_tests.bat
cd host      && set QT_QPA_PLATFORM=offscreen && python tests\gui_smoke.py

:: B 类 —— 需要板子 + 信号源
python host\tools\soak.py 10 COM5          :: 采样率 / 丢点 / 丢帧
python host\tools\calib.py zero COM5       :: 零点
python host\tools\calib.py full COM5       :: 满量程
python host\tools\lin.py sweep COM6 0 3300 :: 全量程扫掠
python host\tools\htcheck.py COM6          :: HT 正反对照

:: C 类 —— 需要**调试固件**（APP_DEBUG_INJECT=1）
python host\tools\uart_fault.py COM6       :: 9 个异常用例
python host\tools\uart_guard.py COM6       :: A/B 加固 12 项
python host\tools\stage1_evidence.py COM6  :: 20 次 adcinject
```

> C 类必须先把 `app_config.h` 的 `APP_DEBUG_INJECT` 改成 `1`、重编译、烧录；测完改回 `0` 重烧正式版。
> **板上长期跑的一定要是 `0` 的版本。**
> 参考尺寸：Debug 构建在 Stage 3 加固时实测为 `Code=21792`（当时 Release 为 21208）。
> 本轮**没有重新编译 Debug 版**，所以这个数字不能当作当前值引用。
