zoumingjie124-ui/single-channel-acquisition/docs/TEST_REPORT.md

# 验证报告（V5）

> 本文件只记录**真正执行过**的验证。没跑过的一律写在"未验证"里，不做事后美化。

- 日期：2026-10-17（初版）／2026-10-27 复审更新
- 环境：Keil MDK5（ARMCC V5.06，`D:\K5\UV4\UV4.exe`）、Python 3.13.12（受管环境）、Windows

---

## 1. 固件编译（已实际执行）

```
cd MDK-ARM
D:\K5\UV4\UV4.exe -r DataAcq.uvprojx -j0 -o build.log            → exit code 0

Program Size: Code=22468  RO-data=1076  RW-data=148  ZI-data=4972
"DataAcq\DataAcq.axf" - 0 Error(s), 0 Warning(s).
```

> **尺寸口径（2026-11-04 更新）**：上面是 Stage 1–4、Stage 7B/7C/7C-2 全部合入后的**当前值**（与 Stage 8B 1h/8h 长跑实测固件完全一致）。
> 旧版本写的 `20700`（v5.1.1）与 `21208`（Stage 1–4）均已归入历史演进记录，完整尺寸变化链见 §7.4。
>
> 另外记一个坑：`UV4 -b` 在"源码没改过"时走增量、**不链接**，日志里根本没有 `Program Size` 行，
> 只有一行 0 Error。想核尺寸必须用 `-r`（rebuild）。

| 资源 | 占用 | 容量 | 比例 |
|---|---|---|---|
| Flash | 22468 + 1076 = 23544 B（23.0 KiB） | 64 KiB | 35.9% |
| RAM（静态） | 148 + 4972 = 5120 B（5.0 KiB） | 20 KiB | 25.0% |

编译过程中修掉的问题（均为真实出现过的错误）：

| 现象 | 原因 | 修法 |
|---|---|---|
| `L6200E: Symbol SystemInit multiply defined` | `system_stm32f1xx.c` 同时被 Core 组和 CMSIS 组加入 | 从 Core 组移除，只保留 CMSIS 组里那份 |
| `#223-D: function "Error_Handler" declared implicitly` ×9 | adc.c / tim.c / usart.c 没包含 main.h | 补 `#include "main.h"` |
| `#550-D: variable "s_seq" was set but never used` | app_cmd.c 里遗留的无用变量 | 删除 |

编译**没有**报错但属于真实缺陷、已顺手修掉的：

| 问题 | 影响 | 修法 |
|---|---|---|
| `GPIO_InitTypeDef` / `RCC_*InitTypeDef` / `TIM_*ConfigTypeDef` 局部变量未清零 | 未赋值的字段（如 `Pull`、`Speed`）会把栈上随机值写进寄存器 | 全部改为 `= {0}` 初始化（含 `tim.c`） |
| 主循环每轮都写 PC13 | 每秒上万次无效 GPIO 写 | 加状态缓存，只在变化时写 |

---

## 2. 协议与上位机数据通路（已实际执行）

```
cd host
python -m unittest discover -s tests -v
Ran 72 tests — OK
```

| 测试文件 | 数量 | 覆盖内容 |
|---|---|---|
| `tests/test_protocol.py` | 16 | CRC 标准向量（`b"123456789" -> 0x29B1`）、四种载荷往返、命令帧构造、阈值合法性及 16 位溢出边界校验、逐字节分包、垃圾前缀重同步、连续 `0xAA` 帧头容错、坏 CRC 拒绝并恢复、超长 LEN、半截帧等待、文本行分离 |
| `tests/test_pipeline.py` | 4 | 5 秒 100Hz 数据流回放（500 点）、序号连续性、丢帧缺口检测、坏帧不影响后续、13 字节不规则分包 |
| `tests/test_firmware_sync.py` | 10 | 固件 `app_proto.h` / `app_config.h` 与 `protocol.py` 常量逐项比对；`app_alarm.c` 阈值校验防 16 位溢出静态检查；`app_task.c` 与 `app_fault.c` 里 STAT/SAMPLE/EVENT/FAULT 的字段偏移与长度校验 |
| `tests/test_fault_host.py` | 21 | `0x86 FAULT`（确认/恢复/快照）编解码、`0x15 SET_DIAG`、`0x16 GET_DIAG`、快照对齐与边界容错 |
| `tests/test_fault_joint.py` | 8 | 固件 C 与 Python 上位机共用的 6 组黄金字节向量（确认/恢复/SET_DIAG/快照×2/GET_DIAG）跨语言逐字节互验 |
| `tests/test_protocol_doc_sync.py` | 13 | `docs/PROTOCOL.md` ↔ `app_proto.h` ↔ `protocol.py` 三方帧长、字段偏移、类型码、契约示例向量自动一致性校验 |

**`test_firmware_sync.py` 的性质要说清**：它是**源码级静态检查**（正则解析 C 头文件与 C 函数体），
不是联调。它能抓到"改了一边忘了另一边"，但**不能证明运行期两端的字节流真的一致**——
后者只能靠真机联调。

---

## 3. 上位机界面（已实际执行）

用 Qt 的 offscreen 平台真实创建窗口、启动内置演示数据源跑 4 秒，然后断言：

```
cd host
set QT_QPA_PLATFORM=offscreen
python tests/gui_smoke.py

界面字体      : Microsoft YaHei
采样点        : 400
曲线缓冲点数  : 400
告警事件行数  : 2
序号缺口      : 0
整帧丢失      : 0
解析错误      : 0
当前级别      : NORMAL
统计面板采样数: 400
清零同步验证  : OK
注入缺口检测  : OK（期望 +2，实得 +2）
BOOT 重新对齐 : OK
RESULT: PASS
```

4 秒理论 400 点，实测约 400 点（每跑一次会差几帧，取决于机器负载；下方代码块是一次实际输出）。缺口 0、解析错误 0，
说明「组帧 → 解析 → 绘图 → 事件表 → 统计面板」整条链路是通的。

截图见 `docs/gui_demo.png`（由同一次测试自动保存，不是手绘的示意图）。

**过程中发现并修掉的真实问题**：

| 现象 | 原因 | 修法 |
|---|---|---|
| 界面所有中文显示成方框 □□□□ | Qt 没选中含中文字形的字体；离屏/远程桌面环境下 `QFontDatabase.families()` 可能为空 | 改为用 `addApplicationFont()` 直接注册 `C:\Windows\Fonts\msyh.ttc`，注册失败才退回枚举 |
| 事件表"变化"列被截断成 `NORMAL -> ...` | 默认列宽太窄 | 显式设置列宽 |
| 演示模式"状态切换"恒为 0 | 演示源没有累加计数 | 补上计数 |
| `DemoSource.__init__` 残留 `on_text` 参数 | 早期版本改造时漏删 | 删除 |

**注意**：这是"界面 + 数据通路"的验证，不是"固件联调"。演示数据由上位机自己生成，
不经过串口，所以它证明不了固件发出来的字节一定正确。

---

## 4. 上板验证情况

### 4.1 已验证（2026-11-02，首次上板）

| 项目 | 结论 | 证据 |
|---|---|---|
| 实际采样率 | **100.01 Hz**（60117 帧 / 601.1 s） | §8，上位机侧逐帧统计 |
| ADC+DMA 是否丢点 | **drops = 0**，连续 10 分钟 | §8 |
| UART DMA 是否丢字节 | 序号缺口 0、整帧丢失 0、解析错误 0 | §8 |
| ADC 零点（PA1→GND） | **+1.75 mV（≈2.2 LSB）**，PASS | §9.2 |
| ADC 满量程（PA1→3.3V） | **3299.87 mV（4094.8 LSB）**，PASS；与首次 3299.90 相差 0.03 mV | §9.3 |
| 长命令 HT 重复交付 | 修复版 `rxf` 增量 0、回显 69 字节；**注释掉早退后 `rxf` +10、回显 84 字节** → 测试有判别力 | §9.5 |

> 注意口径：这些是**串口链路上统计到的**结果，等价于"设备发出什么、上位机收到什么"；
> ADC 的**电压读数准不准**不在其中（见 4.2）。

### 4.2 仍未验证（必须上板，且需要额外仪器/更长时间）

> **2026-11-03 更新**：本表原来列的"多点线性""ORE 自恢复"已由 Stage 2 / Stage 3 完成，
> 已从本表移出（结论见 §13、§14）。现在只剩下面这些。

| 项目 | 为什么必须上板 | 怎么验证 | 编号 |
|---|---|---|---|
| **绝对电压精度（比例测量盲区）** | VREF+ 与 VDDA 同源，满量程读数天然等于参考值 | 万用表实测 VDDA 与 3.3V 轨，再与上位机读数比对；另取 1.65 V 分压点复核 | **R2** |
| **真实 HAL 重挂失败** | `usart_start_rx()` 返回 `HAL_BUSY` 的分支从未被真实触发 | 需让 HAL 返回非 OK；目前只能靠代码审查，明确标注未测 | **R1** |
| 8 小时稳定性（诊断开启态 `en=1`） | 诊断关闭态（`en=0`）8h 已通过（2880109 帧 PASS，见 §20）；开启态 8h 仍待真跑 | 按 `docs/STAGE8_PLAN.md` §4 在 `en=1` 下跑满 8 h | R3 / R20 |
| 告警滞回手感 | 需在阈值附近缓慢往返，扫掠式穿越不算 | 电位器在 2400/3000 ±30 mV 内来回 ≥2 min，看 `changes` 增量 | R4 |
| 真实 DMA 电气故障 | 无法在不破坏硬件的前提下制造 | 只能长时间高负载/干扰环境下偶发观测 | R5 |
| 恢复后首样本是否被旧值顶替 | 静置直流下 18 mV 峰峰噪声与"旧值"不可分 | 用方波/快扫在恢复瞬间比对相邻样本 | R6 |
| RX 环 256 B 溢出 | 需主循环阻塞 > 22 ms，正常流程不会发生 | 只能代码桩，按规矩不做 | R7 |
| INL / DNL | 固件只上报 mV，不上报原始码 | 需改协议加原始码字段（新增功能，不做） | R8 |
| ADC `DeInit/Init` 失败路径 | 无法让 HAL 失败 | 同 R1 | R9 |
| 中断优先级是否合理 | 需真实中断竞争 | 高负载下观察是否丢帧 | — |
| 零点噪声来源 | 已知峰峰 9 mV，但未定位是板级纹波还是接线 | 换短接线/换电源后对比 | R12 |

---

## 5. 本次实际执行到的程度（逐项打勾，不夸大）

| 内容 | 状态 |
|---|---|
| 固件编译 | ✅ 已实际执行，0 Error / 0 Warning |
| 协议编解码单测 | ✅ 已实际执行，16 项通过 |
| 端到端离线回放 | ✅ 已实际执行，4 项通过（合成 100Hz 流，非真实串口） |
| 固件/上位机常量一致性 | ✅ 已实际执行，8 项通过（**静态检查**） |
| 上位机脚本语法 | ✅ `py_compile` 全部通过 |
| 上位机界面实际运行 | ✅ 已离屏实际运行 4 秒，PASS，并自动保存截图 |
| 上位机串口连接 | ✅ 已实测：COM5 @115200，逐帧解析 60 万+ 字节无错误（§8、§9） |
| 固件与上位机真实联调 | ✅ 已实测：10 分钟连续采集 + 零点/满量程标定 + HT 测试（§8、§9） |
| **PySide6 界面接真实串口** | ✅ 已实测：`gui_snapshot.py COM5` 连真板 16 s，1597 点、丢点 0、整帧丢失 0（截图 `docs/gui_real_serial.png`） |
| 上板实测（基础链路 / 零点 / 满量程） | ✅ 已实测（2026-11-02，详见 §8、§9） |
| **Stage 1** ADC 故障恢复 | ✅ 已实测（注入的是错误标志，非真实电气故障，§12） |
| **Stage 2** ADC 精度与线性 | ✅ 已实测（全量程扫掠，§13） |
| **Stage 3** UART/DMA/IDLE 异常 | ✅ 已实测（§14） |
| **Stage 3 加固 A/B** | ✅ 已实测（§14.1） |
| **Stage 4** 固件 C 模块单测 | ✅ 已执行（GCC，起步 167 断言，§15） |
| **Stage 6** 1 小时连续运行（无诊断版） | ✅ 已实测：3600 s / 360047 帧 / 100.010 Hz，H1–H12 全 PASS（§17） |
| **Stage 7B / 7C / 7C-2** 信号卡死诊断与故障协议 | ✅ 已实测：`app_diag` + `app_fault` + `SET_DIAG`/`GET_DIAG`/快照对齐（§18–§19） |
| **Stage 8B** 1h 对照（Y2/X2）与 8h 长跑（8B-2） | ✅ 已实测：Y2（诊断关 1h）PASS、X2（诊断开 1h）PASS、**8B-2（诊断关 480 min / 2880109 帧）12/12 PASS**（§20） |
| 固件 C 模块单测（`fw_tests/run_tests.bat`） | ✅ 本轮复跑：**1041 断言 / 0 失败** |
| 上位机单测（`python -m unittest`） | ✅ 本轮复跑：**72 项 OK** |
| PC-Lint / Cppcheck / MISRA | ❌ **未运行**，不作任何"通过 MISRA"的声称 |

---

## 6. 复现步骤

```bat
:: 1. 固件编译（-r 全量重建才有 Program Size 行；-b 在源码未改时不链接）
cd "单通道模拟量采集与故障监测终端\MDK-ARM"
D:\K5\UV4\UV4.exe -r DataAcq.uvprojx -j0 -o build.log
type build.log | findstr "Program Size Error"

:: 2. 单测（不需要硬件，不需要 PySide6）
cd "..\host"
python -m unittest discover -s tests -v

:: 2.5 固件 C 模块单测（GCC 编译仓库里的真实源码）
cd "..\fw_tests"
run_tests.bat

:: 3. 无硬件看界面
pip install -r requirements.txt
python main.py --demo

:: 4. 接板子
python main.py
```

---

## 7. 2026-10-24 / 2026-10-27 复审更新

> **时效声明（2026-11-02 补注）**：本节写于 2026-10-24 / 10-27，**当时**项目尚未上板、
> 也未与上位机联机，所以下面所有"现象"都是**代码与 HAL 源码的静态分析**，不是实测复现。
>
> **上板之后的实测见 §8（10 分钟连续运行）与 §9（零点/满量程/HT）**；
> 其中 §7.2 第 1 条（HT 重复上交）已据 §9.5 升级为「实测（含反向对照）」。
> 其余条目仍保持原来的证据等级，不要因为本节在上位而误认为都已实测。

### 7.1 本轮实际改了什么（不限于文档）

| 提交 | 类型 | 内容 |
|---|---|---|
| `b1b1d63` | **固件 + 上位机** | 修掉 4 个缺陷（见 7.2）：HT 重复上交、seq8 清零回跳、帧头 SEQ 无人检查、命令 SEQ 恒为 0 |
| `8884244` | **固件** | `s_dma_buf` 补 `volatile` |
| `81e1705` | **固件** | 恢复标志竞态修复、计数器清零加临界区、环形缓冲断言补下界 |
| `fa8496c` | 文档 / 测试 | 用例数更正、`gui_smoke` 增强、协议补充 |

> **勘误（2026-10-24 修订）**：本节初版曾声称这一轮没有触碰固件 —— 这个说法不成立。
> 本轮实际改动了 `app_task.c`、`app_cmd.c`、`app_task.h`、`usart.c` 以及 `app_measure.c`。
> 本文档的价值在于"写下的每一句都能对得上代码"，所以错的地方要留痕改正，而不是悄悄抹掉。

### 7.2 本轮真正修掉的四个缺陷

| # | 缺陷 | 现象（存在该缺陷时） | 根因 | HAL / 代码证据 | 修法 | 强度 |
|---|---|---|---|---|---|---|
| 1 | **HT 回调重复上交** | 一次 IDLE 收到的字节被上交两次；回调里重挂接收直接拿到 `HAL_BUSY` | `HAL_UARTEx_RxEventCallback` 在**半传输**时也会被调用，此刻接收仍在进行，`Size` 只是"填到一半"，不是"收完了" | `UART_DMARxHalfCplt()`（`stm32f1xx_hal_uart.c:3104`）只置 `RxEventType = HAL_UART_RXEVENT_HT` 后**直接回调**，不 abort DMA、不改 `RxState`；IDLE/TC 路径才会先 abort 再回调 | `usart.c` 回调首行判 `huart->RxEventType == HAL_UART_RXEVENT_HT` → 直接 `return`，数据留到 IDLE/TC 再上交 | **实测**（2026-11-02，含反向对照，见 §9.5） |
| 2 | **seq8 清零回跳** | 上位机下发 `reset` 后，采样序号从 255 跳回 0，被误判成"丢了 255 个样本" | SAMPLE 载荷第 9 字节的 seq8 原来取 `stats.sample & 0xFF`，而 `reset` 命令会把这个计数清零 | `app_task.c` 的 `ctx_reset_stats()` 清采样计数；修前 `emit_sample()` 直接用它算 seq8 | 新增独立计数器 **`sample_seq`**（`reset` 有意不清），seq8 改取 `sample_seq & 0xFF` | 静态可证 |
| 3 | **帧头 SEQ 无人检查** | 整帧丢失**完全不可见**：CRC 只能发现"内容被改坏"，发现不了"帧根本没到" | 上位机只解析载荷里的 seq8，从不看帧头 SEQ；且帧头 SEQ 修前是各模块各发各的，ACK 还回显命令序号，根本无法用于连续性判断 | 修前 `main.py` 无 `expected_frame_seq` 字段；固件 `emit_frame()` 各自 `s_ctx.frame_seq++` | 固件：所有出站帧共用 `app_task_next_frame_seq()`；上位机：`expected_frame_seq` + `frame_gap_count`，遇到 BOOT 帧重新对齐 | 静态可证 |
| 4 | **命令 SEQ 恒为 0** | 上位机发出的每一条命令，帧头 SEQ 都是 0 | `_next_seq()` 取 `self.parser.frames`，但真实串口的数据由 `LinkWorker` 内部**另一个** `FrameParser` 解析，`MainWindow.self.parser` 只在演示模式被喂数据 | `main.py` 中 `self.parser.feed()` 仅出现在 `_feed_demo()`；`link.py:37` 在子线程里自建 `FrameParser` | 上位机改用独立计数器 `_tx_seq` | 静态可证 |

> 第 2、3 条是同一个思路的两面：**"序号"必须只表达一件事**。
> `sample_seq` 只表达"第几个样本"（reset 不能动），帧头 SEQ 只表达"第几帧出站"（全体共用）；
> 混用就会让上位机的统计失去意义。

### 7.3 四处关键设计（不是本轮修复，也未经实测）

下表是**项目成型时就定下的设计**，不是这一轮修的东西。
"现象"一列已改为"**如果不这样做会怎样**"，全部属于推演。该表写于上板之前；
其中第 1 条（HT）后来已由 §9.5 实测覆盖，其余四条仍未实测。

| # | 如果不这样做（风险，推演） | 根因 | HAL 依据 | 本项目做法 |
|---|---|---|---|---|
| 1 | DMA 在跑，但采样环恒为空，上位机一帧都收不到 | HAL 只把 ADC 结果搬进 `s_dma_buf`；"取走并投递"必须由用户在回调里完成 | `ADC_DMAConvCplt()`（`stm32f1xx_hal_adc.c:2333`）只更新状态并调 `HAL_ADC_ConvCpltCallback()`；HAL 不搬运、不缓存样本 | `adc.c` 实现 `ConvHalfCpltCallback` / `ConvCpltCallback` / `ErrorCallback` |
| 2 | 连续发帧时偶发 `HAL_BUSY`，整帧丢失 | `HAL_UART_Transmit_DMA()` 上一帧未完成时不排队，直接返回 `HAL_BUSY` | 函数首行 `if (huart->gState == HAL_UART_STATE_READY)`，否则返回 `HAL_BUSY` | `app_tx.c` 单帧串行：发完（`TxCpltCallback`）才取下一批 |
| 3 | 接收不定长命令时，短帧要等缓冲填满才上交 | F1 的基础 DMA 接收没有"不定长"语义 | `HAL_UARTEx_ReceiveToIdle_DMA()` + `RxEventCallback()`：IDLE/TC 先 abort DMA、置 `RxState = READY` 再回调 | `usart.c` 用 `ReceiveToIdle_DMA`，只处理 IDLE/TC，忽略 HT（见 7.2 第 1 条） |
| 4 | 一次噪声（ORE）之后接收/采样永久停摆，且无任何提示 | HAL 的错误路径只回调，**不会自动重启**传输 | `ADC_DMAError()` 只置 `HAL_ADC_STATE_ERROR_DMA` 并回调 weak 空函数 | ADC：ISR 只置标志 → 主循环 `ADC1_RecoverInit()` + `app_measure_start()`，限速 1 s；串口：`ErrorCallback` 清 ORE，且**仅在 `gState != BUSY_TX` 时**释放发送队列 |

第 3、4 条最容易踩的坑是同一处：**错误回调里不能无条件重置发送状态**。
接收侧的 ORE/FE/NE 也会进 `HAL_UART_ErrorCallback`，此时 TX DMA 可能还在跑；
把 `s_busy` 清零会让主循环立刻再调 `HAL_UART_Transmit_DMA()` 并拿到 BUSY，
这批已出队的数据就被误记成"丢弃"——既真丢数据，又让统计失真。

### 7.4 构建尺寸的变化（历史基准记录）

| 阶段 | Code | 变化 | 原因 |
|---|---|---|---|
| 整帧丢失检测合入前 | 20548 | — | README 里那个旧数字 |
| 整帧丢失检测合入后 | 20576 | +28 | 帧序号统一（`app_task_next_frame_seq` + `sample_seq`） |
| `volatile` 修复后 | 20576 | **+0** | `volatile` 只约束编译器优化，不生成指令 |
| 竞态修复 + PRIMASK 后 | 20584 | +8 | `__get_PRIMASK` / `__set_PRIMASK` 的 MRS/MSR，以及两条失败路径上的标志回置 |
| 统计清零 / 整帧原子 / AA 容错 / 阈值校验 | 20620 | +36 | 新增 `usart_reset_counters()`（含 PRIMASK）、`app_tx_write` 提前返回、`SOF1` 多分支、阈值比较改为 `WARN + HYST` |
| 清理 `app_stats_t` 只写不读字段 | 20616 | -4 | 移除无用死字段赋值，ZI 降低 |
| v5.1.1：删整个 `app_stats_t` + 阈值防回绕 + STAT 文本加字段 | **20700** | +84 | RO +20（格式化字符串变长）、ZI −32（去掉 8 个 uint32 字段） |
| Stage 1：ADC 故障恢复验证（改注释/加 `#if` 命令） | **20700** | **+0** | `APP_DEBUG_INJECT=0`，注入命令不进 Release |
| Stage 3：错误分类计数 + `ERRSRC` 文本行 + `oreinject` 入口 | **20876** | +176 | `usart.c` 四个分类计数、`stat` 多一行文本、命令分派多一个分支 |
| Stage 3 加固：parser 空闲超时 + RX 重挂守护 | **21208** | +332 | `usart_rx_guard()`（PRIMASK + 二次检查）、`app_cmd_poll` 超时判定、两条 `[rec]` 日志 |
| Stage 4：固件 C 单测 | **21208** | **+0** | 只新增 `fw_tests/`，未动固件（`git diff HEAD -- App Core` 为空） |
| Stage 7B：`app_diag.c` 信号卡死诊断模块 | **21520** | +312 | 1s 分块峰峰值卡死判定状态机（默认关闭） |
| Stage 7C：`app_fault.c` + `0x86 FAULT` / `0x15 SET_DIAG` | **22204** | +684 | 故障上报帧、`SET_DIAG` 命令、`diag` 文本命令 |
| Stage 7C-2：`0x16 GET_DIAG` 快照 + `active/reported` 状态差重试 | **22468** | +264 | RO=1076、RW=148、ZI=4972；`tx_has_room` 预判 + 100ms 节流（当前基线） |

### 7.5 2026-10-27 深度复审与补齐（v5.1.1）

| 项 | 内容 | 理由 |
|---|---|---|
| 修复溢出漏洞 | `app_alarm.c` 的 `app_alarm_set_thresholds()` 将 `(uint16_t)(warn_mv + APP_THR_HYST_MV)` 改为 `((uint32_t)warn_mv + APP_THR_HYST_MV)` | 原写法在 `warn_mv >= 65486` 时会发生 16 位无符号加法回绕（如 `65500 + 50 -> 14`），导致 `warn=65500, crit=100` 绕过校验被接受 |
| 彻底清理死字段 | 移除 `app_types.h` 中只写不读的 `app_stats_t`，`app_task.c` 的 `s_ctx` 直接维护 `uint32_t samples` | 此前仅删了 `uart_err` / `rx_err`，剩余 7 个字段（`drop` 等）同样只在 `ctx_reset_stats()` 写 0 而从不读取 |
| 补齐可观测输出 | `app_task.c` 的 `stat` 文本命令补打 `cmd=%lu/%lu txd=%luB`；`ctx_reset_stats()` 末尾立即调用 `emit_stat()` | 让 `app_tx_drop_bytes()` 和 `app_cmd_ok/err_count()` 真正可在串口终端观测，且清零后无需再等 1s 周期刷新 |
| 补齐局部结构体清零 | `Core/Src/tim.c` 中 `MX_TIM2_Init` / `MX_TIM3_Init` 的 `sClockSourceConfig` 与 `sMasterConfig` 补 `= {0}` | 与第 1 节“局部 HAL 结构体全部清零”严格对齐 |
| 上位机清零与演示闭环 | `host/main.py` 点击“清零”时同步归零上位机侧 `self.samples / gap_count / frame_gap_count`，并在 `DemoSource` 中完整响应 `SET_THR / SET_LED / GET_STAT / RESET` | 避免清零后 10ms 收到的下一帧 `SAMPLE` 又把界面上的“采样数”刷回旧累计值 |
| 单测与文档同步 | 新增阈值溢出边界单测与 C 源码静态断言（共 28 项单测：16 + 4 + 8），同步 `PROTOCOL.md`、`CUBEMX_CONFIG.md` 与本报告 | 确保文档、测试与源码 100% 严丝合缝 |

### 7.6 合并 v5.1.1 时补的两处（2026-11-02）

| 项 | 说明 |
|---|---|
| 文档尺寸同步 | v5.1.1 交付包里的本报告仍写 `Code=20616`，但该版代码实测为 **20700 / RO 996 / ZI 4916**。已按实测更新 §1 与 §7.4。（README 已改为只写 `0 Error 0 Warning` 不带数字，这个做法更耐放，保留） |
| `tx_text` 缓冲 128 → 192 | 新增的 `stat` 文本行在最坏情况下（全部计数器到 10 位）约 168 字符，128 虽不会溢出（`vsnprintf` 截断），但会把尾部 `txd=` 切掉。改 192 后完整输出 |

> 这两处不影响功能，属于"文档与余量"层面的收尾。

---

## 8. 10 分钟连续运行记录（首次上板实测）

> 时间：2026-11-02 10:22 – 10:32
> 硬件：STM32F103C8T6 + USB-TTL(CH340) · COM5 · 115200 8N1
> 输入：10k 电位器分压，测试期间**未人为调节**
> 统计方：上位机侧协议解析器（不是 Keil 调试窗口，也不是示波器）
> 原始日志：`docs/SOAK_10MIN.txt`

### 8.1 结果

| 指标 | 结果 | 判定 |
|---|---|---|
| 运行时长 | 601.1 s（10 分 01 秒） | — |
| SAMPLE 帧 | 60117 帧 → **100.01 Hz** | ✅ 与设计 100Hz 一致 |
| **drops**（设备端采样环溢出） | **0** | ✅ 一个采样点都没丢 |
| **frame_err** | **0** | ✅ 无 CRC / 格式错误 |
| adc_err / uart_err / rx_err | 0 / 0 / 0 | ✅ |
| **序号缺口（seq8）** | **0** | ✅ 样本级连续 |
| **整帧丢失（帧头 SEQ）** | **0** | ✅ 整帧级连续 |
| 解析错误 | 0 | ✅ |
| STAT 帧 | 原始日志**未逐帧计数**（每 60 s 打一次快照）；另跑 61.1 s 复测 **61 帧 → 1.00 Hz**，与 `APP_STAT_PERIOD_MS=1000` 一致 | ✅ 见 8.4 |
| BOOT 帧 | 0 | ✅ 中途未复位 |
| 链路中断 | 0 | ✅ |
| 设备运行时间（结束时） | 1,825,000 ms ≈ 30 min | 开始测试前已稳定运行约 20 min |
| 状态切换（`changes`） | **36 次 —— 自上次 `reset` 或上电以来的累计值**（本次测试期间没下过 reset），不是本次 10 分钟的增量 | ⚠️ 见 8.3 |

每分钟采样数：

```
[ 61s] 6575   [122s] 6107   [183s] 6101   [244s] 6107   [301s] 5635
[362s] 6106   [423s] 6107   [484s] 6106   [540s] 5638
```

单分钟数字的波动有两个来源：① 打点按 `>= 60 s` 触发，实际间隔略大于 60 s；
② 更主要的一条——当时脚本用 `ser.read(8192)`，pyserial 会**累积到凑满 8192 字节才返回**
（115200 下约 4.7 s），所以打点被整体推迟一个读周期，于是出现 6107 与 5635 交替。
**总账 60117 / 601.1 s = 100.01 Hz** 才是权威口径（脚本已改为按 `in_waiting` 读取）。

### 8.2 这组数据证明了什么

整条链路——TIM3(TRGO) → ADC1 → DMA1 → 采样环 → 组帧 → DMA 发送 → 串口 → 上位机解析——
在 10 分钟内**零丢点、零丢帧、零错误**，并且采样率精确到 100.01 Hz。
设备在测试前已连续运行约 20 分钟，等效于 30 分钟无复位。

### 8.3 这组数据**不能**证明什么

- **ADC 的电压精度/线性**：只证明了"帧在流动"，没有用标准源比对读数
- **8 小时长期稳定性**：只跑了 10 分钟（+ 前 20 分钟）
- **抗干扰**：没有注入噪声、没有带电拔插
- **告警滞回是否合适**：表里那个 36 是 `alarm.change_count` 的**累计值**
  （测试开始时设备已连续跑约 20 分钟），**不能读成"10 分钟内切换了 36 次"**。
  本次窗口的首末值当时没有记录，所以严格讲：**这 10 分钟内的切换次数是未知的**。
  现有旁证只有两段：10:32 读到 36、10:37 读到 40（5 分钟 +4），
  以及 10:39 起的 94 s 窗口内增量为 0。
  要判断滞回是否偏窄，应用 `soak.py` 记录首末 `changes` 求差，同时在阈值附近缓慢来回调。

### 8.4 STAT 帧数量的复核（2026-11-02 10:37 追加）

**结论：固件按 1 Hz 发 STAT，没有丢；10 分钟记录里"只有 10 条"是打点方式，不是收帧数量。**

原因在当初那个临时采集脚本：它**每收到一帧 STAT 就覆盖同一个 `stat` 变量，只在整 60 s 的刻度上打印一次**
（`if elapsed >= next_mark: ...; next_mark += 60.0`）。所以 10 分钟只有 10 行输出，
每行是**那一瞬间的 STAT 快照**，不是"10 分钟只来了 10 帧"。

为把这件事钉死，重新做了两次独立复测（串口直连，逐帧计数）：

| 复测 | 时长 | SAMPLE | STAT | STAT 频率 |
|---|---|---|---|---|
| A（`docs/SOAK_STAT_1MIN.txt`） | 61.1 s | 6106（100.00 Hz） | **61** | **1.00 Hz** |
| B（临时探针，仅打印） | 94 s | 9394（99.9 Hz） | **94** | **1.00 Hz** |

对照固件：`app_config.h:26` `APP_STAT_PERIOD_MS = 1000u`，
`app_task.c:449` 以 `tick_ms - stat_last_ms >= APP_STAT_PERIOD_MS` 为条件触发。
10 分钟理论约 600 帧，与"每 60 s 打印一次"完全不是一回事。

**顺带确认的另一点**：复测 A 中 EVENT 帧为 0，而 STAT 里 `changes` 是 40。
这不是 EVENT 丢帧 —— 那 40 是**开机以来的累计值**，复测窗口内 `changes` 增量为 0（窗口内没有状态跳变）。
代码上 `app_alarm_update()` 里 `change_count++` 与"返回新级别"发生在同一分支，
而 `process_sample()` 一旦发现 `level != last_level` 就调用 `emit_event()`，
因此**每一次切换必然对应一帧 EVENT**，不存在只在计数里加、不发帧的情况。

**工具已入库**：`host/tools/soak.py`（本次新增）按帧类型分别计数并输出频率，
不再有"每 60 s 只打一行"的歧义。用法：

```bat
python host\tools\soak.py            :: 默认 10 分钟
python host\tools\soak.py 1 COM5     :: 60 秒
```

输出末尾会直接给出 `STAT 帧 : N (x.xx Hz，设计 1.00 Hz)`，低于 1 Hz 就说明 STAT 真的在丢。

## 9. 零点 / 满量程 / HT 修复 上板验证（2026-11-02 10:50–11:05）

### 9.1 测量方法

| 项 | 说明 |
|---|---|
| 输入源 | PA1 直接接电源轨：GND（零点）、3.3V（满量程），**断电改线后再上电** |
| 采集 | 上位机逐帧解析，每次 4.7 s ≈ 468 帧（99.75 Hz） |
| 工具 | `host/tools/calib.py`（`zero` / `full` / `watch` 三种模式） |
| 口径 | **线上传的是换算后的 mV（`raw_mv`），不是 ADC 原始码**；下文 LSB 由 mV 反算，0.806 mV/LSB |
| 计时 | 首次测量用的旧循环是 `ser.read(8192)`，**请求 3 s 实际跑了 4.69 s**（原因见 9.1.1），所以下文两次的时长都写实际值 |
| 频率 | 短窗口算出的 99.75 / 99.97 Hz **不作为采样率结论**（300~470 帧里差 1 帧就是 0.2%~0.3%），采样率口径以 §8 的 601.17 s 总账为准 |

改线前板子挂了 OLED，测满量程前已全部拔除，避免屏从 3.3V 轨取电把轨压拉低、
被误判成增益误差。

#### 9.1.1 为什么"请求 3 秒"实际跑了 4.69 秒

不是采集变慢，是**读循环的粒度问题**：

```python
chunk = ser.read(8192)      # 旧写法
```

本机（Windows + CH340 + pyserial 3.5）实测：`read(n)` 会**一直累积到凑满 n 字节才返回**，
数据持续流入时不在 timeout 处停下。链路上约 1.7 KB/s（100 Hz × 17 B），凑满 8192 B 需要
**4.7 s**，于是循环总是晚一个读周期才退出（机制未查证，只记录现象）：

| 请求时长 | 实际时长 | 多出 |
|---|---|---|
| 3 s | 4.69 s | 一个读周期 |
| 5 s | 9.41 s | 两个读周期 |

已改为按 `ser.in_waiting` 取，修复后实测 `真实时长 3.00 s / 300 样本`。
**数据本身不受影响**：均值是对 468 帧求的，只是"时长"这个标签当时写错了。

### 9.2 零点（PA1 → GND）

```
实际时长 4.69 s（请求 3 s，多一个读周期；见 9.1.1）/ 468 帧
raw_mv min/mean/max : 0 / 1.75 / 9 mV
反算 LSB（均值）     : 2.2
峰峰值              : 9 mV ≈ 11 LSB
判定                : PASS（阈值：均值 ≤ 3 mV）
```

### 9.3 满量程（PA1 → 3.3V）

| 次序 | 时长 / 帧数 | raw_mv 均值 | 反算 LSB | 峰峰 |
|---|---|---|---|---|
| 首次（旧计时） | 4.69 s / 468 | 3299.90 mV | 4094.9 | 1 mV |
| **复测（计时修正后）** | **3.00 s / 299** | **3299.87 mV** | **4094.8** | 1 mV |

两次相差 **0.03 mV（约 0.04 LSB）**，可复现。判定 PASS（阈值：均值 ≥ 3295、最小 ≥ 3290）。

### 9.4 误差分析（这两点能说明什么、不能说明什么）

| 指标 | 数值 | 说明 |
|---|---|---|
| 零点偏移 | **+1.75 mV（+2.2 LSB）** | ADC 内部偏移 + 地线压降，量级正常 |
| 满量程读数 | 3299.87 mV（4094.8 LSB，复测） | 与理想 3300 差 −0.13 mV（−0.004%） |
| 跨度（span） | 3299.87 − 1.75 = **3298.12 mV** | 相对 3300 偏小 1.88 mV（**−0.057%**） |
| 零点噪声 | 峰峰 **9 mV（11 LSB）** | 约 ±5 mV，占 WARN 阈值 0.2% |

**能说明**：零点偏移约 2 LSB、跨度误差 0.06%，对 2400 / 3000 mV 的阈值判断完全够用；
ADC 与 `raw*3300/4095` 的换算在两端都没有明显偏差。

**不能说明**：

- **不是"全量程线性度 0.06%"** —— 只测了两点，只能算一个端点直线，中间段（25%/50%/75%）
  没测，非线性误差未知。
- **满量程的"峰峰只有 1 mV"不代表噪声更小**：输入顶在 VREF 上时，ADC 输出在 4094/4095
  之间钳位，峰峰被饱和截断。零点那 9 mV 才是真实的噪声水平。两处数字不可比。
- **这是"比例测量"，不是绝对电压校准**：STM32F103C8T6（LQFP48）内部 **VREF+ 与 VDDA
  是同一条电源**，PA1 接板载 3.3V 时，ADC 的参考和输入是同一个节点。所以 4095 满码
  只能证明"ADC 满码与 `raw*3300/4095` 换算正常"，**不能证明板上 3.3V 真的等于 3.300V**。
  要标定绝对精度得用万用表实测 VDDA 再比对（已列入 §4.2）。

### 9.5 HT（半传输）修复验证（含反向对照）

#### 9.5.1 正向：修复版

| 阶段 | 命令长度 | 跨过 32 B 半传输点 | ERR 行数 | 回显长度 | rxf 增量 |
|---|---|---|---|---|---|
| A | 8 字符 | 否 | 10 / 10 | 29 / 29 | +0 |
| B | 48 字符 | **是，必然触发 HT** | 10 / 10 | 69 / 69 | +0 |

`uart_err +0`、`frm +0`，RESULT: PASS。

#### 9.5.2 反向对照：临时去掉早退，看测试能否抓到旧行为

方法：把 `usart.c` 里 HT 早退那 3 行注释掉（源码里标 `# TEMP-EXP`），重新编译并烧录，
用**同一个** `htcheck.py` 再跑一次，然后还原、重编、重烧。

```
注释掉早退后：Code 20700 → 20692（少 3 条指令）
UV4.exe -f DataAcq.uvprojx → Erase Done / Programming Done / Verify OK
```

| 指标 | 修复版 | 去掉早退 | 差 |
|---|---|---|---|
| 短命令 ERR 行数 | 10 | 10 | 无 |
| 长命令 ERR 行数 | 10 | **10** | **无（！）** |
| 长命令回显长度 | 69 字节 | **84 字节**（63 个 `q`，被 64 字节行缓冲截断） | +15 |
| `rxf` 增量 | 0 | **+10** | +10 |
| `uart_err` / `frm` | 0 / 0 | 0 / 0 | 无 |

#### 9.5.3 关键结论：数 ERR 行抓不到这个 bug

最初那版测试只数 `ERR unknown command` 的行数，**它对这个 bug 没有判别力**，原因是：

> HT 上交的是**前 32 字节**，其中不含 `\r\n`。重复交付的两段 32+48 字节会**拼进同一行**，
> 所以最终仍然只产生**一行** ERR —— 重复只能从"这一行变长了"看出来，从行数上看不出来。

真正有判别力的是另外两项：

| 判别指标 | 原理 | 修复版 | 旧行为 |
|---|---|---|---|
| `rxf` 增量 | HT 时 `rearm` 撞 `RxState == BUSY_RX` → `HAL_BUSY` → `s_rx_fail++` | 0 | +10（每条命令 +1） |
| 回显长度 | 同一批字节被上交两次，行内容被拼接 | 69（21 + 48） | 84（拼接后被 63 字符上限截断） |

所以 `htcheck.py` 已加上回显长度的断言，两个指标同时成立才算 PASS——
**只断言一个"看起来是 0"的数字，等于没测**（和当初给 `gui_smoke` 加注入缺口是同一个教训）。

#### 9.5.4 这条证据能说到什么程度

- ✅ 修复版行为正确（两项独立指标）；
- ✅ 测试有判别力（去掉修复后两项同时报警）；
- ⚠️ 只覆盖 48 字节这一种长度；更长命令会被 64 字节行缓冲截断，属设计行为，未在此测；
- ⚠️ 反向对照是在**本机临时改代码**做的，那个 `# TEMP-EXP` 版本没有提交，
  仓库里只有修复版（`Code=20700`）。实验记录见 `docs/CALIB_20261102.txt` 第 4 节。

工具：`host/tools/htcheck.py`（A/B 对照 + `rxf` + 回显长度三项断言，可复跑）。

## 10. 上位机串口读取修复（2026-11-02）

做真机界面截图时发现：连上 COM5 跑 6 s 只统计到 **468 点**（应约 600），界面每两三秒才跳一次。

根因与 `calib.py` / `soak.py` 是同一类：`SerialWorker.run()` 里用的是

```python
data = self._ser.read(4096)
```

本机（Windows + CH340 + pyserial 3.5）实测观察到：`read(n)` 会**累积到凑满 n 字节才返回**，
数据持续流入时不在 timeout 处停下。链路约 1.7 KB/s，凑满 4096 B 要 **2.3 s** ——
所以界面表现为"卡 2 秒、然后涌一批"。**具体机制与驱动/版本的关系尚未查证**，这里只记录现象；
改用 `in_waiting` 后现象消失。

| | 修复前 | 修复后 |
|---|---|---|
| 6 s 统计点数 | 468（≈78 Hz） | — |
| 16 s 统计点数 | — | **1597（≈99.8 Hz）** |
| 首帧延迟 | ≈2.3 s | < 10 ms |

修法：`n = in_waiting; 为 0 就 sleep 5 ms; 否则 read(n)`。

> 这个缺陷只在"真串口 + 界面"这条路径上暴露，`--demo` 与协议单测都碰不到——
> 这也是之前 §5 里"GUI 未接真实串口"那行必须诚实标注的原因。

同一轮还修了坐标轴的显示问题：pyqtgraph 默认给刻度加 SI 前缀，于是时间轴被写成
`1.6 ks`、电压轴 `3 kmV`。对固定单位（秒 / 毫伏）来说这层换算毫无意义，还会让读数字
的人多绕一道。已对两条轴调用 `enableAutoSIPrefix(False)`，现在直接显示 `1600 s` / `3000 mV`。
两张截图（`gui_demo.png`、`gui_real_serial.png`）均已按修复后的界面重新生成。

## 11. 演示源与冒烟截图的两处修正（2026-11-02）

用户逐像素看 `gui_demo.png` 时发现两处破绽，都成立。

### 11.1 截图在事件循环之外抓 → 顶部变成"未连接"

`gui_smoke.py` 的 `win.grab()` 原来写在 `app.exec()` 之后。退出后窗口会走
`closeEvent -> _disconnect()`，于是：

- 顶部标签从琥珀色的「演示模式（无硬件）」变成红色的「未连接」；
- 右侧「运行时间」停在最后一条 STAT（3.0 s），而「采样数」已经跑到 4 秒的量。

修法：截图与所有取值都放进 `QTimer` 回调，在 `app.quit()` **之前**完成。
另加一条断言：顶部状态必须包含「演示模式」，否则 FAIL——这样同类问题下次会自己暴露。

### 11.2 演示源判级没有滞回 → 事件表自相矛盾

`DemoSource._tick()` 原来是无回差的简单比较：

```python
lvl = 0
if filt >= self.crit: lvl = 2
elif filt >= self.warn: lvl = 1
```

于是事件表里出现 `WARN -> NORMAL | 2394 mV`，而固件的退出条件是要掉到
`warn - 50 = 2350` 以下。同一份材料里两个判级规则不一致，是最容易被抓的那种破绽。

改为与固件一致的**相邻级别跳转 + 50 mV 回差**（`THR_HYST_MV`）：

```python
lvl = self.level
if lvl == 0:
    if filt >= self.warn:            lvl = 1
elif lvl == 1:
    if filt >= self.crit:            lvl = 2
    elif filt < self.warn - THR_HYST_MV: lvl = 0
else:
    if filt < self.crit - THR_HYST_MV:   lvl = 1
```

### 11.3 时间轴对齐

`DURATION_MS` 由 4000 改为 **4050**：STAT 是 1 Hz，多等 50 ms 让 `t = 4000 ms` 那条
STAT 被处理，避免截图里"运行时间 3.0 s / 采样 400 点"看着像丢了数据。

### 11.4 重跑结果

```
顶部状态      : 演示模式（无硬件）
采样点        : 400
告警事件行数  : 2
事件 1        : 770 ms  NORMAL -> WARN    2412 mV   （≥ 2400，进入 WARN）
事件 2        : 2040 ms WARN -> NORMAL    2348 mV   （≤ 2349，退出 WARN）
RESULT: PASS
```

两条事件的数值都落在 50 mV 回差允许的区间内，与固件规则一致。

## 12. 阶段一：ADC 故障恢复验证（2026-11-02 23:46:02–23:47:04）

完整报告见 **`docs/STAGE1_ADC_RECOVERY.md`**；
本次采集的原始日志见 **`docs/STAGE1_RAW.txt`**（由 `host/tools/stage1_evidence.py` 一次写出，
报告里的每个数字都能在日志里找到对应行）。

> 方法边界：用编译开关隔离的文本命令 `adcinject` 注入“错误标志”，
> 走的是 `app_measure_on_error()` 这条路，**不是真实的 DMA 电气故障**。

测试环境：COM5 / CH340 / 115200 8N1，Python 3.13.14 + pyserial 3.5，
注入版 `Code=20808`（`APP_DEBUG_INJECT=1`），PA1 = 1531.7 mV（电位器）。

| 检查点 | 结论 |
|---|---|
| DMA 错误被记录 | ✅ 20 次注入 → `adc_err` 精确 +20 |
| ISR 只置标志 | ✅ 单次恢复 **2.1–4.9 ms（平均 3.8，n=5）**，均 < 10 ms 采样周期 |
| 主循环执行 DeInit/Init/校准 | ✅ 17 次恢复全部出现 `[rec] adc restarted`，0 次失败 |
| 重启后恢复采样 | ✅ 30.001 s / 3001 帧 / **100.031 Hz**，`seq8` 缺口 0，BOOT 帧 0 |
| 是否丢样 | ✅ 10 次恢复：20181 ms 内样本 +2018（理论 2018.1），**丢样 0**，`drop` 0 |
| 重试限速 | ✅ 1 s 内注 5 次 → 恢复 2 次（9 ms 与 1006 ms），间隔 **997 ms** |
| 计数自洽 | ✅ 20 次注入 / 17 次恢复 / 3 次被限速合并，三数互相印证 |
| 是否影响 TIM3 节拍 | ✅ 恢复后仍 100.031 Hz |

**测量口径（重要）**：`SAMPLE.t_ms` 是“主循环处理时刻”而非采集时刻，
`seq8` 只数已处理样本，两者都**看不出恢复空档**。丢样只能用
「样本增量 ÷ (设备时间增量 / 10 ms)」衡量，`Δn` 与 `Δt` 同取自 STAT 帧。

**未验证**：真实 DMA 电气故障、`DeInit/Init` 失败路径、持续失败时的降级策略、8 小时稳定性；
「恢复后首样本被旧值顶替」已排除「多推一帧」（20 次注入 0 多余帧），
但静态直流下无法与噪声区分（1528–1546 mV，峰峰 18 mV），需动态信号才能判。

代码改动：

| 轮次 | 文件 | 改动 | Release |
|---|---|---|---|
| 上一轮（`43d381f`） | `App/Inc/app_config.h` | `APP_DEBUG_INJECT` 默认 `0u` | 不编入 |
| 上一轮（`43d381f`） | `App/Src/app_task.c` | 文本命令 `adcinject`（`#if` 包住） | 不编入 |
| **本轮** | — | **无代码改动**（仅新增日志与采集脚本、重写报告） | — |

尺寸：`0` → **20700**（与改动前逐字节一致）；`1` → 20808（+108 字节）。
测试后已改回 0、重新烧录，当前板上为正式版固件（实测 2 s / 200 帧 = 100.0 Hz）。

## 13. 阶段二：ADC 精度与线性验证（2026-11-03 08:48–08:52）

完整报告见 **`docs/STAGE2_ADC_LINEARITY.md`**；原始数据 `docs/LIN_SWEEP.csv`（2503 行）与 `docs/LIN_SWEEP_FULL.csv`（3504 行，全量程）；
工具 `host/tools/lin.py`（`hold` / `sweep` / `step` / `--from-csv`）。

环境：**COM6**（比阶段一换口）、正式版固件 `Code=20700`、PA1 ← 电位器。
本轮**无代码改动**。

| 检查项 | 结论 |
|---|---|
| 换算公式 | ✅ 先乘后除不溢出（4095×3300=13.5M）；截断偏低 ≤0.8 mV |
| 参考电压 | ✅ 固定 3300 mV，**比例测量**（VREF+ 与 VDDA 同源，LQFP48 无独立引脚） |
| 有效分辨率 | **1 mV**（1.24 LSB）；滤波不能突破量化地板 |
| 静置噪声 | raw σ 2.40 mV / 峰峰 11 mV；filt σ 1.00 mV / 峰峰 4 mV → **抑制 2.40×**（理论 √8=2.83） |
| 滤波器实现 | ✅ 均值偏移仅 −0.43 mV，无窗口错位 |
| **群延迟** | ✅ 斜坡互相关实测 **4 点 = 40 ms**（L=3 时 30 ms 几乎同优），理论 3.5 点 = 35 ms |
| 中间量程单调性 | ✅ 两轮扫掠：826–3300 mV（12/16 段）、**0–3300 mV（16/16 段）**，步长中位 1 mV/点，无死区 |
| 异常台阶 | ✅ 全量程仅 2 处 >20 mV 跳变（最大 +38 mV），反向抖动集中在 −5~−10 mV，判定为电位器接触噪声（静置不出现） |
| 帧节拍抖动 | ✅ **3503 个相邻 `t_ms` 间隔全部等于 10 ms**，0 例外（毫秒分辨率无抖动） |
| 绝对电压精度 | ❌ **未验证**（万用表没电，无独立参考） |
| INL / DNL | ❌ 无法测（固件只上报 mV，不上报原始码） |
| 电位器接触噪声对判级的影响 | ❌ 未量化（换多圈精密电位器或加 0.1 µF 电容后对比） |

**是否需要改代码：不需要。** 逐项理由（`/4095` 不改、不四舍五入、不加 VDDA 校准、
不上报原始码、不提高上报分辨率）见阶段二报告 §7——当前实现与"判级"用途匹配。

## 14. 阶段三：UART + DMA + IDLE 异常验证（2026-11-03 08:58–09:01）

完整报告 `docs/STAGE3_UART_DMA.md`；原始记录 `docs/STAGE3_RAW.txt`；
工具 `host/tools/uart_fault.py`（9 个用例）。环境 COM6 / 正式版 `Code=20700`。
本轮**无代码改动**。

| 检查项 | 结论 |
|---|---|
| CRC 错误 ×20 | ✅ `frame_err +20`，`uart_err +0`，链路存活 |
| 长度非法 41/255/200 | ✅ `frame_err +3`，无越界 |
| 半截帧 | ⚠️ **确定性吃掉后续 2 帧**（4/6 成功，前 2 个丢），期间文本响应也被吞 |
| 未知 TYPE=0x99 | ✅ ACK `result=2`，`cmd_err +1` |
| 非法文本命令 | ✅ 1 行 `ERR`，`cmd_err` 不变（设计如此） |
| 超长文本 200 字符 | ✅ 回显 84 B = 21 + 63，截断不越界 |
| 跨 64 B DMA 缓冲（20 ping/140 B） | ✅ ACK **20/20**，解析错误 0（不跨界对照 8/8） |
| TX 队列灌满（100 条 stat） | ✅ 丢 11333 B，但 **解析错误 0、无半帧**（整帧原子成立） |
| FE/NE 风暴（错误波特率） | ✅ `uart_err +144`、**`rxf +0`**、恢复成功 |
| ORE 注入 | ✅ 用"停 DMA"注入：`saw_ore=1`，ORE 被 DMA 顺带清掉、中断来不及跑，链路不受影响 |
| RX 环 256 B 溢出 | ❌ 未触发（需主循环阻塞 >22 ms，只能代码桩） |
| 错误类型分类 | ✅ 文本通道加 `ERRSRC ore/fe/ne/pe`：144 次错误全部归 `fe`，`ne`=0 |

本轮代码改动（与前两阶段不同）：`usart.c` 增加 4 个分类计数与 `usart_ore_inject()`
（`#if APP_DEBUG_INJECT` 包住）；`app_task.c` 文本 `stat` 追加 `ERRSRC` 行、新增 `oreinject`。
二进制 STAT 帧与上位机兼容性不变。Release `20700 → 20876`（+176 B，RW 108 → 124）。

仍待决定的两处加固：① parser 空闲超时复位，消除半截帧连锁；
② RX 重挂失败后限速重试，消除"静默停摆"。

> 当前正式固件基线：**Code=20876 / RO 996 / RW 124 / ZI 4916**，0 Error 0 Warning。
> （本节写于加固之前；加固后基线变为 **21208 / RW 148**，见 §14.1 与 §1。）
> 板上已烧回正式版，实测 2 s / 200 帧 = 100.0 Hz。

### 14.1 补充加固 A/B（2026-11-03 09:12–09:23）

完整报告 `docs/STAGE3_GUARD.md`；原始记录 `docs/STAGE3_GUARD_RAW.txt`；工具 `host/tools/uart_guard.py`。
参数：`APP_RX_FRAME_TIMEOUT_MS = 50`、`APP_RX_RESTART_INTERVAL_MS = 200`。

| 项 | 内容 | 判定 |
|---|---|---|
| **A** parser 空闲超时复位 | 超时判定放在**喂字节之前**；只复位 parser，不动 rx 环；`reset` 不清时间戳 | **PASS** |
| **B** RX 重挂守护 | 以 `RxState != BUSY_RX` 判定；限速 200 ms；PRIMASK 内二次检查 + 启动 | **PASS** |

A 组 6 项：正常帧 10/10、半截帧+100 ms 后 **ACK（pto +1）**、分段 15 ms 不误判（pto +0）、
背靠背 20/20、**边界 45 ms 丢 / 62 ms 收**、连续 5 次超时 5/5（pto +5）。
B 组 6 项：单次恢复 152 ms、连续 3 次全恢复、50 ms 内两次恢复 322 ms（两个限速窗口）、
恢复后 10/10、`rxstop` 期间 SAMPLE 仍 30 帧/300 ms（TX 正常）、3 分钟 9 次注入 9 次恢复（fail 0）。

回归：

| 用例 | 加固前 | 加固后 |
|---|---|---|
| **T3 半截帧** | 收帧 1/3 | **收帧 3/3、`frm +0`** |
| 其余 8 项 | — | 与首轮一致（T8 仍只认「解析错误 0」） |
| 上位机单测 | 28 项 OK | 28 项 OK |
| 采样频率 | 100.0 Hz | 100.0 Hz |

尺寸：Release **20876 → 21208**（+332 B，RW 124 → 148）；Debug 21792。
NOT TESTED：8 小时长跑、真实 HAL 返回 BUSY 的重挂失败、其他超时参数、GUI 长时联调。

## 15. 阶段四：固件 C 模块单元测试（2026-11-03 09:27–09:30）

完整报告 `docs/STAGE4_C_UNIT_TESTS.md`；原始输出 `docs/FW_TESTS_RAW.txt`；测试源码 `fw_tests/`。

**关键点：编译的是仓库里的真实固件源码**（`app_proto.c` / `app_alarm.c` / `app_filter.c`），
不是复制、也不是用 Python 重写一份逻辑。工具链 `gcc (tdm64-1) 4.9.2`，
参数 `-std=c99 -Wall -Wextra -Werror -O2`，**零告警通过**。

| 模块 | 覆盖重点 | 判定 |
|---|---|---|
| `app_proto.c` | CRC 标准向量 0x29B1、组帧 17/40/41 边界、8 个解析状态、CRC 错不回调、LEN 越界、`AA AA 55` 重同步、半截帧现状 | **PASS** |
| `app_alarm.c` | 3 次去抖、相邻跳转、滞回边界（2350 / 2349、2950 / 2949）、阈值校验含 `warn=65500` 回绕回归、阈值变更清计数、NULL | **PASS** |
| `app_filter.c` | 启动部分窗、满窗 450、覆盖滑窗 550/650、8×65535 不溢出、阶跃、40 点规格比对、NULL、count 饱和 | **PASS** |

```
断言 167 项，失败 0 项  → RESULT: PASS
```

第一版有 4 个 FAIL，**全部是测试自身写错**（CRC 期望值凭印象填成 0xF4C3；`feed()` 返回最后一字节的结果，
我多喂一字节把 ERROR 覆盖成 NONE）。修正测试后全过，固件代码未改。

本轮**无固件改动**（`git diff HEAD -- App Core` 为空），板上仍是 Release `Code=21208`。

未覆盖：`app_measure.c` / `app_tx.c` / `app_cmd.c` / `app_task.c`（强依赖 HAL，需打桩，按规矩不擅自改架构）。
与 Python 那 28 项的分工：Python 测上位机与协议一致性，C 测试测**设备端真正执行的那份代码**，互不替代。

---

## 16. 文档一致性核对与证据分级（2026-11-03）

Stage 1–4 做完后，`README`、本报告 §1/§4.2/§5、`PROTOCOL.md` 都还停在 v5.1.1 的叙述上。
这一轮做了两件事：**把文档拉回与代码一致**、**把四份阶段报告按证据类型重新归类**。固件一行没动。

| 产物 | 内容 |
|---|---|
| `docs/AUDIT_20261103.md` | 20 条文档 vs 代码逐条核对结果；App/HAL 分层边界复核（含 `app_task.c` 调 `HAL_GPIO_WritePin` 的判定） |
| `docs/TEST_INVENTORY.md` | Stage 1–4 证据分级（A=PC / B=真板真信号 / C=注入）+ **风险清单 R1–R14** |
| `docs/SOAK_PLAN.md` | 1 h / 8 h 长跑记录表（**空模板，尚未执行**） |

本轮同时复跑的验证（结果与历史一致，没有新数字）：

| 项 | 命令 | 结果 |
|---|---|---|
| 固件全量重编译 | `UV4.exe -r DataAcq.uvprojx` | `Code=21208 / RO 996 / RW 148 / ZI 4916`，0E0W |
| 固件 C 单测 | `fw_tests`（gcc 4.9.2，`-Werror -O2`） | 167 断言 / 0 失败 |
| 上位机单测 | `python -m unittest discover -s tests` | 28 项 OK |

**本轮未做任何上板测试**，§12–§15 里所有"实测"数字仍是那四轮的原始记录，未重测、未修改。

### 16.1 两项必须留在风险清单里的（不得删除）

| 编号 | 内容 | 当前正确说法 |
|---|---|---|
| **R1** | Stage 3：`usart_start_rx()` 真实返回 `HAL_BUSY` 的失败分支未验证 | 「接收**停摆后的恢复**验证过（152 ms 救回、3 分钟 9 次全成）；**启动本身失败**那条分支只有代码审查」 |
| **R2** | Stage 2：绝对电压精度（2026-11-07 已实测，部分关闭） | 「**零点** +1.58 mV（表 0.000 V）→ **PASS**（≤5 mV，按公式 (b) 折算；含折算 4.58 mV，余量 0.42 mV）；**满量程 +54.75 mV ＝ 1.66 %FS**（相对读数 +1.69 %）点估计超 1 % 门槛，表（**福仪 FY106A，DC 4 V 档**；公式 **4 页 3 种写法、互相冲突**（原件未核对）：(a) ±(0.8 %读数+2 字)=±28.0 mV，(b) 转载页 ±(1.2 %+3)=**±41.9 mV**，取**已查到的最大值、不构成上界**）使按 (b) 折算的条件估计范围 **+0.39 %~+2.93 %FS 跨门槛**；误差**与"固件假设 3.300 V、3.3 轨实测 3.245 V"一致**，但在表的误差折算内**无法区分"板偏"与"表偏"**，且**未做比例测量** ⇒ **R2 部分关闭**，不得宣称"绝对精度已验证"。」 |

> 这两条不因为"其它项都过了"而降级。它们各自对应一个**没被真实触发**的分支 / 一个**缺独立参考**的结论。

---

## 17. 阶段六（第 1 项）：1 小时连续运行（2026-11-03 12:06:12 – 13:06:12）

完整记录 **`docs/SOAK_60MIN_RECORD.md`**（由 `host/tools/soak_finish.py` 从原始日志自动生成，
不是手填）；原始日志 `docs/SOAK_60MIN_20261103.txt`（2026-11-04 为腾出 `soak.py` 固定输出名，
由 `SOAK_60MIN.txt` 改名归档，内容未变）。

环境：COM6 / CH340 / 115200 8N1，正式版固件 `Code=21208`（已确认 `adcinject` 返回 unknown，
说明 `APP_DEBUG_INJECT=0`），PA1 ← 电位器约 942 mV（NORMAL 区中部，全程未动）。
开跑前发过一次 `reset`，设备计数器全部从 0 起算。
PC 侧已改为**从不睡眠 / 从不休眠 / 关闭 USB 选择性暂停**（原因见 §17.3）。

| 指标 | 实测 | 门槛 | 判定 |
|---|---|---|---|
| 时长 | 3600.0 s | — | — |
| SAMPLE 帧 | **360047 帧 → 100.013 Hz**（按标称 3600.0 s 计） | 100.00 ± 0.10 | PASS |
| STAT 帧 | **3601 → 1.000 Hz** | 1.00 ± 0.05 | PASS |
| 收到字节 | 6279243 B（1744.2 B/s） | — | — |
| drops | 0 | = 0 | PASS |
| frame_err | 0 | = 0 | PASS |
| adc_err | 0 | = 0 | PASS |
| uart_err | 0 | = 0 | PASS |
| rx_err | 0 | = 0 | PASS |
| seq8 缺口（样本级） | 0 | = 0 | PASS |
| 整帧丢失（帧级） | 0 | = 0 | PASS |
| BOOT 帧 | 0（中途未复位） | = 0 | PASS |
| 链路中断 | 0 | = 0 | PASS |
| 解析错误 | 0 | = 0 | PASS |
| 状态切换 changes | 0 | 输入不动应为 0 | PASS |
| 时基偏差（帧率反推） | **+0.010%** | < 0.1% | PASS |
| 设备 uptime（结束） | 3,974,000 ms | — | — |

> **H11 行读法**：`+0.010%` 是**记录值**，由日志里 `%.2f` 的 `100.01 Hz` 直接折算
> （`soak_finish.py` 第 153 行 `|hz−100|/100×100`），毫秒级 Δt 未留存，可复算性只有算术层。
> 它**不是**"已测得的 HSE 偏差"；证据限制见 §17.1。

**12 项门槛全部 PASS。** 全程共 **59 个每分钟打点**（60 s – 3540 s），每点落在 **6000–6001 帧**之间
（合计 360047 帧 → 100.013 Hz，按标称 3600.0 s）。±1 帧的波动来自打点本身按 `elapsed >= next_mark` 触发、
`next_mark` 每次加 60.0 s，会与 10 ms 的帧流产生微小错位，不是主循环抖动——
判定应以总账为准，这一点与 §8.1 记录过的 10 分钟那次是同一个道理。

### 17.1 能证明什么

- 1 小时内**零丢点、零丢帧、零错误、零复位、零重连**；
- 采样率按**标称窗**折算为 100.013 Hz（360047 / 3600.0 s），与设计 100 Hz 一致；
  **该折算不能用来推算 HSE 相对 PC 墙钟的偏差**——它只说明"这一小时里收到了 360047 帧"，
  不含设备与主机之间的时基对比；本轮的时基精度**未按 uptime 口径测过**（当时没有记录终点 uptime 差），
  因此**不给出精确 HSE 偏差数值**。
  **口径说明**：`soak.py` 合计行打印的是 `100.01 Hz`，由工具内部宿主侧墙钟差值计算；该毫秒级 Δt 未写入日志
  （日志只把时长显示到 0.1 s：`3600.0 秒`）。`≈3600.1 s` 仅是根据两位小数频率反推的近似解释值，
  不是日志中保存的精确实测值。
  两个数值的差异来自计算时采用的时间口径及其显示精度。工具内部毫秒级 Δt 未留存，因此无法从现有日志精确复现 100.010 Hz，也不能将其唯一归因于 Δt=3600.1 s。
- 59 个每分钟打点每点 6000–6001 帧，无一次明显掉队（不是"零波动"——±1 帧是打点错位，见上文）；
- 发送队列 + DMA 在 1744 B/s 持续负载下 1 小时没有积压到丢字节；
- `uptime` 与窗口时长自洽（3974 − 3600 = 374 s，与开跑前已运行的 6.2 分钟吻合）。

### 17.2 不能证明什么

- **8 小时**：温度、长时间漂移、慢性资源增长都还没被覆盖（R3 仍然开放）；
- **绝对电压精度**：全程是比例测量，输入没变化，也没用外部参考比对（R2 仍然开放）；
- **异常注入**：这轮是"干净输入下的稳态"，不涉及故障路径。

### 17.3 为什么必须先关掉睡眠

原电源方案是"交流 15 分钟 / 电池 10 分钟进入睡眠"。若在睡眠状态下跑：
进程被挂起 → 串口不再被读取 → 数据丢在 USB 层，但**设备端 `drops` 仍是 0**，
指标会呈现"完美干净"的假结果；唤醒后 USB 重新枚举，soak.py 会按"链路中断 + 序号重新对齐"
处理，把一次大缺口记成"中断 1 次、缺口不累计"，等于把证据抹掉。

因此本轮开始前修改了电源方案（睡眠/休眠=从不、USB 选择性暂停=关），
**这是持久修改，测完需要还原**，命令见 `docs/SOAK_PLAN.md` §3 与当次对话记录。

---

## 18. 阶段 7C-2：GET_DIAG 快照与 TX 失败恢复（2026-11-03 23:2x）

完整报告 `docs/STAGE7C2_GET_DIAG.md`，原始板级日志 `docs/STAGE7C2_BOARD_RAW.txt`。

| 项 | 结果 |
|---|---|
| 新增协议 | `0x16 GET_DIAG`（LEN=0）；`0x86` 复用，`event=0` 表示快照 |
| 发送层改造 | `active`（设备真实状态）与 `reported`（**已提交到 TX 队列**）分离；成功才拉平；100 ms 节流 |
| 固件单测 | **1041 项断言，0 失败**（7C 的 892 → +149） |
| 上位机 | **72 项 OK**（+6）；界面冒烟 PASS（+3） |
| 编译 | `Code=22468 RO=1076 RW=148 ZI=4972`，0 Error 0 Warning（Code +264，ZI +16） |
| 板级 | ACK 先于快照（seq 46→47、39→40）；无故障/有故障快照字段正确；断线后快照给出真相；57 帧 `active=0` 快照 |
| 未验证 | TX 环真满时的重试与节流（仅 C 单测模拟）；多故障快照（仅白盒单测） |

---

## 19. 阶段 7C-2 收尾：证据等级与未验证清单（2026-11-03 23:2x）

本轮**只做收尾**：更新文档、重跑回归、出验收报告，**没有新增功能、没有改固件**。

### 19.1 七项未验证事项的证据等级

| 项目 | 当前验证情况 | 状态 |
|---|---|---|
| TX 环真实满载后的重试 | 只有 C 单测模拟 `emit` 返回 0，未在板上制造真实环满 | **UNIT PASS / NOT TESTED** |
| 100 ms 重试节流 | C 单元测试通过，未做真实板级满载验证 | **UNIT PASS** |
| 多故障快照 | 只有白盒单测，目前固件只登记 STUCK 一种故障 | **UNIT PASS** |
| 队列检查与写入并发 | 已确认 ACK、FAULT 均在主循环入队，无 ISR 入队生产者 | **CODE REVIEW PASS** |
| 真实传感器诊断 | 未测试 | **NOT TESTED** |
| 诊断 1h / 8h 长期运行 | 当时（11-03）未测试；**11-04 Stage 8B 已完成 X2（诊断开 1h PASS）与 8B-2（诊断关 8h PASS），仅剩诊断开 8h 待测，详见 §20** | **1h PASS / 8h(en=1) NOT TESTED** |
| GUI 按钮连接真实开发板 | 未测试 | **NOT TESTED** |

> 登记为风险 R15–R21，见 `docs/TEST_INVENTORY.md` §5。
> **`UNIT PASS` 与 `CODE REVIEW PASS` 都不是板级证据，不得写成"板级 PASS"。**

### 19.2 本轮回归（全部重跑，非引用旧结果）

| 项 | 命令 | 结果 |
|---|---|---|
| 固件 C 单测 | `gcc -std=c99 -Wall -Wextra -Werror -O2`（真实源码） | **1041 项断言，0 失败，PASS** |
| 上位机单测 | `python -m unittest discover -s tests` | **72 项 OK** |
| 界面离屏冒烟 | `QT_QPA_PLATFORM=offscreen python tests/gui_smoke.py` | **PASS**（10 项联动断言含 3 项故障/快照） |
| Release 编译 | `UV4 -r DataAcq.uvprojx` | `Code=22468 RO=1076 RW=148 ZI=4972`，**0 Error 0 Warning** |

各处 0 告警；`-Wall -Wextra -Werror` 下无一处需要豁免。

### 19.3 协议文档补充

`PROTOCOL.md` 新增 **§4.8.1 上报语义与发送失败处理**，把此前散落在设计文档与代码注释里的四件事
写进协议正文：`reported` 的定义（已入队 ≠ 对端收到）、队列满时不烧 SEQ / 不更新 reported、
100 ms 节流、**允许合并中间边沿且恢复后只提交最新 `active`**；并明确
"实时事件 vs 状态快照"的分工与"快照不用于恢复历史事件"。

---

## 20. 阶段 8B：1 小时对照（Y2/X2）与 8 小时（480 min）长跑验证（2026-11-04 ~ 11-05）

完整报告见 `docs/STAGE8B_REPORT.md`，8 小时正式记录表见 `docs/SOAK_480MIN_RECORD.md`，原始日志见 `docs/SOAK_480MIN_20261104_N.txt` 与 `docs/STAGE8B_ENV.txt`。本轮**未修改任何固件代码**，全程使用 `Code=22468 RO=1076 RW=148 ZI=4972` 正式构建。

### 20.1 六轮长跑全序列（成组列出，不隐瞒早期失败）

| 轮次 | 时间 | 构建与配置 | 物理端口 | SAMPLE 帧 / 标称频率 | 缺口 / 整帧丢失 / 解析错 | 结论 |
|---|---|---|---|---|---|---|
| ① 基线 | 2026-11-03 12:06 | `Code=21208`（无诊断模块），1h | COM6 | 360,047 / 100.013 Hz | 0 / 0 / 0 | **PASS**（§17） |
| ② 8B 首轮 | 2026-11-04 11:24 | `Code=22468`，诊断开 `en=1`，1h | COM5（`1-2.1.3`） | 360,002 / 100.001 Hz | 45 / 45 / 30（散落 30 次单字节丢失） | **FAIL** |
| ③ 对照 Y | 2026-11-04 16:14 | `Code=22468`，诊断关 `en=0`，1h | COM4（Hub `1-2.2`） | 360,033 / 100.009 Hz | 17 / 18 / 11（散落 11 次单字节丢失） | **FAIL** |
| ④ 对照 Y2 | 2026-11-04 18:14 | `Code=22468`，诊断关 `en=0`，1h | COM5（换口/换线 `1-2.1.3`） | 360,051 / 100.014 Hz | **0 / 0 / 0**（设备计数全 0） | **PASS** |
| ⑤ 复跑 X2 | 2026-11-04 19:23 | `Code=22468`，诊断开 `en=1`，1h | COM5（`1-2.1.3`） | 360,050 / 100.014 Hz | **0 / 0 / 0**（`conf` 1→1 增量 0，`mask=rep=1`） | **PASS** |
| ⑥ **8B-2（8h）** | 2026-11-04 23:28 – 11-05 07:28 | `Code=22468`，诊断关 `en=0`，**480 min（8 小时）** | COM5（`1-2.1.3`） | **2,880,109 / 100.0038 Hz**（按真实物理时长折算 **100.0140 Hz**） | **0 / 0 / 0**（drops·frame_err·adc·uart·rx·BOOT·中断全 0） | **12/12 PASS** |

### 20.2 Stage 8B-2（480 分钟 / 8 小时）核心结果与 NTP 时钟跳变定位

- **硬指标 H1–H12 全量通过**：连续运行 480 分钟，累计接收 **2,880,109 帧 `SAMPLE`**（**50,229,097 字节**，1744.1 B/s）、**28,801 帧 `STAT`**（1.0000 Hz）；设备端 `drops / frame_err / adc_err / uart_err / rx_err / 状态切换` 全 0，上位机侧 `seq8` 缺口 / 整帧丢失 / 解析错误 / 中途 `BOOT` 帧 / 链路中断全 0。打点 **479** 条（60 s – 28740 s；`soak.py` 在 `elapsed >= total` 时先退出，不写第 480 点，**不是丢一分钟**）。
- **`[7260s]` 段 ΔSAMPLE = 5705 与 H1/H11 的表达值，同源于一次宿主 NTP 校时（+2950 ms）**：
  - 478 个区间的 ΔSAMPLE 只有 **{6000, 6001, 6002, 5705}** 四种；唯一偏低段是 `[7260s]`（比 6000 少 295），同段 **`ΔSTAT = 57`**（其余 473 段 = 60、4 段 = 61）。若真丢 296 帧，8 位序号缺口应为 `296 mod 256 = 40`，实测为 **0**，因此是**计数台阶**而非链路丢帧。
  - 分段偏移拟合：前段 **100.014031 样本/s（140.3 ppm）**、后段 **100.014084（140.8 ppm）**，斜率一致；外推到 7260 s 处相差 **−295.5 个样本 ≈ −2.95 s**。
  - **Windows 事件日志**：`2026-11-05 01:28:27` 系统时间被 `svchost.exe (PID 30672)` 前跳 **+2950 ms**（Kernel-General 事件 1；同刻 Time-Service 35 记录时间源 `time.windows.com`，01:28:09 有事件 37 收到有效时间）。起跑 `23:28:21` + 7206 s ≈ 01:28:27，正落在 `7200 → 7260 s` 区间内；该时段**无** `Kernel-Power 42/107`，未发生睡眠/唤醒。
  - **机理**：`soak.py` 计时全用墙钟 `time.time()`（L65 起点、L76 打点判定、L164 合计时长）。墙钟前跳 2.95 s → `elapsed >= next_mark` **提前 2.95 s 成立**，该分钟在设备时间上只走约 57 s（故 ΔSTAT=57、ΔSAMPLE=5705），终点 `dur` 同样多算 2.95 s。
  - **定量解释两个表观值**：真实速率约 140 ppm → `140.5 ppm × 28962 s ≈ 4.07 s`；减去台阶 2.95 s ≈ **1.12 s**，与实测 H11 差值 `+1120 ms`（0.0039%）吻合。H1 的分母被拉长：`2,880,109 / 28,800.0 = 100.0038 Hz`；按**真实物理时长 28,797.05 s** 折算为 **100.0140 Hz**，与 140 ppm 一致。
  - **侧别判定**：**主机侧时钟前跳（NTP 校时）**，依据 = 事件日志 +2950 ms、时间对齐、H11 推演、墙钟计时基准四项合取。**不写"已证实"**——因日志未保存逐帧 STAT 的 `t_ms` 原文，无法直接从帧流核对该分钟的设备侧时长；**"台阶前后 STAT 运行时间是否连续"仍为 OPEN**。
  - **对账**：`n_end − n_base = 2,896,724 − 388 = 2,896,336`；`2,880,109 + 16,224（两端空档 162.243 s） = 2,896,333`，残差 **+3 个样本（≈30 ms）**，落在起跑时刻的秒级分辨率（±1 s ≈ ±100 样本）内。
  - **序号检测边界**：在当前 8 位序号检测能力范围内，未检出可分辨的序号缺口（`frame_gap` 与 `seq8_gap` 均受同一限制）；单次连续丢失恰为 **256 的整数倍**帧时不可见，"未检出"≠"绝对零丢失"。
- **边界声明**：本轮 8 小时覆盖的是**诊断关闭态（`en=0`）**；诊断开启态（`en=1`）已完成 1 小时验证（X2 PASS），其 8 小时长跑（8B-3）**已于 2026-11-05 23:10 – 11-06 07:10 完成并通过**，见 `docs/STAGE8B_REPORT.md` §9 与 `docs/SOAK_480MIN_RECORD_8B3.md`（原句此处有误，2026-11-07 已更正）。

## 21. R2 绝对电压精度：VDDA 实测与增益误差归因（2026-11-07 20:18–20:27）

> 原始读数 `docs/CALIB_RAW.txt`；步骤与记录表 `docs/CALIB_ABSOLUTE.md` §6。
> 条件：`Code=22468`（未重烧）、COM5 / `LOCATION=1-2.1.3`、USB 单路供电、电位器已从 PA1 断开、单次上电会话。

### 21.1 读数

| 点 | 输入 | 万用表 | 设备（300 样本均值） | 偏差 |
|---|---|---|---|---|
| P0 | PA1 短接 GND | **0.000 V** | **1.58 mV**（min 0 / max 8） | +1.58 mV |
| P1 | PA1 短接 3.3V 轨 | **3.245 V** | **3299.75 mV**（min 3296 / max 3300，≈4094.7 LSB） | **+54.75 mV** |

### 21.2 判定

> 百分比一律以 **FS = 3300 mV**（固件满量程）为分母；以表读数为分母的比值另标"相对读数"，不叫 %FS。

| 指标 | 实测 | 门槛 | 判定 |
|---|---|---|---|
| 零点偏移 | +1.58 mV | ≤5 mV | **按公式 (b) 折算条件下 PASS**（含折算 **4.58 mV** 仍 ≤5 mV，余量 0.42 mV） |
| 满量程绝对误差 | **+54.75 mV ＝ 1.66 %FS**（相对读数 +1.69 %） | ≤1 %FS（33 mV） | **FAIL（点估计）** |
| 跨度误差 | +53.17 mV ＝ **1.61 %FS** | ≤0.5 %FS（16.5 mV） | **FAIL（点估计）** |

### 21.3 误差归因：只能说"一致"，不能说"验证"

**PA1 接轨时，输入就是 VDDA 本身**，ADC 基本满码（均值 4094.7 LSB、最小 4090、最大 4095），
固件按 `4095 × 3300 / 4095 = 3300 mV` 折算，于是：

```
54.75 mV = 3300 − 3245
```

这是一个**算术恒等式**，不是对 ADC 增益的独立验证。它成立的唯一含义是：
"设备读数比外部表读数高 54.75 mV"，且这个差**与"固件假设 3.300 V、而轨压更低"一致**。

**在表的误差折算（按 (b) 估计 ±41.9 mV，不构成上界）内，无法区分两种解释**：

| 解释 | 也能解释这 54.75 mV 吗 |
|---|---|
| **板偏**：VDDA 真的只有 3.245 V，ADC 增益准确 | 能 |
| **表偏**：VDDA 其实是 3.30 V 附近，表读数偏低 55 mV | 能 |

因此**本轮不给出"ADC 自身增益误差 < 0.3 LSB"这类结论**（早期草稿写过，已撤回）。
要分离两者，必须做**比例测量**：同一量程下读 PA1 实际电压与 VDDA，验证 `mv_fw ≈ V_PA1/VDDA × 3300`（见 §21.5）。

**不确定度边界（两个精度来源并列，原件未核对）**：表为**福仪 FY106A**，读数时 DC **4 V 档**、分辨率 1 mV（1 字 = 1 mV）。

| 来源 | 公式 | 3.245 V 处 | 占 %FS |
|---|---|---|---|
| (a) 用户转述 | ±(0.8 % 读数 + 2 字) | ±28.0 mV | ±0.85 %FS |
| (b1) 转载页 `/ae/1005006869152807`（非原厂） | ±(1.2 % + 3) | **±41.9 mV** | **±1.27 %FS** |
| (b2) 转载页 `/ae/1005006996221800` | ±(1 % + 3) | ±35.5 mV | ±1.07 %FS |
| (b3) 转载页 `/ae/3256806170402411` | ±(1 % + 2) | ±34.5 mV | ±1.04 %FS |
| (c) `/asin/B0CRB9XHF3`（仅 FY106A） | **未印精度** | — | — |

> ⚠ **零点（0.000 V）属规格范围外折算**：三份资料都把 DC 电压标注为 `1 V~600 V`，而 P0 测点是 **0.000 V**。
> 因此 0 V 处的 `+3 字`（3 mV）是把 1 V 档公式外推到量程之外得到的，**不是该档给出的保证值**；
> 只能说"按此折算"，**适用性未经验证**——既不能据此给出溯源上界，也不宜直接断言公式在 0 V 无效。

**取已查到的最大值 (b1)（无原厂来源，不构成上界）**：满量程误差按 (b) 折算的条件估计范围为 **+12.8 ~ +96.7 mV ＝ +0.39 % ~ +2.93 %FS**（跨度误差按 (b) 折算的条件估计范围为 +11.3 ~ +95.1 mV ＝ +0.34 % ~ +2.88 %FS），
门槛 33 mV 仍落在区间内、区间跨过 1 % 门槛。
故只能写"**点估计超标、机制一致但未分离**"，**不能写"确定超过 1 %FS"，也不能写"已验证 ≤1 %FS"**。
另注：**±41.9 mV 是按已查到的公式 (b) 折算的估计值（无原厂来源，不构成上界）**——型号与量程已回填，但 4 个转载页给出 3 种冲突写法、没有一份是原厂件，
且合页只给"1 V~600 V"一档、未给 4 V 档分档精度（(c) 那份甚至连精度都没印，尺寸重量还与前几份不一致），**原件仍未核对**。

### 21.4 一个此前未记录的连带影响

设备读数 `mv_rep = V_in × 3300 / 3245 = V_in × 1.016949`，所以**告警阈值在真实电压上系统性偏低 1.69%**（点估计）：

| 标称阈值 | 真实触发点（点估计） | 区间（偏高 +0.4 %~+2.9 %，取整 5 mV） |
|---|---|---|
| `WARN 2400 mV` | **2360.0 mV** | **2330 ~ 2390 mV** |
| `CRIT 3000 mV` | **2950.0 mV** | **2915 ~ 2990 mV** |

**限定（引用前必读）**：两列都以"3.245 V 就是真值"为前提（1.69 % = `54.75/3245`）；在按公式 (b) 折算的 **±1.27 %FS**（无原厂来源，不构成上界）范围内，偏高量落在 **+0.4 %~+2.9 %**，故右列为区间。**不得把 2360.0 / 2950.0 当作溯源过的固定值引用。**

对"是否报警"没有影响（读数与阈值同口径），但任何"绝对电压"表述都要带这个偏差。

### 21.5 未完成项

1. **VDDA 与 3.3V 轨是否同网络未验证**（未做断电通断测量）⇒ 按 `TEST_INVENTORY` R2 属 **B 类（轨作代理）**，**R2 记"部分关闭"**；
2. **未做比例测量（可选，本轮不做）**：无 `V_PA1` 与 `VDDA` 的同量程对照，无法验证固件在中间量程上的比例正确性。
   补法：PA1 接分压中点（约 1.6 V，**两只 1 kΩ~2 kΩ 等值电阻**，源阻抗不宜大，不要 10 kΩ 以上），
   用**同一只表、同一量程**读 `V_PA1` 与 `V_轨`，令 `P = 3300 × V_PA1 / V_轨`，比较 `固件 mv − P`。
   **现行预设验收线：±12 mV**（测前先定）。推导：表**数字项不抵消**（3 字 = 3 mV）⇒
   `3300 × (3/1622 + 3/3245) ≈ 9.2 mV`；ADC 侧约 3 mV；**合成容差估算约为 12.2 mV。**

   **现行 ±12 mV 判据与上述合成容差约 12.2 mV 相差约 0.2 mV；若两者对应同一误差量及测试条件，则现行判据在数值上更严格。**
   ⇒ 该法**在这只表上分辨力约 0.75 %（12 mV 相对约 1.6 V 测点），只能发现明显增益问题，证明不了 0.1 % 级的一致**。
   `|固件 mv − P| ≤ 12 mV` 视为该点比例读数与表在容差内一致；明显更大再查增益、偏置、源阻抗。
   该测项**可选**，本轮不做，也**不因此重采、不改 `calib.py`**。⚠ 该法**不能分辨"板子 VDDA 真是 3.245 V"与"表读数偏低"**，
   要缩小范围只能第二只表交叉对读或用已知精度基准；
   （时序：现行 ±12 mV 验收线在该测项开始之前已确定；该测项至今未执行。）
3. P2 中点、中间量程线性未测；单次会话，未做重复性；
4. **表精度公式无原厂依据**：型号（福仪 FY106A）与量程（DC 4 V 档、1 mV 分辨率）已回填，但**铭牌只有型号与量程、
   未印精度公式**（2026-11-07 核对）；同日检索到 4 个转载页 / 3 种写法（±(1.2%+3)、±(1%+3)、±(1%+2)）
   并有一份单型号说明书未印精度 ⇒ **取已查到的最大值 ±(1.2 % + 3)（无原厂来源，不构成上界）**，故 ±41.9 mV 是公式 (b) 的折算估计值、不构成上界（详见 §21.3 表）；
5. 若需 ≤1 %FS 绝对精度，应改用 **VREFINT 在线校准或外部基准**（新增功能，本阶段不做）。
