zoumingjie124-ui/single-channel-acquisition/Core/Inc/dma.h

/**
  ******************************************************************************
  * @file    dma.h
  * @brief   DMA 控制器初始化（ADC1 / USART1_TX / USART1_RX 各占一个通道）。
  ******************************************************************************
  */
#ifndef __DMA_H
#define __DMA_H

#ifdef __cplusplus
extern "C" {
#endif

void MX_DMA_Init(void);

#ifdef __cplusplus
}
#endif

#endif /* __DMA_H */
