zoumingjie124-ui/single-channel-acquisition/Core/Inc/gpio.h

/**
  ******************************************************************************
  * @file    gpio.h
  ******************************************************************************
  */
#ifndef __GPIO_H
#define __GPIO_H

#ifdef __cplusplus
extern "C" {
#endif

void MX_GPIO_Init(void);

#ifdef __cplusplus
}
#endif

#endif /* __GPIO_H */
