zoumingjie124-ui/single-channel-acquisition/(commit log)

2026-10-22 单通道模拟量采集与故障监测终端：初始提交
    STM32F103C8T6 + HAL + Keil MDK。TIM3(100Hz) 触发 ADC1 + DMA 循环采样，
    8 点移动平均滤波，三级告警状态机（滞回 + 去抖），二进制帧协议（AA55 + CRC16），
    DMA + 空闲中断接收，Python/PySide6 上位机（双曲线、在线改阈值、CSV 导出）。
    - 固件编译：Code=20548 RO=976 RW=108 ZI=4948，0 Error 0 Warning
    - 协议/端到端单测：24 项通过
    - 上板实测：未进行
    [adc.c, adc.h, app_alarm.c, app_alarm.h, app_cmd.c, app_cmd.h, app_config.h, app_filter.c]
2026-10-24 fix: 帧头 SEQ 改为全局帧序号，上位机新增整帧丢失检测
    - 固件：所有出站帧（SAMPLE/EVENT/STAT/ACK）共用同一个逐帧 +1 的序号，
    ACK 不再回显命令序号，上位机可用序号连续性判断整帧丢失
    - 上位机：新增 expected_frame_seq / frame_gap_count 与"整帧丢失"显示项；
    BOOT 帧视为设备重启，重新对齐序号且不计缺口；重连时也重新对齐
    - 上位机：命令发送序号改用独立计数器 _tx_seq，不再借用 parser.frames
    （真实串口模式下该解析器不被喂数据，恒为 0）
    编译：Code=20576 RO=976 RW=108 ZI=4956，0 Error 0 Warning
    [app_cmd.c, app_task.c, app_task.h, main.py, usart.c]
2026-10-24 docs: 更正测试报告数字，补充整帧丢失的界面验证
    - README/TEST_REPORT：构建尺寸更新为实测值 20576/976/108/4956（原 20548 是
    整帧丢失检测合入前的数字）
    - TEST_REPORT：用例数由 14/5/5 更正为 14/4/6（合计仍 24），并新增第 9 节
    记录本轮改动与执行结果
    - PROTOCOL：说明 ACK 帧头 SEQ 为设备全局帧序号、不回显命令序号
    - gui_smoke：新增"整帧丢失恒为 0"断言，并注入 seq 10→13 与 BOOT 帧做反向
    验证，避免"恒为 0"其实是功能未实现
2026-10-24 chore: 添加 .gitattributes，仓库内统一 LF
2026-10-24 chore: 忽略 MDK-ARM 下的编译日志
2026-10-24 chore(test): 截图默认写临时目录，避免每次跑测试都弄脏工作区
    只有带 --shot 参数时才覆盖 docs/gui_demo.png（更新文档配图时用）。
    顺带更新配图，体现新增的"整帧丢失"一行。
2026-10-24 fix(adc): DMA 目标缓冲加 volatile
    s_dma_buf 由 DMA 在后台写入，CPU 侧看不到任何写操作，编译器有权把相邻两次
    读取合并（-O2 以上尤其危险）。原代码只声明了 uint16_t，属于"靠编译器手下留情"。
    中断里紧跟 DMA 事件读取，实际很难被优化掉，但这仍是必须显式声明的并发语义；
    顺带这也是面试常问点。改后编译仍是 0 Error 0 Warning，尺寸不变。
    [app_measure.c]
2026-10-24 docs: 新增 CubeMX 配置对照表，日志统一忽略
    - docs/CUBEMX_CONFIG.md：逐项列出 ADC/DMA/TIM/USART/GPIO 的实际配置并标注出处。
    本项目没有 .ioc（早期主动删除，避免 CubeMX 重新生成时覆盖手写初始化），
    文件开头说明了原因与"如果一定要 .ioc"的安全做法。
    - .gitignore：build.log / MDK-ARM/*.log 合并为 *.log + *.log.*
    - README：目录树补上 docs/ 三项文档
2026-10-24 docs: 增加面包板实物布局图（接线参考）
2026-10-24 fix(measure): 修复恢复标志被覆盖的竞态，计数器清零加临界区
    1) 恢复请求丢失（真缺陷）
    原顺序：start 成功 -> 清 s_recover_req。但 app_measure_start() 成功瞬间
    DMA/ADC 中断就已使能，若硬件故障仍在，ISR 会立刻把标志置 1；主循环紧接着
    清零，等于把"刚刚发生的新错误"抹掉 —— 采样实际已停，却再没人恢复。
    改为：进入函数先清标志，任何失败路径把标志挂回去。
    2) 计数器清零加 PRIMASK 临界区
    s_drop/s_err 在 ISR 里是读-改-写，主循环四行清零若被打断会丢一次自增。
    只包四条 STR，用 PRIMASK 保存/恢复避免嵌套误开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
    [app_config.h, app_measure.c]
2026-10-24 docs: 同步构建尺寸至 20584
2026-10-24 docs: 修正 TEST_REPORT 第 7 节的三处不实与缺失
    1) 勘误：原写"本轮只改文档与测试，固件业务逻辑未改动"，实则本轮确实改了
    app_task.c / app_cmd.c / usart.c（整帧丢失检测）。改为按提交逐项列出。
    2) 补四处关键修复表：现象 / 根因 / HAL 源码依据 / 修法，HAL 依据均标注到
    具体函数与行号（ADC_DMAConvCplt、ADC_DMAError、HAL_UART_Transmit_DMA）。
    3) 章节编号 9 → 7（原 7、8 缺失）。
    4) 补构建尺寸变化表：20548 → 20576(+28) → 20576(+0, volatile 不生成代码)
    → 20584(+8, PRIMASK)。数字取自 20:29 的全量重编译。
2026-10-24 docs: 勘误措辞改为不重复原句，避免被误读为未修改
2026-10-24 docs: 第 7 节区分"本轮修复"与"关键设计"，并标注证据强度
    1) 新增 7.2「本轮真正修掉的四个缺陷」：HT 回调重复上交、seq8 清零回跳、
    帧头 SEQ 无人检查、命令 SEQ 恒为 0。每条给出 HAL/代码证据与修法，
    并补上 sample_seq 独立计数器的作用（原报告未提）。
    2) 原 7.2 降为 7.3「四处关键设计」：这四条是项目成型时的设计，不是本轮修复。
    "现象"列改为"如果不这样做会怎样（推演）"，不再冒充实测现象。
    3) 全节开头加证据强度声明：本项目未上板、未联机，所有"现象"来自静态分析，
    每行标注「静态可证 / 推演」。
    4)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
2026-10-27 fix: 统计清零闭环、发送整帧原子、帧头 AA 容错、阈值关系校验
    1) 统计清零闭环
    usart.c 新增 usart_reset_counters()（PRIMASK 临界区，与 measure/tx 一致）；
    ctx_reset_stats() 补调它。修前 reset 后 STAT 里的串口错误计数会立刻
    跳回旧值——因为 emit_stat() 直接读 usart_err_count()，而不是读 stats 字段。
    2) 发送队列整帧原子
    app_tx_write() 原空间不足时按剩余空间写一半，会在环形队列里留下半截帧。
    改为放不下即整帧丢弃并计入 drop_bytes，让丢失由 SEQ 缺口干净暴露。
    3) 帧头连续 0xAA 容错
    PROTO_P_SOF1 遇 0xAA 时保持在本状态、把它当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
    [app_alarm.c, app_config.h, app_proto.c, app_task.c, app_tx.c, main.py, usart.c, usart.h]
2026-10-27 chore: v5.1.0 收尾——补测试、去死字段、常量对齐、文档同步
    1) 补测试覆盖此前为零的行为
    - test_protocol: test_double_sof0_prefix（AA / AA AA / AA AA AA 三种前缀）
    - test_firmware_sync: test_physical_constants（ADC_VREF_MV / THR_HYST_MV）
    用例数 24 → 26
    2) 上位机去硬编码
    protocol.py 新增 ADC_VREF_MV / THR_HYST_MV，main.py 的界面校验改为引用，
    并由 test_firmware_sync 与 app_config.h 比对，避免单边修改后悄悄漂移。
    3) 删除死字段
    app_stats_t 的 uart_err / rx_err 只写不读（STAT 帧直接取 usart_err_count()），
    连同 ctx_reset_stats() 里的两条赋值一起删除。app_stats_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
2026-11-02 feat: 合并 v5.1.1——阈值防回绕、清空 app_stats_t、STAT 可观测性补齐
    来自外部复审版 v5.1.1，逐项复核后采纳：
    1) app_alarm.c：阈值校验的 (uint16_t)(warn_mv + APP_THR_HYST_MV) 改为 uint32 比较。
    原写法在 warn_mv >= 65486 时溢出回绕（65500 + 50 -> 14），
    使 warn=65500 / crit=100 这类非法组合绕过校验，判级状态机会彻底失效。
    2) app_types.h：删掉整个 app_stats_t。v5.1.0 只删了 uart_err/rx_err，
    剩余字段同样只写不读；现只保留真正被读的 uint32_t samples。ZI -32。
    3) tim.c：MX_TIM2/TIM3_Init 里的局部 HAL 结构体补 = {0}，避免读未初始化字段。
    4) app_task.c：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
2026-11-02 docs: 记录首次上板实测——10 分钟连续运行零丢点
    数据（2026-11-02 10:22-10:32，COM5 @115200，电位器分压输入）：
    - 601.1 秒 / SAMPLE 60117 帧 => 实测 100.01 Hz
    - drops 0、frame_err 0、adc_err 0、uart_err 0、rx_err 0
    - 序号缺口 0、整帧丢失 0、解析错误 0、BOOT 0、链路中断 0
    - 设备结束时运行时间 1,825,000 ms（测试前已稳定运行约 20 分钟）
    改动：
    - 新增 docs/SOAK_10MIN.txt（原始逐分钟日志）
    - TEST_REPORT §4 拆成「4.1 已验证 / 4.2 仍未验证」，并新增 §8 完整记录
    （含"这组数据不能证明什么"：ADC 电压精度、8h 稳定性、抗干扰）
    - README 验证状态与 §7 表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
2026-11-02 docs: 澄清 STAT 帧频率——固件 1 Hz，此前"10 帧"是打点方式造成的误读
    复核结论：固件按 APP_STAT_PERIOD_MS=1000 发 STAT，10 分钟应约 600 帧，
    并不存在 STAT 丢失。
    原 10 分钟记录之所以只有 10 行，是临时脚本的行为：
    每收到一帧 STAT 只覆盖同一个变量，仅在整 60 s 刻度打印一次快照。
    "10 条输出"被误读成"10 帧到达"。
    为固定结论，重新做了逐帧计数复测（串口直连，不抽样）：
    - 61.1 s：SAMPLE 6106 (100.00 Hz) / STAT 61 (1.00 Hz) -> docs/SOAK_STAT_1MIN.txt
    - 94 s：SAMPLE 9394 (99.9 Hz) / STAT 94 (1.00 Hz)
    附带确认 EVENT 帧为 0 属正常：窗口内 alarm.change_c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
2026-11-02 test: 首次上板标定（零点/满量程）与 HT 修复实测
    三项实测，工具一并入库：
    1) 零点（PA1→GND）：均值 1.75 mV（≈2.2 LSB），min 0 / max 9，PASS
    同时测到静止输入下峰峰 9 mV（≈11 LSB）的噪声，已记入 §9.4。
    2) 满量程（PA1→3.3V）：均值 3299.90 mV（4094.9 LSB），min 3299 / max 3300，PASS
    跨度 = 3299.90 − 1.75 = 3298.15 mV，相对 3300 偏小 1.85 mV（−0.056%）。
    3) HT 修复：短命令 8 字符（不触发）与长命令 48 字符（必然触发 HT）各 10 条，
    均回 10 行 "ERR unknown command"；uart_err / rxf / frm 增量全为 0，PASS。
    判读依据：修前 HT 会重复上交（→20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
    [calib.py, htcheck.py]
2026-11-02 test: HT 修复补反向对照，修正计时与频率口径
    1) 反向对照（关键）
    临时注释掉 usart.c 的 HT 早退，重编（Code 20700→20692）烧录后复跑 htcheck：
    长命令 ERR 行 : 10（与修复版相同）
    长命令回显长度: 84（修复版 69，重复的两段被 64B 行缓冲截断）
    rxf 增量 : +10（修复版 0）
    实验后已还原，仓库内只有修复版（Code=20700）。
    由此发现：最初只数 "ERR 行数" 的断言**抓不到这个 bug**——
    HT 上交的前 32 字节不含 CRLF，重复的两段会拼进同一行，行数仍是 1。
    真正有判别力的是 rxf 增量与回显长度，htcheck.py 已加后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
    [calib.py, htcheck.py]
2026-11-02 docs: 满量程按修正后的计时复测，跨度为 -0.057%
    PA1 重新接回 3.3V 后复测（计时已修，实测正好 3.00 s）：
    3299.87 mV / 4094.8 LSB / 299 帧，与首次 3299.90 mV 相差 0.03 mV。
    - 9.3 改为两次测量并列，说明可复现
    - 9.4 跨度按复测值：3299.87 - 1.75 = 3298.12 mV，相对 3300 偏小 1.88 mV（-0.057%）
    - 4.1 与 README 同步为 3299.87（并注明与首次相差 0.03 mV）
    - CALIB_20261102.txt 补第 [6] 节复测原始输出
    仅文档，固件与工具代码未改（Code=20700）。
2026-11-02 docs: 修掉三处与实测矛盾的表述
    1) 第 5 节还写着"上板实测：完全未做""串口未测""联调未做"——与第 8、9 节直接冲突。
    改为已实测，并把"PySide6 界面接真实串口"单独列为未做（真机数据走的是
    host/protocol.py，GUI 只跑过 --demo），避免用一句"已联调"把两件事混为一谈。
    2) 第 7 节开头的"本项目尚未上板、也未与上位机联机"是 10-24/27 写下的，
    现在读起来像在否认第 8、9 节。改为"时效声明"：说明该节是上板之前的静态分析，
    上板后的实测见 8、9 节，且只有 7.2 第 1 条（HT）被 §9.5 升级为实测，其余仍未测。
    3) "36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
2026-11-02 feat: 真机界面截图、竖版接线图、修 GUI 串口读取延迟
    1) 修 host/link.py 的读取方式（真缺陷，实测暴露）
    SerialWorker 原来用 read(4096)：pyserial 会累积到凑满 4096 字节才返回，
    数据不断流时永不超时。链路 1.7 KB/s → 2.3 s 才满，界面因此"卡两秒、涌一批"。
    实测 6 s 只统计到 468 点（78 Hz）。改为按 in_waiting 读取后，
    16 s 收到 1597 点（99.8 Hz），首帧延迟 < 10 ms。
    2) 新增 host/tools/gui_snapshot.py
    用真串口跑 PySide6 主窗口并截图，作为"界面接真实串口"的证据。
    截图必须在事件循环内抓：app.quit() 之后窗口走 closeEvent -> _disconn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
2026-11-02 docs: 接线参考改用实拍照片，移除手绘示意图
    用户要求以实际搭建的照片为准，不再使用绘制的接线图。
    - 新增 docs/wiring_photo.jpg（本机实拍 1000×1263，裁掉下方无元件的空白）
    - 删除 docs/wiring_breadboard.png（此前只存在于仓库，README 并未引用）
    - README §4 换成照片，并明确"照片只说明长什么样，电气连接以下表为准"
    - 顺手修掉 §4 一句错引用：原文写"与 DataTerm 相同，详见 PROTOCOL.md 第 1 节"，
    但 PROTOCOL 第 1 节讲的是帧格式，跟接线无关
    仅文档，固件与上位机代码未改。
2026-11-02 fix(ui): 坐标轴不再自动加 SI 前缀；串口说明改为现象记录
    1) 坐标轴
    pyqtgraph 默认给刻度加 SI 前缀，时间轴被写成 1.6 ks、电压轴 3 kmV。
    固定单位（秒/毫伏）下这层换算没有意义，还会误导读数。
    对 bottom/left 两条轴调用 enableAutoSIPrefix(False)，现在显示 1600 s / 3000 mV。
    两张截图已重新生成（gui_demo.png 393 点、gui_real_serial.png 1596 点）。
    2) 措辞
    原注释/报告写"pyserial 的 read(n) 永远不会因超时返回"，这是把观测现象说成了
    通用结论。改为："在本机（Windows + CH340 + pyserial 3.5）实测观察到……具体
    与驱动/版本的关系尚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
    [calib.py, link.py, main.py, soak.py]
2026-11-02 fix(host): 演示源补 50 mV 滞回；冒烟截图移入事件循环
    两处都是用户逐像素看截图时发现的，成立。
    1) 截图时机（gui_smoke.py）
    grab() 原来在 app.exec() 之后，退出时窗口走 closeEvent -> _disconnect()，
    顶部标签从琥珀色「演示模式（无硬件）」变成红色「未连接」，且"运行时间"停在
    最后一条 STAT（3.0 s）而"采样数"已到 4 秒。改为在 QTimer 回调里先取数、先截图、
    再 quit；并加断言：顶部状态必须包含「演示模式」。
    2) 演示源判级（main.py DemoSource._tick）
    原来是无回差简单比较，事件表出现 "WARN -> NORMAL | 2394 mV"，与固件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
    [main.py]
2026-11-02 test: add ADC recovery validation
    阶段一：验证 ADC 故障恢复链路（DMA 错误 -> 标志 -> 主循环 DeInit/Init/校准 -> 重启 DMA）。
    方法边界：用编译开关隔离的文本命令 `adcinject` 注入"错误标志"，走
    `app_measure_on_error()`，**不是真实 DMA 电气故障**。它证明的是"恢复流程能跑通、
    代价多大"，不能声称验证了真实硬件故障。
    实测（COM5 / 115200 / PA1=1531 mV）：
    - 恢复耗时（命令回显 -> 恢复完成）2.4 / 2.5 / 2.5 / 7.2 / 4.2 ms，平均 3.8 ms
    -> 小于一个采样周期 10 ms，因此不丢样
    - 10 次恢复：20326 ms 内样本计数 +2032（理论 2032.6），drops 0，adc_err +10
    - 限速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
2026-11-02 docs: 阶段一报告按实际输入电压（1531mV）修正重复样本口径
    提交 43d381f 里的文档替换因引号转义失败没生效，本提交补齐：
    PA1 已接电位器（1531 mV），「帧数精确」这条证据成立；但静态直流下
    旧值与噪声不可分辨，改为如实标注「需动态信号才能判」。
2026-11-02 docs: add stage 1 raw evidence log and rewrite recovery report
    本轮**无代码改动**（App/Core 的 `git diff` 为 0 行，APP_DEBUG_INJECT 仍为 0u），
    只补证据与报告。
    新增 docs/STAGE1_RAW.txt：由 host/tools/stage1_evidence.py 一次写出，
    报告里每个数字都能在日志中找到对应行。内容含：
    - 环境（Windows 11 / Python 3.13.14 / pyserial 3.5 / COM5 115200 8N1 /
    APP_FW_VERSION=0x0500 / 注入版 Code=20808）
    - [1] 基线计数器
    - [2] 单次注入 x5：逐条注入时刻 + 回执延迟 + 恢复耗时
    - [3] 1 秒内连注 5 次：注入/恢复时间戳与间隔
    - [4] 10 次注入：逐条时刻 + 前后 STAT 快照 + 丢样核算
    - [5] 恢复后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
2026-11-03 test: add ADC linearity and filter-delay measurements
    阶段二：ADC 精度与线性验证。本轮**无代码改动**（App/Core 的 diff 为 0 行）。
    代码核算（只读）：
    - mv = raw * 3300 / 4095，先乘后除，最大中间量 13.5M，uint32 不溢出
    - 截断方向向下，系统偏低 <=0.8 mV；输出为整数 mV，有效分辨率 1 mV
    （约 1.24 LSB），滤波无法突破量化地板
    - VREF+ 与 VDDA 同源（LQFP48 无独立参考脚），属比例测量：
    满码读数只能证明换算正确，不能证明板载 3.3V 是 3.300V
    - 采样时间 55.5 周期，10k 电位器分压中点源阻抗足够
    - APP_RATE_LIMIT_MV = 0，限幅当前关闭（README 写"可选限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
    [LIN_SWEEP.csv]
2026-11-03 test: add full-range ADC sweep (0-3300 mV, 16/16 bins)
    补测第二轮扫掠，从 0 V 起扫满全量程，消除上一轮低端 4 段空白。
    实测（COM6 / 正式版 Code=20700 / 2026-11-03 08:53）：
    - 3504 帧 / 3300 mV 全量程 / 移动段 2901 点 / 29.0 s
    - **电平覆盖 16/16 段**（上一轮 12/16，缺 0-825 mV）
    - 反向跳变 252 次，幅度集中在 -5~-10 mV（175 次），最大反向 -12 mV，
    最大正向单点 +38 mV：判定为电位器碳膜接触噪声（静置时不出现）
    - 去趋势残差 sigma 1.82 mV（MAD），与静置 2.40 mV 同量级
    - **3503 个相邻 t_ms 间隔全部等于 10 ms，0 例外**
    这条帧间隔检查比采样率更有说服力：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
    [LIN_SWEEP_FULL.csv]
2026-11-03 test: add UART/DMA fault injection suite
    阶段三：UART + DMA + IDLE 异常验证。本轮**无代码改动**。
    全部用例在 PC 侧注入，不改线、不改固件；唯独 ORE 未能直接制造。
    实测（COM6 / 正式版 Code=20700 / 2026-11-03 08:58）：
    - CRC 错误 x20 -> frame_err +20，uart_err +0，链路存活
    - 长度非法 41/255/200 -> frame_err +3
    - 半截帧 -> 确定性吃掉后续 2 帧（4/6，前 2 丢），期间文本响应也被吞
    可推算：7 B 补齐载荷 + 2 B CRC 序列
    - 未知 TYPE=0x99 -> ACK result=2，cmd_err +1
    - 非法文本 / 200 字符 -> 1 行 ERR / 回显 84=21+63，不越界
    - 跨 64 B DMA 缓冲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
2026-11-03 feat(usart): 错误分类计数 + 真实 ORE 注入（调试构建）
    阶段三收尾：把"ORE 不可测"这个盲区补掉。本轮**有代码改动**，但二进制协议不变。
    1) 错误分类计数
    原来 s_err_cnt 是一个笼统总数，看不出"到底哪种错误"。按 huart->ErrorCode 的位
    拆成 ore/fe/ne/pe 四个计数器（HAL 每次进中断累加、出中断清零，不会重复计）。
    文本 stat 追加一行（二进制 STAT 帧载荷不动，上位机零影响）：
    ERRSRC ore=0 fe=144 ne=0 pe=0
    usart_reset_counters() 一并清零，仍用 PRIMASK 临界区。
    2) usart_ore_inject()（#if APP_DEBUG_INJECT 包住，Release 不含）
    为什么不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
    [app_task.c, usart.c, usart.h]
2026-11-03 docs: 标注阶段三回归跑与 T8 数值波动
    09:08 用含分类计数的新固件重跑了 9 个用例，T1/T2/T3/T5/T6/T7/T9 与首轮一致。
    T8 的 STAT 帧数与丢弃字节随队列时序波动（首轮 14/11333，回归 15/13951），
    判据是「解析错误 0」，两次都成立。原始日志顶部已注明这是回归记录。
2026-11-03 docs: 标注阶段三回归跑与 T8 数值波动
    09:08 用含分类计数的新固件重跑 9 个用例：T1/T2/T3/T5/T6/T7/T9 与首轮一致。
    判据「解析错误 0」两次都成立。原始日志顶部已注明这是回归记录。
    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
2026-11-03 fix(comm): A/B 加固——parser 空闲超时复位 + RX 重挂守护
    阶段三收尾的两项可靠性加固，均不改协议、波特率、采样频率。
    A) parser 空闲超时复位（APP_RX_FRAME_TIMEOUT_MS = 50）
    半截帧停在 BODY 状态时没有时间概念，会确定性吃掉后续 2 帧，期间文本响应也被吞。
    - 超时判定放在**喂字节之前**：否则新帧先污染旧状态、时间戳又被刷新，超时永远不触发
    - 只复位 parser，不动 s_rx_ring / head / tail；已完成帧在 CRC_HI 已先置 idle 再回调，
    不会被误清；app_cmd_reset_counters 故意不清 s_last_byte_ms（否则半帧中间清零会立刻误触发）
    -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
    [app_cmd.c, app_cmd.h, app_config.h, app_task.c, uart_guard.py, usart.c, usart.h]
2026-11-03 test: add native C unit tests for proto/alarm/filter
    阶段四：用 GCC 直接编译**仓库里的真实固件源码**做单元测试，
    不是复制一份、也不是用 Python 重写逻辑来"测"。
    工具链：gcc (tdm64-1) 4.9.2
    参数 ：-std=c99 -Wall -Wextra -Werror -O2 -I../App/Inc -I.
    结果 ：断言 167 项，失败 0 项 → PASS，编译零告警
    被测文件（原样链接）：
    App/Src/app_proto.c App/Src/app_alarm.c App/Src/app_filter.c
    覆盖：
    - proto：CRC-16/CCITT-FALSE 标准向量 0x29B1、组帧 17/40/41 边界、8 个解析状态、
    CRC 错不回调、LEN 越界、AA AA 55 重同步、连续 5 帧、半截帧现状（标注为记录而非期望）
    - alar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
2026-11-03 docs: 文档一致性核对、分层边界复核、证据分级与长跑记录表
    - README: 更新验证状态（Stage 1-4）、目录结构、§7 状态表、已知限制
    - TEST_REPORT: 尺寸校正为 Code=21208/RW 148（-r 全量重建实测）；
    §4.2 移出已完成项；§5 补 Stage 1-4；§6 复现路径；§7.4 补尺寸史；新增 §16
    - PROTOCOL: 修正 ORE 行为描述（实测 DMA 顺带清标志、中断未执行）；
    补半截帧 50ms 超时、RX 重挂守护 200ms、ERRSRC 行、调试命令
    - 新增 AUDIT_20261103.md：20 条文档 vs 代码核对 + App/HAL 边界判定
    - 新增 TEST_INVENTORY.md：A/B/C 三级证据清单 + 风险 R1-R14（保留 R1/R2）
    - 新增 SO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
2026-11-03 tools: 长跑收尾脚本（判定 + 落盘 + 关机）
    - host/tools/soak_finish.py：等日志出现「合计」段并写稳后，
    按 SOAK_PLAN 的 H1-H12 门槛判定，生成 docs/SOAK_*_RECORD.md，再 shutdown /s /t 300
    - 安全顺序：先写报告后关机；报告写不进去就不关机；日志不完整只记「无法判定」不记 PASS
    - 自测：用 SOAK_10MIN.txt（旧格式/GBK）与手工分段写入的模拟日志各跑一遍，
    修掉 GBK 解码、频率字段写法、H10 键名错位三处问题
    - docs/CALIB_ABSOLUTE.md：绝对电压精度测试步骤与空记录表（待万用表）
    [soak_finish.py]
2026-11-03 test(stage6): 1 小时连续运行 PASS（12/12）
    - 3600.0 s / 360047 SAMPLE 帧 = 100.010 Hz；STAT 3601 = 1.000 Hz
    - drops/frame_err/adc_err/uart_err/rx_err/缺口/整帧丢失/BOOT/重连/解析错 全 0
    - 每分钟 6001 帧无偏离；时基偏差 +0.010%
    - 新增 docs/SOAK_60MIN_RECORD.md（脚本自动生成，非手填）
    - TEST_REPORT §17 记录结论与'睡眠会污染数据'的原因；README/TEST_INVENTORY R3 同步
    - 开跑前已 reset 清零；PC 侧关闭睡眠/休眠/USB 选择性暂停（需还原）
2026-11-03 docs: SOAK_PLAN 增补电源设置（测试前修改/测完还原/核对）
    - 还原命令此前只存在于对话里，不可持久，现写入 docs/SOAK_PLAN.md §9
    - 记下原始值：睡眠 AC 15min / DC 10min、休眠 3h、USB 选择性暂停启用
    - 顺带记录 MSYS_NO_PATHCONV=1 的坑（powercfg/shutdown 的 / 参数会被改写）
2026-11-03 docs: 纠正 1 小时长跑的打点表述
    - 原写「60 个打点无一次偏离/每分钟都是 6001」，与记录不符：
    实际 58 个打点，每点 6000-6001 帧，±1 来自打点错位而非主循环抖动
    - 判定口径仍以 360047 帧 / 3600.0 s = 100.010 Hz 的总账为准
2026-11-03 docs(stage7): 多类型故障诊断设计审查（未改固件）
    - 数据流/模块调用关系 + 关键实测依据（噪声/延迟/量化/接触噪声）
    - 三类故障算法：输入异常（含'断线当前硬件测不了'的结论）、
    信号卡死（分块极值，O(1)/样本，极值必须重置）、变化率异常（用 raw 不用 filt）
    - 触发/确认/恢复总表；故障码 0x11-0x51；协议新增 0x86/0x15，默认关闭
    - 上位机需同步改的三处；文件清单与风险；7A-7D 分阶段计划
    - 验证能力矩阵：电位器+跳线能验什么、必须额外硬件才能验什么
    - 固件零改动（git diff HEAD -- App Core 为空）
2026-11-03 feat(diag): Stage 7B 信号卡死诊断模块 + 121 条单元测试
    - 新增 App/Src/app_diag.c、App/Inc/app_diag.h：1 秒分块极值统计，O(1)/样本
    连续 3 个偏死块(span<50mV)确认，连续 2 个干净块恢复；默认关闭
    - app_task.c 仅新增 5 行接入；app_filter/app_alarm/app_measure/Core/host 一行未改
    - app_config.h 新增 6 个参数 + 6 条编译期约束；uvprojx 加一个文件条目
    - fw_tests/test_diag.c：121 条断言，与原有 167 条合计 288 项全 PASS
    - 固件 Code 21208 -> 21492 (+284)，ZI 4916 -> 4956 (+40)，0 Error 0 Warning
    - 上位机 28 项单测仍 OK（协议未改）
    - 修掉模块自身 3 个缺陷：blk_samples 先清后判、结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
    [app_config.h, app_diag.c, app_diag.h, app_task.c, main.c, test_diag.c]
2026-11-03 feat(diag): Stage 7C 故障诊断协议上报 + 上位机集成 + 板级验证
    固件
    - 新增 app_fault.c/h：跃变判定（确认/恢复各发一帧）+ 9 字节载荷 + 位掩码
    - app_proto.h：0x86 FAULT(9B) / 0x15 SET_DIAG(1B) 与字段常量
    - app_cmd.c：SET_DIAG 先挡 LEN 再挡取值，非法值不进回调；ACK 由既有 send_ack 统一发
    - app_task.c：ctx_set_diag / fault_emit / process_sample 一行接入 / 文本 diag on|off / stat 增 DIAG 行
    - 未改 app_diag.c、app_filter、app_alarm、app_measure、ADC/DMA/定时器；SAMPLE/STAT 长度不变；默认仍关闭
    上位机
    - protocol.py：Fault 解析 + build_set_diag + decode_many 分支
    - main.py：故障面板（使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
2026-11-03 docs(7c): 补记录提交号 b198ef8
2026-11-03 test(protocol): 文档-固件-上位机三方一致性 + 协议约束审计
    - 新增 host/tests/test_protocol_doc_sync.py（14 项）：从 PROTOCOL.md 正则解析
    帧长、字段偏移/宽度、示例帧 hex，与 app_proto.h 常量、test_fault.c 契约向量、
    protocol.py 构造结果三方对拍；顺带锁死老帧类型码与长度未被改动
    - 板级补 SEQ 证据：复位后抓 9 秒 913 帧（SAMPLE 900/STAT 10/ACK 2/FAULT 1），
    912 个间隔 0 异常，跨越 255->0 回绕仍连续 —— 证明六类帧共用同一全局序号
    - 新增 docs/STAGE7C_PROTOCOL_AUDIT.md：8 条约束逐条核对，并记录两处缺口
    （丢帧后不重发 / 无查询命令）与三个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
2026-11-03 docs(7c): GET_DIAG 与丢帧恢复设计（待确认，未实施）
    - 0x16 GET_DIAG 请求 LEN=0，应答 ACK + 一帧 event=0 的 0x86 快照
    - 快照 vs 实时事件的分工与三条硬规则（不补发、不伪事件、active=0 可表达）
    - 发送层拆成 active/reported 双状态，三道闸门避免每样本重发
    - 快速确认-恢复-再确认的四种时序推演，明确状态必对、边沿可能合并的取舍
    - 快照必须在入队时刻取状态，否则会被更新的事件覆盖（第 7 条要求）
    - 文件清单、测试计划、资源预估，末尾列 4 个待确认决策点
    - 代码零改动
2026-11-03 feat(diag): Stage 7C-2 GET_DIAG 状态快照 + TX 提交失败恢复
    协议
    - 新增 0x16 GET_DIAG（LEN=0），应答固定「先 ACK、后快照」
    - 0x86 复用，event=0 = 状态快照；无故障 fault_id=0/active=0/value=0
    - PROTOCOL.md 增 §4.10 与两组快照契约向量，与 C/Python 三方对拍
    - app_fault 从「统计事件」改为「状态差驱动」：
    active（设备真实状态）与 reported（已提交到 TX 队列）分离，提交成功才拉平
    - 三道闸门：已对齐不发 / 队列无空间不发（在取 SEQ 之前判，不烧序号）/ 100ms 节流
    - emit 回调返回值改 uint8_t，不再忽略 app_tx_write 结果
    - 快照只读、在入队时刻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
2026-11-03 docs(7c2): 补记录提交号 035ef1a
2026-11-03 docs(7c2): 收尾——证据分级、协议上报语义补全、最终验收报告
    - PROTOCOL.md 新增 §4.8.1：reported = 已提交到 TX 队列（≠对端收到）、
    队列满不烧 SEQ 不更新 reported、100ms 节流、允许合并中间边沿且恢复后
    只提交最新 active、快照不用于恢复历史事件
    - TEST_INVENTORY.md 新增 R15-R21（TX 环满载 / 节流 / 多故障快照 / 入队并发 /
    真实传感器 / 诊断长跑 / GUI 真板）+ 状态标注规则 UNIT PASS≠板级 PASS
    - TEST_REPORT.md 新增 §19：七项未验证事项证据等级 + 本轮回归实测数字
    - 新增 STAGE7C2_FINAL.md：四层证据分级 + 板级 8 项实做清单 + 已知风险 +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
2026-11-03 docs(7c2): 验收报告补记录提交号 44f86a2
2026-11-03 docs: README 同步 Stage 7 进展 + 下一阶段硬件验证清单
    README
    - 尺寸 21208/996/148/4916 -> 22468/1076/148/4972（Flash 35.9% / RAM 25.0%）
    - 测试量 Python 28 -> 72 项、固件 C 167 -> 1041 断言；模块清单补 app_diag/app_fault/app_cmd
    - 状态块与 §7 表补 Stage 7 / 7B / 7C / 7C-2（板级实测数字逐条列出）
    - §7 新增 9 行未验证项，按 UNIT PASS / CODE REVIEW PASS / NOT TESTED 标注（R15-R21）
    - §8 上板轮次 六轮 -> 九轮；补'故障边沿可能被合并''诊断默认关闭'两条限制
    - §2 目录树补 7 系列文档与 HW_VERIFY_NEXT；§5 补故障诊断面板说明
    新增 docs/HW_VERIFY_NEXT.md（只记录，不实现）
    - H1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
2026-11-03 docs: 修 README 中 STAGE7C 报告链接的排版错误（`§` 误留）
2026-11-03 docs: 说明串口号不固定（COM5/COM6 混用不是记录矛盾）
    核对结论：两台端口记录属于不同时间的不同测试，且这块 CH340 的 hwid 里 SER= 为空，
    Windows 按物理口+枚举顺序分配 COM 号，同一块板会换号、烧录后重枚举也会换。
    - README 新增 §5.1：根因 + 端口↔时间对照表（11-02 上午 COM5 / 11-02 23:46 Stage1 COM5 /
    11-03 08:48 起 Stage2-3+1h长跑+7C COM6 / 11-03 23:1x 7C-2 烧录后重枚举回 COM5）
    + 复跑前先列端口的命令
    - 状态块与 §7 表两处 COM5 补上日期（2026-11-02）并指向 §5.1，避免读成 7C-2 的记录
    - TEST_INVENTORY §6 复跑入口加警示：命令里的 COM5/COM6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
2026-11-03 docs(stage8): 可靠性与硬件验证收尾——总体审查与 A/B/C/D 测试方案
    只新增 docs/STAGE8_PLAN.md，未改任何源码/头文件/Python/协议/配置/README。
    审查结论（代码级，非实测）：
    - 普通帧（SAMPLE/STAT/ACK…）环满时会烧 SEQ 并丢帧，这是上位机整帧丢失检测的设计内行为；
    FAULT 走 app_fault_service 闸门②，在取号前判空间，正常不烧号
    - 闸门②与真正写入之间无并发生产者（app_cmd_poll 在本块之前执行、ISR 不入队）
    - **新发现**：s_busy 无超时兜底。TX 完成中断丢一次即永久停摆，且无计数器可反映
    → 建议登记 R22（本轮按约束未改 TEST_INVE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
2026-11-04 docs(stage8): 采纳修订版方案（范围收敛）+ 统一 R15 口径
    STAGE8_PLAN.md（用户修订版，534 行）
    - 范围收敛为：必做 R2 / 8D / 8B(R3+R20)，可选 8A，其余不做
    - 8A 明确不修改 APP_TX_RING_SIZE，灌命令改用一次性 python -c（不新增脚本）
    - 新增 3.6.1：区分窗口内/窗口外的 SEQ 跳号归因，标注为设计推演、以实测核对
    - 3.1 结论 3 去掉 R22 编号，改为 CODE REVIEW FINDING / NOT TESTED
    - 8B 重写为「SET_DIAG 1 → soak.py 原样跑 → 结束后一次 stat」，新增 4.8 证据边界
    - 原 8C 整体取消，R19 保持 NOT TESTED，STUCK 适用边界迁至 7.5
    - 7.2 R2 补记录表与判读公式（区分'换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
2026-11-04 docs(stage8): 修正 8D 顺序、R2 测法区分、A-7 强度、8A 单会话、R18 定性
    1) 8D D-6~D-8 顺序修正（实质错误）
    原顺序在'恢复之后'才关闭诊断，那时 active 已是 0，查询只能得到 mask=0x00，
    既不能证明'保留'也测不出东西。改为：confirm -> 关闭诊断 -> 查询(active=0x01)
    -> 重新使能(不应重复上报) -> 恢复 -> 断线重连。
    判据改用 P-1..P-8 与步骤号解耦，避免'关闭诊断'被误读成某一步。
    2) 新增 §7.2.1：VDDA 直接测量 vs 3.3V 轨代理
    直接测（VDDA 引脚/同网络测试点）可作为 R2 关闭依据；轨代理不可单独关闭，
    只能给误差上界，且必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
2026-11-04 docs(stage8): 三处纯文档对齐（R18 定性 / R2 测法 / R20 记录项）
    STAGE8_PLAN.md
    - L22 §1.1：8A 的补风险列删去'（顺带 R18 复核）'，只留 R15 / R16
    - L85 §2.3：R18 处理改为'保持 CODE REVIEW PASS；8A 不构成 R18 的验证证据（§7.4）'，
    与 §7.4 及 §10.1 决策一致
    TEST_INVENTORY.md
    - L177 R2：区分'直接测 VDDA'与'3.3V 轨代理'；代理仅在确认同网络（0Ω/跳线直连、
    无滤波，依据写进结论）时才能当 VDDA 用；未确认同网络不得宣称 R2 已关闭或
    绝对精度已验证，只能按'上界'记录；指向 STAGE8_PLAN §7.2.1
    - L195 R20：关闭条件改为 STAGE8_PLAN §4 口径——起点与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
2026-11-04 docs(stage8): §11 自证补第三轮修订记录
    - L589 新增一条：同日修订（2026-11-04，第三轮）——同步修正 R18 复核表述、
    R2 的 VDDA/3.3V 轨测量判定条件、R20 的 8B 长时间运行证据要求；
    仅更新文档，不涉及代码、配置、测试执行或测试结果。
    - 1 文件 1 行（+1/−0）；未运行任何测试；未改代码/配置/数据。
2026-11-04 docs(stage8): 修正两处旧编号引用（原 §5.5 -> 原 Stage 8C §5.5，旧编号）
    - L348：改为'原 Stage 8C 的 §5.5（旧编号）中 STUCK 诊断的适用边界已迁移到 §7.5，保留此处说明'
    - L504：改为'STUCK 诊断的适用边界（原 Stage 8C §5.5，旧编号，现迁移至此）'
    当前 §5 是'原 Stage 8C 已取消'，其下无 5.5，原写法会让读者按 §5.5 跳转落空。
    - 1 文件 2 行（+2/-2）；未改技术结论、未调章节结构；未运行测试/编译/上板。
    - 全文扫描另发现 L267 的裸'（§9.2）'指 SOAK_PLAN，本文档 §9 无子节；
    因超出本次指定修改范围，未改动，已在汇报中单列。
2026-11-04 docs(stage8): 第三处引用修正——L267 的裸 §9.2 补上文件名前缀
    - L267：'（§9.2）' -> '（`SOAK_PLAN.md` §9.2）'，与同行的 `SOAK_PLAN.md` §9.1 指向一致。
    本文档 §9 是'执行顺序与依赖'，无 9.2，裸写会被误认为本地章节。
    - 1 文件 1 行（+1/-1）；未改技术结论/测试步骤/其他章节；未运行测试、未编译、未上板。
    - 复扫结果：52 条引用全部命中；另发现 2 处同类歧义（STAGE8 L561、TEST_INVENTORY L190），
    超出本次指定范围未改，已单列汇报。
2026-11-04 docs(stage8): 补两处归属限定（本文件 §3.1 / 本文件 §5.2）
    同 L267 一类：引用目标本身存在，但同一行先出现外部文件名，读者可能误把
    后续裸 § 归到外部文件。
    - STAGE8_PLAN L561：'（§3.1 结论 3）' -> '（本文件 §3.1 结论 3）'
    本意是 STAGE8 §3.1；同行前面出现 TEST_INVENTORY.md，而后者没有 §3.1。
    - TEST_INVENTORY L190：'（另见 §5.2 的 TX 代码审查备注）' -> '（另见本文件 §5.2 的 TX 代码审查备注）'
    本意是 TEST_INVENTORY §5.2；同行前面出现 docs/STAGE8_PLAN.md，而后者没有 §5.2。
    - 2 文件 2 行（+2/-2）；未改引用目标与技术结论；未运行测试/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
2026-11-04 test(stage8b): 诊断使能态 1 小时长跑——未通过（H7/H8/H12 FAIL）
    原始数据（3600.0 s / COM5 / Code=22468 / diag on）：
    - SAMPLE 360002 = 100.0006 Hz；STAT 3600 = 1.0000 Hz
    - drops/adc_err/uart_err/rx_err/frame_err/EVENT/changes/BOOT/重连 全 0
    - **seq8 缺口 45 / 整帧丢失 45 / 解析错误 30** -> H7/H8/H12 FAIL
    - 设备侧 txd=0B：发送环从未满，固件一个字节都没丢
    - H11（uptime 正式口径）= 0.0077%（Δuptime 3616138 vs Δwall 3615859 ms）PASS
    - B-1..B-5（终点 en/conf/mask/rep/state/span）全 PASS，conf 增量 0
    归因（未定论）：缺口与解析错误成对出现，均为整帧粒度，设备侧全零，
    故丢失发生在'发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
2026-11-04 docs(stage8b): 修正归因——初版'主机并发负载'不成立，改为时间分布+三候选并列
    复盘每个 60 s 打点窗口的增量后发现：
    - 0-240 s（11:24:12-11:28:12）完全干净
    - 240-2460 s（11:28:12-12:05:12）近乎每分钟 1-3 帧，累计 45 帧 / 30 次解析错
    - 2460-3600 s（12:05:12-12:24:12）重新完全干净（19 分钟 0 缺口）
    初版把原因写成'测试期间本机并发执行文件读取'，与时间线冲突：
    静态审查发生在 12:10 之后，而丢失在 12:05 已结束。该结论作废并记录在案。
    系统侧排查均无支持证据：System 日志（11:20-12:30）无 USB/串口/PnP 告警；
    Defender 上次快扫为 11-03 19:25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
2026-11-05 docs(stage8b): 8B-2 完成，含 NTP 台阶记录
    - 8B-2（诊断关 en=0）480 min：2880109 SAMPLE / 100.0038 Hz（按真实物理时长 28797.05 s 折算 100.0140 Hz）/ H1–H12 全 PASS / 479 打点 / BOOT 0 / 链路中断 0
    - 新增 SOAK_480MIN_20261104_N.txt（77875 B，SHA-256 6e64b281…）与 SOAK_480MIN_RECORD.md；STAGE8B_REPORT 增 §8（§8.3.1 事件日志、§8.3.2 soak.py 计时基准）
    - TEST_INVENTORY：R3 增第 ⑥ 条（8h en=0），R20 增 en=0 旁证（不构成 R20 判定，en=1 的 8h 仍未做）
    - 归档 11-03 日志改名 SOAK_60MIN.txt -> SOAK_60MIN_20261103.txt（R100）；补 X2/Y/Y2 日志与端点证据、STAGE8B2 起点记录
    - 记录一次主机侧 NT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
2026-11-05 docs(stage8b): 同步升级版文档与三处注释修正
    - README 增 Stage 8B 条目与 docs 目录树；TEST_REPORT 增 §20（六轮长跑总表 + 8B-2 结果）
    - §20.2 按原始日志重写：台阶在 [7260s]（ΔSAMPLE 5705 / ΔSTAT 57），NTP 事件 2026-11-05 01:28:27 +2950 ms，字节 50,229,097；不采用外部稿的 [4500s] / 6296 帧 / 50,245,937 B
    - TEST_INVENTORY：标题改 Stage 1–8B、A 类计数改 72 项 / 1041 断言、R3 说明同步 8B-2
    - AUDIT 第 17–19 条标注已同步修正注释；app_config.h / usart.h / app_task.c 仅改注释
    - 重新编译验证：Code=22468 RO=1076 RW=148 ZI=4972，与改动前完全一致（0 B 机器码变化）
    [app_config.h, app_task.c, usart.h]
2026-11-05 docs(stage8d): 8D/R21 通过（控件自动化+人手拧电位器+真机），8B-3 中止留档，docs 脱敏
    - 8D：D-1~D-12 全部执行；P-1~P-5/P-7 满足、P-6 仅 D-9 部分满足（重连快照 active=0 分支未造出）、P-8 在 6 s 窗口满足；D-12 判别力偏弱 OPEN。证据 docs/stage8d/（9 张截图 + GUI 文本通道日志）
    - R21：NOT TESTED -> 通过；README 首屏/§7/§8/目录树同步，仍未测清单移除 GUI 项
    - 8B-3：2026-11-05 16:16:49 启动、16:21 主动中止，无有效结果（不记 PASS/FAIL、不计入 R3/R20）；残留 SOAK_480MIN_20261105_ABORTED_1617.txt（689 B，6029388e…）与 STAGE8B3_START.txt；R20 补记'今晚重跑'
    - 脱敏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
2026-11-05 docs(stage8d): 归档 run_8d.py（脱敏）并纠正截图证据——仅 5 张可用
    - 新增 docs/stage8d/run_8d.py：仅把路径解析块改为 STAGE8D_PROJ/STAGE8D_OUT + 相对本文件，逻辑/时间轴/延时逐行未改（原件 153 行 4,976 B SHA 500c6825…，归档版 164 行 5,678 B）
    - 截图纠正：ImageGrab 用逻辑坐标当物理像素，125% DPI 下抓偏；D-9/D-4/D-10/D-12 四张抓到前台其它窗口（含本机路径）-> 从仓库移除，原件留仓库外；D-1/D-3/D-6/D-7/D-8 裁剪到窗口内（去除左侧/上方其它软件）后归档
    - 文档同步：STAGE8D_EVIDENCE §1/§3/§4/§5/§6/§6.3/§7 改写为'5 张可用截图'，并规定对外不得写'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
2026-11-05 docs(stage8b3): 夜间重跑基线与判据——设备侧计数改用差值口径
    - 代码核对：soak.py 合计段（L170-177）直接取最后一帧 STAT 的绝对值，未做基线相减 -> 终点判据改为 终点−T0，并在报告写明
    - T0 需完整记录 STAT/ERRSRC/DIAG 三行 + 墙钟 + 端口/LOCATION + 构建依据
    - 登记当前非零基线来源：cmd=3/0（8D 三次成功命令）、DIAG en=1/conf=1/mask=1/rep=1（7C 使能，非本轮产生）
    - 起跑条件 7 项清单 + 收尾顺序（先取证后解释、跑完恢复自动校时并核对 Time-Service/Kernel-General）
2026-11-05 docs(testinventory): 第 3 行范围与标题对齐（Stage 1–8B）
    原文把范围写成 'Stage 1–4 的结论散在四份报告里'，与标题 'Stage 1–8B' 不一致；改为 '1–4 各阶段报告、7B/7C/7C-2、8B/8D 各自成套'
2026-11-05 docs(stage8b3): 正式起跑 23:10:56（en=1），记录上电噪声基线与 reset 重跑
    - 23:07 用户插拔 USB -> 板子重新上电：uptime 归零、诊断复位为 en=0；23:08:38 diag on 恢复 en=1
    - 上电瞬间 uart=2/fe=2/cmd err=16 非零（与 11-04 同型），来源记为上电噪声；第一次 23:08:57 起跑 1m28s 后作废（残留 ABORTED_2310，215 B 3b691098…）
    - 23:10:36 reset -> 计数全 0、en 保持 1、conf 归 0；T0 = 23:10:46.618, t=200795ms, n=1000, 全 0；23:10:56 正式起跑（480 min，约 07:10:56 结束）
    - 判据仍按 终点−T0 差值；本轮 T0 全 0，故差值与绝对值相同，报告仍注明口径
2026-11-05 docs(stage8b3): 补记 reset 实际做法与起跑前重启原因
    - R20 与 STAGE8B3_START 原文写'不 reset、按现状取 T0'，与实际不符 -> 改为：23:10:36 reset、23:10:46 T0、23:10:56 起跑；注明 conf 本轮 0->1，与 X2 的 1->1 口径不同
    - 起跑前重启（T0 之前）查证：CH340 设备 LastArrivalDate=23:07:34；两次 uptime 反推 boot 均为 23:07:25.8；判定为 USB 物理插拔上电；排除'开串口复位'（16:16-16:21 uptime 连续）与'reset 复位'（Δuptime 151.991 vs Δwall 151.969）；拔出时刻未查明
    - §8.5 收尾顺序补：打点间隔异常必须先排除 NTP/墙钟，再讨论丢帧；报告须写明自动校时已恢复
2026-11-06 docs(stage8b3): 诊断开启 8h 结果入库（H1–H12 全 PASS），并更正计数标注与 conf/blk 口径
    - 新增 SOAK_480MIN_RECORD_8B3.md；STAGE8B_REPORT 新增 §9；原始日志归档 SOAK_480MIN_20261105_X.txt（77,875 B，SHA-256 cea4c8f5…0a76f，改名前后一致）
    - 结果：480 min / 2,880,407 帧 / 100.0141 Hz / 479 打点 / BOOT 0 / 链路中断 0 / 错误全 0；H11 0.0141 %（141 ppm）；与 8B-2 的 0.0039 % 差异由 NTP +2950 ms 抵消解释
    - 更正：+407 原被错标为 ΔSTAT -> ΔSAMPLE 合计 2,868,406（比 478x6000 多 +406），ΔSTAT 多 +4（约 4 s），末值 +407 = 406 + 首区间 1 帧
    - 措辞：'唯一变量' 改为 '主要差异是诊断开关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
2026-11-06 docs(stage8b3): 收口旧口径——§6/§3 改为两态各一次，R3 保持中，R20 改 a/b/c 并补中止记录
    - STAGE8B_REPORT §6 第 2 条：原写'诊断开 8 h 仍未做'，改为指向 §9（2026-11-05 23:10 – 11-06 07:10 完成），并注明本条不再成立
    - TEST_INVENTORY §3 一句话：'仅剩诊断开 8h 待跑' 改为 8B-2(en=0)/8B-3(en=1) 各通过一次，并保留'两轮 1h 丢帧未定位，不能宣称任意工况稳定'
    - R3 等级由'低'回'中'：②③ 的 1h 丢帧未定位，不因 ⑥⑦ 通过而降级；README 对应行补同样限定
    - R20：状态改为'诊断开启 8 h 的缺口已关闭；11:24 FAIL 的归因未定论，保留'；编号由 ①②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
2026-11-06 docs: 脱敏说明不再抄录真实路径；补 8B-3 时间线（重插->起跑->中止->reset->重跑）
    - STAGE8D_EVIDENCE §6.1 替换规则原样抄了本机绝对路径（含用户名），本身就是一处泄露；改为结构描述（盘符/用户名/工具目录/会话目录）+ 44B->14B 与 11 处，不再出现真实串
    - STAGE8B3_START §9.2 增加时间线：23:07:34 USB 插入 -> 23:08:38 diag on -> 23:08:57 首次起跑 -> 23:10:22 中止 -> 23:10:36 reset -> 23:10:46 T0 -> 23:10:56 正式起跑，并说明 ABORTED_2310 只对应 23:08:57 那次
2026-11-06 docs(readme): 首屏加 5 行摘要（是什么/已实测/没测/怎么复跑/证据入口）
    四条边界写在最前面：R2/R19/R1/R17/R15/R16 明确未测；11-04 两轮 1h 丢帧未定位，R3 仍记中，两态各通过一次不等于任意工况稳定
    复跑命令实测可用：python -m unittest discover -s host/tests（72 项 OK）、fw_tests/run_tests.bat、host/main.py、host/tools/soak.py
2026-11-06 docs(readme): 首屏拆分'已实测'为 A 类/真板两类，并交代编译记录来源
    - 原把 72 项单测、1041 C 断言、8h 长跑、8D 混在一句，改为'PC 离机（A 类）'与'真板（B/C 类）'两行
    - 长跑补限定：8B-2(en=0)/8B-3(en=1) 各一次、统计级、输入静置、H1–H12 PASS；8D 改为'GUI 控件自动化 + 人手拧电位器，D-1~D-12 已执行，P-6 仅部分满足'，不再写'跑完'
    - 编译记录交代来源：build_check3.log，2026-11-05 13:16，Code=22468/RO1076/RW148/ZI4972；明确'本轮 11-06 未重编译'；1041 断言标'本轮未重跑，沿用既有记录'
    - 复跑命令核对：仓库内工程文件名确为 MDK-ARM/DataAcq.uvprojx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
2026-11-06 docs(readme): 8D 的判定指向改为 TEST_INVENTORY R21 与 STAGE8D_EVIDENCE
    原文写'见 §9 与 STAGE8D_EVIDENCE'，其中 §9 指 STAGE8B_REPORT §9（即 8B-3），与 D-12 判别力无关，属错误交叉引用
2026-11-06 docs(readme): 正文补 8B-3 与 8D，改 8 位序号盲区表述，首屏'本轮'换具体日期
    - §8 第 1 条：十轮 -> 十二轮，补'诊断开 8 小时（8B-3）'与'GUI 连真板（8D）'
    - 目录树：STAGE8B_REPORT 描述补 §9=8B-3；新增 SOAK_480MIN_RECORD_8B3.md 条目
    - §8 第 4 条：删去'实际不会发生'，改为'恰为 256 整数倍的连续丢失不可见；所有轮次未观察到，但这是检测盲区，不是证明'
    - 首屏：'本轮实跑'/'本轮未重跑'/'本轮 11-06' 全部换成 2026-11-06 具体日期
2026-11-06 docs(stage8d): 标明 5 张截图仅覆盖窗口左半，右侧面板判据一律以日志为准
    - STAGE8D_EVIDENCE §6.3 新增'覆盖范围'段：5 张只含串口行 + 实时曲线，不含诊断面板/统计/事件表（ImageGrab 当初就只抓到那片）；涉及勾选状态、序号缺口栏、事件表行数的结论一律以 GUI 文本通道日志与设备侧 en/conf/mask/rep 为准
    - §3.1 表：D-3/D-6/D-7/D-8 的截图列标注'仅曲线区，复选框/事件表未入镜'；§3.0 时间轴 D-4 一句改为'事件表 4 行以 [table_rows] 为准，截图不含事件表'
    - TEST_INVENTORY R21：'5 张可用 GUI 截图' -> '5 张 GUI 截图（仅覆盖窗口左半，不含右侧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
2026-11-06 docs(stage8a): TX 环满载测试执行完毕——未通过，A-1 判据被实测否定，R15/R16 保持开放
    - 条件达到：427 条 stat/4.5 s 灌包，txd（发送环丢弃字节）0 -> 53,501 B 证明环满载；边沿落在窗口内（由'窗口内 1 条 FAULT' + '09:39:24.430 mask=0 rep=0' 反证）
    - A-1（灌满期间 FAULT=0）实测 = 1 -> FAIL；A-2/A-3/A-4/A-5/A-6 通过；A-7 不可观测不参判；A-8 retry_fail 无调试器 -> OPEN；A-9 SEQ 缺口未统计 -> 未测
    - 根因：环满时每发一帧释放 17 B（约 680 次/s），9 B 的 FAULT 可插入，被丢的是 291 B 的 stat 回复；'命令放大'只压垮大帧，提交失败路径未被逼出，retry 很可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
    [flood_stat.py]
2026-11-06 docs(stage8a): 改标签——方法达不到目的而非固件失败；A-3 记为不适用；8A-2 判定不做
    - 标签统一：R15/README/STAGE8A_REPORT 原写'未通过'，改为'已执行，方法达不到目的（命令放大只压住大帧，压不住 9 B 小帧）；固件在该负载下行为符合预期；R15 目标场景（提交失败后的重试）仍未验证'。不写 PASS，也不写固件 FAIL
    - 依据：STAGE8_PLAN 3.6 的失败判定清单逐条核对无一条触发（恢复帧 1 帧、场景内无重复状态、rep 已前进、2 s 内拉平、drops/uart 全 0）；retry_fail 无读数
    - A-3 由'通过'改为'不适用'（提交发生在灌包窗口内，该判据针对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
2026-11-06 docs(stage8a): 修正时间尺度算式（9 B ≈ 0.78 ms / 17 B ≈ 1.5 ms），首屏 R15 口径对齐
    - 原文'DMA 每排空 17 B 就腾出 9 B，约 0.78 ms 一次'把两个量混在一起：0.78 ms 是腾出 9 B 的时间（9 / 11520 B/s），17 B 一帧排空约 1.5 ms
    - '机制上几乎不可达'改为'机制上很难达到（一次实测 + 推演，非穷举证明）'，不把单次观测说成证明
    - README 首屏'明确没测'里的 R15 对齐为'已尝试（方法达不到目的，目标场景——提交失败后的重试——未验证）'
2026-11-07 docs(r2): 绝对电压精度已测——零点 PASS，满量程 +1.69% FS 归因于 VDDA 3.245 V ≠ 固件 3.300 V
    - 实测（2026-11-07 20:18-20:27，Code=22468，COM5/1-2.1.3，USB 单路）：P0 PA1→GND 表 0.000V / 设备 1.58mV；P1 PA1→3.3V 表 3.245V / 设备 3299.75mV
    - 判定：零点 +1.58mV PASS（含表 +/-2mV 上界 3.58mV）；满量程 +54.75mV(+1.69% FS) 点估计超 1% 门槛；跨度 +53.17mV(+1.64%) 超 0.5% 门槛
    - 归因：固件满码折算写死 3300mV，VDDA 实测 3.245V -> 理论 55.00mV / 实测 54.75mV，差 0.25mV(约 0.3 LSB) => ADC 自身增益误差 <0.3 LSB，偏差全部来自参考电压假设
    - 不确定度：表 +/-(0.8%+2 字) 在 3.245V 处约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
2026-11-07 docs(r2): 补记通断测量未成功的原因与代理口径够用的论证，R2 维持部分关闭
    - 现实情况：LQFP48 脚宽约 0.2 mm，探针无法稳定接触，逐脚通断扫描未取得可靠读数，主动放弃（未勉强）
    - 论证：轻载下 3.3 轨与 VDDA 之间磁珠/走线压降仅几 mV，相对 55 mV 误差与 +/-28 mV 表不确定度小一个量级，故 B 口径对本结论够用
    - 但这是代理口径足够的论证，不是同网络证据 -> 按 R2 的 A/B 约定，仍记部分关闭、不得宣称绝对精度已验证
    - CALIB_RAW 追加第六节还原确认：PA1 接回电位器后 333.03 mV(329-340)，不再是 3300；并记录本次上电噪声 cmd=0/17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
2026-11-07 docs(r2): 归因降一档（算术恒等式，非验证）；百分比统一以 3300 mV 为 FS 分母；补比例测量为未做项；修正 8B-3 待测旧句
    - 归因：PA1 接轨时输入即 VDDA、ADC 必然满码，54.75 = 3300-3245 是恒等式；只能说与参考电压假设一致，表不确定度内无法区分板偏与表偏；撤回'ADC 自身增益误差 < 0.3 LSB'
    - 百分比：54.75/3300 = 1.66 %FS（原写 +1.69% 是以 3245 为分母的相对读数偏差，不叫 FS）；跨度 53.17/3300 = 1.61 %FS；表不确定度 27.96/3300 = 0.85 %FS；区间 +26.79~+82.71 mV = +0.81~+2.51 %FS
    - 口径补强：表型号与量程未记录、精度公式来自口述未核对说明书，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
2026-11-07 docs(r2): 修正比例测量判读规则（比值法抵消表增益误差）；用满量程批次数据约束代理口径
    - 原判读'偏差同向 => 板偏'是错的：板偏与表偏对中点读数影响方向相同，推不出来。改为 P = 3300 x V_PA1 / V_轨，比较 固件 mv - P；同表同量程下表的增益误差在比值里大部分抵消，偏差 <= 几个 LSB 即说明该点比例读数正确，偏差大再查增益/偏置/源阻抗
    - 明确该方法不能分辨'板子 VDDA 真是 3.245 V'与'表读低'（两者只影响绝对量，比值里抵消），要缩小范围需第二只表交叉对读或已知精度基准
    - 器材改为两只 1k~2k 等值电阻，注明不要 10k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
2026-11-07 docs(r2): 比例测量验收线改为合成容差 ±9 mV；标定 5 LSB 界为上界；R2 定稿不再补测
    - 原验收线'≤3 mV'低于表的分辨能力：表数字项(2 字=2 mV)在比值 P=3300×V_PA1/V_轨 里不抵消，最坏 3300×(2/1622+2/3245)=6.1 mV；加 ADC 约 3 mV => 合成 9.1 mV，取 ±9 mV
    - 注明：该法在此表上分辨力约 0.5%（相对 1.6 V 测点），只能发现明显增益问题，证明不了 0.1% 级一致；验收线写在测之前，本次未测也先写死
    - '≤5 LSB（≈4 mV）'保留，补一句：该界来自样本最小值、含 ADC 噪声下尾，是上界不是测出的差值
    - R2 定稿：不再补测（不重采、不给 calib.py 加 --cs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
2026-11-07 docs(r2): 清理 R2 旧口径——6 处现状表述改为新三句，历史报告保留原文
    - TEST_INVENTORY §5.1 的 R2 正说法、§2.1 表的 NOT TESTED 行、TEST_REPORT §16.1 的当前正确说法 -> 换成新三句（零点 PASS / 满量程 1.66 %FS 点估计超门槛且区间跨门槛 / 与参考电压假设一致但未与表偏分离、未做比例测量 => 部分关闭）
    - SOAK_480MIN_RECORD 的 R2 仍未测、STAGE8B_REPORT §9.6 的 R2 仍未测、STAGE8_PLAN R2 行的待万用表 -> 改为已执行/部分关闭并指向 CALIB_ABSOLUTE 6 节
    - 历史记录保留不改：STAGE2_ADC_LINEARITY 两处（含万用表没电）、STAGE7C2_FINAL 的 R2 行、TEST_REPORT 17 节表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
2026-11-07 docs(r2): 回填表单型号 FY106A/4 V 档，精度公式并列两来源并按保守值 (b) 重算
    - 型号与量程：福仪（MASTFUYI）FY106A，读数时 DC 4 V 档、分辨率 1 mV（1 字 = 1 mV）
    - 精度公式两来源并列（原件未核对）：(a) 用户转述 ±(0.8% 读数 + 2 字)；(b) 转载说明书页
    manuals.plus/ae/1005006869152807 ±(1.2% + 3)。该页非原厂，把 FY106A/FY106B 并列同一张
    参数表（两列 DC 电压都写 ±(1.2%+3)），且只给 "1 V~600 V" 一档、无 4 V 档分档精度
    -> "原件未核对，取较大者作保守界"，一律按 (b) 计
    - 重算（FS = 3300 mV）：表不确定度 ±41.9 mV（±1.27 %FS）；
    满量程误差区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
2026-11-07 docs(readme): R2 拆成首屏独立一条；目录树与跨度误差旧表述改正；1.7 % 补点估计限定
    1) 首屏：R2 从"已实测·真板（B/C 类）"那条里拆出，独立成"已实测·真板（R2 绝对电压精度）：
    部分关闭"一条（零点 PASS / 满量程 1.66 %FS 点估计超门槛、区间 +0.39 %~+2.93 %FS 跨门槛 /
    未做比例测量）；"判定依据见 TEST_INVENTORY R21 …D-12 判别力偏弱"归还 8D 那句之后
    2) 目录树 CALIB_ABSOLUTE.md 描述：删掉已撤回的"满量程 +1.69% FS、归因于 VDDA 3.245 V"，
    改为"零点 PASS；满量程 1.66 %FS 点估计超门槛、区间跨门槛；部分关闭"
    3) "跨度误差"口径统一：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
2026-11-07 docs(r2): 告警点改为"点估计 + 区间"统一口径；目录树 §1–§21；1.7 % 限定补到 §21.4 与 §6.3
    1) 告警点口径统一（README §8 与 TEST_INVENTORY R2 行"影响"列）：
    原来 README 给点估计 2360.0/2950.0、R2 行却写"换算到告警点不再给具体 mV"——两处冲突。
    现统一为"点估计 + 区间"：WARN 2400 -> 约 2330~2390 mV（点估计约 2360）；
    CRIT 3000 -> 约 2915~2990 mV（点估计约 2950）；区间按偏高 +0.4 %~+2.9 % 换算、取整到 5 mV，
    并保留"以 3.245 V 为真值"的前提
    2) README 目录树 TEST_REPORT.md 描述：§1–§20 -> §1–§21
    3) TEST_REPORT §21.4：表格补"区间"列，正文补限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
2026-11-07 docs(r2): CALIB_RAW 后注
    §四正文为 2026-11-07 当日原始记录，一个字未改；在节末另起一行追加带日期的后注：
    2360.0 / 2950.0 属点估计、以 3.245 V 为真值，按表保守不确定度 ±1.27 %FS 偏高量区间
    +0.4 %~+2.9 %，对应 WARN 约 2330~2390 mV、CRIT 约 2915~2990 mV，现行口径见 README §8
    与 TEST_INVENTORY R2。避免读者从原始记录入口只看到不带区间的点估计。
    不 push；未打 v1.0（等自动校时开关 + 铭牌公式核对）
2026-11-07 docs(8b): 自动校时已恢复并成功对时一次，§9.6 更新回读证据
    2026-11-07 21:26 回读（用户打开"自动设置时间"→ 管理员 resync 之后）：
    - Parameters\Type = NTP（原 NoSync）；w32time = Running / Manual（原 Stopped / Disabled）
    - 上次成功同步 2026/11/07 21:26:37；Leap 0(无警告)；层次 5；源 time.windows.com,0x9；
    引用 ID 0x34E772B7（52.231.114.183）；peers 由"挂起"转为"运行中 / 模式 3(客户端)"
    - 过程记录：开关打开后 peers 一度"挂起、剩余 ≈16177 s(约 4.5 h)"，即"配置就位但未轮到对时"；
    非管理员 resync 报拒绝访问 0x80070005，管理员执行后才当场完成
    - 诚实边界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
2026-11-07 docs(8b3): SOAK_480MIN_RECORD_8B3 补两条后注（自动校时已恢复、R2 已实测）
    按"记录不改原文、只加带日期的后注"处理 §9 的两条遗留：
    - 第 1 条（自动校时仍未恢复）：后注为已恢复——Type=NTP、w32time Running/Manual、
    2026/11/07 21:26:37 成功对时（Leap 0、层次 5、源 time.windows.com,0x9），指向 STAGE8B_REPORT §9.6
    - 第 2 条（"R2 仍未测"）：后注为已于同日 20:18–20:27 单独实测、记部分关闭，
    指向 CALIB_ABSOLUTE §6 / TEST_REPORT §21；并存"本记录不涉及该项"
    正文一字未改。不 push；未打 v1.0
2026-11-07 docs(r2): 铭牌已核对——只标型号与量程、未印精度公式，去掉"等原件"措辞
    用户 2026-11-07 核对表身铭牌：福仪 FY106A、4 V 量程（分辨率 1 mV），未印 DC 精度公式；
    原说明书暂未找到。因此精度公式仍无原件依据，文档统一改为：
    - CALIB_RAW §五-5：记铭牌核对结果，保留保守值 (b)，不再写"用户正在核对"
    - CALIB_ABSOLUTE §6.3 / §6.4-5：同口径，标题由"仍待原件核对"改为"无原件依据（铭牌已核对）"
    - TEST_INVENTORY R2 现状列、TEST_REPORT §21.5-4、README §7 R2 行：同步"铭牌只标型号与量程、未印公式"
    - 数值一个没动：±41.9 mV（±1.27 %FS）、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
2026-11-07 docs(r2): 精度公式公开检索——4 个转载页、3 种写法互相冲突，保守界仍 ±41.9 mV
    2026-11-07 检索（manuals.plus 系列，全部非原厂），同一 DC 电压档给出三种不同公式：
    - /ae/1005006869152807 -> ±(1.2 % + 3) => 3.245 V 处 ±41.9 mV（±1.27 %FS） <- 最大
    - /ae/1005006996221800 -> ±(1 % + 3) => ±35.5 mV（±1.07 %FS）
    - /ae/3256806170402411 -> ±(1 % + 2) => ±34.5 mV（±1.04 %FS）
    - /asin/B0CRB9XHF3（仅 FY106A 的说明书）-> 未印精度，只写 4000 counts / auto-ranging ≤600 V；
    尺寸重量 108x56x25 mm / 162 g 与前几份（117x56x25 mm / 92 g）不一致 => 同型号有不同版本
    结论不变：取最大值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
2026-11-07 docs(r2): 统一 R2 证据措辞——取值不构成上界、估算与判据分离、范围改为条件估计范围
    来源与取值
    - 精度公式：公开资料 4 个转载页 / 3 种写法且互相冲突（±(1.2%+3)、±(1%+3)、±(1%+2)），另有一份
    单型号说明书未印精度；铭牌只标型号与量程。统一表述为"取已查到的最大值（无原厂来源，不构成上界）"。
    - 数值一律未变：±41.9 mV（±1.27 %FS）、零点折算 4.58 mV、余量 0.42 mV、比例测量判据 ±12 mV、
    满量程 +12.8 ~ +96.7 mV、跨度 +11.3 ~ +95.1 mV。
    措辞统一
    - "保守界 / 保守值 / 保守估计 / 保守不确定度 / 表上界"全部清理为"按公式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
